kgchord/ParkFlow/electronics/ESDS.md

# ParkFlow Demo Lane: Electronic System Design Specification (ESDS), Rev A

Scope: the electronics of one demo lane (Edge Node, Lane Controller PCB, RFID, camera, PoE, barrier drive, field I/O, occupancy nodes, P10 sign, power and protection).
Sources of truth: `kicad/lane_controller.kicad_sch` (generated by `tools/gen_lane_controller_sch.py`), `PINMAP.md` (generated from the same script), `../bom/ParkFlow_BOM.xlsx` (25 Oct 2026), `diagrams/system_block_diagram.png`, `diagrams/power_tree.png`. Where these disagree, see **Section 11 (Inconsistencies found)**.

Conventions. Every number that is not a datasheet or vendor-page fact is a **design target, to be bench-verified**. Facts taken from a datasheet or vendor page carry that page's URL (Section 12). Nothing in this document is a measured result: no bench test has been run.

## 1. Subsystems

| # | Subsystem | Hardware (BOM part numbers) | Role |
|---|---|---|---|
| 1 | Edge Node | Raspberry Pi 5 8 GB + Raspberry Pi AI HAT+ (Hailo-8, 26 TOPS, PCIe Gen3 x1), Active Cooler, 128 GB microSD, Geekworm X1202 UPS (2x 18650), XL4015 24 V to 5.1 V | ANPR, RFID-plate fusion, access list, offline queue |
| 2 | Lane Controller PCB | ESP32-S3-WROOM-1-N16R8, THVD1450DR, IBT-2 (BTS7960) motor-driver module on header J14, TPS54560BDDA, TLV62569DBVR, TPS3823-33DBVR, SN74HCT245PWR, 74AHCT1G08 x3 (U9, U10, U19; drawn with the 74LVC1G08 symbol), 6x EL817S1(C)/PC817-pinout optos (see 11 #2) | Lane FSM, barrier drive, interlocks, RS485 master, sign and LED drive |
| 3 | UHF RFID reader | ID Tech IDT 85 (865-867 MHz) | FASTag EPC read, RS485 to Lane Controller |
| 4 | ANPR camera + PoE | CP Plus CP-UNC-TD21ZL6C, Netgear GS305P | RTSP video to Edge Node |
| 5 | Barrier drive and field I/O | Lucas TVS 24 V 18 N.m wiper motor, 2x limit switch ME-8108, Delta PS-MT5 through-beam pair, ProMax 22 mm E-stop, K1 (Schneider LC1D09BD 24 VDC contactor, in the BOM and schematic) | Boom actuation, end stops, anti-crush, hard stop |
| 6 | Occupancy nodes x4 | ESP32-C3 SuperMini, VL53L1X, WS2812 ring, 5 V adapter each | Bay occupancy |
| 7 | P10 sign | P10 red 320x160 mm HUB12 | Guidance |
| 8 | Power and protection | 2x MCB A9N1P06C, Type 2 SPD, Mean Well LRS-200-24, LRS-100-12, 12 V mini DC UPS, RCCB 30 mA, fuses; separate power box | 230 VAC to all rails |

## 2. Target specification table

All figures in the Target column are **target, to be bench-verified** (T-nnn refer to Section 10).

| Parameter | Target (target, to be bench-verified) | Selected hardware / protocol |
|---|---|---|
| Barrier open time (0 to 90 deg) | <= 3 s (T-05) | Lucas TVS 24 V wiper motor (18 N.m), IBT-2 PWM; wind limit 12 m/s for this motor (D1) |
| Hard motor cut on E-stop | <= 50 ms, independent of firmware (T-02) | E-stop NC in K1 coil loop + ESTOP_OK to INH gate (U9) |
| Anti-crush | CLOSE blocked when beam broken, in hardware (T-03) | Delta PS-MT5 to BEAM_CLEAR to U10 (74LVC1G08) |
| Firmware watchdog | reset if not kicked within 0.9-2.5 s (datasheet, TPS3823) | TPS3823-33DBVR on GPIO14 |
| Lane Controller link to Edge | 921.6 kbaud, 3.3 V UART (T-06) | ESP32-S3 UART0 (GPIO43/44), JST-XH 5P (J11) |
| RFID link | RS485, 115.2 kbaud (T-07) | THVD1450DR, SM712, 3-pin screw terminal (J7) |
| Occupancy link | RS485 Modbus-RTU 19.2 kbaud (T-07) | not implemented in BOM (11 #12) |
| ANPR latency | 60-120 ms per frame (T-08) | Hailo-8 on AI HAT+ |
| Read range | >= 6 m (T-09); vendor claims up to 8 m | IDT 85 |
| Mains loss ride-through, Edge Node | >= 10 min (T-10) | X1202 + 2x 18650 (PoE switch and camera have none: ANPR is lost in an outage, OPEN_DECISIONS D3) |
| Mains loss ride-through, RFID | >= 10 min (T-10) | 12 V mini DC UPS 27.5 Wh |
| 24 V bus peak load | <= 87 % of 8.8 A with the motor limited to 5 A (T-04) | LRS-200-24 |
| Operating ambient | 0 to 50 deg C inside enclosure (T-11); margin not demonstrated by prediction (48.1 to 52.3 deg C with the supply moved out), see 11 #8 | AI HAT+ is rated 0-50 deg C |
| Input protection | reverse polarity and 33 V surge clamp on the logic feed | Q1 FQD11P06, D2 SMBJ33A, F1 3 A |

## 3. Architecture rationale (decision, why, rejected alternative)

1. **RS485 (THVD1450) for the RFID link, not plain UART or CAN.** The reader is on a cable of several metres next to a 24 V motor and contactor; differential signalling with a 3.3 V transceiver (supply 3.3-5 V, TI page) and an SM712 TVS tolerates that, and the reader class (IDT 85) is listed with RS485. Rejected: UART at TTL levels (no common-mode immunity over the cable), CAN (reader does not offer it; no extra benefit for one master and one slave).
2. **ESP32-S3-WROOM-1-N16R8 for the Lane Controller, not STM32.** Native USB-Serial-JTAG (GPIO19/20), 3.0-3.6 V single supply, ESP-IDF, enough GPIO for 6 opto inputs, HUB12, WS2812, RS485 and H-bridge; the BOM part is already priced and the team knows ESP-IDF. Cost: octal PSRAM takes GPIO35-37, and the module is rated -40 to 65 deg C (Espressif datasheet). Rejected: STM32 (better hard real-time and temperature range, but no budgeted part, no PCB library effort in the 4-month plan).
3. **Raspberry Pi 5 + AI HAT+ (Hailo-8) as Edge Node, not Jetson Orin Nano Super.** The HAT+ is in the BOM at 26 TOPS and the Pi is the cheapest path to HailoRT; Jetson stays the documented alternative. Cost: AI HAT+ is 0-50 deg C ambient (Raspberry Pi product brief), which the sealed enclosure does not currently meet. Rejected: Jetson (higher cost and power, not in BOM).
4. **PoE IP camera over RTSP, not a CSI camera.** A 2 MP IR bullet camera is weather-rated (IP67 per BOM listing), runs on 100 m Ethernet, and needs no Pi CSI port or long ribbon; PoE removes a power run. Cost: PoE support of the CP Plus model is "to be confirmed" in the BOM. Rejected: CSI (ribbon length limit about a metre, no IR/weather housing).
5. **Hardware interlocks in front of the H-bridge.** E-stop opens the K1 (LC1D09BD) coil supply (no firmware involved) and ESTOP_OK also gates the driver enable (MOT_INH) through U9; CLOSE is gated by BEAM_CLEAR through U10 and the CLOSE input of the module (MOT_IN_A) passes U19. A firmware hang cannot override either. Rejected: software-only interlocks (the safety case then depends on the firmware).
6. **IBT-2 (BTS7960) module for the barrier motor, not discrete BTN8982TA half-bridges.** One design is used everywhere (schematic, BOM, PCB). The module is rated 5.5-27 V motor supply, which covers the 21.6-28.8 V bus; the BTN8982TA is only specified 8-18 V normal, so it was dropped. The board carries a 1x8 header J14 (RPWM, LPWM, two enable lines tied to MOT_INH, IS_A, IS_B, +5 V, GND); 74AHCT1G08 gates U9, U10, U19 sit in front of it; the 1 k resistors on each IS pin are on the module. Motor power and return go straight to the module screw terminals and do not pass over the Lane Controller PCB. Caveat: IS scale (about 0.1 V/A) is a to-be-bench-calibrated figure. Rejected: BTN8982TA on our PCB (outside its normal voltage range), SMD half-bridges on the board (more copper, no benefit for a 5 A limit).
7. **Separate 24 V and 12 V supplies, PoE on its own adapter.** Isolates the noisy motor bus from the RFID reader and camera. Rejected: single 24 V with DC-DC for 12 V (adds a converter in the sealed box).

## 4. Power budget

Method: `tools/power_model.py` holds every number below; `tools/gen_power_tree.py` draws `diagrams/power_tree.png` from it. All loads are **target, to be bench-verified** except where a vendor page gave the figure (Section 12).

### 4.1 24 V bus (Mean Well LRS-200-24: 24 V, 8.8 A, 211.2 W, hiccup overload; Probots listing, Bengaluru)

| Device | V | Typ A | Peak A | Typ W | Peak W | Margin / note |
|---|---|---|---|---|---|---|
| Barrier motor, Lucas TVS 24 V 18 N.m via K1 + IBT-2 | 24 | 2.00 | 5.00 | 48.0 | 120.0 | ASSUMED: vendor page gives no current; 5 A = firmware limit (set from the IS sense, D7) |
| Lane Controller 24 V logic (F1, TPS54560, 5 V rail incl. P10 and ring) | 24 | 0.29 | 0.83 | 7.1 | 20.0 | 72 % margin to F1 3 A |
| 24 V field (6 opto inputs, sensors, buzzer) via F2 | 24 | 0.10 | 0.30 | 2.4 | 7.2 | 60 % to F2 0.75 A hold |
| K1 coil (LC1D09BD) + E-stop loop | 24 | 0.20 | 0.30 | 4.8 | 7.2 | coil current is an ASSUMPTION (not read from a Schneider sheet) |
| Edge chain: XL4015, X1202, Pi 5 + AI HAT+ | 24 | 0.41 | 1.23 | 9.9 | 29.4 | peak = 20 W load + 5 W UPS charge at 85 % |
| **Bus total** | 24 | **3.01** | **7.66** | **72** | **184** | typ 34 % of 8.8 A; **peak 87 %** (margin 13 %) |

Result: with the motor limited to 5 A the coincident peak is 7.66 A, inside the 8.8 A rating. The hiccup threshold is taken as 110 % of 8.8 A = 9.68 A (the 110 % figure is from the LRS-150 sheet; assumed the same here). The largest motor current that keeps the bus within the rating is 6.14 A, within the 80 % derated rating 4.38 A (others' peak 2.66 A). The earlier design (LRS-150-24, 6.5 A, 6 A motor limit) peaked at 8.66 A, 133 % of the supply (previously quoted as 8.56 A before the K1 coil was updated); that conflict is closed by the larger supply and the 5 A limit. Still open: the stall current of the wiper motor is unknown, and the 5 A limit is a firmware trip only (OPEN_DECISIONS D7). T-04 measures it.

### 4.2 5 V rail (TPS54560BDDA, 5 A, 4.5-60 V in, TI page; 80 % derated limit 4.0 A)

| Device | V | Typ A | Peak A | Typ W | Peak W |
|---|---|---|---|---|---|
| TLV62569 3.3 V buck input (ESP32-S3 0.5 A peak at 3.3 V, optos, THVD1450) | 5 | 0.11 | 0.40 | 0.5 | 2.0 |
| WS2812 12-LED ring (J10), firmware cap 25 % | 5 | 0.15 | 0.18 | 0.8 | 0.9 |
| P10 sign (J13, labelled 5 V / 3 A) | 5 | 1.00 | 3.00 | 5.0 | 15.0 |
| 74HCT245 + misc | 5 | 0.01 | 0.02 | 0.1 | 0.1 |
| **Total** | 5 | **1.27** | **3.60** | 6.4 | 18.0 | 

Margin to 5 A: typ 75 %, peak 28 %; to the 4 A derated limit: peak 10 %. Sizing: the converter is at 72 % of rating at peak; inductor Isat >= 7 A is the schematic value (L1). The TPS54560 uses RT = 200 kohm for about 500 kHz (TI table) and an EN divider (R6/R90) for UVLO; EN is not driven above its 8.4 V absolute maximum (TI) by the 100k/10k divider at 28.8 V (about 2.6 V).
3.3 V rail: ESP32-S3 module supply 3.0-3.6 V and minimum external supply capability 0.5 A (Espressif); TLV62569 2 A (schematic annotation; its datasheet was not opened), load peak 0.55 A, 73 % margin.

### 4.3 12 V bus (Mean Well LRS-100-12: 12 V, 8.5 A, 102 W)

| Device | V | Typ A | Peak A | Typ W | Peak W |
|---|---|---|---|---|---|
| ID Tech IDT 85 (9-12 VDC; current not stated by vendor) | 12 | 0.60 | 1.50 | 7.2 | 18.0 |
| 12 V mini DC UPS charging (27.5 Wh) | 12 | 0.30 | 1.00 | 3.6 | 12.0 |
| **Total** | 12 | **0.90** | **2.50** | 10.8 | 30 |

Peak is 29 % of 8.5 A (margin 71 %).

### 4.4 PoE (Netgear GS305P, own adapter)

Budget 63 W (4 ports, 802.3af/at; max consumption 66.78 W; Netgear page). Camera target <= 15.4 W (802.3af class limit; camera draw not stated in the BOM listing): margin 76 % of the 63 W budget. The switch is rated 0-40 deg C (Netgear page): see 11 #8.

### 4.5 Mains side

LRS-200-24 input power at full load 211.2/0.89 = 237 W (efficiency taken from the earlier LRS-150 sheet figure, assumed equal; the LRS-200 sheet was not opened); LRS-100-12 102/0.85 (efficiency assumed) + GS305P 66.78 W = 187 W. At an assumed power factor of 0.6 (pessimistic, supplies without PFC): 1.72 A and 1.35 A per 6 A MCB, i.e. 3.5x headroom or more. Inrush: the LRS-150 sheet listed cold start 60 A at 230 VAC (the LRS-200 value was not read; assume similar); a 6 A C-curve MCB is expected to trip magnetically somewhere above 5-10 x In (IEC 60898 characteristic, not read on the A9N1P06C page), so one MCB per supply (as the BOM has) is the right grouping; confirm in T-01.

### 4.6 UPS ride-through arithmetic

Edge Node (Geekworm X1202, 2x 18650 per the Probots page): 2 cells x 2.5 Ah x 3.6 V = 18.0 Wh nominal (2.5 Ah is the low end of the BOM's 2500-3000 mAh). Usable = 18.0 x 0.80 (depth of discharge) x 0.85 (boost efficiency) x 0.80 (end-of-life capacity) = **9.8 Wh**. Required for 10 min at the 20 W peak: 20 x 10/60 = **3.3 Wh**. Margin **2.9x** (typical 8 W load: 7x). All derating factors are targets (T-10). Note: BOM_notes says the Geekworm board is described as 4-cell elsewhere; the budget uses 2 cells, the lower-capacity case.
RFID: 12 V mini UPS 27.5 Wh (BOM) x 0.7 = 19.3 Wh usable vs 1.5 A x 12 V x 10/60 = 3.0 Wh: **6.4x** (assumed 0.7 usable factor).
Lane Controller and barrier: **no ride-through exists** in the baseline. The supply holds up for tens of ms only (40 ms was the LRS-150 figure); the TPS3823-33 resets the ESP32 below 2.86-3.00 V (TI). Decision (SAFETY F11): the barrier **fails in place** on mains loss and is released by hand with a pin; the earlier claim of automatic fail-open is withdrawn. An optional 24 V battery buffer is OPEN_DECISIONS D2 (not in the BOM; the firmware AC_OK open-hold applies only if one is fitted). The PoE switch and camera have no UPS (D3), so ANPR stops in an outage while the Pi (X1202) and RFID (12 V mini UPS) ride through.

## 5. Voltage regulation and protection

| Stage | Parts (schematic) | Function |
|---|---|---|
| Mains | 2x MCB A9N1P06C, Type 2 SPD (BOM), RCCB 30 mA (BOM, priced Rs 1,062) | overcurrent, surge, shock protection |
| 24 V logic input | F1 Littelfuse 0451003.MRL 3 A very fast (125 V, 50 A interrupting per Farnell page), Q1 FQD11P06 P-FET reverse-polarity, D1 BZT52C15 gate clamp, D2 SMBJ33A TVS (53.3 V clamp at 11.3 A per DigiKey listing), C1 100 uF 50 V | reverse polarity, surge clamp below TPS54560's 60 V input rating |
| Field supply | F2 Bourns MF-R075 (0.75 A hold, 1.5 A trip, 60 V; RS page) | short-circuit protection of field, E-stop loop and buzzer |
| Motor rail | on the IBT-2 module and the supply; no motor current on the Lane Controller PCB | C16, C17 and D8 were removed with the discrete bridge; add 100 nF across the motor terminals at the bench (T-12) |
| RS485 | D7 SM712 (400 W 8/20 us, IEC 61000-4-2 +-8 kV contact; Semtech page), R25/JP1 termination | line surge/ESD |
| USB | U3 USBLC6-2SC6, 22 ohm series | ESD on D+/D- |
| Inputs | 6 opto inputs, 4.7 k + reverse diode + 10 nF filter | 24 V isolation from GPIO |
| ADC | R29 + D9 BAT54S clamp on the IBT-2 IS sense (IS_A/IS_B from the module to the ADC); 100k/10k divider on 24 V sense | ADC pin protection |
| Supervision | TPS3823-33DBVR: reset threshold 2.93 V typ, watchdog 1.6 s typ (0.9-2.5 s), reset delay 200 ms typ (TI) | brownout and hang recovery |

**E-stop path independent of firmware.** J4: +24V_FIELD -> E-stop NC contacts (external) -> K1 (LC1D09BD) coil -> Q4 (low side, driven by K1_EN). Opening the E-stop interrupts coil current by itself; firmware cannot close it. A second channel: ESTOP_OK (opto U17) feeds the U9 AND gate that drives MOT_INH (both enable pins of the IBT-2), so the bridge is disabled even if K1 contacts weld. The E-stop contacts are rated 1 A DC at 36 V (ProMax page) which is adequate for the contactor coil loop. The coil-loop topology now exists in the BOM (contactor LC1D09BD, Rs 1,226 incl. GST).

### 5.1 Track widths (IPC-2221, 1 oz outer copper, 20 K rise; computed by `power_model.ipc` and checked in `gen_pcb.py`)

| Net class | Design current | IPC-2221 width | Class width in .kicad_pro |
|---|---|---|---|
| Power_24V_Motor | removed: the motor path is off-board (IBT-2 screw terminals). Reference only: 6 A would need 2.33 mm | n/a | n/a |
| Power_24V | 1.7 A | 0.41 mm | 1.0 mm |
| Power_5V | 3.6 A | 1.15 mm | 1.2 mm |
| Power_3V3 | 0.7 A | 0.12 mm | 0.5 mm |
| GND | 2.5 A | 0.70 mm | 0.8 mm plus pours |

## 6. Communication map

| Link | Protocol | Speed | Connector | Cable |
|---|---|---|---|---|
| Edge Node to Lane Controller | UART 3.3 V TTL, MQTT-style framing in firmware | 921.6 kbaud (target) | J11 JST-XH 5P | short shielded 5-core, < 1 m inside enclosure |
| Lane Controller to RFID | RS485 half duplex, THVD1450 | 115.2 kbaud (target) | J7 screw terminal A/B/0V | shielded twisted pair, 120 ohm termination at JP1 on the PCB end |
| Edge Node to camera | Gigabit Ethernet + PoE, RTSP/H.264 | 1 Gbit/s link, 2 MP stream | RJ45 via GS305P | Cat6 |
| Edge Node to switch | Ethernet | 1 Gbit/s | RJ45 | Cat6 |
| Edge Node to cloud | 4G router / LAN, MQTT-TLS, HTTPS | n/a | RJ45 | Cat6 |
| Programming/debug | USB 2.0 full speed (native USB-Serial-JTAG) | 12 Mbit/s | J12 USB-C | USB-C |
| HUB12 sign | 5 V logic through 74HCT245 | clocked by firmware | J9 2x8 IDC | ribbon |
| WS2812 ring | single-wire 5 V | 800 kbit/s class | J10 JST-XH 3P | 3-core |
| Field I/O | 24 V active-high signals into opto (PNP beam, NC limit switches, dry contacts to +24V_FIELD) | static | J5 (8P), J6 (3P: IN_ACOK, IN_BATOK, +24V_FIELD) | 0.75 mm2 |
| Motor driver | 3.3 V PWM and enables via 74AHCT1G08 gates, IS analogue back | PWM | J14 (1x8 header to IBT-2) | short ribbon / dupont in the box |
| Occupancy nodes | none defined in BOM | | | 11 #12 |

Note that UART0 is also the ROM boot log, so the link sees boot text at reset.

## 7. Grounding and EMC notes

- One 0 V reference on the Lane Controller; field inputs are optically isolated, so field-side 24 V return does not share the logic ground path through GPIO.
- PE: mains PE bonds the metal enclosure, DIN rail and SPD; DC 0 V is **not** bonded to PE except at one point at the PSU output (to be chosen at assembly; do not bond at both the LRS-200 and the LRS-100 outputs).
- Motor power and return run from the supply to the IBT-2 module terminals, off the Lane Controller PCB (the old J2/J3 are removed); join the logic ground at a single star point at the 24 V input terminal. Layout: power zone left, logic centre, connectors on the edge, antenna keep-out above the ESP32 module.
- RS485: shield grounded at one end only; stub-free; termination only at the PCB end and at the reader end if the cable is longer than a few metres.
- Motor: 100 nF at the motor terminals and ferrite on the motor cable are recommended additions, not on the current schematic (to be decided at bench: T-12).
- PoE and Ethernet shields terminate at the RJ45, not at the Lane Controller.
- Pi 5 and AI HAT+ switch noise is kept off the 24 V bus by the XL4015's own input capacitors; this is not simulated.

## 8. Rails and pin summary

GPIO assignments, directions, levels, protection and strapping checks are in `PINMAP.md` (generated; do not edit by hand). Strapping pins: GPIO0 has a 10 k pull-up; GPIO3, 45 and 46 are unconnected; GPIO35-37 are unused (octal PSRAM). Espressif's Table 4-1 values are used.

## 9. Design-verification status

| Check | Result |
|---|---|
| KiCad ERC (v7.0.11 eeschema engine) | 0 errors, 0 warnings, see `kicad/ERC_report.txt` |
| Netlist vs intended | 0 mismatches after the 25 Oct regeneration; 449 netlist pins on the board; 0 footprint/pad problems |
| PCB | **placement only, unrouted**. DRC (pcbnew engine): 4 hole-clearance errors on the USB-C library footprint and 225 unconnected pads (unrouted); see `kicad/DRC_report.txt`. Routing, DRC clean-up and final review are still to be done in KiCad. |
| Bench tests | none run |

## 10. Bench test plan (pass criteria are targets; no results exist)

| ID | Test | Method | Pass criterion |
|---|---|---|---|
| T-01 | Mains inrush and MCB | power both PSUs from cold, 20 cold starts | no MCB trip |
| T-02 | E-stop hard cut | run motor, press E-stop, measure motor current with scope; repeat with the ESP32 held in reset | motor current < 0.1 A within 50 ms; also with firmware halted |
| T-03 | Anti-crush | block beam during CLOSE, MCU forcing CLOSE | MOT_IN_B stays low (probe U10 pin 4) |
| T-04 | 24 V bus load | stall the motor against a stop, log bus voltage and PSU behaviour; repeat at the 5 A firmware limit; calibrate IS (about 0.1 V/A) and set oc_threshold_mv | bus stays > 21.6 V, no PSU hiccup, motor current <= 5 A; record stall current (currently unknown) |
| T-05 | Barrier timing | 50 open/close cycles | open <= 3 s, limits hit every cycle |
| T-06 | Edge link | loopback 24 h at 921.6 kbaud | zero framing errors |
| T-07 | RS485 | RFID polling 1 h, noise injected near motor | no CRC errors |
| T-08 | ANPR latency | 1000 frames | median <= 120 ms |
| T-09 | RFID range | tagged vehicle approach | >= 6 m read |
| T-10 | UPS ride-through and mains-pull | pull mains with Edge at 20 W load, measure time to shutdown; same for RFID; with the barrier half-open, confirm it stays in place and the hand-release pin works | >= 10 min each; barrier fails in place |
| T-11 | Enclosure thermal | sealed box, full load, sun, 4 h, log HAT+ and switch temperature | HAT+ < 50 deg C, GS305P < 40 deg C (predicted marginal for the HAT+ and failing for the GS305P) |
| T-12 | Conducted noise | scope 3.3 V and 5 V during motor start | ripple < 100 mV pp on 3.3 V, no resets |
| T-13 | Watchdog | stop kicking WDI | reset within 2.5 s; ESP32 restarts |
| T-14 | Reverse polarity and surge | reverse 24 V; apply surge via bench generator | no damage, F1 intact |

## 11. Inconsistencies found

### Fixed in the source

| # | Finding | Fix |
|---|---|---|
| F1 | The schematic needed `kicad-cli sch erc`, absent in KiCad 7.0.11 (earlier attempt produced no report). The first real ERC run gave 3 errors and 601 warnings | ERC now run through eeschema (`tools/run_erc_gui.sh`); generator fixed (IS_A/IS_B nets, R90-R93, #FLG06 flag, 1.27 mm grid snapping); final ERC 0/0 |
| F2 | Fuse F1 was 3.15 A in the schematic and block diagram; the part 0451003.MRL is 3 A | schematic value and diagram corrected |
| F3 | Block diagram parts not matching the BOM: MCU N8 (now N16R8), TP-Link switch (Netgear GS305P), Chafon reader (ID Tech IDT 85), E3Z-T61 and D4N limit switch (Delta PS-MT5, ME-8108), motor spec, MCB 2P (2x 1P), NVMe (microSD), camera model | diagram text corrected |
| F4 | MSTBA footprints named in the schematic do not exist in the KiCad 7 library | replaced by Phoenix MKDS footprints; every footprint pad is checked against symbol pins |
| F5 | PCB 5 V net class 0.8 mm was below the IPC-2221 width for the 3.6 A peak; motor class design current 10 A did not match the 6 A limit | 5 V class 1.2 mm; motor design current 6 A |
| F7 | 25 Oct design update: one motor-driver design (IBT-2 on J14), K1 = LC1D09BD contactor, LRS-200-24, active-high opto inputs (PNP beam compatible), J2/J3/U7/U8/D8/C16/C17 removed, U19 added | schematic, netlist, PCB placement, power model, diagrams regenerated; ERC 0/0; firmware 53 tests pass |
| F6 | Diagram power boxes (DDR-120B-48, DDR-30G-5, DDR-60G-12, DRS-240-24, battery) were drawn as the real chain | now tagged "design intent, not in BOM" with the BOM equivalent beside them |

### Not fixed (BOM or other owners; decision needed)

Items 2 to 7 of the earlier list (schematic vs BOM, K1, PNP beam, motor driver voltage, 24 V peak) were resolved on 25 Oct; they are listed in F7 above. What remains:

| # | Finding | Impact and suggestion |
|---|---|---|
| 1 | **Two power chains.** Design intent (block diagram: DRS-240-24 UPS, VRLA battery, DDR DIN converters) versus BOM (LRS-200-24, LRS-100-12, XL4015, X1202, 12 V mini UPS). `power_tree.png` draws the BOM chain; the optional battery buffer is a dashed block | Update the design-intent text once D2 is decided |
| 2 | Lane Controller BOM vs schematic: now one design. The BOM carries the IBT-2, contactor and a Rs 2,500 to 5,000 estimate line for schematic-only parts (THVD1450DR, TPS54560, TLV62569, TPS3823, 74AHCT1G08 x3, SN74HCT245, USBLC6, FQD11P06, etc.); MAX3485, XL4015 and AP2112K lines are set to qty 0 | LionCircuits quote needed (D9) |
| 3 | Motor 18 N.m is below the >= 30 N.m specification. Arithmetic: 11.6 N.m needed at 15 m/s (17.8 without the counterweight), so margin 1.56; demo wind limit 12 m/s. Stall current, speed and self-locking are not stated by the vendor | production motor open (D1); raised-boom storm case 93 N.m needs the pin |
| 4 | Residual: IS scale and oc_threshold_mv are placeholders; the over-current trip is firmware-only | D7; bench T-04 |
| 5 | Thermal: GS305P 0-40 deg C, AI HAT+ 0-50 deg C, ESP32-S3-WROOM-1-N16R8 -40 to 65 deg C. Predicted air at 45 deg C ambient: 61.8 sealed, 54.2 with sink, 52.3 (48.1 with radiation) with the supply moved out. The bought box is 300x300x210, CAD is 300x400x180 | marginal; test T-11; D4, D6, D8 |
| 6 | SAFETY F11 is now fail-in-place + hand release; the RCCB (F6) is priced; thermostats (F7) are an estimate line | automatic fail-open needs the D2 buffer |
| 7 | XL4015 5 A buck for the Pi: vendor page recommends 2-3 A without a heat sink; Pi peak target is 4 A | use a 5 A industrial DC-DC or test T-04 |
| 8 | X1202: Probots page says 2 cells, Geekworm describes 4 | budget uses 2 |
| 9 | Occupancy nodes: block diagram and firmware boxes assume RS485 Modbus-RTU; BOM has no transceivers and gives each node a 5 V USB adapter | add four transceivers and a supply, or change to Wi-Fi |
| 10 | P10 sign: schematic feeds it from the Lane Controller 5 V (J13); the BOM has a separate XL4015 for it | either is workable; the 5 V rail has 28 % margin with P10 on it |
| 11 | BOM listings unconfirmed: camera PoE/RTSP/850 nm, reader RS485 and IP65, GS305P PoE port count text conflicting | confirm in writing before purchase |
| 12 | Pole: STEP section is a generic 4891 mm2 (31.7 kg), real Systeal section 1649 mm2 (about 10.7 kg); calculations use 12.96 kg | CAD/FEA owner (D6) |

## 12. Sources actually opened

- Espressif ESP32-S3-WROOM-1 datasheet: https://documentation.espressif.com/esp32-s3-wroom-1_wroom-1u_datasheet_en.pdf
- TI TPS54560B: https://www.ti.com/lit/gpn/TPS54560B and https://www.ti.com/product/TPS54560B
- TI TPS3823: https://www.ti.com/lit/gpn/tps3823
- TI THVD1450: https://www.ti.com/document-viewer/THVD1450/datasheet/overview-x9373 (supply and data rate only; ESD/fault ratings not on the page read)
- Infineon BTN8982TA: https://pdf.direnc.net/upload/infineon-btn8982ta-datasheet.pdf
- Mean Well LRS-150 (superseded by LRS-200-24 in the BOM; sheet values reused where noted): https://www.meanwellaustralia.com.au/sites/default/files/2025-05/MEAN%20WELL%20LRS-150%20DATA%20SHEET.pdf
- Raspberry Pi 27 W PSU: https://pip-assets.raspberrypi.com/categories/898-raspberry-pi-27w-usb-c-power-supply/documents/RP-008245-DS-1-27w-usb-c-power-supply-product-brief.pdf
- AI HAT+ brief: https://cdn.sparkfun.com/assets/c/9/b/7/3/Raspberry_Pi_AI_HAT__product_brief.pdf
- Netgear GS305P: https://www.netgear.com/in/business/wired/switches/unmanaged/gs305p/
- X1202 listing: https://probots.co.in/metal-case-raspberry-pi-5-x1202-ups-board.html
- E-stop: https://probots.co.in/promax-22mm-emergency-stop-switch-mushroom-head-waterproof-metal-2-pole.html
- Limit switch: https://probots.co.in/rotary-adjustable-roller-micro-limit-switch-me-8108.html
- Motor listing: https://www.moglix.com/lucas-tvs-wiper-motor-assembly-24-v-18-nm-for-hindustan-72-71b-front-end-loader-front-screentriv-luc-tsrxs6/mp/msnl5gln362yk4
- Fuse 0451003.MRL: https://jp.farnell.com/en-JP/littelfuse/0451003-mrl/smd-fuse-very-fast-acting-3a-2410/dp/2383276RL
- MF-R075: https://uk.rs-online.com/web/p/resettable-fuses/6478516P
- SMBJ33A listing: https://www.digikey.ch/en/products/detail/littelfuse-inc/SMBJ33A/286006
- SM712: https://www.semtech.com/products/circuit-protection/rs485/sm712

Not opened (no datasheet claims made): TLV62569, FQD11P06, SMCJ28A, 74LVC1G08, SN74HCT245, Schneider A9N1P06C, Delta PS-MT5, ID Tech IDT 85, CP Plus camera, Enerva UPS, Mean Well LRS-100-12 and DRS-240-24, XL4015, P10 module.
