kgchord/ParkFlow/electronics/PINMAP.md

# ESP32-S3-WROOM-1-N16R8 pin map (Lane Controller PCB, Rev A)

GENERATED by `electronics/tools/gen_lane_controller_sch.py` from the same `esp` dictionary that places the nets in `lane_controller.kicad_sch`; do not edit by hand.
Strapping / reserved-pin facts: Espressif ESP32-S3-WROOM-1 datasheet, Table 4-1 and Table 3-1 note b, https://documentation.espressif.com/esp32-s3-wroom-1_wroom-1u_datasheet_en.pdf (opened for this document).
All GPIO are 3.3 V logic. Every figure for timing/current is a design target, to be bench-verified.

| GPIO | Module pin | Net | Function | Direction (MCU) | Level | Protection / state at reset | Other parts on net (auto from netlist) | Strapping-pin check |
|---|---|---|---|---|---|---|---|---|
| GPIO0 | 27 | GPIO0_BOOT | BOOT select (strapping) | in at reset | 3.3 V, LOW at reset = download mode | R16 10k pull-up + SW1 BOOT + Q3 (Pi auto-flash) | Q3.3(2N7002), R16.2(10k), SW1.1(BOOT) | STRAPPING (Table 4-1: weak pull-up, default 1). External 10k pull-up R16 keeps it HIGH = SPI boot; SW1/Q3 pull it LOW only on purpose. OK. |
| GPIO1 | 39 | MOT_ISENSE | H-bridge current sense (IBT-2 module R_IS / L_IS outputs, 1k on the module) | in (ADC1) | 0 to 3.3 V analog | R29 1k series + D9 BAT54S clamp to 3V3/GND + C18 10nF; module IS pins (J14.5/J14.6) joined through R91/R92 100R; R28 is DNP because the module already has 1k to GND on each IS pin. Scale about 0.1 V/A (kILIS ~8.5 mA/A typ, to be bench-calibrated) | C18.1(10nF), D9.3(BAT54S), R29.2(1k) | not a strapping pin |
| GPIO2 | 38 | BAT_OK | Battery/UPS OK, opto-isolated 24 V input (J6.2) | in | 3.3 V, HIGH = OK | PC817 U16 opto + R61 10k pull-down + C35 10nF filter; 24 V side has 1N4148W reverse diode | C35.1(10nF), R61.1(10k), U16.3(EL817S1(C)) | not a strapping pin |
| GPIO3 | 15 | NC | unused (no-connect flag) | - | - | left floating | - | STRAPPING (Table 4-1: floating, JTAG source select). Left unconnected on purpose; do not drive. OK. |
| GPIO4 | 4 | V24_SENSE | 24 V bus monitor (100k/10k divider) | in (ADC1) | 0 to 2.5 V for 27.6 V in | R2 100k + R3 10k + C2 100nF; no clamp, R2 limits injected current | C2.1(100nF), R2.2(100k), R3.1(10k) | not a strapping pin |
| GPIO5 | 5 | MOT_IN_A | H-bridge OPEN request (to RPWM through U19, gated by ESTOP_OK) | out | 3.3 V CMOS | R32 100k pull-down: request LOW at reset; U19 74AHCT1G08 level-shifts to 5 V and ANDs ESTOP_OK | R32.1(100k), U19.1(74AHCT1G08) | not a strapping pin |
| GPIO6 | 6 | MOT_IN_B_MCU | H-bridge CLOSE request (to LPWM through U10, gated by beam) | out | 3.3 V CMOS | R31 100k pull-down; U10 74AHCT1G08 forces LPWM LOW unless BEAM_CLEAR=1 and level-shifts to 5 V | R31.1(100k), U10.1(74AHCT1G08) | not a strapping pin |
| GPIO7 | 7 | MOT_EN_MCU | Motor enable request (gated by E-stop sense into R_EN/L_EN) | out | 3.3 V CMOS | R30 100k pull-down; U9 74AHCT1G08 AND-gate with ESTOP_OK drives IBT-2 R_EN and L_EN (J14.3/J14.4) at 5 V | R30.1(100k), U9.1(74AHCT1G08) | not a strapping pin |
| GPIO8 | 12 | ESTOP_OK | E-stop loop healthy sense (also hard-wired into U9) | in | 3.3 V, HIGH = loop closed | PC817 U17 + R82 4.7k + R83 10k pull-down + C36 10nF; broken loop reads LOW | C36.1(10nF), R83.1(10k), U17.3(EL817S1(C)), U19.2(74AHCT1G08), U9.2(74AHCT1G08) | not a strapping pin |
| GPIO9 | 17 | LIM_UP_OK | Limit switch UP (J5.3), NC wiring | in | 3.3 V, HIGH = switch closed (not at limit) | PC817 U11 + R40 4.7k + D10 reverse diode + R41 10k + C30 10nF | C30.1(10nF), R41.1(10k), U11.3(EL817S1(C)) | not a strapping pin |
| GPIO10 | 18 | LIM_DN_OK | Limit switch DOWN (J5.4), NC wiring | in | 3.3 V, HIGH = switch closed (not at limit) | PC817 U12 + R44 4.7k + D11 + R45 10k + C31 10nF | C31.1(10nF), R45.1(10k), U12.3(EL817S1(C)) | not a strapping pin |
| GPIO11 | 19 | BEAM_CLEAR | Photo-beam clear (J5.5, PNP light-ON receiver drives 24 V when clear); also gates CLOSE in hardware | in | 3.3 V, HIGH = beam clear | PC817 U13 + R48 4.7k + D12 + R49 10k + C32 10nF; same net feeds U10 pin 2 | C32.1(10nF), R49.1(10k), U10.2(74AHCT1G08), U13.3(EL817S1(C)) | not a strapping pin |
| GPIO12 | 20 | PRESENCE | Presence/vehicle-under-boom sensor (J5.6) | in | 3.3 V, HIGH = sensor output active | PC817 U14 + R52 4.7k + D13 + R53 10k + C33 10nF | C33.1(10nF), R53.1(10k), U14.3(EL817S1(C)) | not a strapping pin |
| GPIO13 | 21 | AC_OK | Mains OK from PSU/UPS dry contact (J6.1) | in | 3.3 V, HIGH = mains OK | PC817 U15 + R56 4.7k + D14 + R57 10k + C34 10nF | C34.1(10nF), R57.1(10k), U15.3(EL817S1(C)) | not a strapping pin |
| GPIO14 | 22 | WDT_WDI | Watchdog kick to TPS3823-33 (toggle faster than 0.9 s) | out | 3.3 V CMOS | High-Z at reset: TPS3823 generates its own pulses so it does not reset during boot | U5.4(TPS3823-33DBVR) | not a strapping pin |
| GPIO15 | 8 | RS485_DI | RS485 TX data to THVD1450 DI (UART1 TX) | out | 3.3 V CMOS | Direct 3.3 V logic to U6 (bus side protected by SM712 D7, termination R25/JP1) | U6.4(THVD1450DR) | not a strapping pin |
| GPIO16 | 9 | RS485_RO | RS485 RX data from THVD1450 RO (UART1 RX) | in | 3.3 V CMOS | Direct, driven by transceiver at 3.3 V | U6.1(THVD1450DR) | not a strapping pin |
| GPIO17 | 10 | RS485_DE | RS485 driver enable, DE and /RE tied together | out | 3.3 V CMOS, HIGH = transmit | R22 10k pull-down: receive mode at reset | R22.1(10k), U6.2(THVD1450DR), U6.3(THVD1450DR) | not a strapping pin |
| GPIO18 | 11 | BUZ_CTRL | Buzzer driver (24 V piezo, low-side MOSFET Q5) | out | 3.3 V CMOS | R77 100R series + R78 100k pull-down on gate: buzzer off at reset; D17 flyback | R77.1(100R) | not a strapping pin |
| GPIO19 | 13 | GPIO19_USB_DN | USB D- (native USB-Serial-JTAG) to J12 | bidir | USB 3.3 V differential | R14 22R series + USBLC6-2SC6 U3 at the connector | R14.2(22R) | not a strapping pin |
| GPIO20 | 14 | GPIO20_USB_DP | USB D+ (native USB-Serial-JTAG) to J12 | bidir | USB 3.3 V differential | R13 22R series + USBLC6-2SC6 U3 at the connector | R13.2(22R) | not a strapping pin |
| GPIO21 | 23 | WS2812_3V3 | Status RGB ring data (via 74HCT245 U18 to 5 V) | out | 3.3 V CMOS into 74HCT245 input (TTL-compatible threshold; verify VIH against the datasheet) | U18 level shifter, R76 330R series at the ring, C21 bulk on ring supply | U18.8(SN74HCT245PWR) | not a strapping pin |
| GPIO35 | 28 | NC | unused (no-connect flag) | - | - | left floating | - | NOT USED: reserved for octal PSRAM on the N16R8 module (Table 3-1 note b) |
| GPIO36 | 29 | NC | unused (no-connect flag) | - | - | left floating | - | NOT USED: reserved for octal PSRAM on the N16R8 module (Table 3-1 note b) |
| GPIO37 | 30 | NC | unused (no-connect flag) | - | - | left floating | - | NOT USED: reserved for octal PSRAM on the N16R8 module (Table 3-1 note b) |
| GPIO38 | 31 | HUB_A_3V3 | HUB12 row-select A (to J9 via U18) | out | 3.3 V CMOS into HCT | U18 buffer + R70 33R series | U18.2(SN74HCT245PWR) | not a strapping pin |
| GPIO39 | 32 | HUB_B_3V3 | HUB12 row-select B (to J9 via U18) | out | 3.3 V CMOS into HCT | U18 buffer + R71 33R series | U18.3(SN74HCT245PWR) | not a strapping pin |
| GPIO40 | 33 | HUB_CLK_3V3 | HUB12 shift clock (to J9 via U18) | out | 3.3 V CMOS into HCT | U18 buffer + R72 33R series | U18.4(SN74HCT245PWR) | not a strapping pin |
| GPIO41 | 34 | HUB_LAT_3V3 | HUB12 latch (to J9 via U18) | out | 3.3 V CMOS into HCT | U18 buffer + R73 33R series | U18.5(SN74HCT245PWR) | not a strapping pin |
| GPIO42 | 35 | HUB_OE_3V3 | HUB12 output enable, HIGH = sign dark (to J9 via U18) | out | 3.3 V CMOS into HCT | R64 10k pull-up: sign dark at reset | R64.1(10k), U18.6(SN74HCT245PWR) | not a strapping pin |
| GPIO43 | 37 | EDGE_TX | Link to Edge Node, UART0 TX (GPIO43) | out | 3.3 V TTL | R17 100R series to J11.2 | R17.1(100R) | not a strapping pin |
| GPIO44 | 36 | EDGE_RX | Link from Edge Node, UART0 RX (GPIO44) | in | 3.3 V TTL | R18 100R series to J11.3 | R18.1(100R) | not a strapping pin |
| GPIO45 | 26 | NC | unused (no-connect flag) | - | - | left floating | - | STRAPPING (Table 4-1: weak pull-down, default 0). Left unconnected so the module keeps its factory setting. OK. |
| GPIO46 | 16 | NC | unused (no-connect flag) | - | - | left floating | - | STRAPPING (Table 4-1: weak pull-down, default 0). Left unconnected. OK. |
| GPIO47 | 24 | HUB_R_3V3 | HUB12 red data (to J9 via U18) | out | 3.3 V CMOS into HCT | U18 buffer + R75 33R series | U18.7(SN74HCT245PWR) | not a strapping pin |
| GPIO48 | 25 | K1_EN | Motor-power relay/contactor K1 coil enable (Q4 low side) | out | 3.3 V CMOS, HIGH = K1 on | R80 100R series + R81 100k pull-down on Q4 gate: K1 off at reset; E-stop breaks the coil supply regardless | R80.1(100R) | not a strapping pin |
| EN | 3 | ESP_EN | Chip enable / reset | in | 3.3 V, LOW = reset | R15 10k pull-up + C14 1uF + SW2 RESET + Q2 (Pi) + D5 (watchdog) | C14.1(1uF), D5.2(BAT54W), Q2.3(2N7002), R15.2(10k), SW2.1(RESET) | dedicated EN pin |

## Strapping summary

| Pin | Level seen by the chip at reset | Result |
|---|---|---|
| GPIO0 | 10 k pull-up (R16), SW1/Q3 open | HIGH: normal SPI boot; holding BOOT or Pi Q3 gives download mode |
| GPIO3 | floating (NC) | datasheet: floating default, no internal pull; unused, no action |
| GPIO45 | NC (weak pull-down) | datasheet default 0; unconnected so the module keeps its factory VDD_SPI setting |
| GPIO46 | NC (weak pull-down) | default |

## Not available / not used

- GPIO35, GPIO36, GPIO37: connected to the octal PSRAM on the BOM module N16R8 (datasheet Table 3-1 note b); left as no-connect.
- GPIO19/20 carry native USB (J12); GPIO43/44 are UART0 to the Edge Node, so the ROM boot log also appears on that link at reset.
