kgchord/ParkFlow/electronics/kicad/ERC_report.txt

ParkFlow Lane Controller - ERC report (KiCad 7.0.11 eeschema ERC engine)
=======================================================================
Schematic : electronics/kicad/lane_controller.kicad_sch (generated by tools/gen_lane_controller_sch.py)
Command   : electronics/tools/run_erc_gui.sh   (see below for why it is not `kicad-cli sch erc`)

Why the earlier attempt produced no report
  The installed KiCad is 7.0.11. Its `kicad-cli sch` has only the `export` subcommand;
  `kicad-cli sch erc` was added in KiCad 8, so the command just prints usage and writes nothing.
  The same ERC engine is available in the eeschema GUI, so run_erc_gui.sh drives eeschema under
  Xvfb/xdotool (Inspect > ERC > Run > show all severities > Save report). The pipeline was checked
  with a negative control (a deliberately broken schematic produced errors), so "0" is not an empty-run artefact.

What was fixed in the generator (first real run: 3 errors, 601 warnings)
  - 3 errors: genuine generator problems (see tools/gen_lane_controller_sch.py: PWR_FLAG #FLG06,
    separate IS_A / IS_B current-sense nets, sense resistors R90-R93).
  - ~590 warnings were endpoint_off_grid (symbol origins not on the 1.27 mm grid); fixed by snapping origins in schlib.py.
  - the rest were library-table / footprint-link items; fixed by writing sym-lib-table and the project symbol library.

FINAL RESULT (re-run 25 Oct 2026 on the schematic after the design update: IBT-2 module header J14,
  74AHCT1G08 interlock gates U9/U10/U19, active-high opto inputs, same run_erc_gui.sh)
  ** ERC messages: 0  Errors 0  Warnings 0

Caveats
  - ERC checks electrical-rule consistency only, not that the design is right. Checks that KiCad ignores by default
    (e.g. some pin-type matrix cells set to "no check") were left at their defaults.
  - Footprint/pad-number agreement was checked separately by the generator (check_footprints(), 0 problems);
    KiCad 7 ERC does not do that.

----- raw KiCad output -----
ERC report (Sun Oct 25 05:21:44 2026, Encoding UTF8)

***** Sheet /

 ** ERC messages: 0  Errors 0  Warnings 0
