kgchord/ParkFlow/docs/REFERENCES.md

# ParkFlow Stage 2: Consolidated References

All sources accessed 24 Oct 2026. S2 to S7, S9 to S16, D1, H1 to H3 and about 40 BOM vendor pages were re-checked on 25 Oct 2026. S1 (IS 875-3) and S8 (IS 732) are still confirmed from secondary summaries only. The tags [Sx], [Dx] and [Hx] are the ones used in `safety/SAFETY.md`, `RISKS.md` and `PROBLEM_AND_JOURNEY.md`.

## Standards and regulations

| Tag | Reference | URL |
|---|---|---|
| S1 | BIS, **IS 875 (Part 3):2015**, Design loads (other than earthquake) for buildings and structures, Part 3: Wind loads. Basic wind speeds by city (Delhi 47, Mumbai 44, Chennai 50, Bengaluru 33 m/s) taken from a secondary summary of Fig. 1 (both URLs are the same site; the handbook page lists Delhi 47 Zone IV, Mumbai 44 Zone IV, Chennai 50 Zone V, Bengaluru 33 Zone I, 50-year return period, 10 m, terrain category 2). BIS record not retrieved | https://infralens.in/code/IS-875-Part-3-2015 ; https://infralens.in/handbook/wind-speed |
| S2 | CEN, **EN 12453:2017+A1:2021**, Industrial, commercial and garage doors and gates: Safety in use of power operated doors: Requirements and test methods (BS edition published 31 May 2022; scope covers barriers within reach of persons) | https://knowledge.bsigroup.com/products/industrial-commercial-and-garage-doors-and-gates-safety-in-use-of-power-operated-doors-requirements-and-test-methods-1 ; https://certifico.com/normazione/358-news-normazione/15417-en-12453-2017-a1-2021 |
| S3 | IEC, **IEC 60529:1989+AMD1:1999+AMD2:2013 CSV** (Ed. 2.2), Degrees of protection provided by enclosures (IP Code) | https://webstore.iec.ch/en/publication/2452 |
| S4 | CEN, **EN 12978:2024**, Industrial, commercial and garage doors and gates and pedestrian doorsets: Protective devices for power operated doors and gates: Requirements and test methods (replaces EN 12978:2003+A1:2009; the old edition's withdrawal is dated 10 Jun 2025 on the Albanian DPS listing; the EVS page shows 'valid from 31.12.2024' and excludes ultrasonic, radar, capacitive, inductive, passive-infrared and vision-based sensors from scope) | https://evs.ee/en/evs-en-12978-2024 ; https://dps.gov.al/en/project/show/dps:proj:23486 |
| S5 | IEC, **IEC 62368-1:2023** (Ed. 4.0, 2023-05-26), Audio/video, information and communication technology equipment, Part 1: Safety requirements | https://webstore.iec.ch/publication/69308 |
| S6 | IEC, **IEC 61000-6-2:2016** (Ed. 3.0), EMC: Generic standards: Immunity for industrial environments; **IEC 61000-6-4:2018** (Ed. 3.0), EMC: Generic standards: Emission standard for industrial environments | https://webstore.iec.ch/publication/25630 ; https://webstore.ansi.org/standards/iec/iec61000ed2018-1673899 |
| S7 | BIS, **IS 3043:2018**, Code of practice for earthing (Second Revision) | https://services.bis.gov.in/php/BIS_2.0/bisconnect/knowyourstandards/Indian_standards/isdetails/OTYxOQ== |
| S8 | BIS, **IS 732:2019**, Code of practice for electrical wiring installations. *Edition from secondary sources; BIS record not retrieved* | https://www.studiomatrx.org/guides/electrical-standards-codes-india ; https://infralens.in/code/IS-732 |
| S9 | MoC (WPC Wing), **G.S.R. 853(E), 10 Dec 2021**: Use of Low Power Equipment in the Frequency Band 865–868 MHz for Short Range Devices (Exemption from Licence) Rules, 2021. RFID: 2 W e.r.p., 4 channels at 865.7 / 866.3 / 866.9 / 867.5 MHz, ≤200 kHz, ≤4 s continuous, ≥100 ms gap | https://www.thc.nic.in/Central%20Governmental%20Rules/use%20of%20low%20power%20Equipment%20in%20the%20frequency%20band%20865%20to%20868%20MHz%20for%20Short%20Range%2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,2021.pdf |
| S10 | DoT (WPC Wing), Clarification on ETA under **G.S.R. 564(E), 30 Jul 2008** (865–867 MHz; 1 W transmitter power, 4 W ERP, 200 kHz), letter No. R-11018/01/2017-PP dated **4 Jul 2018** (as read from the PDF on 25 Oct 2026; an earlier version of this table said 27 Mar 2019); DoT index of delicensing gazette notifications | https://dot.gov.in/sites/default/files/Clarification%20ETA%20865-867%20MHz.pdf ; https://dotws.cdot.in/sites/default/files/Gazette_Notifications.pdf |
| S11 | ISO/IEC, **ISO/IEC 18000-63:2021**, Parameters for air interface communications at 860 MHz to 960 MHz Type C | https://www.iso.org/standard/78309.html ; https://webstore.iec.ch/publication/72310 |
| S12 | GS1, **EPC UHF Gen2 Air Interface Protocol**, Release 3.0.1 (ratified Feb 2026) | https://ref.gs1.org/standards/gen2 |
| S13 | IHMCL, *For FASTag Users*: the electronic toll collection programme's RFID "conforming to EPC Gen-2, ISO 18000-6C standards" (the sentence does not name FASTag); IHMCL Phase-1 SOP (tag to comply with MoRTH specs; TID/EPC data fields) | https://ihmcl.co.in/fastag-user-old/ ; https://ihmcl.co.in/wp-content/uploads/2017/11/PHASE-1-DG-SOP.pdf |
| S14 | NPCI, **NETC FASTag**: Product overview (issuer/acquirer roles, NETC Mapper, switch) | https://npci.org.in/what-we-do/netc-fastag/product-overview |
| S15 | **Digital Personal Data Protection Act, 2023** (enacted Aug 2023) | https://www.meity.gov.in/data-protection-framework ; https://ca.hoganlovells.com/en/publications/indias-digital-personal-data-protection-act-2023-brought-into-force- |
| S16 | MeitY, **Digital Personal Data Protection Rules, 2025**, G.S.R. 846(E), notified 13 Nov 2025 (a PIB page dates the press release 14 Nov 2025): phased commencement; r.6 safeguards; r.7 breach intimation (72 h detailed report) | https://teamleaseregtech.com/updates/article/49356/digital-personal-data-protection-rules-2025/ ; https://www.mondaq.com/india/data-protection/1708164/digital-personal-data-protection-rules-2025-notified ; https://static.pib.gov.in/WriteReadData/specificdocs/documents/2025/nov/doc20251117695301.pdf |

## Data sources (problem context)

| Tag | Reference | URL |
|---|---|---|
| D1 | Times Drive (30 Jan 2026), MoRTH: over 98 % of NH user fees collected via FASTag; 11.86 crore FASTags issued as of Dec 2025 | https://www.timesdrive.in/news/fastag-accounts-for-over-98-percent-of-toll-collection-on-national-highways-morth-article-153531512/amp |
| D2 | ParkFlow Stage 1 submission: baselines (45 to 90 s/vehicle, 40 to 60 veh/h, 8 to 12 min friction), targets, competitor disclosure (§7.1), journey (§8). Stage 1 cites NHAI/NETC statements, IMARC India Smart Parking Systems Market 2025 and MarketsandMarkets India Parking Management Market 2025 | `docs/ParkFlow_Stage1.pdf` |

## Hardware datasheets / vendor documentation

| Tag | Reference | URL |
|---|---|---|
| H1 | Raspberry Pi Ltd, *Heating and cooling Raspberry Pi 5*: throttling at 80 °C, more at 85 °C; Active Cooler fan thresholds | https://www.raspberrypi.com/news/heating-and-cooling-raspberry-pi-5/ |
| H2 | Raspberry Pi AI HAT+ product brief: 13/26 TOPS (Hailo-8L/Hailo-8), PCIe Gen 3, **0 to 50 °C** operating ambient | https://cdn.sparkfun.com/assets/c/9/b/7/3/Raspberry_Pi_AI_HAT__product_brief.pdf |
| H3 | RFID Journal reader Q&A (about four years old): UHF readers for multi-lane free-flow; mentions ISO 18000-6C passive tags and India 865 to 867 MHz. A discussion thread, not a compliance source | https://www.rfidjournal.com/question/can-uhf-rfid-readers-be-used-for-multi-lane-free-flow-and-open-road-tolling |

## Not verified (excluded from claims)
- EN 12453 numeric force limits (paywalled): not quoted.
- A public NPCI/IHMCL FASTag *technical* tag/reader specification: not found; only IHMCL's conformance statement (S13) is cited.
- IS 732:2019 on the BIS portal: edition taken from secondary sources (S8).
- Basic wind speed for Sonipat/Haryana: Delhi value (47 m/s) used, to be confirmed against IS 875-3 Fig. 1.
- Vendor listing claims (IP ratings, RS485, PoE, 850 nm IR, self-locking) for the RFID reader, camera, P10 module and wiper motor: see the Notes column of `bom/ParkFlow_BOM.xlsx`; several are not stated on the listings.
- Stage 1 competitor funding figures (Park+ "over 50 million US dollars"; Get My Parking pilots in Jaipur and Navi Mumbai): not re-verified. Public reports found on 25 Oct 2026 show separate Park+ rounds of about 11, 17 and 25 million US dollars and a 140 crore rupee Series C, but a total was not checked. These figures are not repeated in the Stage 2 documents.
- Park+ and other competitor claims in `PROBLEM_AND_JOURNEY.md` come from Stage 1 only.
