kgchord/ParkFlow/cad/fea/figures/convergence_A_pole_base.png

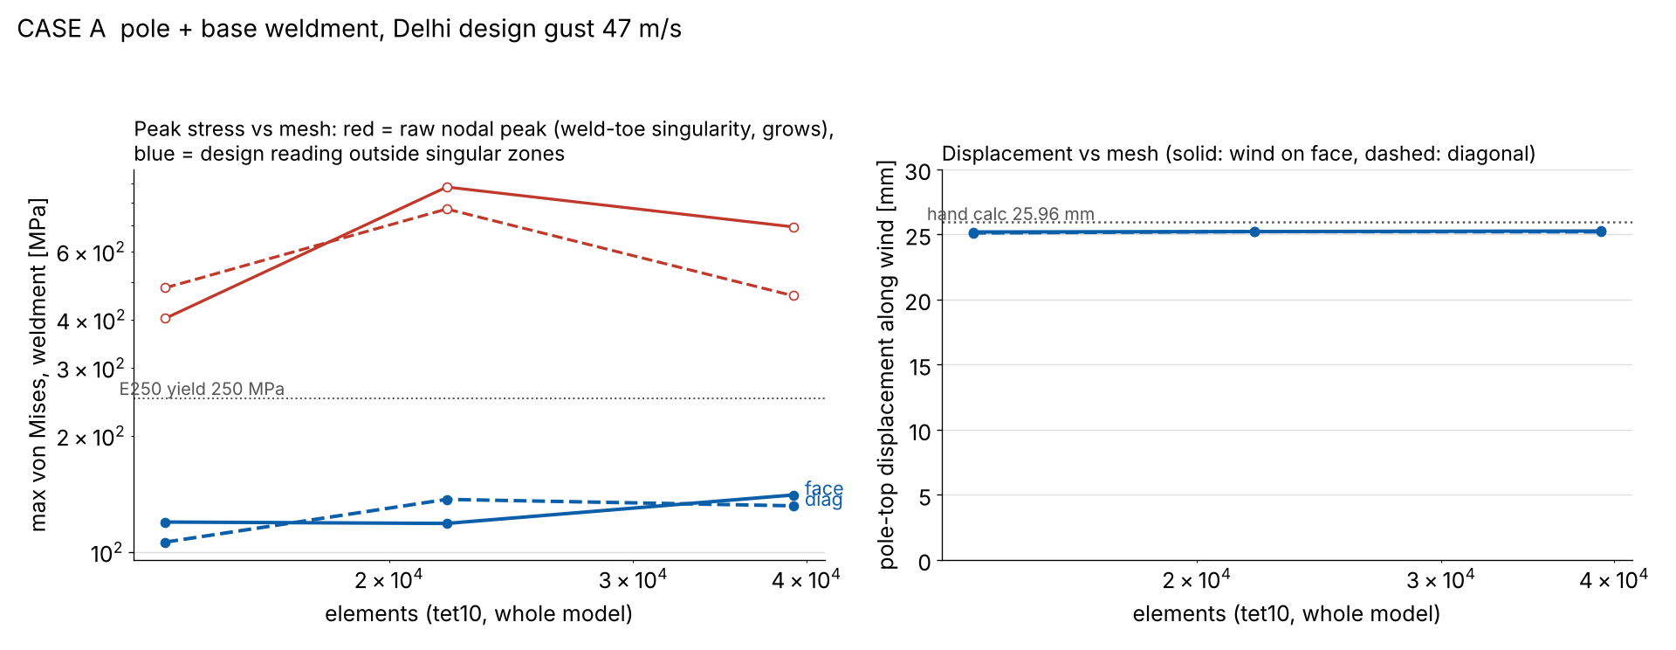
cad/fea/figures/convergence_A_pole_base.png
