kgchord/ParkFlow/cad/fea/figures/convergence_B_bracket_arm.png

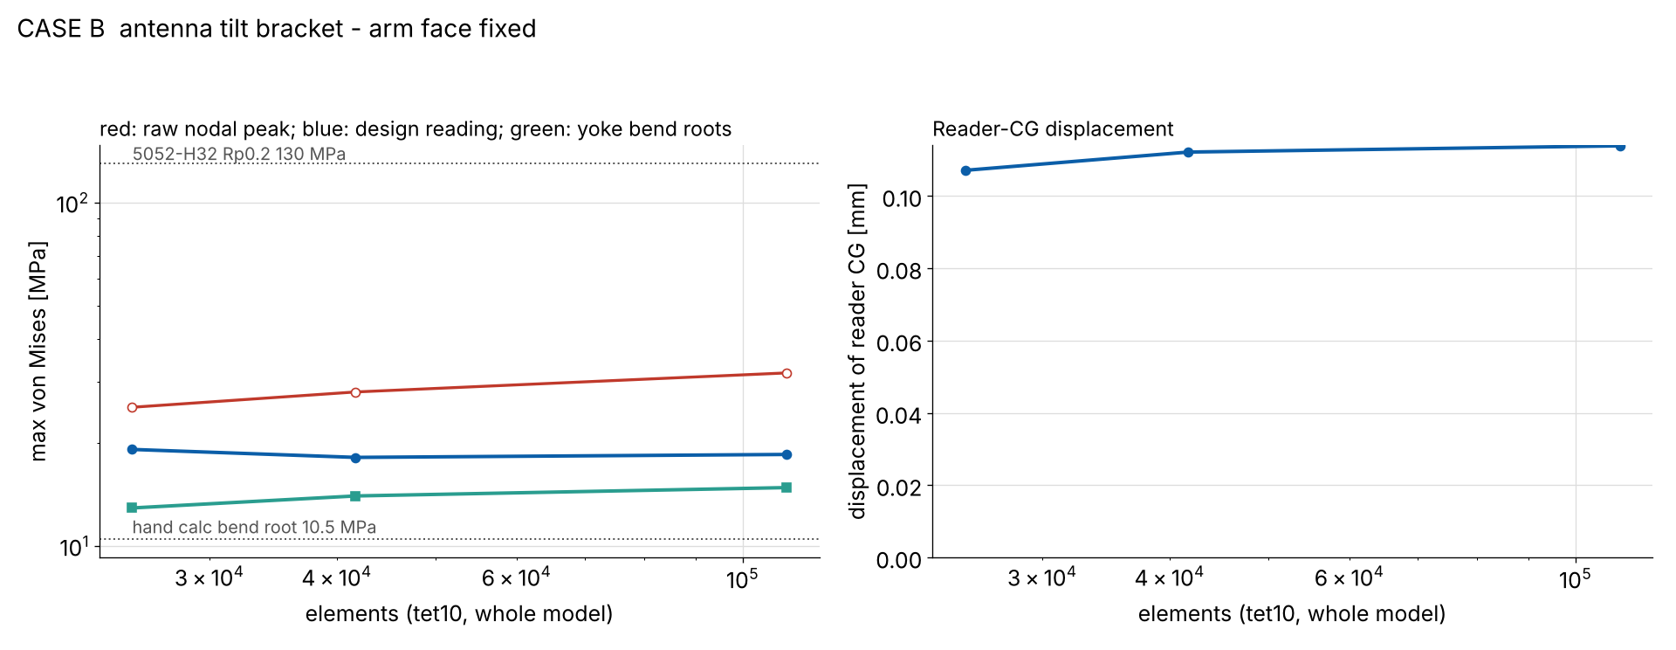
cad/fea/figures/convergence_B_bracket_arm.png
