kgchord/ParkFlow/cad/fea/figures/convergence_B_bracket_contact.png

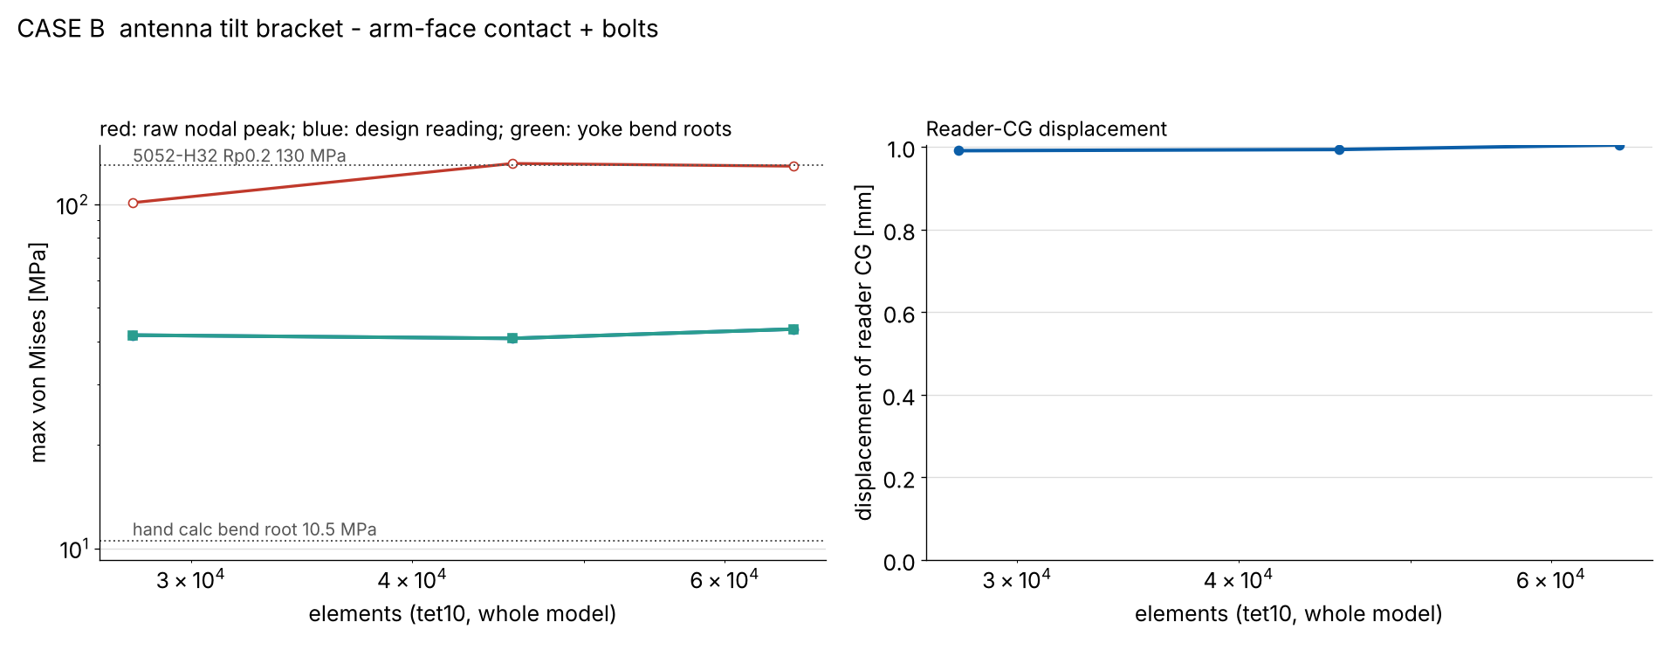
cad/fea/figures/convergence_B_bracket_contact.png
