kgchord/ParkFlow/cad/fea/figures/convergence_B_bracket_washer.png

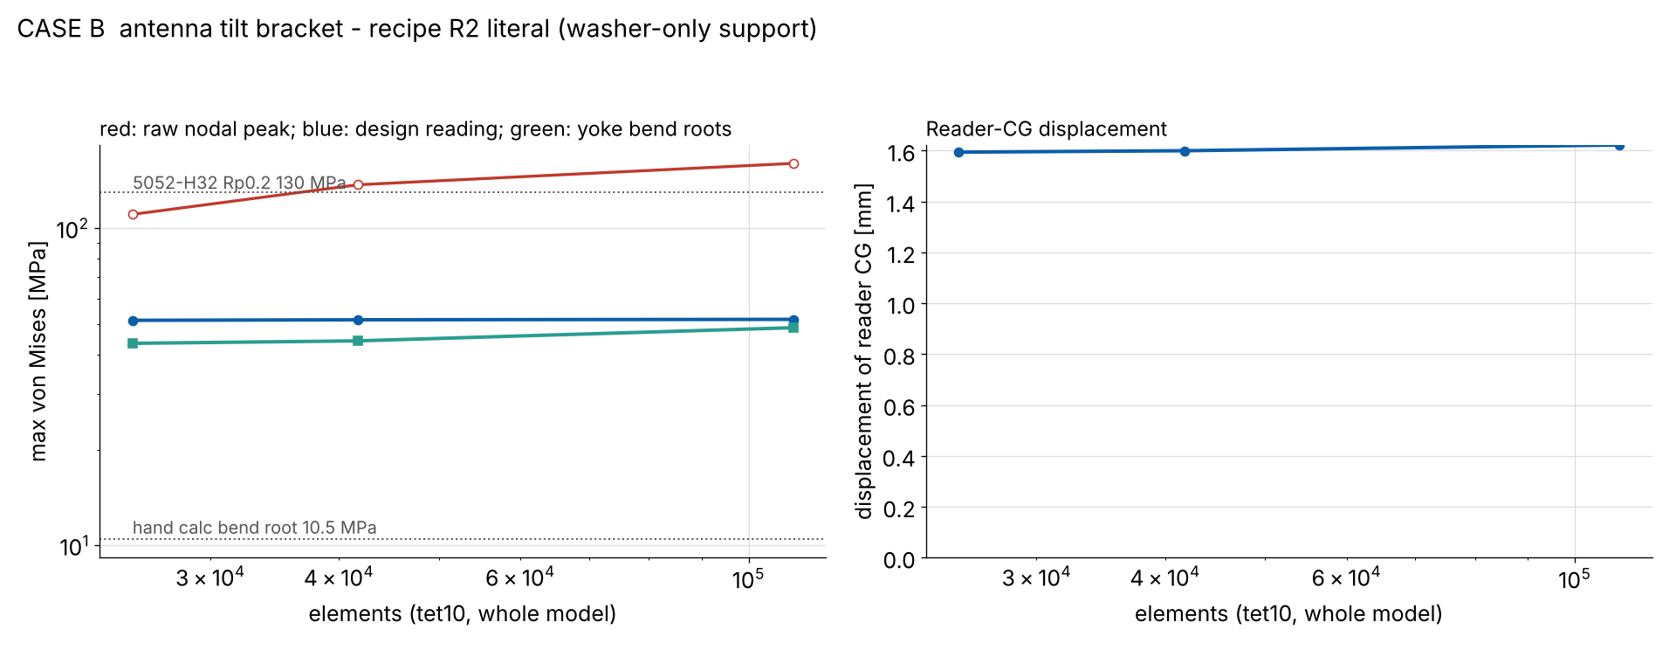
cad/fea/figures/convergence_B_bracket_washer.png
