kgchord/ParkFlow/cad/fea/figures/convergence_C_boom.png

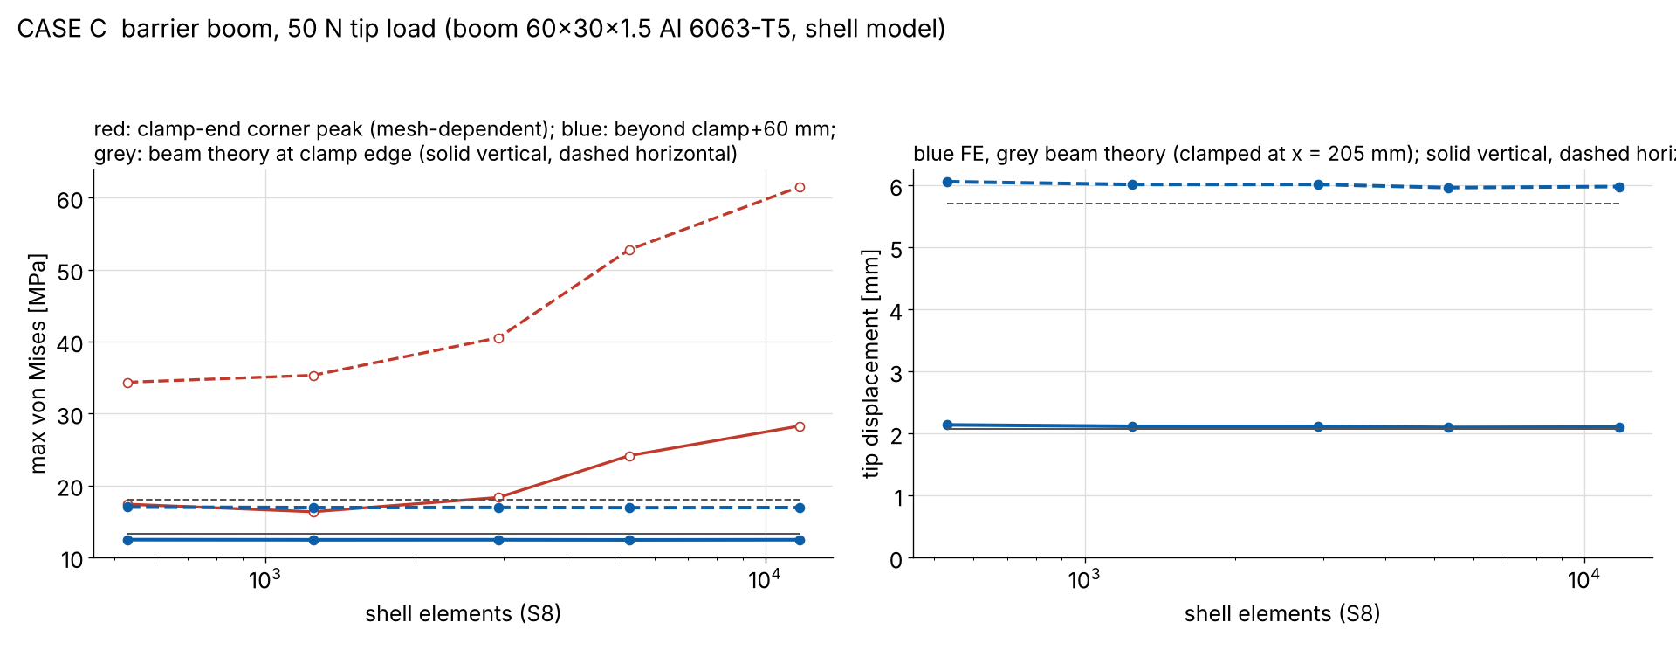
cad/fea/figures/convergence_C_boom.png
