kgchord/ParkFlow/cad/fea/figures/vm_A_diag_base.png

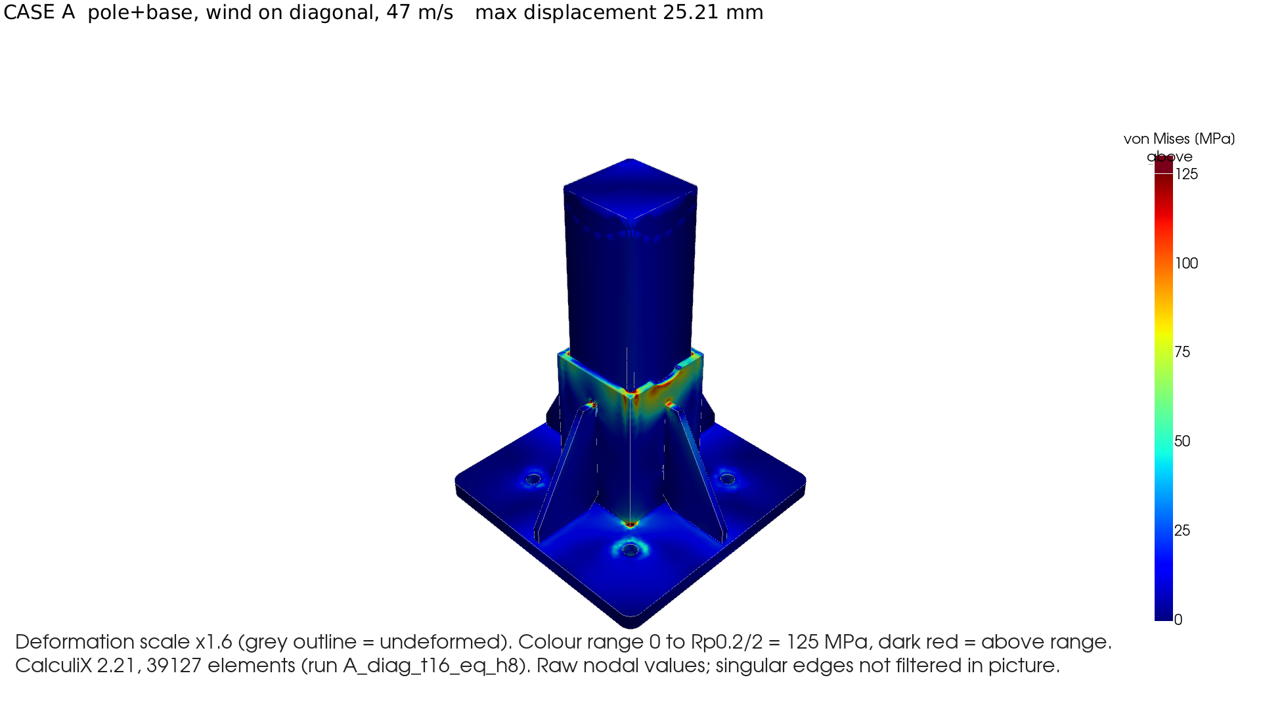
cad/fea/figures/vm_A_diag_base.png
