kgchord/ParkFlow/cad/fea/figures/vm_A_face_pole.png

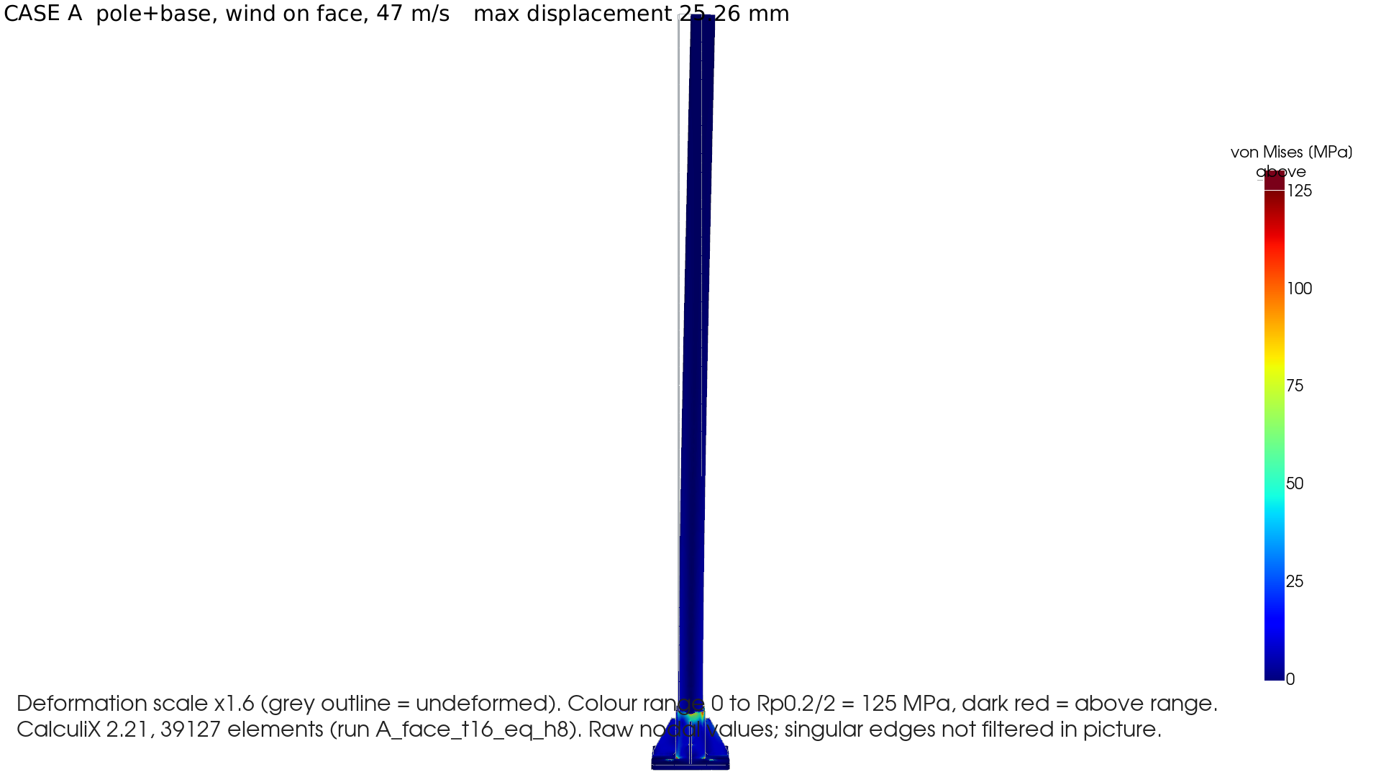
cad/fea/figures/vm_A_face_pole.png
