kgchord/ParkFlow/cad/fea/figures/vm_B_arm_iso.png

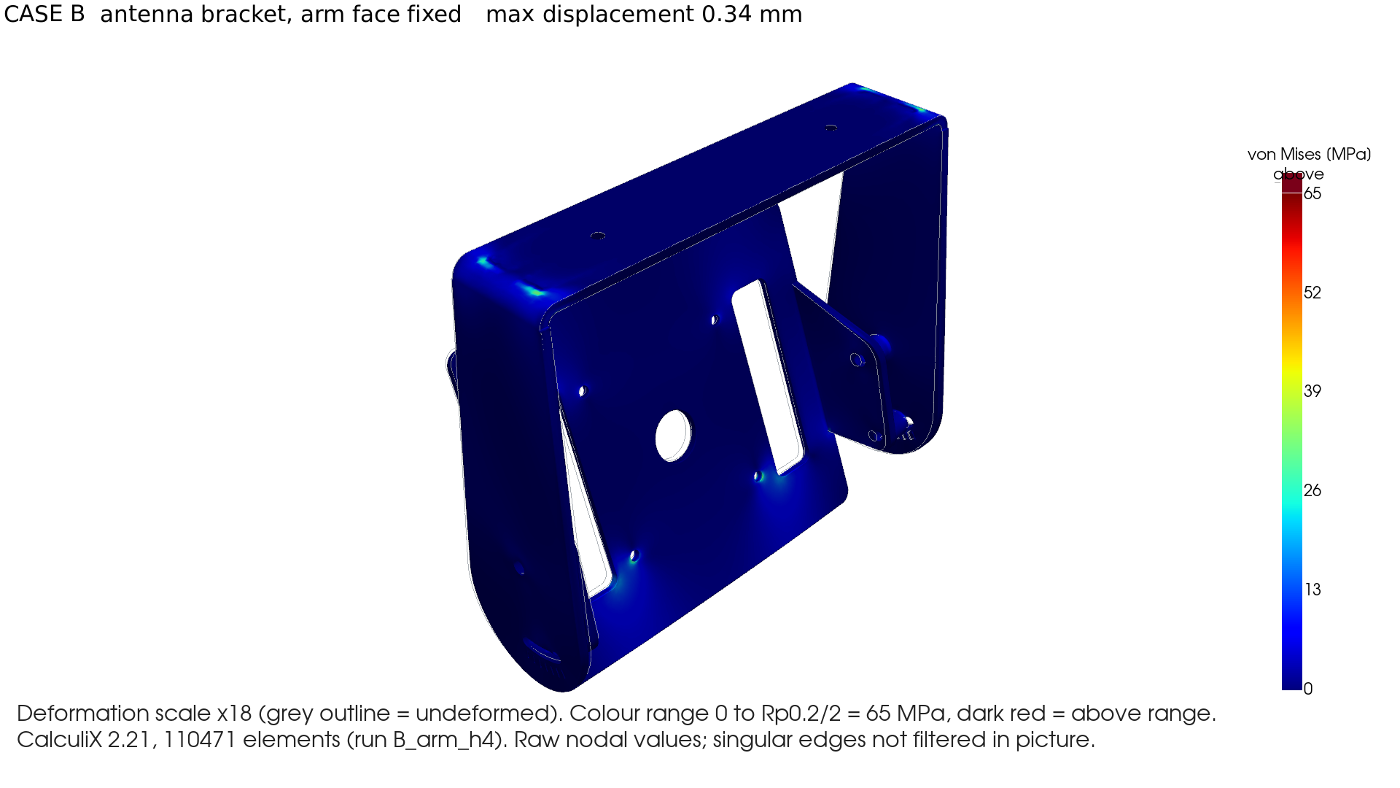
cad/fea/figures/vm_B_arm_iso.png
