kgchord/ParkFlow/cad/fea/figures/vm_B_contact_iso.png

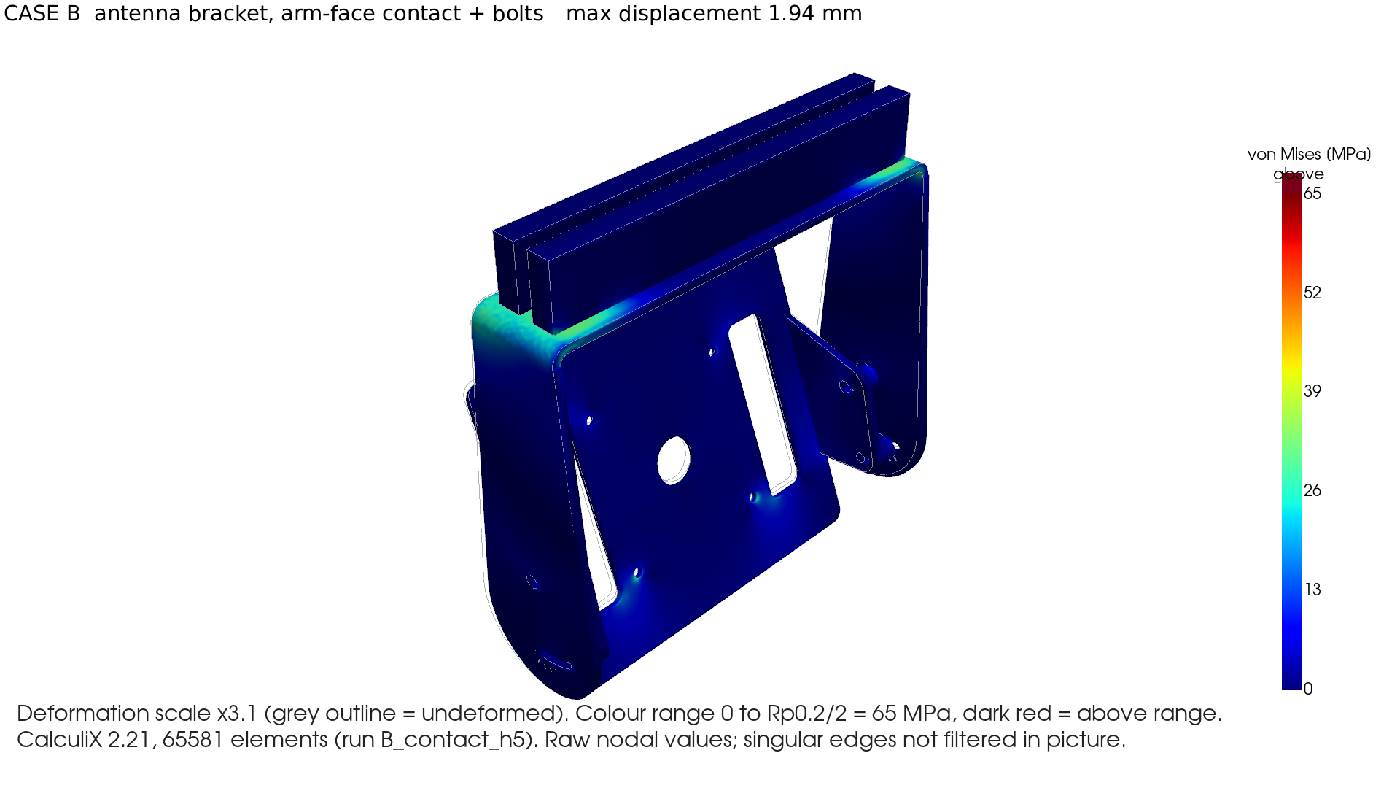
cad/fea/figures/vm_B_contact_iso.png
