kgchord/ParkFlow/cad/fea/figures/vm_B_washer_iso.png

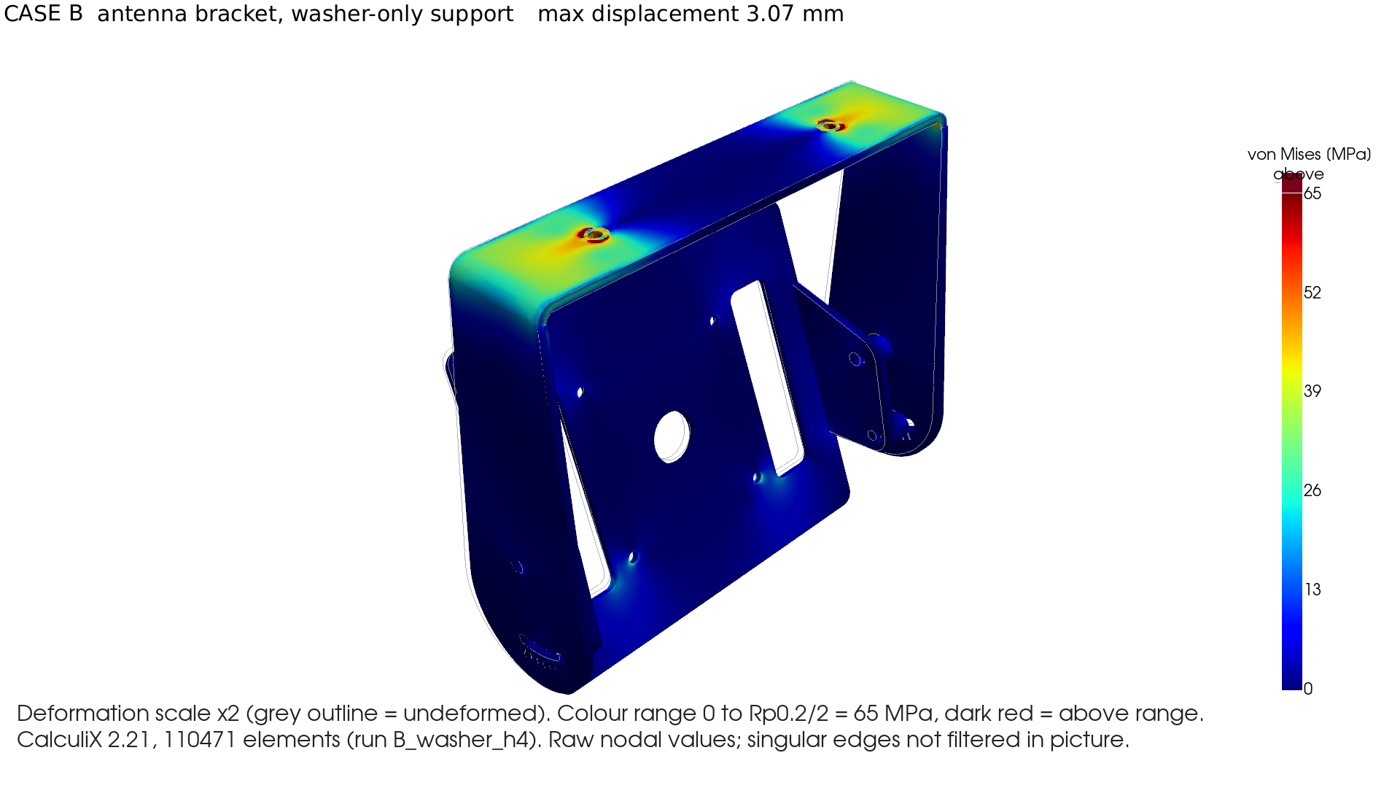
cad/fea/figures/vm_B_washer_iso.png
