kgchord/ParkFlow/cad/fea/figures/vm_C_boom_horiz_iso.png

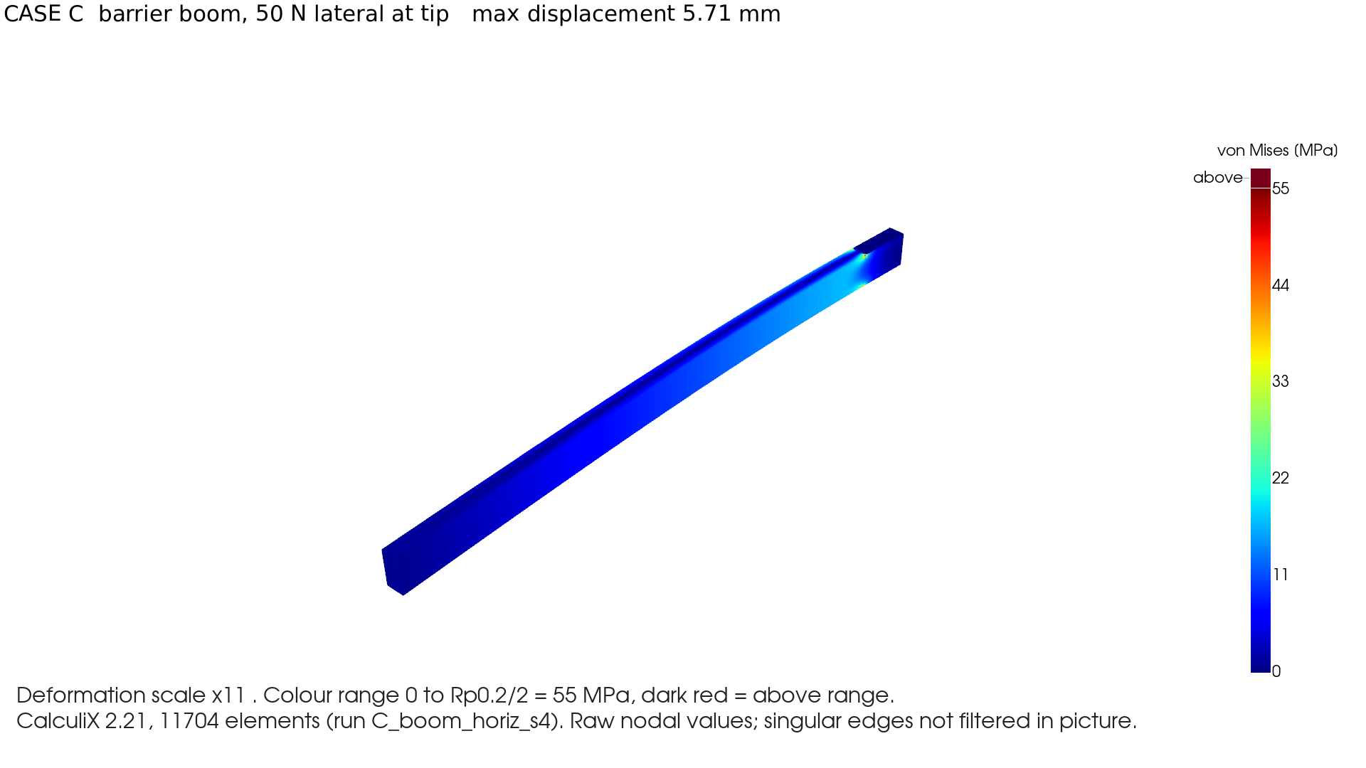
cad/fea/figures/vm_C_boom_horiz_iso.png
