kgchord/ParkFlow/cad/fea/figures/vm_C_boom_vert_clamp.png

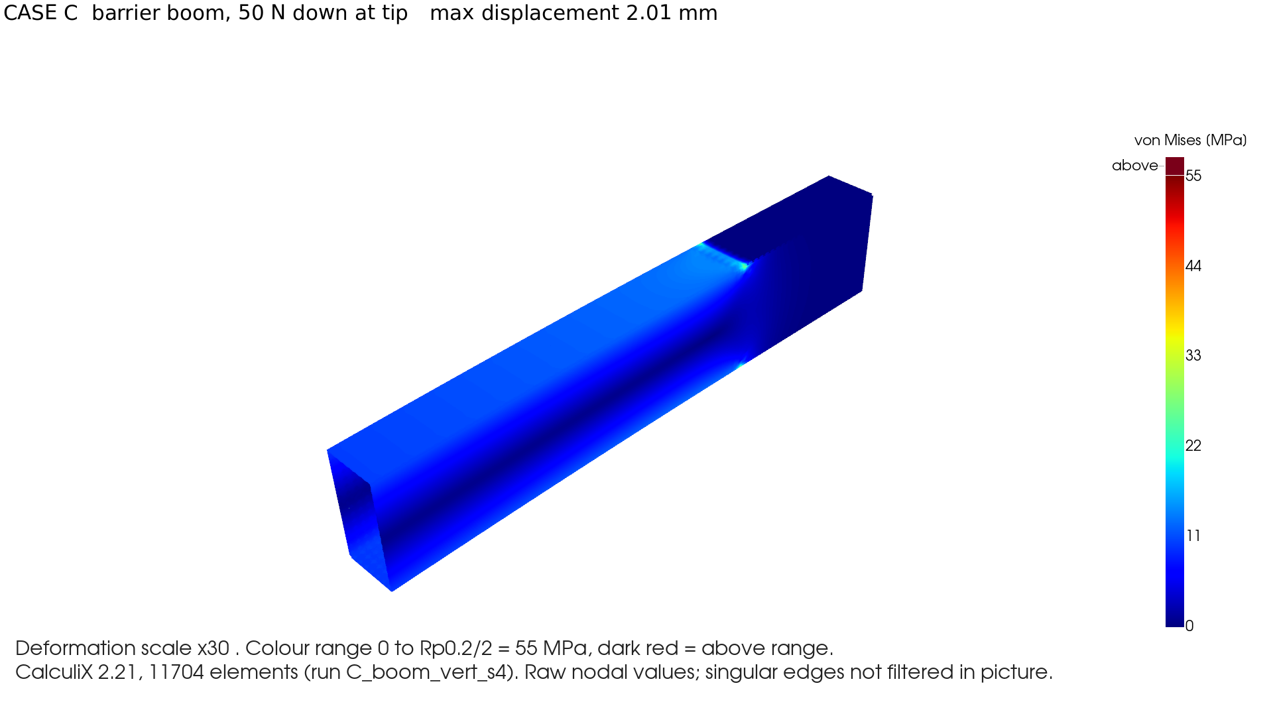
cad/fea/figures/vm_C_boom_vert_clamp.png
