kgchord/ParkFlow/cad/fea/figures/vm_C_boom_vert_iso.png

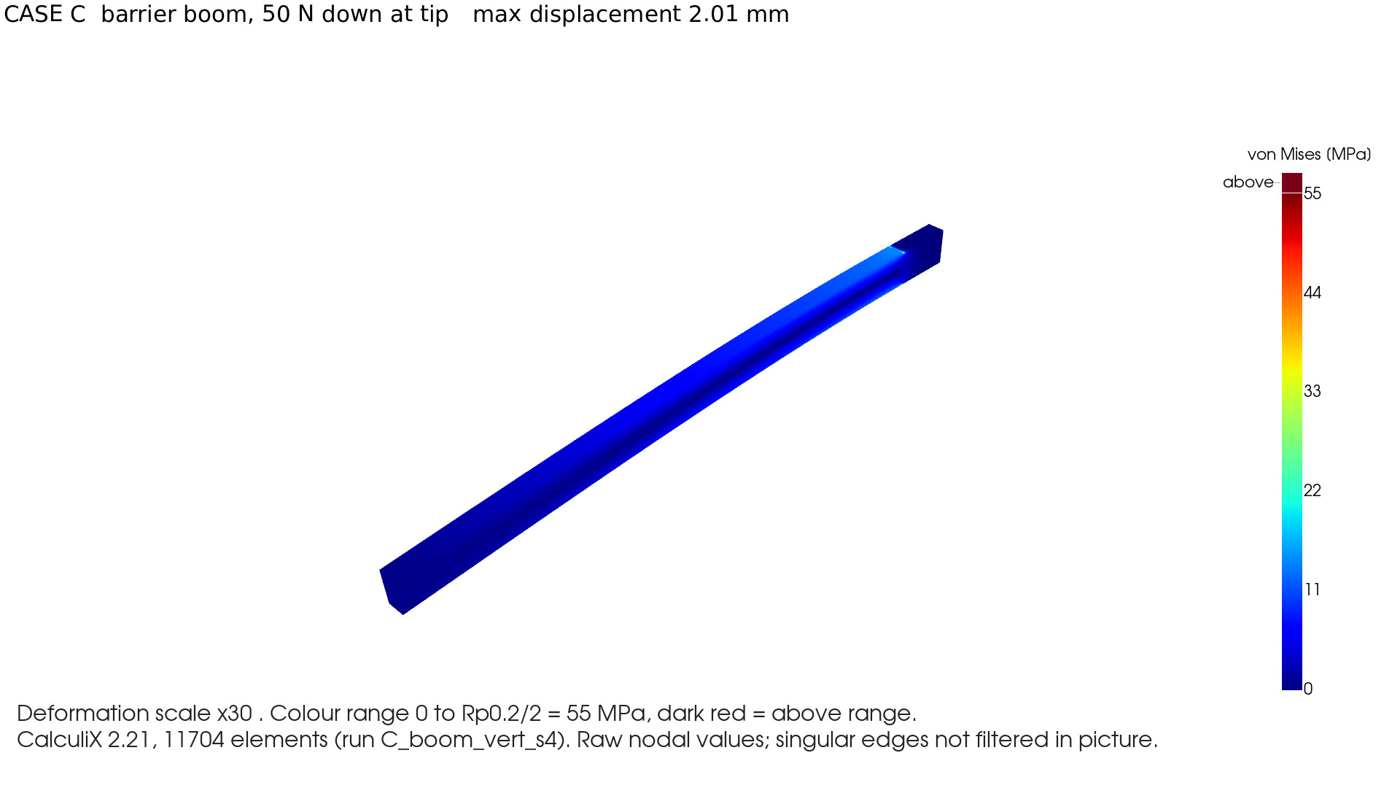
cad/fea/figures/vm_C_boom_vert_iso.png
