kgchord/ParkFlow/cad/renders/anim_frames/barrier_00.png

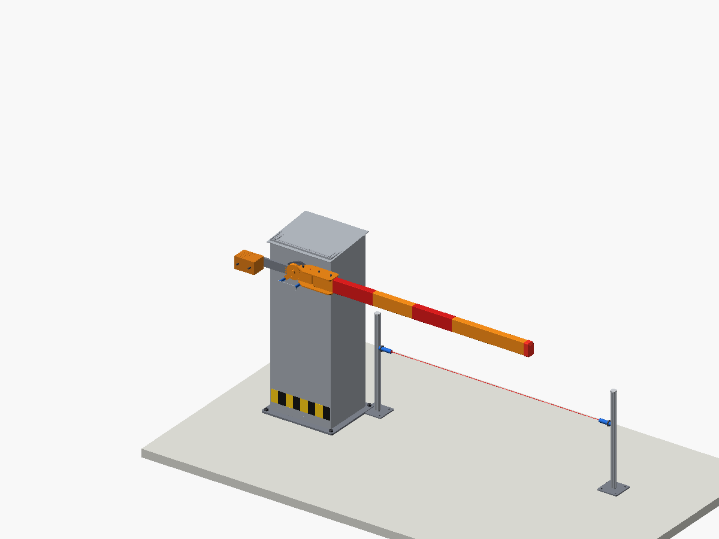
cad/renders/anim_frames/barrier_00.png
