kgchord/ParkFlow/cad/renders/anim_frames/barrier_02.png

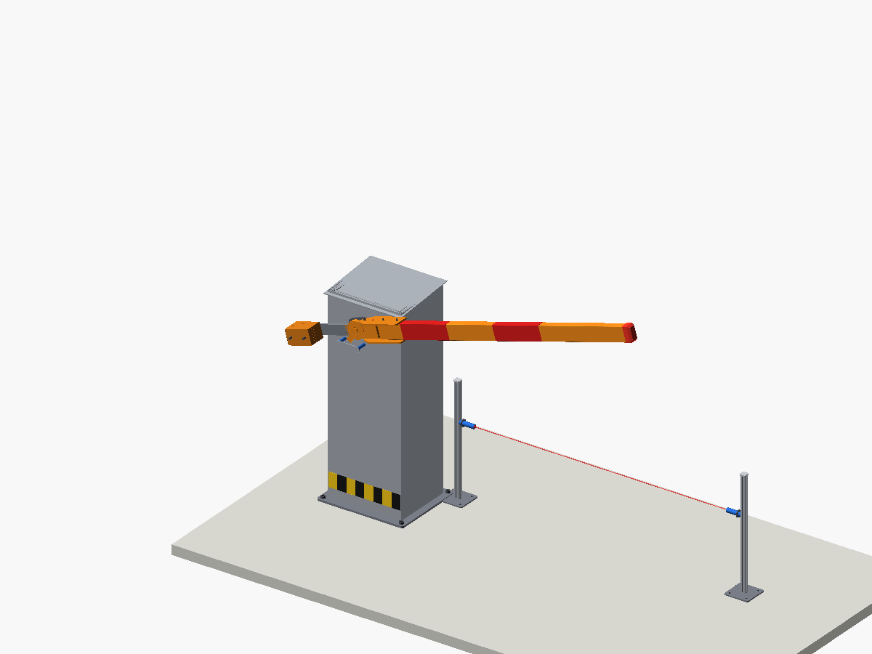
cad/renders/anim_frames/barrier_02.png
