kgchord/ParkFlow/cad/renders/anim_frames/barrier_03.png

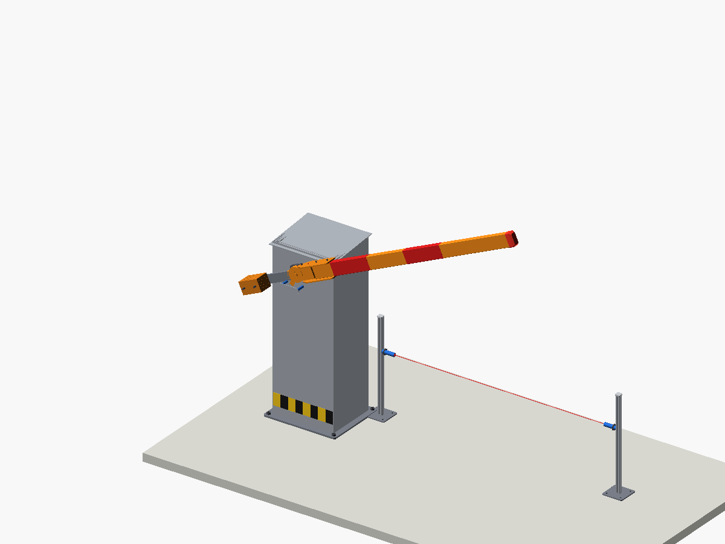
cad/renders/anim_frames/barrier_03.png
