kgchord/ParkFlow/cad/renders/anim_frames/barrier_06.png

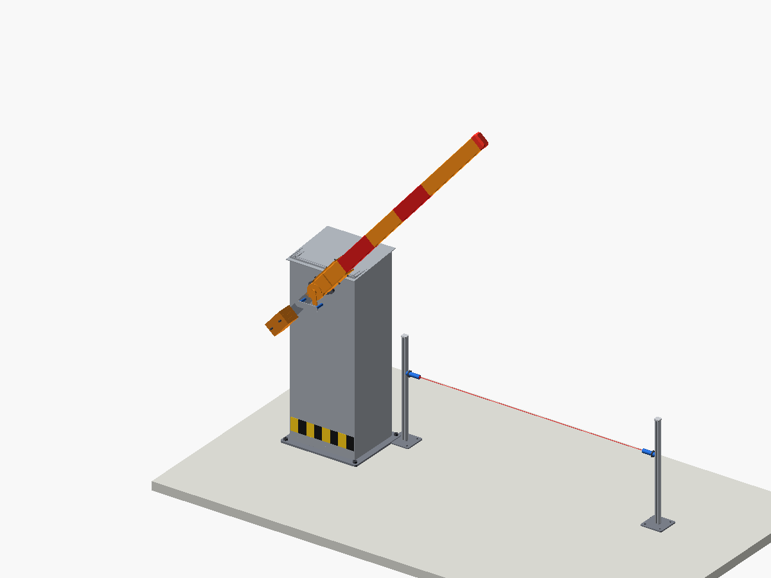
cad/renders/anim_frames/barrier_06.png
