kgchord/ParkFlow/cad/renders/anim_frames/barrier_08.png

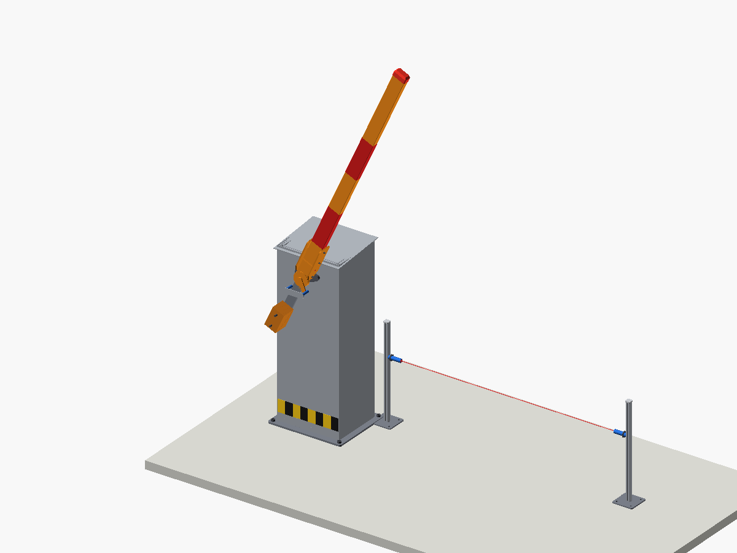
cad/renders/anim_frames/barrier_08.png
