kgchord/ParkFlow/cad/renders/anim_frames/barrier_10.png

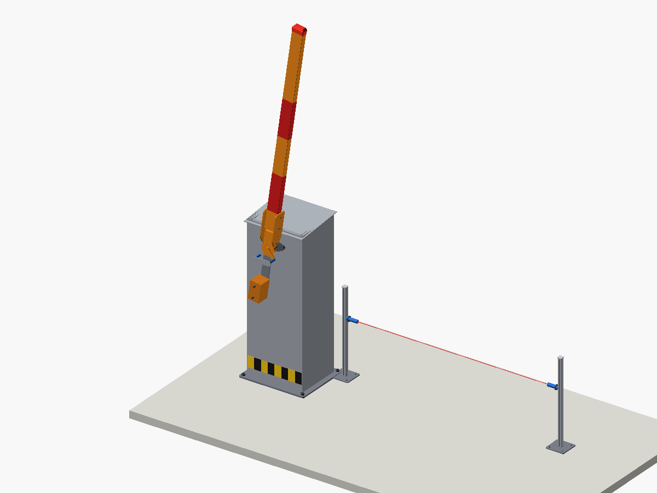
cad/renders/anim_frames/barrier_10.png
