kgchord/ParkFlow/cad/renders/anim_frames/barrier_11.png

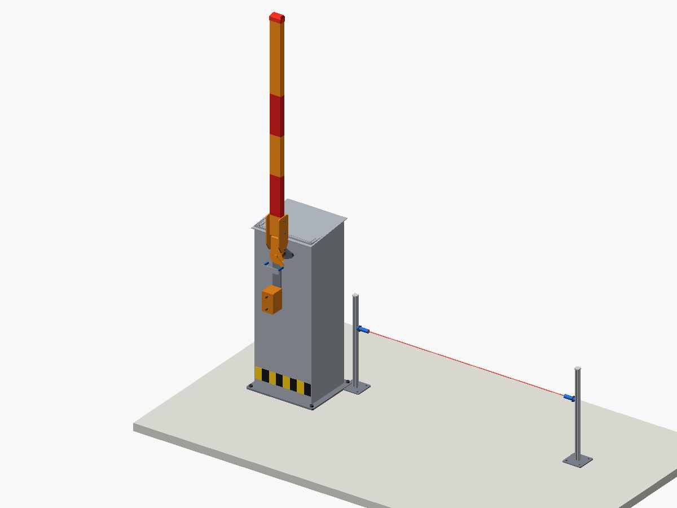
cad/renders/anim_frames/barrier_11.png
