kgchord/ParkFlow/cad/renders/barrier_exploded.png

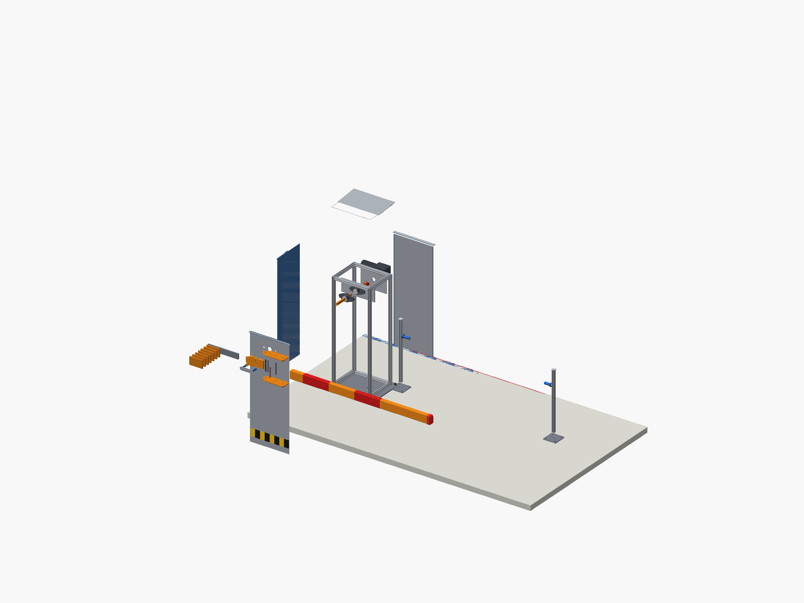
cad/renders/barrier_exploded.png
