kgchord/ParkFlow/cad/renders/barrier_iso.png

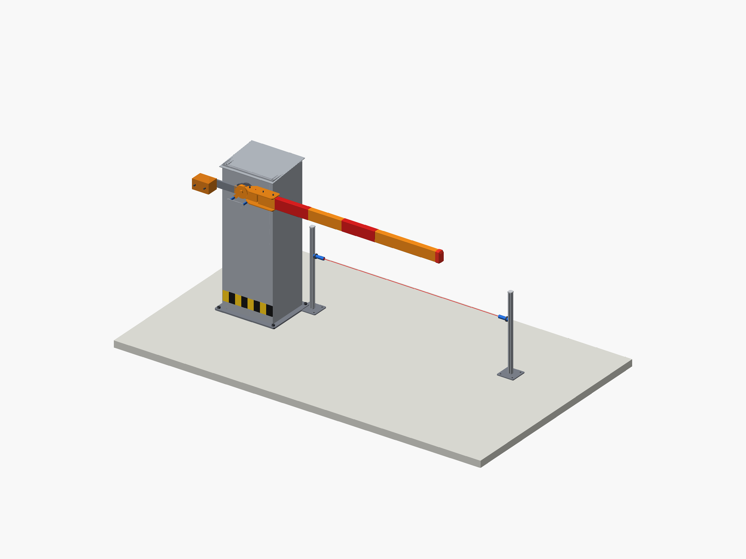
cad/renders/barrier_iso.png
