kgchord/ParkFlow/cad/renders/barrier_section.png

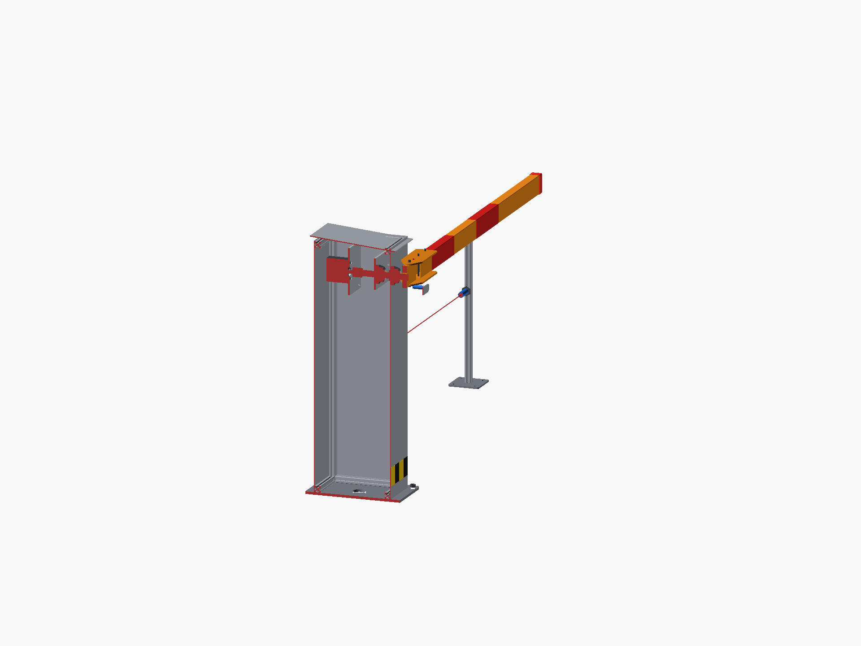
cad/renders/barrier_section.png
