kgchord/ParkFlow/cad/renders/edge_node_exploded.png

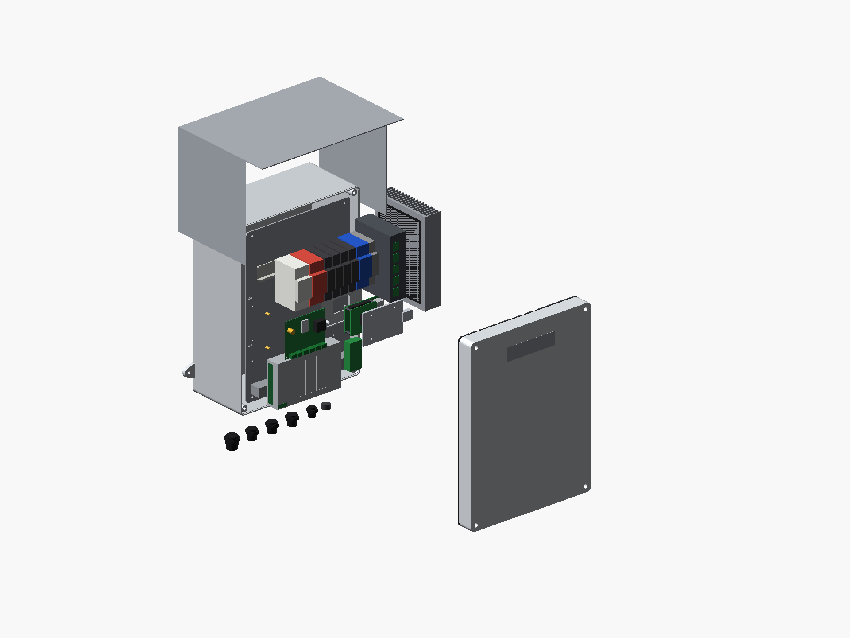
cad/renders/edge_node_exploded.png
