kgchord/ParkFlow/cad/renders/edge_node_iso.png

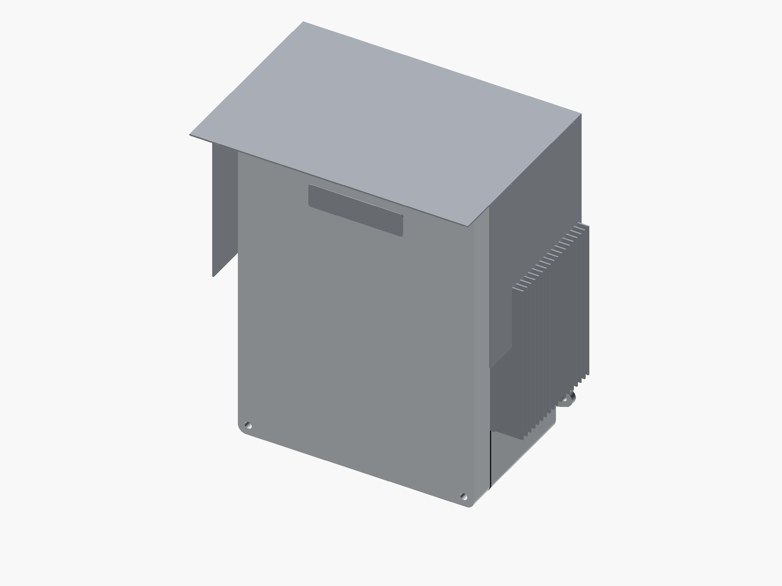
cad/renders/edge_node_iso.png
