kgchord/ParkFlow/cad/renders/edge_node_section.png

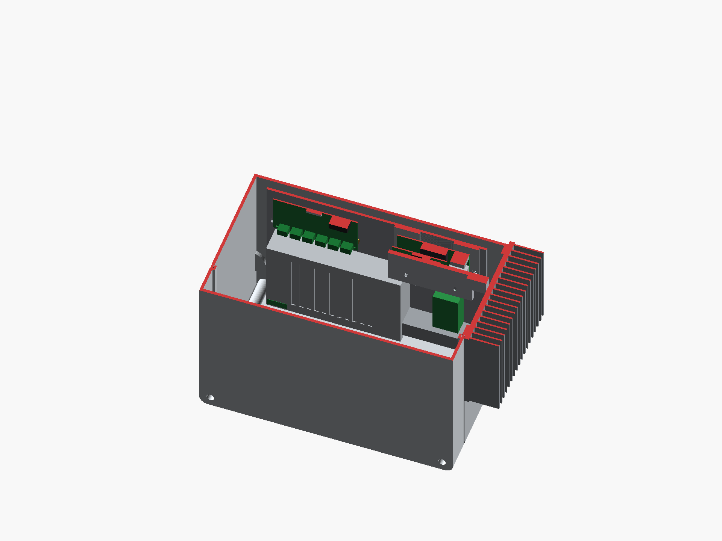
cad/renders/edge_node_section.png
