kgchord/ParkFlow/cad/renders/gantry_detail_antenna.png

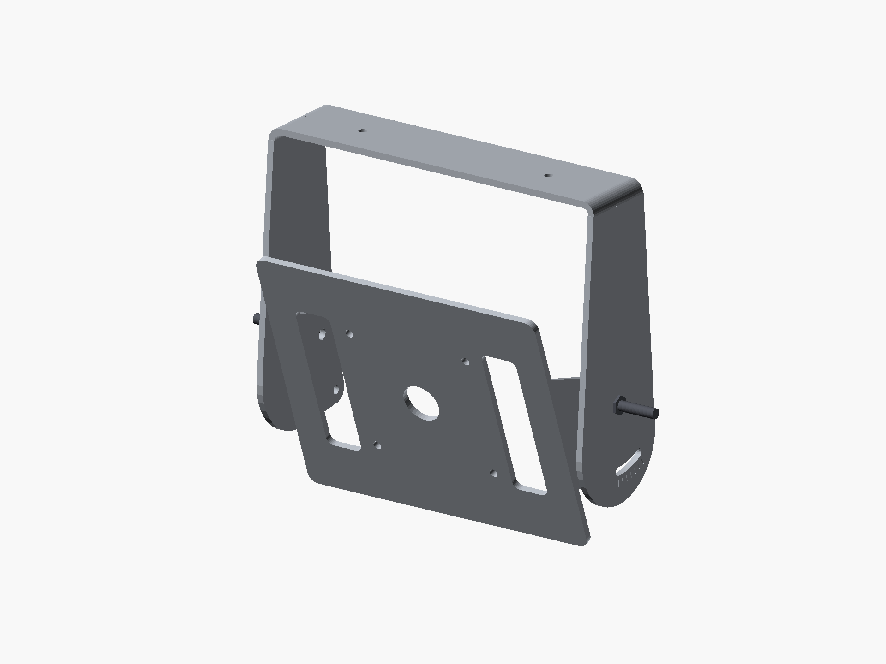
cad/renders/gantry_detail_antenna.png
