kgchord/ParkFlow/cad/renders/gantry_detail_base.png

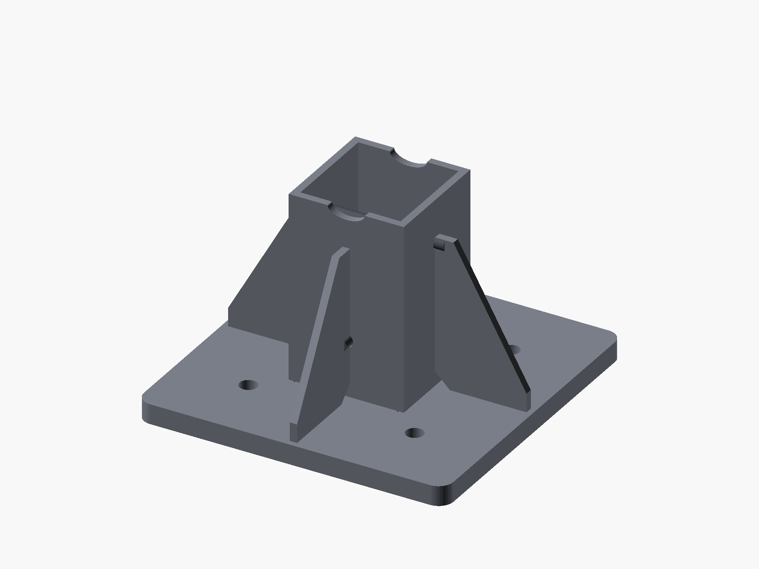
cad/renders/gantry_detail_base.png
