kgchord/ParkFlow/cad/renders/gantry_exploded.png

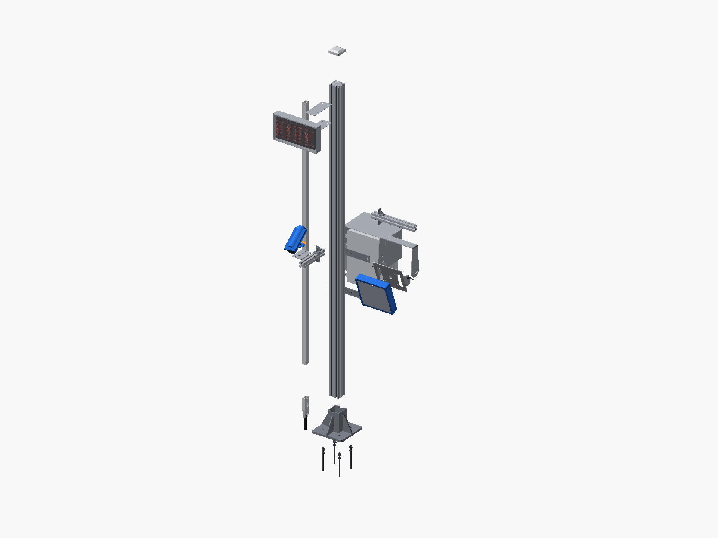
cad/renders/gantry_exploded.png
