kgchord/ParkFlow/cad/renders/gantry_iso.png

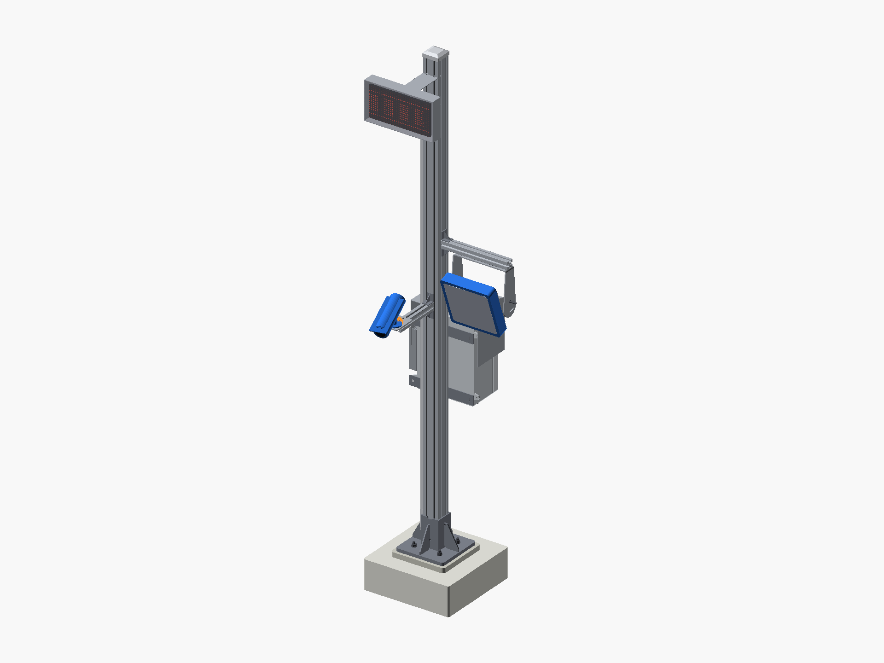
cad/renders/gantry_iso.png
