kgchord/ParkFlow/cad/renders/lane_layout_approach.png

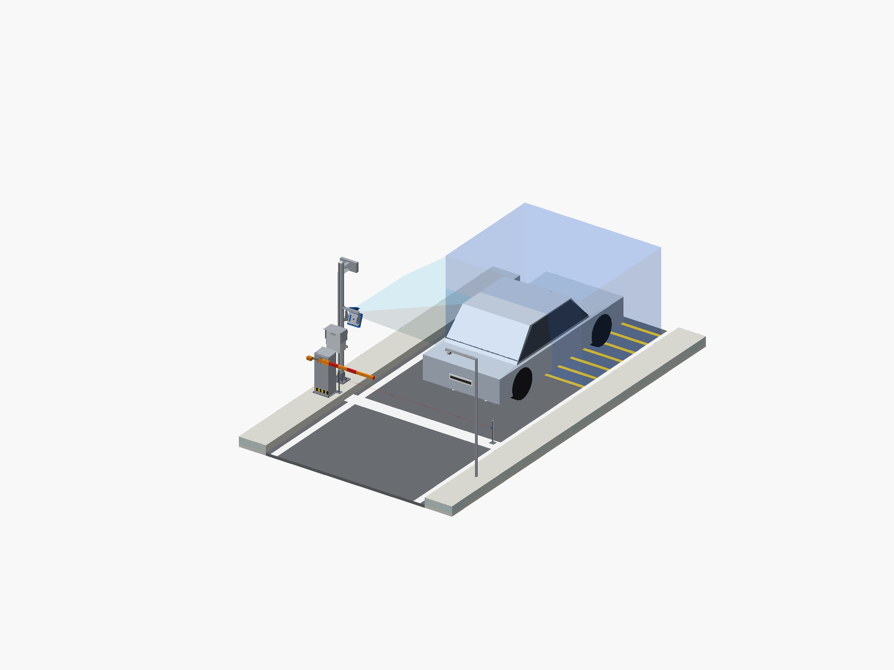
cad/renders/lane_layout_approach.png
