kgchord/ParkFlow/cad/renders/lane_layout_iso.png

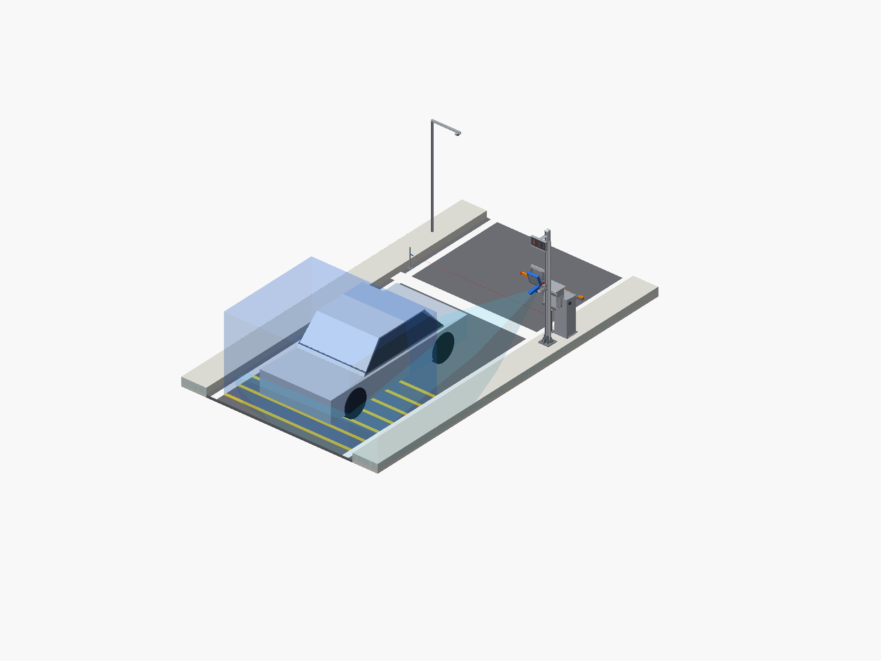
cad/renders/lane_layout_iso.png
