kgchord/ParkFlow/cad/renders/lane_layout_top.png

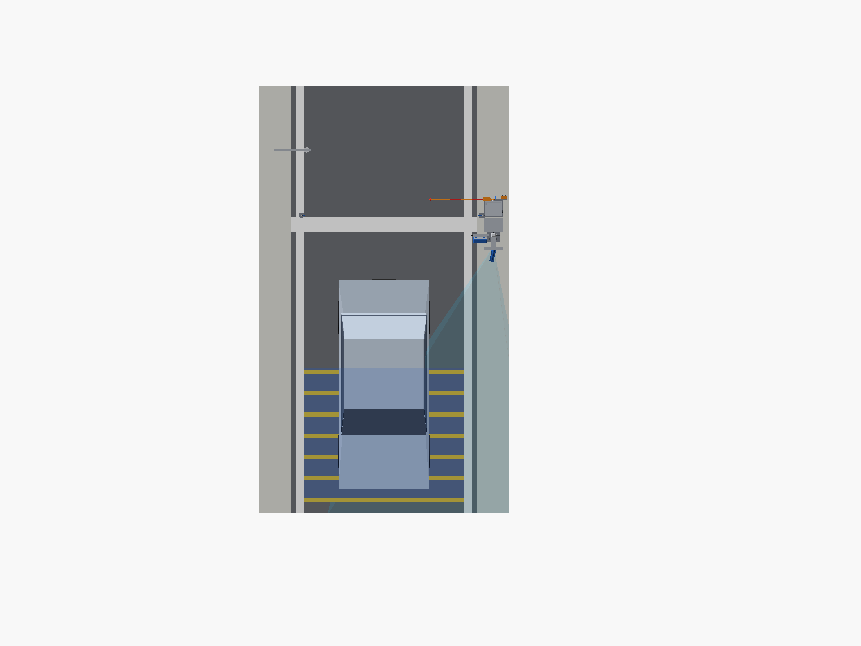
cad/renders/lane_layout_top.png
