kgchord/ParkFlow/cad/renders/occupancy_exploded.png

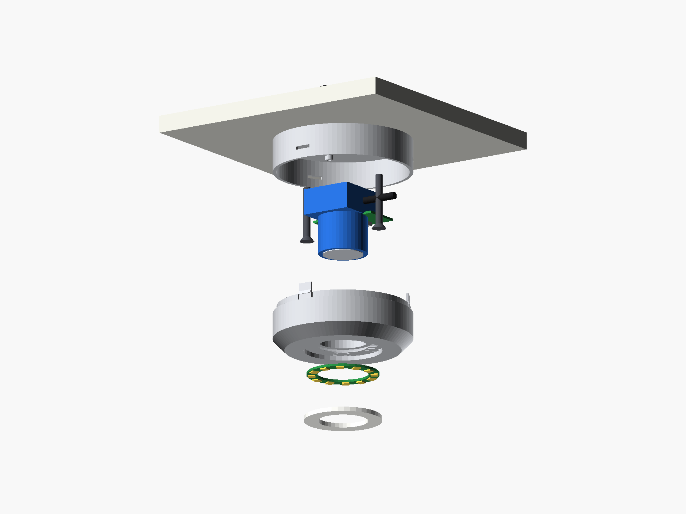
cad/renders/occupancy_exploded.png
