kgchord/ParkFlow/cad/renders/occupancy_iso.png

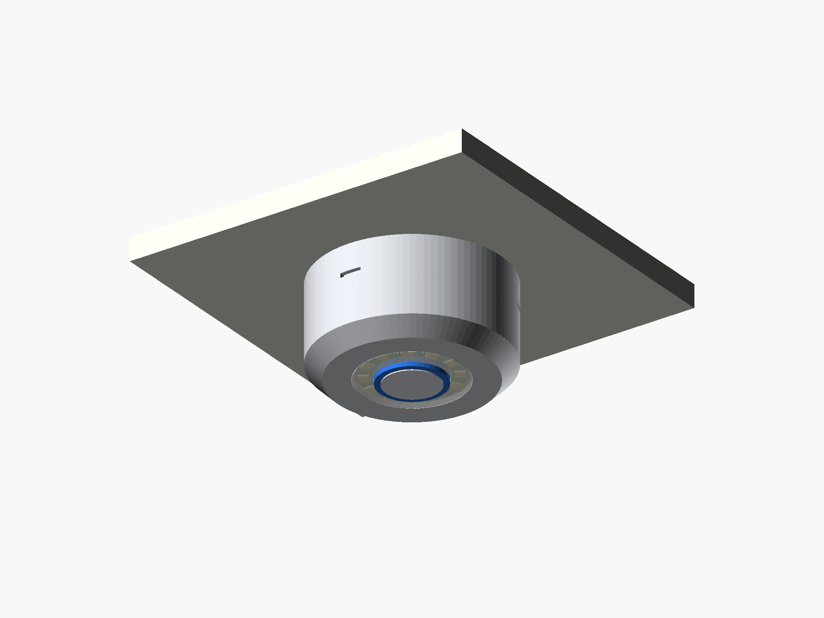
cad/renders/occupancy_iso.png
