kgchord/ParkFlow/cad/renders/occupancy_section.png

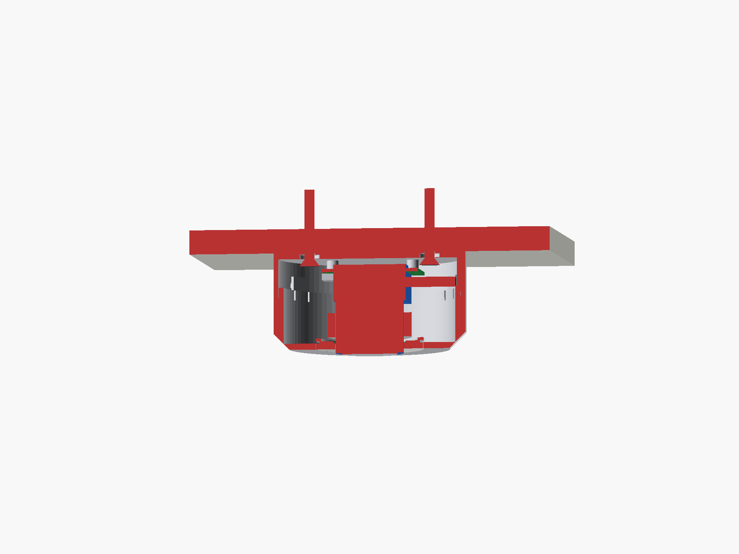
cad/renders/occupancy_section.png
