kgchord/ParkFlow/docs/firmware_flow.png

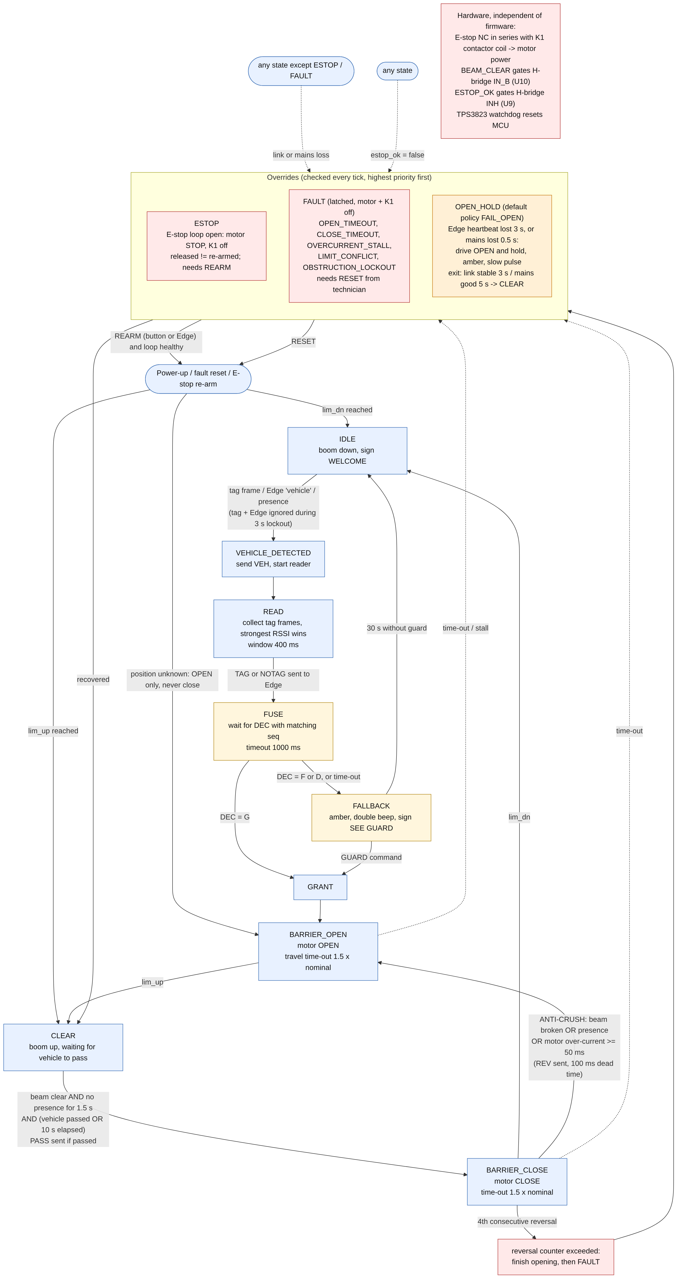
docs/firmware_flow.png
