kgchord/ParkFlow/electronics/diagrams/power_tree.png

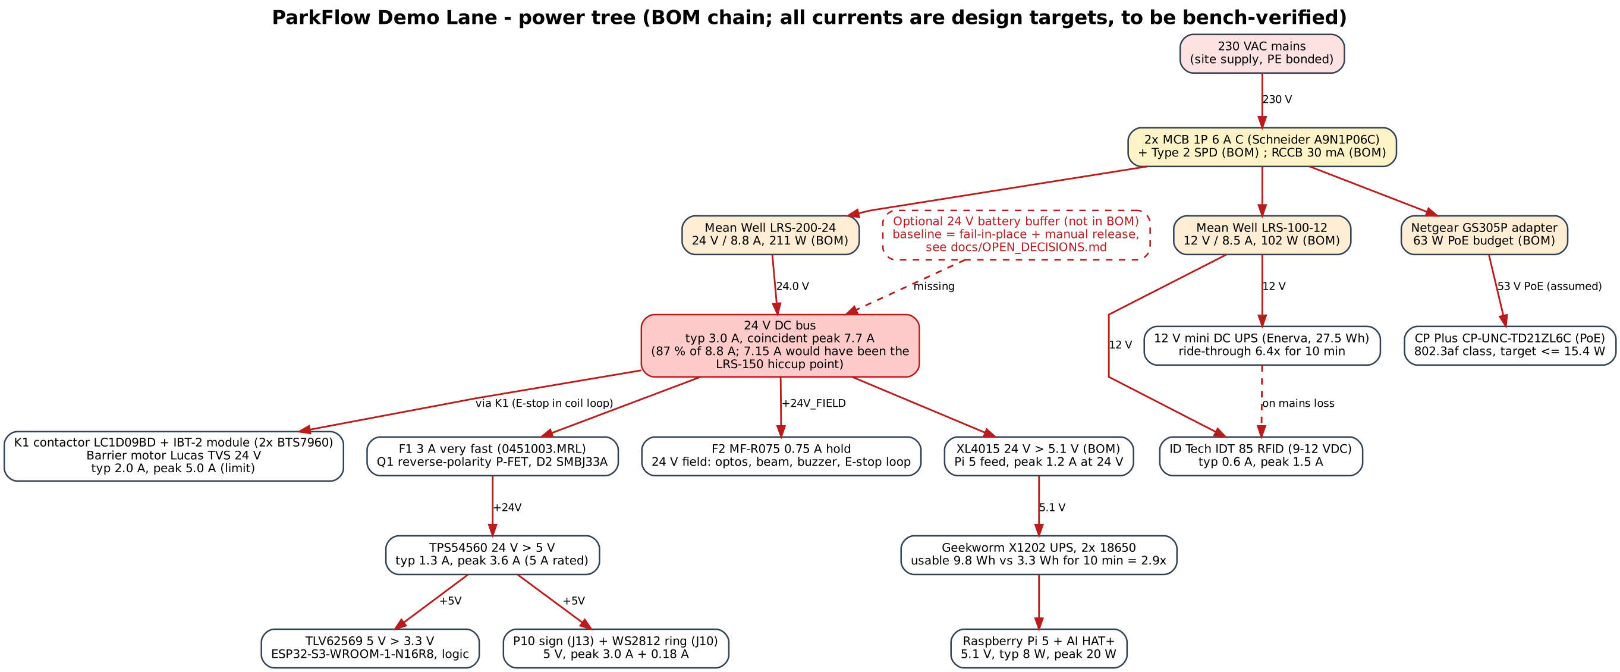
electronics/diagrams/power_tree.png
