kgchord/ParkFlow/electronics/diagrams/system_block_diagram.png

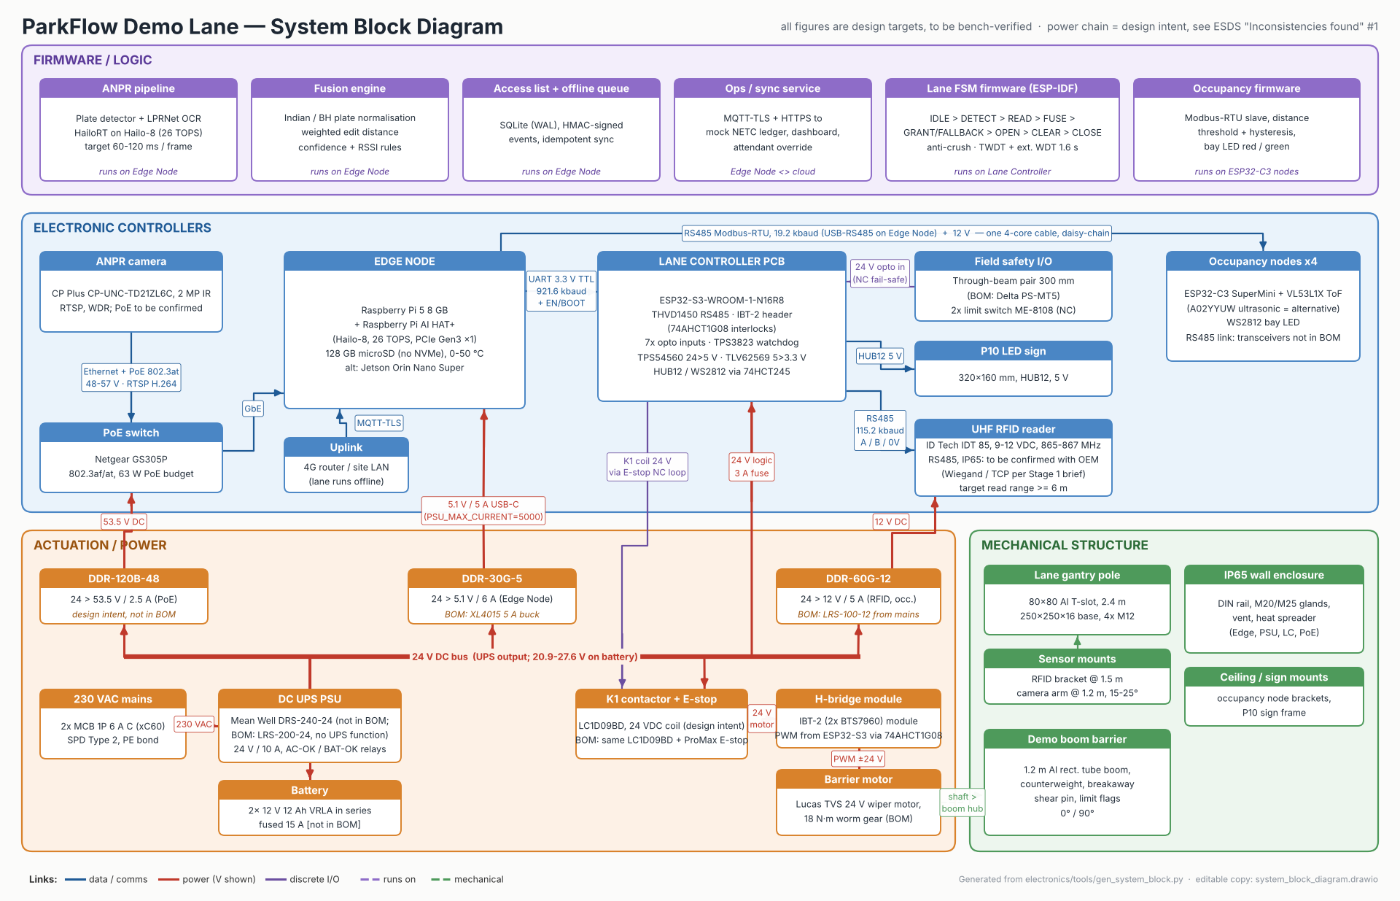
electronics/diagrams/system_block_diagram.png
