kgchord/ParkFlow/electronics/kicad/board_bottom_kicad.png

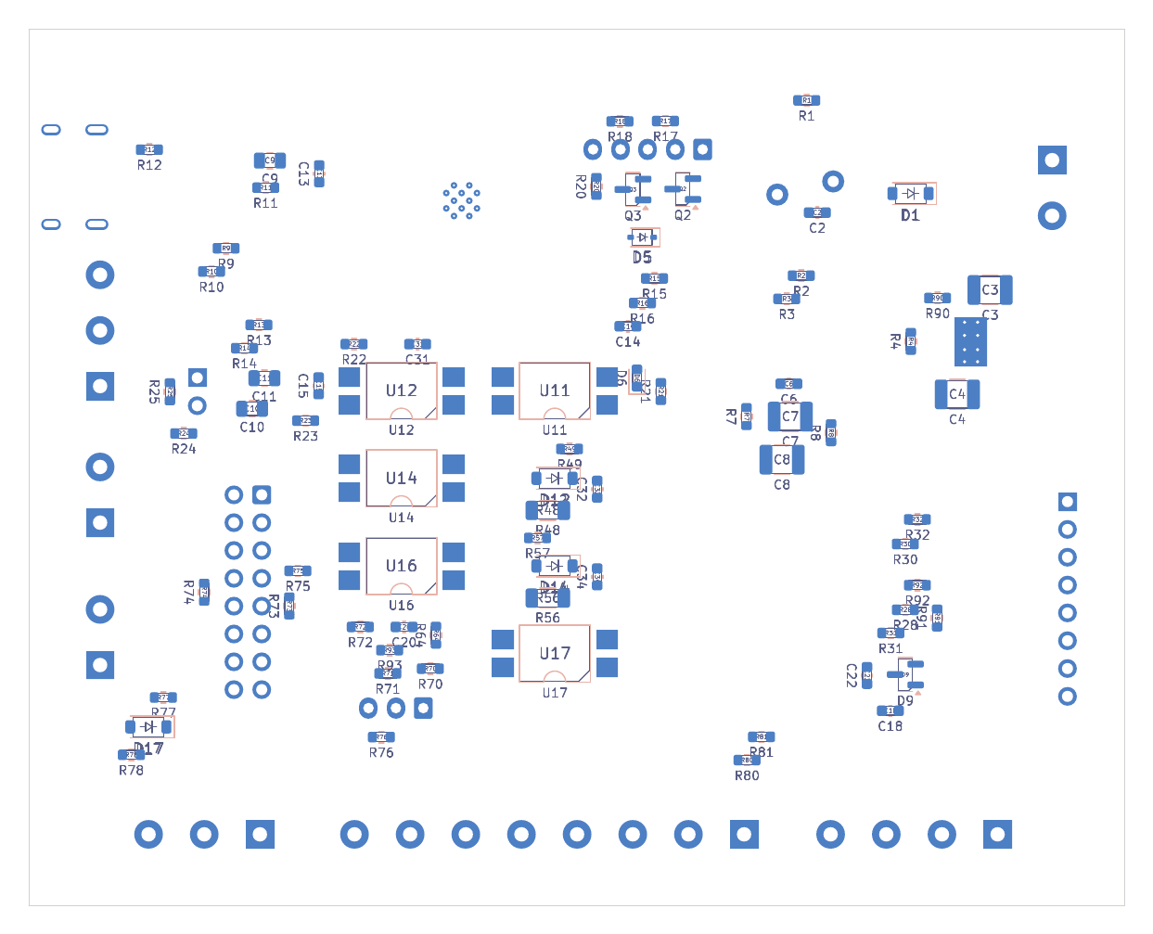
electronics/kicad/board_bottom_kicad.png
