kgchord/ParkFlow/electronics/kicad/board_placement_ratsnest.png

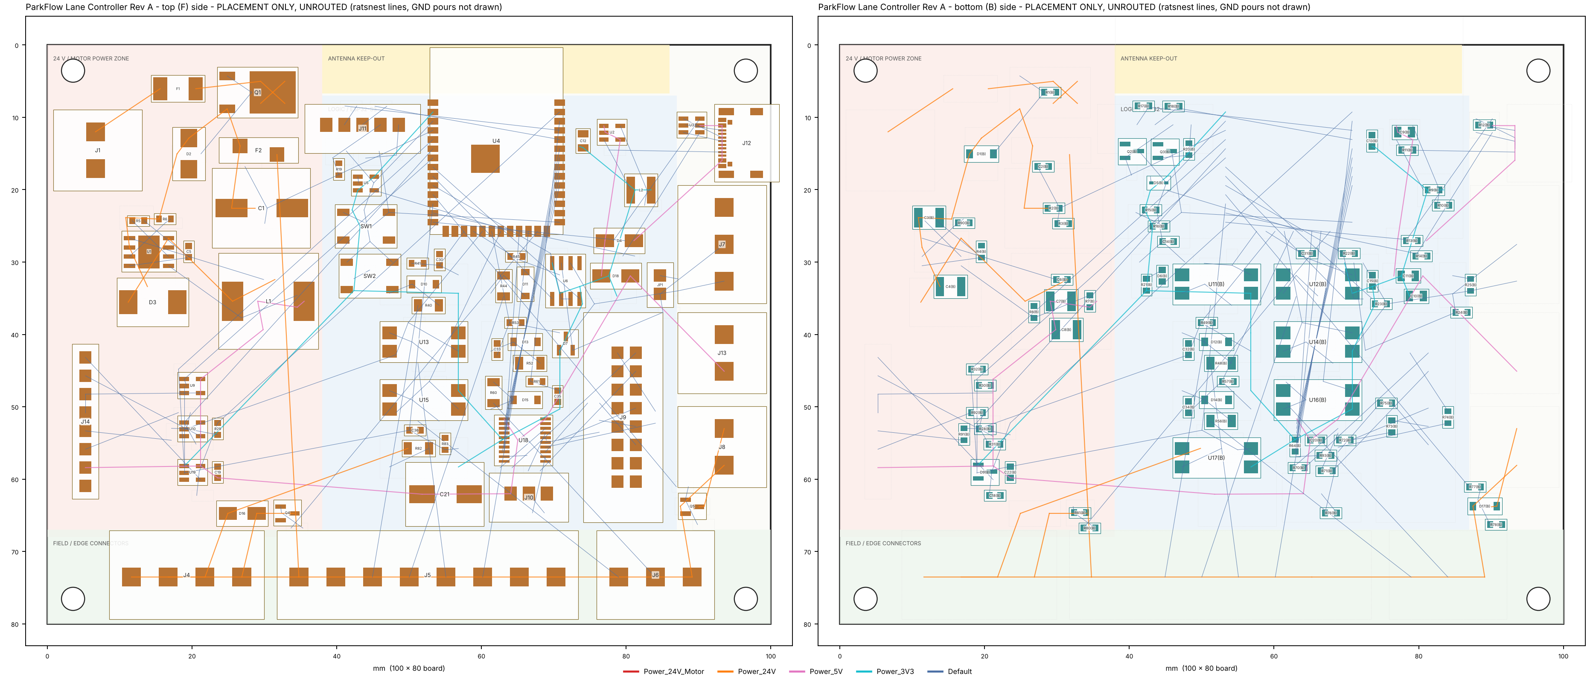
electronics/kicad/board_placement_ratsnest.png
