kgchord/ParkFlow/electronics/kicad/board_top_kicad.png

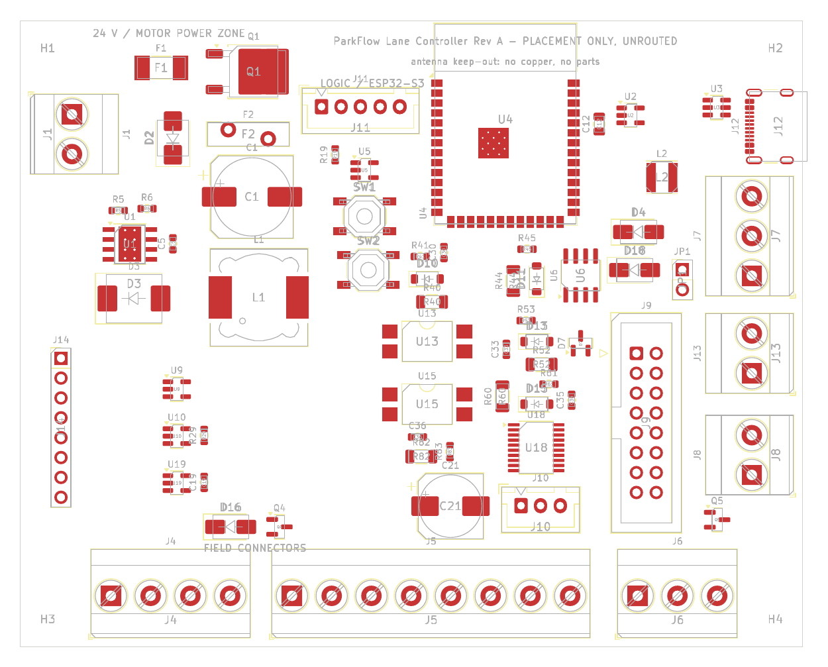
electronics/kicad/board_top_kicad.png
