kgchord/ParkFlow/electronics/kicad/lane_controller_sheet.png

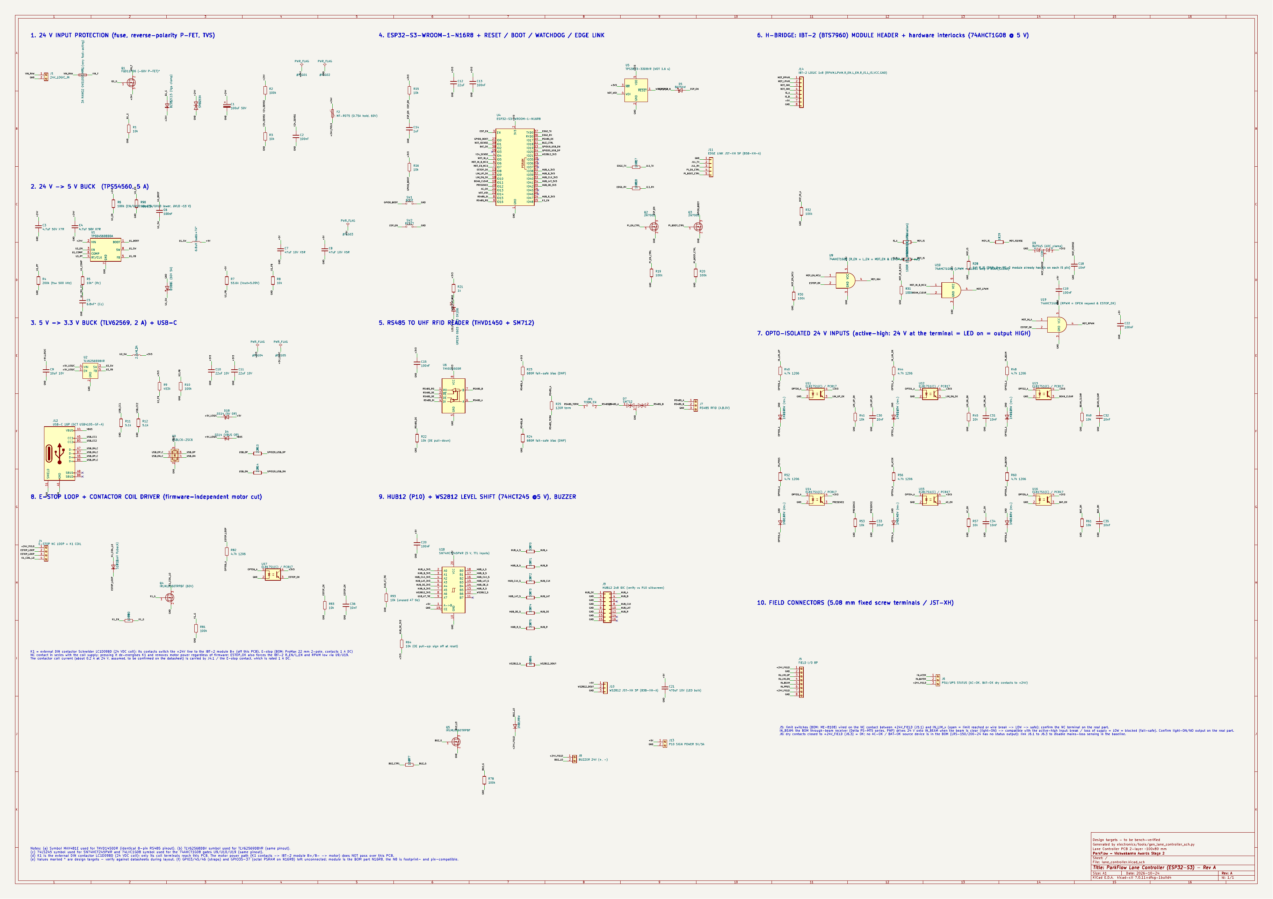
electronics/kicad/lane_controller_sheet.png
