kgchord/ParkFlow/bom/ParkFlow_BOM.xlsx

Sheet: BOM
Subsystem | Component | Exact part / spec | Qty | Unit cost (INR) | Line total (INR, formula) | Est. (INR) - ESTIMATE range | Vendor | Vendor city | Sourcing flag | Lead time (days) | Product URL | Alt vendor | Notes | Price evidence | Checked on | Est. low (INR) | Est. high (INR)
Edge Node | Raspberry Pi 5 8GB | Raspberry Pi 5 Model B, BCM2712, 8GB LPDDR4X | 1 | ₹22499.00 | ₹22499.00 |  | Probots (Probots Technologies) | Bengaluru (Nagarbhavi; contact page) | Domestic | 4 | https://probots.co.in/raspberry-pi-5-model-b-bcm2712-arm-cortex-a76-8gb-ram-2-4ghz-single-board-computer.html | Robocraze, Bengaluru: Rs 19,999 incl GST (SOLD OUT 24-Oct) https://robocraze.com/products/raspberry-pi-5-8gb ; element14 India Rs 16,717.93 (GST n/s, ships from SG/UK stock, 3-6 business days - IMPORTED shipment) | Listed Rs 22,499.00 incl GST. In stock. Approved-reseller status of Probots not verified. Hubtronics (Rs 20,765) rejected: Pune. | Product page | 2026-10-25 | ₹0.00 | ₹0.00
Edge Node | Raspberry Pi AI HAT+ 26 TOPS | Raspberry Pi AI HAT+ (Hailo-8, 26 TOPS), PCIe Gen3 x1 | 1 | ₹14999.00 | ₹14999.00 |  | Probots (Probots Technologies) | Bengaluru (Nagarbhavi; contact page) | Domestic | 4 | https://probots.co.in/official-raspberry-pi-ai-hat-26-tops.html | Robocraze, Bengaluru: Rs 11,309 incl GST (SOLD OUT 24-Oct) https://robocraze.com/products/official-raspberry-pi-ai-hat-26-tops | Listed Rs 14,999.00 incl GST. In stock. Hubtronics (Rs 10,989, OOS) rejected: Pune. Uses the Pi 5's only PCIe lane, so boot media is microSD (no NVMe). | Product page | 2026-10-25 | ₹0.00 | ₹0.00
Edge Node | Active cooler | Official Raspberry Pi 5 Active Cooler (heatsink + PWM fan) | 1 | ₹749.00 | ₹749.00 |  | Probots (Probots Technologies) | Bengaluru (Nagarbhavi; contact page) | Domestic | 4 | https://probots.co.in/official-raspberry-pi-5-active-cooler-heatsink-fan.html | No 2nd allowed-city vendor verified (Hubtronics Rs 560 is Pune) | Listed Rs 749.00 incl GST. In stock. Design note (25 Oct): sits inside the sealed box and circulates the internal air; it does not remove heat from the box (CALCS section 5). | Product page | 2026-10-25 | ₹0.00 | ₹0.00
Edge Node | microSD card 128GB | SanDisk 128GB microSDXC (A1/A2 class to confirm at checkout) | 1 | ₹2725.00 | ₹2725.00 |  | Robocraze (TIF Labs Pvt Ltd) | Bengaluru (Kalyan Nagar warehouse; contact page) | Domestic | 4 | https://robocraze.com/search?q=sandisk | Robocraze SanDisk Extreme 128GB A2 Rs 3,643 (sold out) | Listed Rs 2,725.00 incl GST. Shown as add-to-cart on search page; >=64GB requirement met. | Store/category listing page | 2026-10-24 | ₹0.00 | ₹0.00
Edge Node | USB-C PSU (bench / commissioning) | Raspberry Pi 27W USB-C PSU 5.1V 5A, white, IN plug | 1 | ₹1749.00 | ₹1749.00 |  | Probots (Probots Technologies) | Bengaluru (Nagarbhavi; contact page) | Domestic | 4 | https://probots.co.in/raspberry-pi-27w-usb-c-power-supply-white-in-plug.html | Robocraze: Rs 1,254 (white) on search page, stock not shown | Listed Rs 1,749.00 incl GST. In stock. Bench use; in the enclosure the Pi is fed by the 24V->5V buck below. | Product page | 2026-10-25 | ₹0.00 | ₹0.00
Edge Node | 24V->5.1V 5A buck (Pi 5 feed in enclosure) | XL4015 step-down, 4-38V in, 1.25-36V out, 5A max | 1 | ₹299.00 | ₹299.00 |  | Probots (Probots Technologies) | Bengaluru (Nagarbhavi; contact page) | Domestic | 4 | https://probots.co.in/xl4015-step-down-buck-converter-adjustable-max-output-36v-5a.html | Thingbits / Robocraze equivalents (not priced) | Listed Rs 299.00 incl GST. In stock. 5A is the module's max: derate and add heatsink, target to be bench-verified. A Mean Well DC-DC 5V module would be the industrial option (quote). | Product page | 2026-10-25 | ₹0.00 | ₹0.00
Edge Node | Pi 5 UPS module (>=10 min ride-through) | Geekworm X1202 UPS HAT for Raspberry Pi 5 (18650 based, 5.1 V 5 A output) | 1 | quote needed | ₹0.00 | 4,599-4,599 (line) | Probots (Probots Technologies) | Bengaluru (Nagarbhavi; contact page) | Domestic | 4 | https://probots.co.in/metal-case-raspberry-pi-5-x1202-ups-board.html | Geekworm X1202 (Robu.in - Pune, rejected); quote from Robocraze/Thingbits | 25-Oct: the 24-Oct figure of Rs 4,599 came from a related-products block and was labelled 'Waveshare'. The Probots page checked on 25-Oct is the Geekworm X1202-C1 metal case at Rs 2,649 incl GST (in stock); it does not show a Rs 4,599 UPS board. Rs 4,599 is kept only as the budget placeholder until a quote or the board's own product page is seen. Geekworm sells the X1202 as a 4-cell board; Probots says 2 cells. UPS covers the Pi only (not the PoE switch or camera). Ride-through time is a target, to be bench-verified. Limitation (25 Oct): the PoE switch and camera have no UPS, so ANPR is lost on a mains outage while the Pi and RFID reader keep running (docs/OPEN_DECISIONS.md D3). | ESTIMATE - quote needed | 2026-10-25 | ₹4599.00 | ₹4599.00
Edge Node | 18650 Li-ion cells for UPS module | Protected 18650, 2500-3000 mAh (2 per Probots X1202 page; Geekworm describes a 4-cell board: confirm count) | 2 | quote needed | ₹0.00 | 500-900 (line) | Probots (Probots Technologies) | Bengaluru (Nagarbhavi; contact page) | Domestic | 7 |  | Thingbits, Mumbai | Not priced: quote needed. | ESTIMATE - quote needed | 2026-10-24 | ₹500.00 | ₹900.00
Edge Node | SUBTOTAL - Edge Node |  |  |  | ₹43020.00 |  |  |  |  | 7 |  |  |  |  |  | ₹5099.00 | ₹5499.00
Lane Controller PCB | MCU module | Espressif ESP32-S3-WROOM-1-N16R8 (16MB flash, 8MB PSRAM) | 2 | ₹1010.63 | ₹2021.26 |  | LionCircuits | Bengaluru (080 phone; Karnataka facility) - address not on site, confirm | Domestic | 10 | https://lioncircuits.com/parts/ESP32-S3-WROOM-1-N16R8 | Probots ESP32-S3 N16R8 dev board Rs 1,299 incl GST (bench firmware) https://probots.co.in/esp32-s3-wroom-1-n16r8-development-board-wireless-module-wifi-bluetooth.html | Listed Rs 856.47; GST not stated, +18% applied (conservative). Qty 1 + 1 spare. Ships in 7-10 days (stated). Page text says '6MB Quad SPI', confirm flash size. | Product page | 2026-10-25 | ₹0.00 | ₹0.00
Lane Controller PCB | RS485 transceiver | Maxim MAX3485ESA+T, 3.3V, SOIC-8, 10 Mbps | 0 | ₹1100.09 | ₹0.00 |  | LionCircuits | Bengaluru (080 phone; Karnataka facility) - address not on site, confirm | Domestic | 10 | https://lioncircuits.com/parts/MAX3485ESA+T | Probots UART TTL-RS485 auto-flow module PRO2056 Rs 399 incl GST https://probots.co.in/uart-ttl-to-rs485-serial-converter.html | SUPERSEDED 25 Oct: the schematic uses TI THVD1450DR (see the line 'Schematic parts not otherwise listed'). Qty set to 0; the priced MAX3485ESA is kept visible for reference only. Original note: Listed Rs 932.28; GST not stated, +18% applied (conservative). Qty 1 + 1 spare. Ships in 7-10 days (stated). | Product page | 2026-10-24 | ₹0.00 | ₹0.00
Lane Controller PCB | RS485 TVS | Semtech SM712.TCT, asymmetric 12V/7V TVS, SOT-23, 400W | 2 | ₹196.53 | ₹393.06 |  | LionCircuits | Bengaluru (080 phone; Karnataka facility) - address not on site, confirm | Domestic | 10 | https://lioncircuits.com/parts/SM712.TCT |  | Listed Rs 166.55; GST not stated, +18% applied (conservative). Ships in 7-10 days (stated). | Product page | 2026-10-24 | ₹0.00 | ₹0.00
Lane Controller PCB | H-bridge motor driver | BTS7960 43A dual half-bridge module (IBT-2) | 1 | ₹699.00 | ₹699.00 |  | Probots (Probots Technologies) | Bengaluru (Nagarbhavi; contact page) | Domestic | 4 | https://probots.co.in/bts7960-43a-stepper-motor-driver-h-bridge-high-power-module-motor-control.html | Thingbits, Mumbai: Rs 251.34 incl GST (SOLD OUT) https://www.thingbits.in/products/bts7960-43a-h-bridge-motor-driver | Listed Rs 699.00 incl GST. In stock. ONE DESIGN (25 Oct): the schematic now uses this IBT-2 module (2x BTS7960, 5.5-27 V motor supply, so 24 V is inside its range; the former BTN8982TA pair is gone). Only its 8 logic pins reach the PCB (header J14); the module's B+/B-/M+/M- terminals are wired directly: contactor K1 contacts -> B+/B-, motor -> M+/M-. Add 470 uF 50 V + SMCJ28A across B+/B- at the module (in the misc line). Logic is 5 V (on-board buffer); the PCB level-shifts with 74AHCT1G08. Module IS pins have a 1k to GND each. Thingbits Mumbai Rs 251.34 was sold out. | Product page | 2026-10-25 | ₹0.00 | ₹0.00
Lane Controller PCB | 24V->5V buck (logic rail) | XL4015 step-down, 5A max | 0 | ₹299.00 | ₹0.00 |  | Probots (Probots Technologies) | Bengaluru (Nagarbhavi; contact page) | Domestic | 4 | https://probots.co.in/xl4015-step-down-buck-converter-adjustable-max-output-36v-5a.html |  | SUPERSEDED 25 Oct: the schematic uses a TPS54560BDDA 5 A buck on the PCB (parts in the line 'Schematic parts not otherwise listed'). Qty set to 0. The XL4015 modules on the P10 and Edge lines are separate. Original note: Listed Rs 299.00 incl GST. In stock. | Product page | 2026-10-25 | ₹0.00 | ₹0.00
Lane Controller PCB | 3.3V regulator | Diodes AP2112K-3.3TRG1 LDO 600mA SOT-23-5 | 0 | ₹21.33 | ₹0.00 |  | LionCircuits | Bengaluru (080 phone; Karnataka facility) - address not on site, confirm | Domestic | 10 | https://lioncircuits.com/parts/AP2112K-3.3TRG1 |  | SUPERSEDED 25 Oct: the schematic uses a TLV62569DBVR 2 A buck (the 600 mA LDO was marginal for ESP32-S3 Wi-Fi peaks). Qty set to 0. Original note: Listed Rs 18.08; GST not stated, +18% applied (conservative). Lowest tier is 10 pcs. 600mA is tight for ESP32-S3 Wi-Fi peaks: bench-verify, or switch to a 1A LDO. | Product page | 2026-10-24 | ₹0.00 | ₹0.00
Lane Controller PCB | Optocouplers | PC817C 4-SMD (limit switches, photo-beam, E-stop sense) | 10 | ₹4.24 | ₹42.40 |  | LionCircuits | Bengaluru (080 phone; Karnataka facility) - address not on site, confirm | Domestic | 10 | https://lioncircuits.com/parts/PC817C |  | Listed Rs 3.59; GST not stated, +18% applied (conservative). | Product page | 2026-10-24 | ₹0.00 | ₹0.00
Lane Controller PCB | Screw terminals | 2-pin fixed screw terminal block, 5.08mm pitch | 12 | ₹15.00 | ₹180.00 |  | Probots (Probots Technologies) | Bengaluru (Nagarbhavi; contact page) | Domestic | 4 | https://probots.co.in/2-pin-fixed-screw-terminal-block-connector-5-08mm.html |  | Listed Rs 15.00 incl GST. In stock. | Product page | 2026-10-24 | ₹0.00 | ₹0.00
Lane Controller PCB | Buzzer | Piezo buzzer B-27, 3-24V continuous | 1 | ₹49.00 | ₹49.00 |  | Probots (Probots Technologies) | Bengaluru (Nagarbhavi; contact page) | Domestic | 4 | https://probots.co.in/piezo-electric-buzzer-alarm-3v-24v-continuous-b27.html |  | Listed Rs 49.00 incl GST. Price seen on Probots listing grid. | Store/category listing page | 2026-10-24 | ₹0.00 | ₹0.00
Lane Controller PCB | Status RGB LED | WS2812 12-LED ring board | 1 | ₹149.00 | ₹149.00 |  | Probots (Probots Technologies) | Bengaluru (Nagarbhavi; contact page) | Domestic | 4 | https://probots.co.in/rgb-led-12-bit-ws2812-circular-development-board.html |  | Listed Rs 149.00 incl GST. In stock. | Product page | 2026-10-24 | ₹0.00 | ₹0.00
Lane Controller PCB | PCB fabrication | 2-layer FR4 ~100x80 mm, 5 pcs (1 lot) | 1 | ₹942.82 | ₹942.82 |  | LionCircuits | Bengaluru (080 phone; Karnataka facility) - address not on site, confirm | Domestic | 9 | https://lioncircuits.com/ | Quote also from another Bengaluru/Delhi fab | Listed Rs 799.00; GST not stated, +18% applied (conservative). Advertised '5 boards for Rs 799 in 5-6 days'. Final price depends on size/spec quote. Lead time = 5-6 days + about 3 days shipping. | Vendor homepage offer | 2026-10-24 | ₹0.00 | ₹0.00
Lane Controller PCB | Misc passives & connectors | R/C 0805, electrolytics, ferrites, SMBJ33A on 24V, headers, JST, RJ45/RS485 connector, polyfuse | 1 | quote needed | ₹0.00 | 800-1,500 (line) | LionCircuits | Bengaluru (080 phone; Karnataka facility) - address not on site, confirm | Domestic | 10 | https://lioncircuits.com/ | Probots | Quote needed. One lot. Now also covers: 470 uF 50 V low-ESR + SMCJ28A at the IBT-2 module terminals, 1x8 2.54 mm header for J14, 2x SM712-class TVS spares, ferrites, JST-XH, RJ45/Cat6 (see spec). Range unchanged from 24 Oct: re-quote. | ESTIMATE - quote needed | 2026-10-24 | ₹800.00 | ₹1500.00
Lane Controller PCB | Schematic parts not otherwise listed | TI THVD1450DR RS485 (replaces MAX3485ESA); TPS54560BDDA 5 A buck + 6.8 uH inductor + B560C + FQD11P06 reverse-polarity FET (replaces XL4015 on the PCB); TLV62569DBVR 3.3 V buck + 2.2 uH (replaces AP2112K); TPS3823-33DBVR watchdog; 3x 74AHCT1G08 (U9, U10, U19); SN74HCT245PWR; USBLC6-2SC6; GCT USB4105 USB-C; 2x 2N7002; 2x IRLML0060; BAT54/SS14/S1M/1N4148W diodes; 3 A nano fuse + MF-R075 polyfuse | 1 | quote needed | ₹0.00 | 2,500-5,000 (line) | LionCircuits | Bengaluru (080 phone; Karnataka facility) - address not on site, confirm | Domestic | 10 |  | LCSC-type parts are not an allowed source (non-Indian); Robocraze/Probots for modules only | ESTIMATE added 25 Oct. ESDS section 11 item 2: the BOM listed MAX3485ESA, XL4015 and AP2112K while the schematic uses other parts. These schematic-only parts have no vendor page opened. The range is a placeholder sized from the three superseded lines (Rs 2,712 priced) plus about 25 small parts; get a LionCircuits (or Delhi/Bengaluru distributor) quote against the generated netlist before ordering. | ESTIMATE - quote needed | 2026-10-25 | ₹2500.00 | ₹5000.00
Lane Controller PCB | SUBTOTAL - Lane Controller PCB |  |  |  | ₹4476.54 |  |  |  |  | 10 |  |  |  |  |  | ₹3300.00 | ₹6500.00
UHF RFID Reader | UHF integrated reader | ID Tech IDT 85 mid-range UHF reader, 865-867 MHz, up to 8 m. IndustryBuying lists Wiegand + RS232 only; TradeIndia lists RS232/RS485/TCP-IP/Wiegand 26/34 and IP65. RS485, IP rating and EPC Gen2 to be confirmed in writing | 1 | ₹25959.00 | ₹25959.00 |  | ID Tech Solutions Pvt Ltd (OEM); price ref. IndustryBuying | Gurugram (Plot 610, Udyog Vihar Ph V; TradeIndia) | Local-Delhi NCR | 6 | https://www.industrybuying.com/card-reader-id-tech-ITE.CAR.38552208 (https://m.indiamart.com/ecotracksystems/profile.html) | Eco Track Systems, New Delhi: 'RFID Integrated Reader 6 Meters' Rs 10,000 (GST n/s; interfaces not listed; the seller's page gives the UHF band as 865-928 MHz, so India-band compliance is unconfirmed) https://m.indiamart.com/ecotracksystems/integrated-reader.html | Listed Rs 25,959.00 incl GST. 'Ships within 3 days' (stated). OEM's TradeIndia listing shows about Rs 14,000 (approx), so a direct quote may cut this line by about 45%. 25-Oct re-check of the IndustryBuying page: price Rs 25,959 unchanged; interfaces Wiegand + RS232 (no RS485); IP rating not listed; 9 V DC supply; -10 to 50 C operating temperature; RF output up to 30 dBm adjustable; fixed-frequency emission mode within 865-867 MHz. Ask ID Tech for: RS485 variant, WPC ETA certificate, India channel plan (865.7/866.3/866.9/867.5 MHz under G.S.R. 853(E)) and how e.r.p. is kept at or below 2 W with the built-in antenna. | Product page | 2026-10-25 | ₹0.00 | ₹0.00
UHF RFID Reader | UHF test tags | UHF RFID windshield tags (bench tests; the live demo uses a real FASTag) | 10 | ₹14.16 | ₹141.60 |  | Eco Track Systems | New Delhi (IndiaMART profile, GST 07AAFFE8904J2Z8) | Local-Delhi NCR | 3 | https://m.indiamart.com/ecotracksystems/profile.html |  | Listed Rs 12.00; GST not stated, +18% applied (conservative). Listed per piece on IndiaMART profile as 'RFID Windshield Tag' (UHF/EPC Gen2 not stated on the page): confirm UHF 865-867 MHz EPC Gen2 before buying. | Store/category listing page | 2026-10-25 | ₹0.00 | ₹0.00
UHF RFID Reader | SUBTOTAL - UHF RFID Reader |  |  |  | ₹26100.60 |  |  |  |  | 6 |  |  |  |  |  | ₹0.00 | ₹0.00
ANPR Camera | ANPR camera 2MP IR | CP Plus CP-UNC-TD21ZL6C-VMDS 2MP bullet, 2.7-13.5mm motorized, 120dB WDR, 60m IR, IP67 | 1 | ₹4071.00 | ₹4071.00 |  | Secure Bazaar (IndiaMART) | Chennai (ships from Chennai) | Domestic | 7 | https://m.indiamart.com/proddetail/cp-plus-cp-unc-td21zl6c-vmds-bullet-camera-2854862398948.html | Deot International, New Delhi: Hikvision DS-2CD1023G0E-I 2MP IR fixed bullet Rs 3,350 excl GST (Rs 3,953) https://m.indiamart.com/proddetail/hikvision-ds-2cd1023g0e-i-2-mp-ir-fixed-network-bullet-camera-22509971212.html | Listed Rs 3,450.00 excl GST; +18% GST applied. 25-Oct re-check: price Rs 3,450 excl GST unchanged, in stock, seller Secure Bazaar, Chennai. The spec table says 'Analog Camera' although the title says Network Camera. PoE, ONVIF/RTSP and the IR wavelength (850 nm required) are NOT stated; shutter is listed as 1/100000 s (implausible, treat as maximum). Get written confirmation of PoE, RTSP and 850 nm IR before payment; if 12V-only, add a PoE splitter. | Product page | 2026-10-25 | ₹0.00 | ₹0.00
ANPR Camera | SUBTOTAL - ANPR Camera |  |  |  | ₹4071.00 |  |  |  |  | 7 |  |  |  |  |  | ₹0.00 | ₹0.00
PoE Switch | PoE switch | Netgear GS305P 5-port Gigabit unmanaged PoE | 1 | ₹5310.00 | ₹5310.00 |  | Accruepole Pvt Ltd (IndiaMART) | Mumbai (Kandivali East; ships from Mumbai) | Domestic | 7 | https://m.indiamart.com/proddetail/5-port-gigabit-ethernet-poe-unmanaged-switch-gs305p-netgear-2856793072391.html | Gigalink Technologies, Mumbai (Andheri E): Netgear 8-port, 4xPoE 53W Rs 4,200 excl GST https://m.indiamart.com/proddetail/8-port-gigabit-ethernet-plus-with-4-ports-poe-53w-24243207948.html ; PrimeABGB, Lamington Rd Mumbai: Cadyce CA-PS800 Rs 4,118 | Listed Rs 4,500.00 excl GST; +18% GST applied. PoE budget and input voltage not on listing (the box includes its own DC adapter, so this switch runs from mains through its adapter, not from the 12 V rail): confirm budget >= camera + spare. The alt listing's model name is inconsistent (GS308PP vs GS108PE). | Product page | 2026-10-25 | ₹0.00 | ₹0.00
PoE Switch | SUBTOTAL - PoE Switch |  |  |  | ₹5310.00 |  |  |  |  | 7 |  |  |  |  |  | ₹0.00 | ₹0.00
Occupancy Nodes x4 | Node MCU | ESP32-C3 SuperMini (RISC-V, USB-C) | 4 | ₹242.00 | ₹968.00 |  | Probots (Probots Technologies) | Bengaluru (Nagarbhavi; contact page) | Domestic | 4 | https://probots.co.in/esp32-c3-supermini-wifi-bluetooth-development-board-32-bit-risc-v-uart-i2c-spi.html (https://probots.co.in/vl53l1x-tof-laser-ranging-sensor-module.html) | Probots ESP32-C3-Mini-1 dual USB-C board Rs 999 | Listed Rs 242.00 incl GST. Page shows in stock, but metadata says OOS: confirm. | Product page | 2026-10-25 | ₹0.00 | ₹0.00
Occupancy Nodes x4 | Distance sensor | VL53L1X ToF laser ranging module (up to 4 m) | 4 | ₹799.00 | ₹3196.00 |  | Probots (Probots Technologies) | Bengaluru (Nagarbhavi; contact page) | Domestic | 14 | https://probots.co.in/vl53l1x-tof-laser-ranging-sensor-module.html (https://probots.co.in/rgb-led-12-bit-ws2812-circular-development-board.html) | Thingbits, Mumbai: DFRobot A02YYUW waterproof ultrasonic Rs 1,698.02 incl GST (SOLD OUT) https://thingbits.in/products/a02yyuw-waterproof-ultrasonic-sensor | Listed Rs 799.00 incl GST. OUT OF STOCK 24-Oct: 14-day lead time is an assumption. Two other Probots VL53L1X listings exist (unpriced). | Product page | 2026-10-25 | ₹0.00 | ₹0.00
Occupancy Nodes x4 | Bay LED | WS2812 12-LED ring | 4 | ₹149.00 | ₹596.00 |  | Probots (Probots Technologies) | Bengaluru (Nagarbhavi; contact page) | Domestic | 4 | https://probots.co.in/rgb-led-12-bit-ws2812-circular-development-board.html |  | Listed Rs 149.00 incl GST. In stock. | Product page | 2026-10-24 | ₹0.00 | ₹0.00
Occupancy Nodes x4 | Node 5V supply | 5V 2A USB adapter + cable per node | 4 | quote needed | ₹0.00 | 800-1,400 (line) | Local market (Delhi NCR) | Delhi NCR | Local-Delhi NCR | 3 |  |  | Not priced: quote needed (about Rs 200-350 each). | ESTIMATE - quote needed | 2026-10-24 | ₹800.00 | ₹1400.00
Occupancy Nodes x4 | SUBTOTAL - Occupancy Nodes x4 |  |  |  | ₹4760.00 |  |  |  |  | 14 |  |  |  |  |  | ₹800.00 | ₹1400.00
P10 LED Sign | P10 outdoor LED module | P10 red SMD outdoor module 320x160 mm, 32x16, HUB12 | 1 | ₹699.00 | ₹699.00 |  | Probots (Probots Technologies) | Bengaluru (Nagarbhavi; contact page) | Domestic | 14 | https://probots.co.in/p10-red-smd-outdoor-led-display-module-160x320mm.html (https://probots.co.in/w00-led-display-single-colour-wifi-controller-card-hd.html) | Pixel Led Pvt Ltd, Navi Mumbai (Airoli): outdoor P10 red Rs 340 excl GST (Rs 401.20) https://m.indiamart.com/proddetail/outdoor-p10-red-led-display-module-21357608312.html | Listed Rs 699.00 incl GST. OUT OF STOCK 24-Oct, so the alt vendor (1-week delivery stated) is the likely buy. | Product page | 2026-10-25 | ₹0.00 | ₹0.00
P10 LED Sign | P10 controller (fallback) | Huidu HD-W00 single-colour Wi-Fi LED controller | 1 | ₹538.00 | ₹538.00 |  | Probots (Probots Technologies) | Bengaluru (Nagarbhavi; contact page) | Domestic | 14 | https://probots.co.in/w00-led-display-single-colour-wifi-controller-card-hd.html (https://probots.co.in/xl4015-step-down-buck-converter-adjustable-max-output-36v-5a.html) | Quote: Nehru Place LED dealers | Listed Rs 538.00 incl GST. OUT OF STOCK. The primary drive is HUB12 from the Lane PCB; this card is a fallback. | Product page | 2026-10-24 | ₹0.00 | ₹0.00
P10 LED Sign | P10 5V supply | XL4015 24V->5V buck, 5A max | 1 | ₹299.00 | ₹299.00 |  | Probots (Probots Technologies) | Bengaluru (Nagarbhavi; contact page) | Domestic | 4 | https://probots.co.in/xl4015-step-down-buck-converter-adjustable-max-output-36v-5a.html |  | Listed Rs 299.00 incl GST. In stock. | Product page | 2026-10-25 | ₹0.00 | ₹0.00
P10 LED Sign | SUBTOTAL - P10 LED Sign |  |  |  | ₹1536.00 |  |  |  |  | 14 |  |  |  |  |  | ₹0.00 | ₹0.00
Barrier Drive | 24V geared DC motor | Lucas TVS wiper motor assembly 24V, 18 Nm (model 26971117A), worm-geared | 1 | ₹944.00 | ₹944.00 |  | Moglix (Lucas TVS packer: Shahdara, New Delhi) | New Delhi (packer address) - Moglix dispatch city not verified | Local-Delhi NCR | 7 | https://www.moglix.com/lucas-tvs-wiper-motor-assembly-24-v-18-nm-for-hindustan-72-71b-front-end-loader-front-screentriv-luc-tsrxs6/mp/msnl5gln362yk4 (https://probots.co.in/rotary-adjustable-roller-micro-limit-switch-me-8108.html) | Probots, Bengaluru: 6280 24V 30rpm reversible worm, self-locking, 48 kg-cm (~4.7 Nm) Rs 9,999 incl GST, in stock https://probots.co.in/6280-24v-30rpm-reversible-worm-gear-high-torque-self-locking-motor-left.html | Listed Rs 944.00 incl GST. 'AVAILABLE ON REQUEST' (stock not confirmed; dispatch city still not shown). RPM, rated vs stall torque, duty, stall current and self-locking are NOT listed. DECISION 25 Oct (cad/calcs/CALCS.md section 4): accepted as a DEMO motor only. The requirement is 11.6 N.m at a 15 m/s operating wind (margin 1.56), so the demo rule is: move the boom only in wind <= 12 m/s (margin 2.2). Still-air requirement 2.1 N.m. Self-locking is NOT assumed; storm survival (93 N.m raised-boom gust) is carried by a storm-lock pin, not by this gearbox. A 15 m/s / production rating needs a >= 30 N.m self-locking gearmotor with a datasheet (not found at an allowed seller; the Probots 6280 and 5840 worm motors are 4.4-35 kg.cm; see docs/OPEN_DECISIONS.md D1). The 5840-31ZY page (Rs 1,799, 45 kg.cm, 10 rpm, out of stock) is 4.4 N.m and far below the need. | Product page | 2026-10-25 | ₹0.00 | ₹0.00
Barrier Drive | Limit switches | ME-8108 rotary adjustable roller limit switch | 2 | ₹399.00 | ₹798.00 |  | Probots (Probots Technologies) | Bengaluru (Nagarbhavi; contact page) | Domestic | 4 | https://probots.co.in/rotary-adjustable-roller-micro-limit-switch-me-8108.html (https://m.indiamart.com/proddetail/ps-mt5-usb2-delta-18mm-thru-beam-gkdp-18-3a30-pc-my3n-j-24vdc-my3n-j-12vdc-my3n-j-110vac-pyf11a-e-26029950830.html) | Probots micro limit roller switch Rs 69 (OOS) | Listed Rs 399.00 incl GST. In stock. Positions: 0 deg and 90 deg. 25 Oct decision: these roller switches (NC contact between +24V_FIELD and the input) are the limit sensors; the M12 inductive sensors in MATERIALS are dropped. | Product page | 2026-10-25 | ₹0.00 | ₹0.00
Barrier Drive | IR photo-beam pair | Delta 18mm through-beam photoelectric (PS-MT5 series), 10-30VDC, PNP NO, 5-10 m | 2 | ₹2120.46 | ₹4240.92 |  | SBM Electric Techno Pvt Ltd (IndiaMART) | Gurugram (ships from Gurugram) | Local-Delhi NCR | 3 | https://m.indiamart.com/proddetail/ps-mt5-usb2-delta-18mm-thru-beam-gkdp-18-3a30-pc-my3n-j-24vdc-my3n-j-12vdc-my3n-j-110vac-pyf11a-e-26029950830.html (https://probots.co.in/promax-22mm-emergency-stop-switch-mushroom-head-waterproof-metal-2-pole.html) | Pioneer Enterprises, New Delhi: boom-barrier photocell 12-24VDC 20 m Rs 3,500 excl GST https://m.indiamart.com/proddetail/boom-barrier-photocell-sensor-2853343495312.html | Listed Rs 1,797.00 excl GST; +18% GST applied. Qty 2 = emitter + receiver priced per piece (conservative). Confirm whether the price covers a pair. 25-Oct: listing title mixes several models, brand field says Omron, and sensing distance is given as both 1 m and 5-10 m; it has no EN 12978 / self-test claim. 25 Oct: the PNP output is now compatible, because the schematic input was changed to active-high (24 V on the terminal = beam clear = LED on). Required receiver mode: light-ON (output driven while the beam is clear) so a cut wire or lost supply reads as blocked; confirm on the part. | Product page | 2026-10-25 | ₹0.00 | ₹0.00
Barrier Drive | E-stop | ProMax 22mm emergency-stop mushroom, metal, 2-pole (listing says 'waterproof'; IP rating not stated) | 1 | ₹899.00 | ₹899.00 |  | Probots (Probots Technologies) | Bengaluru (Nagarbhavi; contact page) | Domestic | 4 | https://probots.co.in/promax-22mm-emergency-stop-switch-mushroom-head-waterproof-metal-2-pole.html (https://probots.co.in/24v-30a-1-channel-relay-module-with-optocoupler-isolation-high-power.html) |  | Listed Rs 899.00 incl GST. Rated 1A DC (listing is inconsistent: 3 A / 10 A elsewhere on the page): it breaks the motor-relay coil / driver enable, not motor current directly. 25 Oct: now actually in the coil loop of the contactor K1 below (contacts rated 1 A DC; coil current about 0.2 A assumed, to be confirmed). | Product page | 2026-10-25 | ₹0.00 | ₹0.00
Barrier Drive | Motor power contactor K1 | Schneider Electric LC1D09BD, 3-pole TeSys D contactor, 24 VDC coil (E-stop in the coil loop; wire the three power poles in series in the +24 V motor line) | 1 | ₹1226.02 | ₹1226.02 |  | Prem Associates (IndiaMART) | New Delhi | Local-Delhi NCR | 3 | https://m.indiamart.com/proddetail/schneider-lc1d09bd-power-contactors-23214488912.html | Industricals, Mumbai: LC1D09BD Rs 1,950 excl GST https://m.indiamart.com/proddetail/schneider-9-24a-3-pole-440v-dc-contactor-lc1d09bd-18744546455.html | Listed Rs 1,039.00 excluding all taxes (seller GST-registered); +18% GST applied = Rs 1,226.02. Replaces the Rs 299 24 V relay module (PRO4603), which could not implement the E-stop coil loop (ESDS section 11 item 3). Coil power and DC-3/DC-5 contact rating are NOT on the listing: confirm on the Schneider datasheet (assumed 0.2 A coil hold, 24 V; 5 A inductive motor load across series poles). Prices and stock are not confirmed with the seller. | Store/category listing page | 2026-10-25 | ₹0.00 | ₹0.00
Barrier Drive | Presence sensor under boom (inductive loop detector) | Single-channel inductive loop detector PD132, 230 V AC 50 Hz, relay output (SAFETY F4 secondary protection); loop wire laid in the wiring line | 1 | ₹2124.00 | ₹2124.00 |  | Golf Automation Solutions Pvt Ltd (IndiaMART) | Noida | Local-Delhi NCR | 3 | https://m.indiamart.com/proddetail/loop-detector-pd132-2851226164712.html | Bharat Trade Automation, Ghaziabad: single/dual channel loop detector Rs 2,000 excl GST https://m.indiamart.com/proddetail/vehicle-loop-detector-dual-channel-21612227255.html | Listed Rs 1,800 excluding all taxes (unit not stated; seller GST-registered); +18% GST = Rs 2,124.00. Supply 230 V AC, relay output rating NOT stated: wire its dry contact between +24V_FIELD and the PRESENCE input (J5.6), and confirm the contact rating. The loop wire (about 10 m of 1.5 sq mm) and a saw-cut are in the wiring estimate. Under EN 12978 an inductive loop is outside scope, so it stays secondary protection beside the through-beam pair. | Store/category listing page | 2026-10-25 | ₹0.00 | ₹0.00
Barrier Drive | Flange bearings UCFL204 x2 | UCFL204 oval 2-bolt flange bearing unit, 20 mm bore, 2 off (MATERIALS section c, stub shaft support) | 2 | ₹236.00 | ₹472.00 |  | Arihant Enterprises (IndiaMART) | Chennai | Domestic | 5 | https://m.indiamart.com/proddetail/ucfl204-flange-block-bearing-20588331712.html | A.J. Traders, Mumbai: JSN UCFL204 Rs 115 excl GST (bore 20-40 mm range listed) https://m.indiamart.com/proddetail/ucfl-pillow-block-bearings-ucfl204-20568146348.html | Listed Rs 200 excluding all taxes per piece (brands BXY/NTN/FAG/TR listed together; bore 20 mm); +18% GST = Rs 236.00. Brand and quality are not guaranteed by a listing: ask for a branded unit if the budget allows. | Store/category listing page | 2026-10-25 | ₹0.00 | ₹0.00
Barrier Drive | Barrier drive-train machined parts | Ø20 EN8 stub shaft + 6 mm key, Ø70 6061 hub with tongue, 2x 5 mm carrier plates, bearing plate, M8 shoulder bolt, jaw coupling (MATERIALS section c) | 1 | quote needed | ₹0.00 | 1,500-3,500 (line) | Delhi NCR machine shop (to be named) | Delhi NCR | Local-Delhi NCR | 7 |  | Reliable Laser Works (Faridabad) for the plates | ESTIMATE (no vendor page): about 1.4 kg of 6061 and EN8 (STEP: stub shaft 0.39, hub 0.27, carrier 0.31, bearing plate 0.41 kg) at the Rs 318.6/kg aluminium listing price plus turning/milling/laser allowance. Quote from a machine shop. | ESTIMATE - quote needed | 2026-10-25 | ₹1500.00 | ₹3500.00
Barrier Drive | Storm-lock pin + manual-release pin | Ø10 hardened MS storm-lock pin (boom hub to frame, 93 N.m survival gust) and a lanyarded quick-release pin to disconnect the boom by hand after a power loss | 1 | quote needed | ₹0.00 | 200-600 (line) | Local hardware (Delhi NCR) | Delhi NCR | Local-Delhi NCR | 3 |  |  | ESTIMATE added 25 Oct (no vendor page). Replaces the unpriced '24 V backup for fail-open' GAP: the baseline mains-loss behaviour is fail-in-place with a hand release (docs/OPEN_DECISIONS.md D2). Not yet in the CAD. | ESTIMATE - quote needed | 2026-10-25 | ₹200.00 | ₹600.00
Barrier Drive | SUBTOTAL - Barrier Drive |  |  |  | ₹10703.94 |  |  |  |  | 7 |  |  |  |  |  | ₹1700.00 | ₹4100.00
Power & Protection | 24V SMPS | Mean Well LRS-200-24 (24V 8.8A 211.2W) | 1 | ₹2499.00 | ₹2499.00 |  | Probots (Probots Technologies) | Bengaluru (Nagarbhavi; contact page) | Domestic | 4 | https://probots.co.in/smps-metal-power-supply-24v-8-8a-211-2w-lrs-200-24-mean-well.html (https://probots.co.in/inline-5x20mm-glass-fuse-holder-with-22-awg-lead-wires-25pcs-bag.html) | Mean Well LRS-150-24 (the earlier choice) Rs 1,699 at Probots; R and D Control Systems (IndiaMART) lists Mean Well SMPS https://m.indiamart.com/r-and-d-controlsystems/switch-mode-power-supply.html | Listed Rs 2,499.00 incl GST (Rs 2,117.80 + 381.20 GST); in stock at Nagarabhavi, Bengaluru; warranty 7 days. Page also shows a conflicting 'More information' table (10-15 A, 200-300 W): the title and description say 8.8 A / 211.2 W. Replaces the LRS-150-24 (6.5 A) because the 24 V bus peak with a 6 A motor was 8.66 A (power_model.py). With the motor limited to 5 A in firmware the peak is 7.66 A = 87 % of 8.8 A (overload starts at 110 %). Convection cooled. Moves to the separate power box (CALCS section 5). Authorised-distributor status not verified. | Product page | 2026-10-25 | ₹0.00 | ₹0.00
Power & Protection | 12V SMPS | Mean Well LRS-100-12 (12V 8.5A 102W) | 1 | ₹1499.00 | ₹1499.00 |  | Probots (Probots Technologies) | Bengaluru (Nagarbhavi; contact page) | Domestic | 4 | https://probots.co.in/mean-well-smps-12v-8-5a-102w-metal-power-supply-lrs-100-12.html (https://m.indiamart.com/proddetail/surge-protection-device-2859297106848.html) | Quote: R and D Control Systems, New Delhi | Listed Rs 1,499.00 incl GST. In stock. Feeds the RFID reader, P10 controller and camera if not PoE. | Product page | 2026-10-25 | ₹0.00 | ₹0.00
Power & Protection | MCB | Schneider Acti9 xC60 A9N1P06C, 1P 6A C-curve | 2 | ₹161.66 | ₹323.32 |  | L&T-SuFin (seller: SV Nexus Enterprises) | NOT VERIFIED - seller city not shown | Domestic | 6 | https://lntsufin.com/product/schneider-electric-acti9-xc60-a9n1p06c-single-pole-6-a-c-curve-mcb/17753-69 (https://m.indiamart.com/proddetail/mini-ups-for-wifi-router-25743173988.html) | Buy over the counter at Bhagirath Palace / Lajpat Rai Market (Delhi) to satisfy the city rule: quote | Listed Rs 161.66 incl GST. Price tier shown for 10-100 pcs (possible MOQ 10, worst case +Rs 1,293). Delivery 28-30 Oct stated. Seller city unverified: RULE-1 GAP. 25 Oct: sits downstream of the RCCB below in the power box; SAFETY.md says 2-pole MCB but this is 1P: use 1P+N or confirm which conductor is switched. | Product page | 2026-10-25 | ₹0.00 | ₹0.00
Power & Protection | Fuse holders + fuses | 5x20mm panel/inline fuse holders x4 + assorted glass fuses | 1 | quote needed | ₹0.00 | 300-600 (line) | Probots (Probots Technologies) | Bengaluru (Nagarbhavi; contact page) | Domestic | 4 | https://probots.co.in/inline-5x20mm-glass-fuse-holder-with-22-awg-lead-wires-25pcs-bag.html | Delhi electrical market | Product found but price not captured: quote needed. | ESTIMATE - quote needed | 2026-10-24 | ₹300.00 | ₹600.00
Power & Protection | AC SPD | Type 2 SPD 1P+N, 40 kA Imax, In 30 kA, rated voltage 320 V (Uc not listed), Up < 1.5 kV, DIN rail, MOV | 1 | ₹295.00 | ₹295.00 |  | Samriddhi Industries (IndiaMART) | New Delhi | Local-Delhi NCR | 3 | https://m.indiamart.com/proddetail/surge-protection-device-2859297106848.html (https://probots.co.in/nickel-plated-brass-metal-cable-gland-gland-size-pg-7.html) | Quote: Delhi electrical market (OBO/Phoenix) | Listed Rs 250.00 excl GST; +18% GST applied. Unbranded: request a datasheet/test certificate. | Product page | 2026-10-25 | ₹0.00 | ₹0.00
Power & Protection | 12V mini DC UPS | Enerva mini UPS 12V, 27.5 Wh (RFID reader / LED controller ride-through) | 1 | ₹1298.00 | ₹1298.00 |  | Enervation Powertech Pvt Ltd (IndiaMART) | Noida | Local-Delhi NCR | 3 | https://m.indiamart.com/proddetail/mini-ups-for-wifi-router-25743173988.html (https://probots.co.in/nickel-plated-brass-metal-cable-gland-gland-size-pg-7.html) | Newtech Synergy Systems, Noida: mini UPS Rs 999 | Listed Rs 1,100.00; GST not stated, +18% applied (conservative). Listing says 'excluding all taxes' (18% added). Chemistry (LiFePO4?) and max output current not stated: confirm >=1.5A at 12V. 27.5 Wh at 12 V cannot drive the 24 V barrier motor; the baseline is fail-in-place with a hand release, a 24 V buffer is optional (docs/OPEN_DECISIONS.md D2). | Store/category listing page | 2026-10-25 | ₹0.00 | ₹0.00
Power & Protection | Wiring & cabling | 1.5/0.75 sq mm flexible cable, 3x Cat6 patch, ferrules, lugs, heat-shrink, cable ties | 1 | quote needed | ₹0.00 | 1,500-2,800 (line) | Local market (Delhi NCR) | Delhi NCR | Local-Delhi NCR | 3 |  |  | Quote needed. | ESTIMATE - quote needed | 2026-10-24 | ₹1500.00 | ₹2800.00
Power & Protection | Cable glands PG-9 | PG-9 nickel-plated brass gland with PA66 insert | 6 | ₹132.00 | ₹792.00 |  | Probots (Probots Technologies) | Bengaluru (Nagarbhavi; contact page) | Domestic | 4 | https://probots.co.in/nickel-plated-brass-metal-cable-gland-gland-size-pg-7.html |  | Listed Rs 132.00 incl GST. PG-9 price from related items on the PG-7 page. | Related-product listing on vendor page | 2026-10-24 | ₹0.00 | ₹0.00
Power & Protection | Cable glands PG-11 | PG-11 nickel-plated brass gland | 2 | ₹180.00 | ₹360.00 |  | Probots (Probots Technologies) | Bengaluru (Nagarbhavi; contact page) | Domestic | 4 | https://probots.co.in/nickel-plated-brass-metal-cable-gland-gland-size-pg-7.html |  | Listed Rs 180.00 incl GST. Price from related items on the PG-7 page. | Related-product listing on vendor page | 2026-10-24 | ₹0.00 | ₹0.00
Power & Protection | DIN rail + terminals | 35mm DIN rail 0.5 m + 10x DIN terminal blocks + end stops | 1 | quote needed | ₹0.00 | 400-900 (line) | Local market (Delhi NCR) | Delhi NCR | Local-Delhi NCR | 3 |  |  | Quote needed. | ESTIMATE - quote needed | 2026-10-24 | ₹400.00 | ₹900.00
Power & Protection | RCCB 30 mA | Schneider 2-pole 25 A 30 mA RCCB, DIN rail (SAFETY F6), upstream of the two MCBs | 1 | ₹1062.00 | ₹1062.00 |  | Trademinds (IndiaMART) | Mumbai (Mulund West) | Domestic | 5 | https://m.indiamart.com/proddetail/schneider-25a-double-pole-rccb-22533281697.html | Schneider RCCB listings by other sellers: https://m.indiamart.com/proddetail/schneider-electric-rccb-18276234755.html | Listed Rs 900 per piece excluding all taxes (30 mA, 2-pole, 25 A; seller GST-verified, rating 4.5/5 from 18 reviews); +18% GST = Rs 1,062.00. Model number not listed. | Store/category listing page | 2026-10-25 | ₹0.00 | ₹0.00
Power & Protection | Bimetal thermostats 70/80 C | KSD301-type NC bimetal thermostats, 70 C and 80 C, 10 A (SAFETY F7) | 2 | quote needed | ₹0.00 | 150-400 (line) | Delhi electronics market (seller to be named) | Delhi NCR | Local-Delhi NCR | 3 |  |  | ESTIMATE (no usable page): searched 25 Oct; KSD301-type NC 10 A units at 60-150 C exist on robu.in (Pune, rejected by the city rule) and on non-Indian sites. Quote 2 pcs (70 C and 80 C) from a Delhi electronics market. | ESTIMATE - quote needed | 2026-10-25 | ₹150.00 | ₹400.00
Power & Protection | Power box (pole base, shaded) | PVC IP65 hinged-door enclosure 250x190x95 mm for LRS-200-24, LRS-100-12, 2 MCBs, RCCB, SPD, mini UPS (moves 9.6 W out of the Edge box) | 1 | ₹295.00 | ₹295.00 |  | Jenshri India Pvt Ltd (IndiaMART) | New Delhi | Local-Delhi NCR | 3 | https://m.indiamart.com/proddetail/250x190x95mm-outdoor-pole-box-2858984643197.html (https://m.indiamart.com/simplexprofilosystems/aluminium-extrusion-profiles.html) | Hensel KG9003 217x253x115 (IP66) Rs 2,025, Vijay Kumar Sanjeev Kr Electric, New Delhi | Listed Rs 250 per piece excluding all taxes (PVC, IP65, UV-resistant, hinged single door; seller GST-verified); +18% GST = Rs 295.00. WARNING: internal fit of the LRS-200-24 (about 99x97x30 mm), LRS-100-12, 3 DIN breakers and the SPD in 250x190x95 is not checked; a larger box may be needed (docs/OPEN_DECISIONS.md D6). Air temperature estimate 59.6 C at 45 C ambient (CALCS section 5). | Product page | 2026-10-25 | ₹0.00 | ₹0.00
Power & Protection | SUBTOTAL - Power & Protection |  |  |  | ₹8423.32 |  |  |  |  | 6 |  |  |  |  |  | ₹2350.00 | ₹4700.00
Mechanical | 80x80 Al T-slot extrusion (gantry pole) | 8080 Slot 10 mm T-slot profile, 3 m (pole 2.4 m + cut margin); CALCS needs W >= 27 cm3, 8-slot, Al 6063 (T6 preferred); length in m | 3 | ₹2891.00 | ₹8673.00 |  | Simplex Profilo Systems (IndiaMART) | Gurugram (GST 06BMJPR6459N1Z5) | Local-Delhi NCR | 5 | https://m.indiamart.com/simplexprofilosystems/aluminium-extrusion-profiles.html | No other allowed-city 80x80 listing priced | Listed Rs 2,450.00; GST not stated, +18% applied (conservative). 25-Oct: added because cad/calcs/CALCS.md section 1 shows 40x40 fails at Delhi design wind (FoS 0.46) and the pole is now 80x80. Listing shows '8080 Slot 10mm T Slot Aluminium Profile' at Rs 2,450/m (GST not stated, +18%); weight/m, section modulus and temper are NOT listed: get the drawing and confirm W >= 27 cm3 before ordering. Sold by the metre; confirm cut-to-length. | Store/category listing page | 2026-10-25 | ₹0.00 | ₹0.00
Mechanical | 40x40 Al T-slot extrusion | 4040 LIGHT T-slot profile, 1.2 kg/m (antenna arm 350 mm + camera arm 300 mm + spare; the pole is now 80x80, next line); length in m | 1 | ₹672.60 | ₹672.60 |  | Simplex Profilo Systems (IndiaMART) | Gurugram (GST 06BMJPR6459N1Z5) | Local-Delhi NCR | 5 | https://m.indiamart.com/simplexprofilosystems/aluminium-extrusion-profiles.html | Allied Technocare (IndiaMART Chennai): 40x40 Rs 850/m https://m.indiamart.com/proddetail/40x40-aluminium-extrusion-2856866587030.html | Listed Rs 570.00; GST not stated, +18% applied (conservative). Price per metre. The 'Medium' 4040 is Rs 550/m (weight n/s). Qty cut from 3 m to 1 m on 25-Oct: 40x40 is used only for the two arms. | Store/category listing page | 2026-10-25 | ₹0.00 | ₹0.00
Mechanical | 20x20 Al T-slot extrusion | 2020 European-standard profile, 600 mm piece | 2 | ₹538.00 | ₹1076.00 |  | Robocraze (TIF Labs Pvt Ltd) | Bengaluru (Kalyan Nagar warehouse; contact page) | Domestic | 14 | https://robocraze.com/products/600mm-2020-european-standard-aluminium-profile (https://m.indiamart.com/simplexprofilosystems/) | Quote: Simplex Profilo Systems, Gurugram | Listed Rs 538.00 incl GST. SOLD OUT 24-Oct, so get the Gurugram quote. | Product page | 2026-10-25 | ₹0.00 | ₹0.00
Mechanical | 4040 angle brackets | DCBK 4040 die-cast Al angle bracket | 8 | ₹41.30 | ₹330.40 |  | Simplex Profilo Systems (IndiaMART) | Gurugram | Local-Delhi NCR | 5 | https://m.indiamart.com/simplexprofilosystems/ (https://m.indiamart.com/proddetail/cnc-laser-cutting-service-2849776118462.html) |  | Listed Rs 35.00; GST not stated, +18% applied (conservative). | Store/category listing page | 2026-10-24 | ₹0.00 | ₹0.00
Mechanical | 2020 angle brackets | DCBK 2020 die-cast Al angle bracket | 6 | ₹35.40 | ₹212.40 |  | Simplex Profilo Systems (IndiaMART) | Gurugram | Local-Delhi NCR | 5 | https://m.indiamart.com/simplexprofilosystems/ (https://m.indiamart.com/proddetail/cnc-laser-cutting-service-2849776118462.html) |  | Listed Rs 30.00; GST not stated, +18% applied (conservative). | Store/category listing page | 2026-10-24 | ₹0.00 | ₹0.00
Mechanical | T-nuts | Top-loading T-nut / hammer-head nut (slot size to confirm: 8 mm for 4040, 6 mm for 2020) | 30 | ₹21.24 | ₹637.20 |  | Simplex Profilo Systems (IndiaMART) | Gurugram | Local-Delhi NCR | 5 | https://m.indiamart.com/simplexprofilosystems/ (https://m.indiamart.com/proddetail/aluminum-rectangular-pipe-2406025197.html) |  | Listed Rs 18.00; GST not stated, +18% applied (conservative). | Store/category listing page | 2026-10-24 | ₹0.00 | ₹0.00
Mechanical | Base plate (laser-cut) | MS IS 2062 E250 plate 250x250x16 mm (per CALCS/MATERIALS, hot-dip galvanised), 4x D14 anchor holes on 190 mm PCD + socket location | 1 | quote needed | ₹0.00 | 1,200-2,500 (line) | Reliable Laser Works Pvt Ltd (IndiaMART) | Faridabad | Local-Delhi NCR | 7 | https://m.indiamart.com/proddetail/cnc-laser-cutting-service-2849776118462.html (https://m.indiamart.com/proddetail/grasp-ip-65-modular-electrical-enclosures-7255097288.html) | HB Engineering, Faridabad (Rs 15/min, Al up to 20 mm) | Cutting listed Rs 30/sq ft (MS/SS/AL, up to 40 mm). Plate material + min-charge not listed: quote needed. 25-Oct: spec changed from Al 6061 10 mm to MS 16 mm to match CALCS (10 mm gives FoS 1.13); the Rs 1,200-2,500 range was set for the old plate and has not been re-estimated, re-quote and galvanising are open. | ESTIMATE - quote needed | 2026-10-24 | ₹1200.00 | ₹2500.00
Mechanical | Gussets (laser-cut) | 4x 6 mm MS gussets + 4x 6 mm MS socket cheeks (2 of 93x150, 2 of 81x150) per MATERIALS | 1 | quote needed | ₹0.00 | 400-900 (line) | Reliable Laser Works Pvt Ltd (IndiaMART) | Faridabad | Local-Delhi NCR | 7 | https://m.indiamart.com/proddetail/cnc-laser-cutting-service-2849776118462.html (https://robocraze.com/search?q=petg+filament) |  | Same job as the base plate: quote needed. 25-Oct: now MS, and the 4 socket cheeks were missing from the BOM; the range has not been re-estimated. | ESTIMATE - quote needed | 2026-10-24 | ₹400.00 | ₹900.00
Mechanical | Boom tube 60x30 Al | Al rectangular tube 60x30 (about 1.5 mm wall), one stock length about 3.6 m, about 2.6 kg; qty in kg | 2.6 | ₹318.60 | ₹828.36 |  | Gokal Chand Jagan Nath Nahar (IndiaMART) | New Delhi | Local-Delhi NCR | 3 | https://m.indiamart.com/proddetail/aluminum-rectangular-pipe-2406025197.html (https://probots.co.in/m3x25mm-bolts-and-nuts.html) | Gayatri Enterprises, New Delhi Rs 250/kg; Auto Tech Industry, Gurugram Rs 260/kg | Listed Rs 270.00; GST not stated, +18% applied (conservative). Listed Rs/kg for a 2-inch section: confirm 60x30 availability. Only 1.2 m is needed; the kg figure is an estimate from section geometry. | Store/category listing page | 2026-10-25 | ₹0.00 | ₹0.00
Mechanical | Edge enclosure IP65 | GRASP IP65 modular enclosure 300x300x210 mm | 1 | ₹1834.90 | ₹1834.90 |  | Super Electricals (IndiaMART) | New Delhi | Local-Delhi NCR | 3 | https://m.indiamart.com/proddetail/grasp-ip-65-modular-electrical-enclosures-7255097288.html | No allowed-city 400x300x150 IP65 listing found (Idis India 400x300x150 Rs 1,050 is Ahmedabad: rejected) | Listed Rs 1,555.00; GST not stated, +18% applied (conservative). DECISION 25 Oct: this bought 300x300x210 box is the design basis. Thermal result: box size is not the lever (0.6 K between 300x300x210 and 300x400x180, CALCS section 5); CAD/STEP/MATERIALS still model 300x400x180, so the DIN layout, heat-sink window and gasket drawing must be re-checked by the CAD owner (docs/OPEN_DECISIONS.md D6). No 400x300 size is listed at Super Electricals. | Store/category listing page | 2026-10-25 | ₹0.00 | ₹0.00
Mechanical | PETG filament | Anycubic PETG 1.75 mm 1 kg | 2 | ₹902.00 | ₹1804.00 |  | Robocraze (TIF Labs Pvt Ltd) | Bengaluru (Kalyan Nagar warehouse; contact page) | Domestic | 4 | https://robocraze.com/search?q=petg+filament | Moglix: eSUN PETG 1kg Rs 1,744 incl GST (available on request) | Listed Rs 902.00 incl GST. For brackets, node housings, sign bezel. ASA not found at an allowed vendor: PETG used outdoors (UV risk). MATERIALS.md and CALCS assume ASA for the pole cap, cable boot, Pi tray, boom tip cap and occupancy nodes: either source ASA or accept PETG and change those documents. | Store/category listing page | 2026-10-24 | ₹0.00 | ₹0.00
Mechanical | M3 fasteners | M3 bolt+nut sets (20/25/40 mm) | 50 | ₹3.00 | ₹150.00 |  | Probots (Probots Technologies) | Bengaluru (Nagarbhavi; contact page) | Domestic | 4 | https://probots.co.in/m3x25mm-bolts-and-nuts.html |  | Listed Rs 3.00 incl GST. Price per set from Probots listing grid. | Store/category listing page | 2026-10-24 | ₹0.00 | ₹0.00
Mechanical | Structural fasteners | 4x M12 anchor bolts, M8/M6 SS bolts, washers, nyloc nuts | 1 | quote needed | ₹0.00 | 800-1,600 (line) | Delhi hardware market (seller to be named) | Delhi NCR | Local-Delhi NCR | 2 |  |  | Quote needed. | ESTIMATE - quote needed | 2026-10-24 | ₹800.00 | ₹1600.00
Mechanical | Counterweight + shear pins | MS counterweight 7 plates 100x60x10 (3.30 kg) + 5 mm 6061-T6 breakaway shear pins (spares) | 1 | quote needed | ₹0.00 | 300-700 (line) | Local fabricator (Delhi NCR) | Delhi NCR | Local-Delhi NCR | 5 |  |  | ESTIMATE (no vendor page). 7 MS plates 100x60x10 = 3.30 kg are the adopted counterweight (94 % balance; CALCS section 4) plus spare 5 mm 6061-T6 breakaway pins (the design gust loads the pin to 89 % of its break moment, so spares matter). Quote from a local fabricator. | ESTIMATE - quote needed | 2026-10-24 | ₹300.00 | ₹700.00
Mechanical | Barrier housing | MS base plate 360x310x8, 20x20 frame, 2 mm 5052 skins + 3 mm roof, powder coat (MATERIALS section c) | 1 | quote needed | ₹0.00 | 5,000-9,000 (line) | Reliable Laser Works Pvt Ltd (IndiaMART) | Faridabad | Local-Delhi NCR | 7 |  |  | ESTIMATE (no vendor page). STEP masses: 6.90 kg MS base plate, 2.71 kg Al frame, 5.43 kg skins/roof. Aluminium 8.1 kg x Rs 318.6/kg (boom-tube listing) = Rs 2,600, MS plate about Rs 600, laser/brake/weld/powder-coat allowance Rs 2,000-5,000. Quote from Reliable Laser Works (IndiaMART, Delhi NCR) or similar. | ESTIMATE - quote needed | 2026-10-25 | ₹5000.00 | ₹9000.00
Mechanical | Edge heat sink + sun hood | 200x150 extruded Al sink, 18 fins x 35 mm; 2 mm Al sun hood with 25 mm air gap; EPDM window gasket (CALCS section 5) | 1 | quote needed | ₹0.00 | 2,000-4,500 (line) | Delhi NCR heat-sink dealer + Reliable Laser Works, Faridabad | Delhi NCR / Faridabad | Local-Delhi NCR | 7 |  |  | ESTIMATE (no usable page): IndiaMART heat-sink pages found (Himalay Engineering, Mumbai: Rs 400/piece for an undimensioned sink; Marshah Electronics, Mumbai: extruded 6063-T5 with no price) do not state a 200x150 mm, 18-fin size. Sink 1.17 kg + sun hood 0.95 kg of Al plus cutting/bending. Quote. Without both the thermal prediction does not hold (CALCS section 5). | ESTIMATE - quote needed | 2026-10-25 | ₹2000.00 | ₹4500.00
Mechanical | Vent + M25/M20/M16 glands | ePTFE breather vent, nylon glands M25 x1, M20 x3, M16 x1 (MATERIALS section b) | 1 | quote needed | ₹0.00 | 400-900 (line) | Delhi electrical market (seller to be named) | Delhi NCR | Local-Delhi NCR | 3 |  |  | ESTIMATE (no vendor page opened for ePTFE vents or nylon glands from an allowed city). 1 vent + 5 glands. Quote. | ESTIMATE - quote needed | 2026-10-25 | ₹400.00 | ₹900.00
Mechanical | Cable duct (38x38 substitute for 40x25) | PVC cable duct 38x38 mm, 2 m pieces (cover not stated), 4 m for the pole run; the CAD duct is 40x25 | 4 | ₹53.10 | ₹212.40 |  | AR Industries (IndiaMART) | Noida | Local-Delhi NCR | 3 | https://m.indiamart.com/proddetail/pvc-cable-duct-2859724144062.html | Surana Enterprises, Bengaluru: 25 mm duct tray Rs 38/m https://m.indiamart.com/proddetail/pvc-cable-duct-tray-6719781833.html | Listed Rs 45 per metre excluding all taxes, 2 m per piece (qty is metres); +18% GST = Rs 53.10/m. Size is 38x38, not the CAD 40x25; material, UV-stabilisation and cover are not stated. No 40x25 listing was found in the allowed cities. | Store/category listing page | 2026-10-25 | ₹0.00 | ₹0.00
Mechanical | SUBTOTAL - Mechanical |  |  |  | ₹16431.26 |  |  |  |  | 14 |  |  |  |  |  | ₹10100.00 | ₹20100.00
 | Total of priced lines (verified vendor prices) |  |  |  | ₹124832.66
 | Total of estimate lines - LOW (ESTIMATE) |  |  |  | ₹23349.00
 | Total of estimate lines - HIGH (ESTIMATE) |  |  |  | ₹42299.00
 | Base budget = priced + estimates HIGH |  |  |  | ₹167131.66
 | Contingency 10% of base budget |  |  |  | ₹16713.17
 | GRAND TOTAL (INR, incl GST) |  |  |  | ₹183844.83
 | All prices INR incl. 18% GST (added where a page listed ex-GST or did not state GST). First checked 2026-10-24; vendor pages re-checked 2026-10-25 (see column P); new pages for the 25 Oct design update were checked 2026-10-25. Yellow cells = ESTIMATES, not vendor prices. After the 25 Oct review there are NO unpriced GAP lines left: each former GAP is either priced from a listing or carries a labelled estimate range. Lines with quantity 0 are superseded and kept for reference. Shipping not included.

Sheet: Summary
Subsystem | Priced lines (INR) | Estimate lines low (INR) | Estimate lines high (INR) | Budget = priced + est. high (INR) | Max lead time (days) | # lines | # estimate lines | # unpriced GAP lines (not in budget)
Edge Node | ₹43020 | ₹5099 | ₹5499 | ₹48519 | 7 | 8 | 2 | 0
Lane Controller PCB | ₹4476.54 | ₹3300 | ₹6500 | ₹10976.54 | 10 | 13 | 2 | 0
UHF RFID Reader | ₹26100.6 | ₹0 | ₹0 | ₹26100.6 | 6 | 2 | 0 | 0
ANPR Camera | ₹4071 | ₹0 | ₹0 | ₹4071 | 7 | 1 | 0 | 0
PoE Switch | ₹5310 | ₹0 | ₹0 | ₹5310 | 7 | 1 | 0 | 0
Occupancy Nodes x4 | ₹4760 | ₹800 | ₹1400 | ₹6160 | 14 | 4 | 1 | 0
P10 LED Sign | ₹1536 | ₹0 | ₹0 | ₹1536 | 14 | 3 | 0 | 0
Barrier Drive | ₹10703.94 | ₹1700 | ₹4100 | ₹14803.94 | 7 | 9 | 2 | 0
Power & Protection | ₹8423.32 | ₹2350 | ₹4700 | ₹13123.32 | 6 | 13 | 4 | 0
Mechanical | ₹16431.26 | ₹10100 | ₹20100 | ₹36531.26 | 14 | 18 | 7 | 0
TOTAL | ₹124832.66 | ₹23349 | ₹42299 | ₹167131.66 | 14 | 72 | 18 | 0
Contingency 10% |  |  |  | ₹16713.17
GRAND TOTAL |  |  |  | ₹183844.83
Cross-check: Summary GRAND TOTAL must equal BOM GRAND TOTAL -> |  |  |  | ₹183844.83

Sheet: Sources
# | URL | Used for | What it verified | Checked on
1 | https://probots.co.in/raspberry-pi-5-model-b-bcm2712-arm-cortex-a76-8gb-ram-2-4ghz-single-board-computer.html | Edge Node: Raspberry Pi 5 8GB | Product page | re-checked 25-Oct, see BOM notes | 2026-10-25
2 | https://probots.co.in/official-raspberry-pi-ai-hat-26-tops.html | Edge Node: Raspberry Pi AI HAT+ 26 TOPS | Product page | re-checked 25-Oct, see BOM notes | 2026-10-25
3 | https://probots.co.in/official-raspberry-pi-5-active-cooler-heatsink-fan.html | Edge Node: Active cooler | Product page | re-checked 25-Oct, see BOM notes | 2026-10-25
4 | https://robocraze.com/search?q=sandisk | Edge Node: microSD card 128GB | Store/category listing page | 2026-10-24
5 | https://probots.co.in/raspberry-pi-27w-usb-c-power-supply-white-in-plug.html | Edge Node: USB-C PSU (bench / commissioning) | Product page | re-checked 25-Oct, see BOM notes | 2026-10-25
6 | https://probots.co.in/xl4015-step-down-buck-converter-adjustable-max-output-36v-5a.html | Edge Node: 24V->5.1V 5A buck (Pi 5 feed in enclosure) | Product page | re-checked 25-Oct, see BOM notes | 2026-10-25
7 | https://probots.co.in/metal-case-raspberry-pi-5-x1202-ups-board.html | Edge Node: Pi 5 UPS module (>=10 min ride-through) | ESTIMATE - quote needed | re-checked 25-Oct, see BOM notes | 2026-10-25
8 | https://lioncircuits.com/parts/ESP32-S3-WROOM-1-N16R8 | Lane Controller PCB: MCU module | Product page | re-checked 25-Oct, see BOM notes | 2026-10-25
9 | https://lioncircuits.com/parts/MAX3485ESA+T | Lane Controller PCB: RS485 transceiver | Product page | 2026-10-24
10 | https://lioncircuits.com/parts/SM712.TCT | Lane Controller PCB: RS485 TVS | Product page | 2026-10-24
11 | https://probots.co.in/bts7960-43a-stepper-motor-driver-h-bridge-high-power-module-motor-control.html | Lane Controller PCB: H-bridge motor driver | Product page | re-checked 25-Oct, see BOM notes | 2026-10-25
12 | https://lioncircuits.com/parts/AP2112K-3.3TRG1 | Lane Controller PCB: 3.3V regulator | Product page | 2026-10-24
13 | https://lioncircuits.com/parts/PC817C | Lane Controller PCB: Optocouplers | Product page | 2026-10-24
14 | https://probots.co.in/2-pin-fixed-screw-terminal-block-connector-5-08mm.html | Lane Controller PCB: Screw terminals | Product page | 2026-10-24
15 | https://probots.co.in/piezo-electric-buzzer-alarm-3v-24v-continuous-b27.html | Lane Controller PCB: Buzzer | Store/category listing page | 2026-10-24
16 | https://probots.co.in/rgb-led-12-bit-ws2812-circular-development-board.html | Lane Controller PCB: Status RGB LED | Product page | 2026-10-24
17 | https://lioncircuits.com/ | Lane Controller PCB: PCB fabrication | Vendor homepage offer | 2026-10-24
18 | https://www.industrybuying.com/card-reader-id-tech-ITE.CAR.38552208 | UHF RFID Reader: UHF integrated reader | Product page | re-checked 25-Oct, see BOM notes | 2026-10-25
19 | https://m.indiamart.com/ecotracksystems/profile.html | UHF RFID Reader: UHF test tags | Store/category listing page | re-checked 25-Oct, see BOM notes | 2026-10-25
20 | https://m.indiamart.com/proddetail/cp-plus-cp-unc-td21zl6c-vmds-bullet-camera-2854862398948.html | ANPR Camera: ANPR camera 2MP IR | Product page | re-checked 25-Oct, see BOM notes | 2026-10-25
21 | https://m.indiamart.com/proddetail/5-port-gigabit-ethernet-poe-unmanaged-switch-gs305p-netgear-2856793072391.html | PoE Switch: PoE switch | Product page | re-checked 25-Oct, see BOM notes | 2026-10-25
22 | https://probots.co.in/esp32-c3-supermini-wifi-bluetooth-development-board-32-bit-risc-v-uart-i2c-spi.html | Occupancy Nodes x4: Node MCU | Product page | re-checked 25-Oct, see BOM notes | 2026-10-25
23 | https://probots.co.in/vl53l1x-tof-laser-ranging-sensor-module.html | Occupancy Nodes x4: Distance sensor | Product page | re-checked 25-Oct, see BOM notes | 2026-10-25
24 | https://probots.co.in/p10-red-smd-outdoor-led-display-module-160x320mm.html | P10 LED Sign: P10 outdoor LED module | Product page | re-checked 25-Oct, see BOM notes | 2026-10-25
25 | https://probots.co.in/w00-led-display-single-colour-wifi-controller-card-hd.html | P10 LED Sign: P10 controller (fallback) | Product page | 2026-10-24
26 | https://www.moglix.com/lucas-tvs-wiper-motor-assembly-24-v-18-nm-for-hindustan-72-71b-front-end-loader-front-screentriv-luc-tsrxs6/mp/msnl5gln362yk4 | Barrier Drive: 24V geared DC motor | Product page | re-checked 25-Oct, see BOM notes | 2026-10-25
27 | https://probots.co.in/rotary-adjustable-roller-micro-limit-switch-me-8108.html | Barrier Drive: Limit switches | Product page | re-checked 25-Oct, see BOM notes | 2026-10-25
28 | https://m.indiamart.com/proddetail/ps-mt5-usb2-delta-18mm-thru-beam-gkdp-18-3a30-pc-my3n-j-24vdc-my3n-j-12vdc-my3n-j-110vac-pyf11a-e-26029950830.html | Barrier Drive: IR photo-beam pair | Product page | re-checked 25-Oct, see BOM notes | 2026-10-25
29 | https://probots.co.in/promax-22mm-emergency-stop-switch-mushroom-head-waterproof-metal-2-pole.html | Barrier Drive: E-stop | Product page | re-checked 25-Oct, see BOM notes | 2026-10-25
30 | https://probots.co.in/24v-30a-1-channel-relay-module-with-optocoupler-isolation-high-power.html | Barrier Drive: Motor power relay | Product page | re-checked 25-Oct, see BOM notes | 2026-10-25
31 | https://probots.co.in/smps-metal-power-supply-24v-6-5a-156w-lrs-150-24-mean-well.html | Power & Protection: 24V SMPS | Product page | re-checked 25-Oct, see BOM notes | 2026-10-25
32 | https://probots.co.in/mean-well-smps-12v-8-5a-102w-metal-power-supply-lrs-100-12.html | Power & Protection: 12V SMPS | Product page | re-checked 25-Oct, see BOM notes | 2026-10-25
33 | https://lntsufin.com/product/schneider-electric-acti9-xc60-a9n1p06c-single-pole-6-a-c-curve-mcb/17753-69 | Power & Protection: MCB | Product page | re-checked 25-Oct, see BOM notes | 2026-10-25
34 | https://probots.co.in/inline-5x20mm-glass-fuse-holder-with-22-awg-lead-wires-25pcs-bag.html | Power & Protection: Fuse holders + fuses | ESTIMATE - quote needed | 2026-10-24
35 | https://m.indiamart.com/proddetail/surge-protection-device-2859297106848.html | Power & Protection: AC SPD | Product page | re-checked 25-Oct, see BOM notes | 2026-10-25
36 | https://m.indiamart.com/proddetail/mini-ups-for-wifi-router-25743173988.html | Power & Protection: 12V mini DC UPS | Store/category listing page | re-checked 25-Oct, see BOM notes | 2026-10-25
37 | https://probots.co.in/nickel-plated-brass-metal-cable-gland-gland-size-pg-7.html | Power & Protection: Cable glands PG-9 | Related-product listing on vendor page | 2026-10-24
38 | https://m.indiamart.com/simplexprofilosystems/aluminium-extrusion-profiles.html | Mechanical: 80x80 Al T-slot extrusion (gantry pole) | Store/category listing page | re-checked 25-Oct, see BOM notes | 2026-10-25
39 | https://robocraze.com/products/600mm-2020-european-standard-aluminium-profile | Mechanical: 20x20 Al T-slot extrusion | Product page | re-checked 25-Oct, see BOM notes | 2026-10-25
40 | https://m.indiamart.com/simplexprofilosystems/ | Mechanical: 4040 angle brackets | Store/category listing page | 2026-10-24
41 | https://m.indiamart.com/proddetail/cnc-laser-cutting-service-2849776118462.html | Mechanical: Base plate (laser-cut) | ESTIMATE - quote needed | 2026-10-24
42 | https://m.indiamart.com/proddetail/aluminum-rectangular-pipe-2406025197.html | Mechanical: Boom tube 60x30 Al | Store/category listing page | re-checked 25-Oct, see BOM notes | 2026-10-25
43 | https://m.indiamart.com/proddetail/grasp-ip-65-modular-electrical-enclosures-7255097288.html | Mechanical: Edge enclosure IP65 | Store/category listing page | re-checked 25-Oct, see BOM notes | 2026-10-25
44 | https://robocraze.com/search?q=petg+filament | Mechanical: PETG filament | Store/category listing page | 2026-10-24
45 | https://probots.co.in/m3x25mm-bolts-and-nuts.html | Mechanical: M3 fasteners | Store/category listing page | 2026-10-24
46 | https://robocraze.com/products/raspberry-pi-5-8gb | Edge Node: Raspberry Pi 5 8GB (alt vendor) | Alt-vendor price/stock | re-checked 25-Oct, see BOM notes | 2026-10-25
47 | https://robocraze.com/products/official-raspberry-pi-ai-hat-26-tops | Edge Node: Raspberry Pi AI HAT+ 26 TOPS (alt vendor) | Alt-vendor price/stock | re-checked 25-Oct, see BOM notes | 2026-10-25
48 | https://probots.co.in/esp32-s3-wroom-1-n16r8-development-board-wireless-module-wifi-bluetooth.html | Lane Controller PCB: MCU module (alt vendor) | Alt-vendor price/stock | 2026-10-24
49 | https://probots.co.in/uart-ttl-to-rs485-serial-converter.html | Lane Controller PCB: RS485 transceiver (alt vendor) | Alt-vendor price/stock | 2026-10-24
50 | https://www.thingbits.in/products/bts7960-43a-h-bridge-motor-driver | Lane Controller PCB: H-bridge motor driver (alt vendor) | Alt-vendor price/stock | 2026-10-24
51 | https://m.indiamart.com/ecotracksystems/integrated-reader.html | UHF RFID Reader: UHF integrated reader (alt vendor) | Alt-vendor price/stock | re-checked 25-Oct, see BOM notes | 2026-10-25
52 | https://m.indiamart.com/proddetail/hikvision-ds-2cd1023g0e-i-2-mp-ir-fixed-network-bullet-camera-22509971212.html | ANPR Camera: ANPR camera 2MP IR (alt vendor) | Alt-vendor price/stock | 2026-10-24
53 | https://m.indiamart.com/proddetail/8-port-gigabit-ethernet-plus-with-4-ports-poe-53w-24243207948.html | PoE Switch: PoE switch (alt vendor) | Alt-vendor price/stock | 2026-10-24
54 | https://thingbits.in/products/a02yyuw-waterproof-ultrasonic-sensor | Occupancy Nodes x4: Distance sensor (alt vendor) | Alt-vendor price/stock | re-checked 25-Oct, see BOM notes | 2026-10-25
55 | https://m.indiamart.com/proddetail/outdoor-p10-red-led-display-module-21357608312.html | P10 LED Sign: P10 outdoor LED module (alt vendor) | Alt-vendor price/stock | re-checked 25-Oct, see BOM notes | 2026-10-25
56 | https://probots.co.in/6280-24v-30rpm-reversible-worm-gear-high-torque-self-locking-motor-left.html | Barrier Drive: 24V geared DC motor (alt vendor) | Alt-vendor price/stock | re-checked 25-Oct, see BOM notes | 2026-10-25
57 | https://m.indiamart.com/proddetail/boom-barrier-photocell-sensor-2853343495312.html | Barrier Drive: IR photo-beam pair (alt vendor) | Alt-vendor price/stock | re-checked 25-Oct, see BOM notes | 2026-10-25
58 | https://m.indiamart.com/r-and-d-controlsystems/switch-mode-power-supply.html | Power & Protection: 24V SMPS (alt vendor) | Alt-vendor price/stock | 2026-10-24
59 | https://m.indiamart.com/proddetail/40x40-aluminium-extrusion-2856866587030.html | Mechanical: 40x40 Al T-slot extrusion (alt vendor) | Alt-vendor price/stock | 2026-10-24
60 | https://probots.co.in/contact-us | Vendor city - Probots | Address: Sankalpa 530, Nagarbhavi 2nd Stage, Bengaluru 560072 | 2026-10-24
61 | https://robocraze.com/pages/contact | Vendor city - Robocraze | Warehouse: 912/10, Chelekare, Kalyan Nagar, Bengaluru 560043 | 2026-10-24
62 | https://m.indiamart.com/robocraze/profile.html | Vendor city - Robocraze | Registered Bengaluru (Kalyananagar) | 2026-10-24
63 | https://hubtronics.in/index.php?route=information/contact | Vendor REJECTED - Hubtronics | Pimple Nilakh, Pune 411027; GSTIN 27CXIPS5926C1Z7 (Maharashtra/Pune) | 2026-10-24
64 | https://thingbits.in/contact | Vendor city - Thingbits | 203 Ectasy Business Park, Mulund West, Mumbai 400080 | re-checked 25-Oct, see BOM notes | 2026-10-25
65 | https://www.primeabgb.com/contact-us/ | Vendor city - PrimeABGB | Simlim Square, Lamington Road, Mumbai 400007 | 2026-10-24
66 | https://www.tradeindia.com/products/mid-range-uhf-integrated-reader-idt-85-c7429880.html | Vendor city + specs - ID Tech Solutions | Plot 610, Udyog Vihar Ph V, Gurugram 122016; IDT 85 RS232/RS485/TCP/Wiegand, ~Rs 14,000 | re-checked 25-Oct, see BOM notes | 2026-10-25
67 | https://circuitdigest.com/interview/lioncircuits-441-crore-terra-circuits-pcb-mega-campus-in-karnataka | Vendor city - LionCircuits | Existing facilities in Karnataka | 2026-10-24
68 | https://in.element14.com/raspberry-pi/rpi5-8gb-single/rpi-5-board-2-4ghz-8gb-arm-cortex/dp/4256000 | Alt vendor - element14 India Pi 5 | Rs 16,717.93; stock ships from SG/UK in 3-6 business days | re-checked 25-Oct, see BOM notes | 2026-10-25
69 | https://m.indiamart.com/simplexprofilosystems/profile.html | Vendor city - Simplex Profilo | Gurugram, GST 06BMJPR6459N1Z5 | 2026-10-24
70 | https://m.indiamart.com/hubtronics/testimonial.html | Vendor REJECTED - Hubtronics | IndiaMART lists Pune, Maharashtra | 2026-10-24
71 | https://m.indiamart.com/idisindia/plastic-enclosures.html | Vendor REJECTED - Idis India enclosure | Ahmedabad | 2026-10-24
72 | https://m.indiamart.com/proddetail/cp-plus-cp-unc-tc21zl6c-vmds-network-ir-bullet-camera-26025370433.html | Camera REJECTED | Ahmednagar seller | 2026-10-24
73 | https://m.indiamart.com/proddetail/hikvision-ds-2cd1023g2-liu-2mp-fixed-bullet-network-camera-2855177890397.html | Camera REJECTED | Dehradun seller | 2026-10-24
74 | https://www.moglix.com/esun-1kg-175mm-solid-yellow-petg-3d-printer-filament/mp/msng9vnqjpjdkp | Alt PETG | eSUN PETG Rs 1,744 incl GST | 2026-10-24
75 | https://probots.co.in/6280-24v-100rpm-reversible-worm-gear-high-torque-self-locking-motor-left.html | Motor option considered | 35 kg-cm, 100 rpm, Rs 10,399 | 2026-10-24
76 | https://probots.co.in/micro-limit-switch-roller.html | Alt limit switch | Rs 69, OOS | 2026-10-24
77 | https://probots.co.in/smps-metal-power-supply-24v-8-8a-211-2w-lrs-200-24-mean-well.html | Power & Protection: 24V SMPS (LRS-200-24) | Product page | 2026-10-25
78 | https://m.indiamart.com/proddetail/schneider-lc1d09bd-power-contactors-23214488912.html | Barrier Drive: Motor power contactor K1 | Store/category listing page | 2026-10-25
79 | https://m.indiamart.com/proddetail/schneider-9-24a-3-pole-440v-dc-contactor-lc1d09bd-18744546455.html | Barrier Drive: Motor power contactor K1 (alt vendor) | Alt-vendor price | 2026-10-25
80 | https://m.indiamart.com/proddetail/loop-detector-pd132-2851226164712.html | Barrier Drive: Presence sensor (loop detector) | Store/category listing page | 2026-10-25
81 | https://m.indiamart.com/proddetail/ucfl204-flange-block-bearing-20588331712.html | Barrier Drive: Flange bearings UCFL204 x2 | Store/category listing page | 2026-10-25
82 | https://m.indiamart.com/proddetail/ucfl-pillow-block-bearings-ucfl204-20568146348.html | Barrier Drive: Flange bearings UCFL204 x2 (alt vendor) | Alt-vendor price | 2026-10-25
83 | https://m.indiamart.com/proddetail/schneider-25a-double-pole-rccb-22533281697.html | Power & Protection: RCCB 30 mA | Store/category listing page | 2026-10-25
84 | https://m.indiamart.com/proddetail/250x190x95mm-outdoor-pole-box-2858984643197.html | Power & Protection: Power box | Product page | 2026-10-25
85 | https://m.indiamart.com/proddetail/pvc-cable-duct-2859724144062.html | Mechanical: Cable duct | Store/category listing page | 2026-10-25
86 | https://probots.co.in/pb-5840-31zy-24v-10-rpm-dc-worm-gear-reduction-motor.html | Motor option considered | 45 kg.cm (4.4 N.m), 80 kg.cm stall, 10 rpm, Rs 1,799, out of stock: far below the need | 2026-10-25
87 | https://m.indiamart.com/himalay-engineering/heatsinks.html | Heat sink search (no usable size/price) | Mumbai seller: heatsinks Rs 400/piece, no 200x150 size | 2026-10-25
88 | https://m.indiamart.com/marshahelectronics/heat-sink.html | Heat sink search (no usable size/price) | Mumbai seller: extruded 6063-T5 sink, price on request | 2026-10-25
89 | https://www.systeal.com/en/40-series-profiles/1433-aluminium-profile-10-mm-slot-80x80.html | Pole mass reconciliation (non-Indian reference, not a purchase source) | 80x80 10 mm slot: 4.45 kg/m, 1649 mm2, I = 130 cm4 | 2026-10-25
