kgchord/ParkFlow/cad/step/barrier_limit_sensors_assy.step

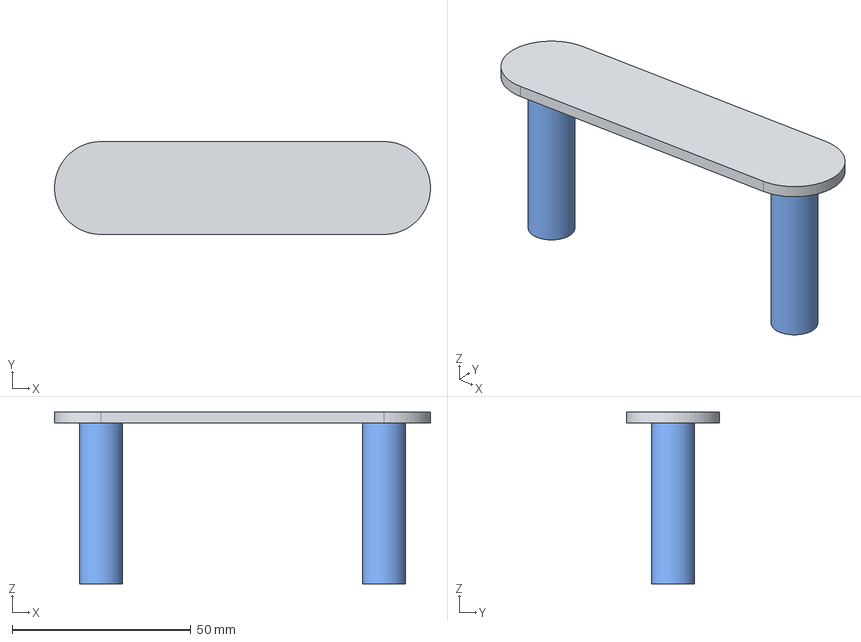
[picture p46: CAD file, 2026-10-25]
cad/step/barrier_limit_sensors_assy.step
105.2 x 26.0 x 48.0 mm
inductive_sensor_225
inductive_sensor_315
sensor_bracket
