kgchord/ParkFlow/cad/step/edge_internals_assy.step

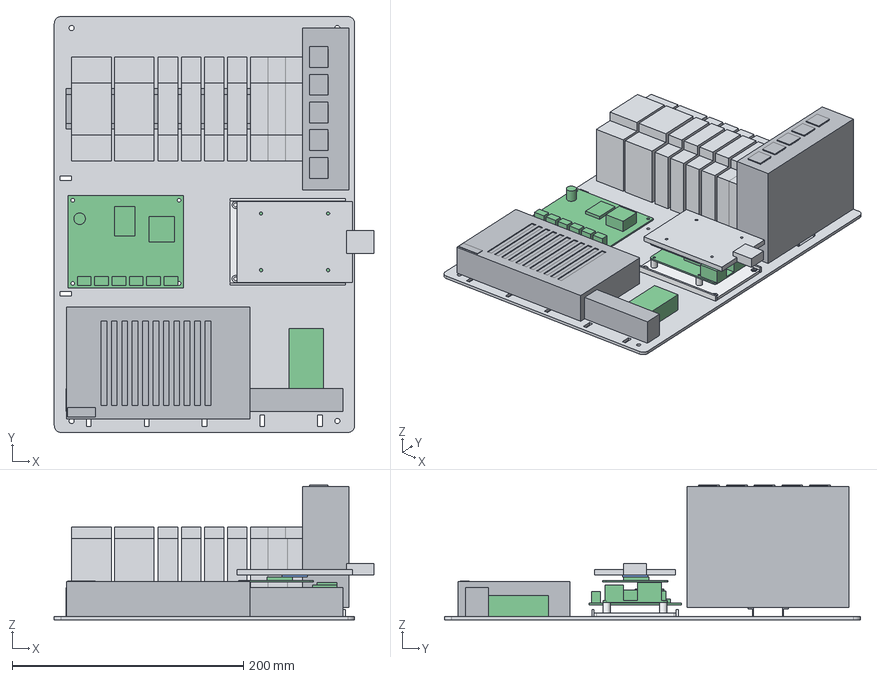
[picture p47: CAD file, 2026-10-25]
cad/step/edge_internals_assy.step
276.5 x 360.0 x 116.5 mm
mount_plate_3mm_5052
din_rail
din_device_0
din_device_1
din_device_2
din_device_3
din_device_4
din_device_5
din_device_6
din_device_7
din_device_8
poe_switch
smps_lrs150
buck_module
pi_tray
rpi5
ai_hat
heat_spreader_6061
thermal_pad
lane_controller_pcb
wire_trunking
