kgchord/ParkFlow/cad/fea/models/repo_step_snapshot/antenna_bracket_assy.step

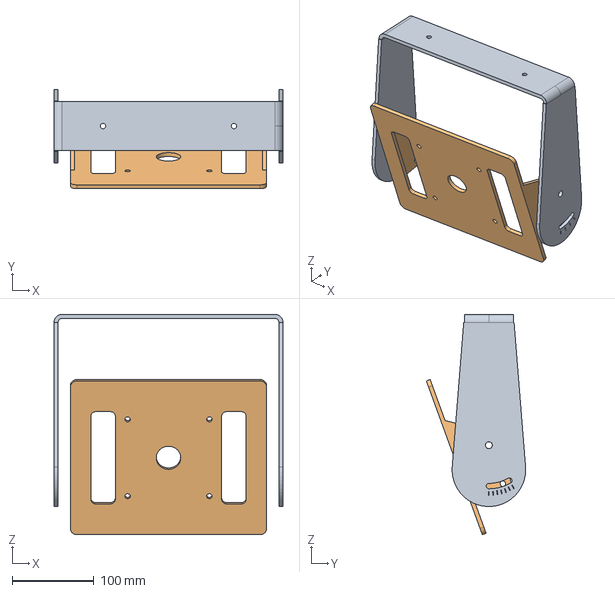
[picture p48: CAD file, 2026-10-25]
cad/fea/models/repo_step_snapshot/antenna_bracket_assy.step
280.0 x 121.4 x 269.4 mm
yoke_5052H32_5mm
tilt_plate_5052H32_5mm
