kgchord/ParkFlow/cad/step/barrier_assembly.step

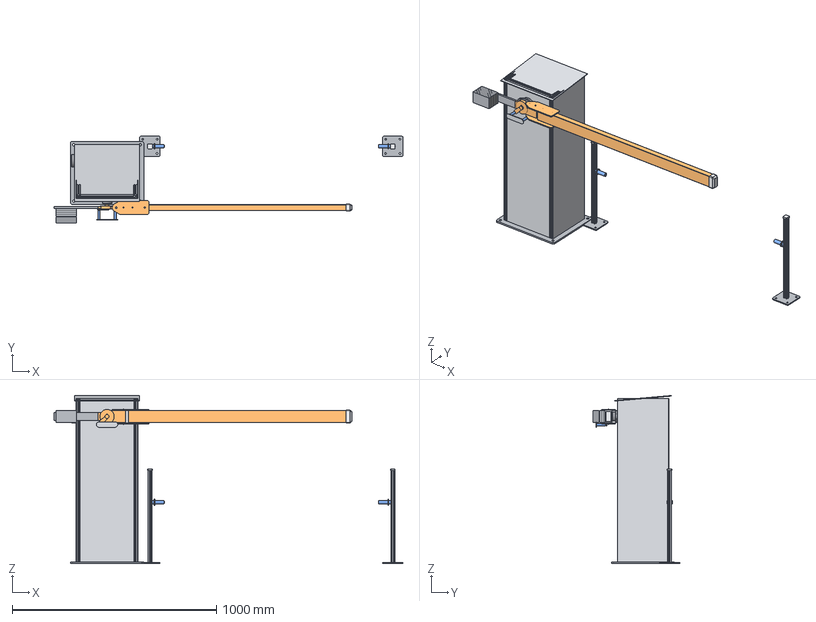
[picture p49: CAD file, 2026-10-25]
cad/step/barrier_assembly.step
1710.0 x 424.7 x 823.2 mm
base_plate_8mm_MS
frame_post_-1-1
frame_post_-1+1
frame_post_+1-1
frame_post_+1+1
rail_x_z0_-1
rail_x_z0_+1
rail_y_z0_-1
rail_y_z0_+1
rail_x_z1_-1
rail_x_z1_+1
rail_y_z1_-1
rail_y_z1_+1
front_panel
back_panel
side_panel_-1
side_panel_+1
roof
motor_plate
gearmotor
jaw_coupling
bearing_plate
flange_bearing_rear
flange_bearing_front
stub_shaft
hub
limit_flag
carrier_plate_-1
carrier_plate_+1
shear_pin
boom_tube
boom_tip_cap
counterweight_tail_bar
counterweight_plate_0
counterweight_plate_1
counterweight_plate_2
counterweight_plate_3
counterweight_plate_4
counterweight_plate_5
counterweight_plate_6
inductive_sensor_225
inductive_sensor_315
sensor_bracket
foot x 2
post x 2
cap x 2
photo_head x 2
