kgchord/ParkFlow/cad/fea/models/repo_step_snapshot/barrier_rotor_assy.step

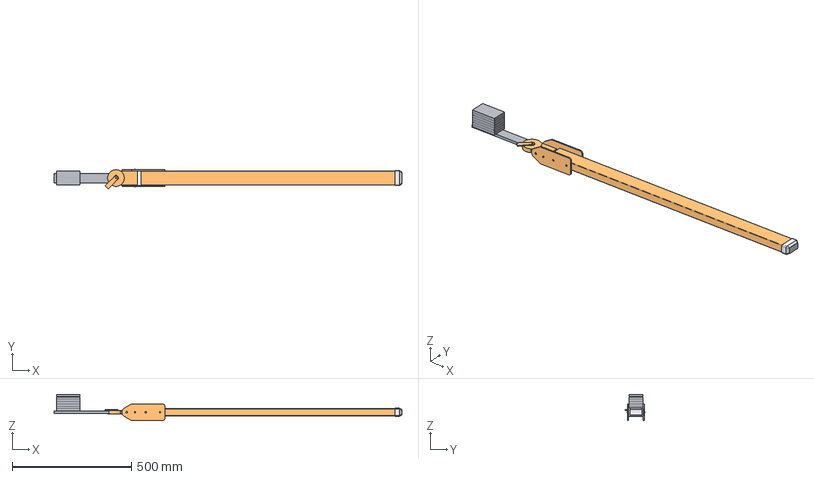
[picture p50: CAD file, 2026-10-25]
cad/fea/models/repo_step_snapshot/barrier_rotor_assy.step
1460.0 x 84.0 x 109.7 mm
hub
limit_flag
carrier_plate_-1
carrier_plate_+1
shear_pin
boom_tube
boom_tip_cap
counterweight_tail_bar
counterweight_plate_0
counterweight_plate_1
counterweight_plate_2
counterweight_plate_3
counterweight_plate_4
counterweight_plate_5
counterweight_plate_6
