kgchord/ParkFlow/cad/step/gantry_camera_arm_assy.step

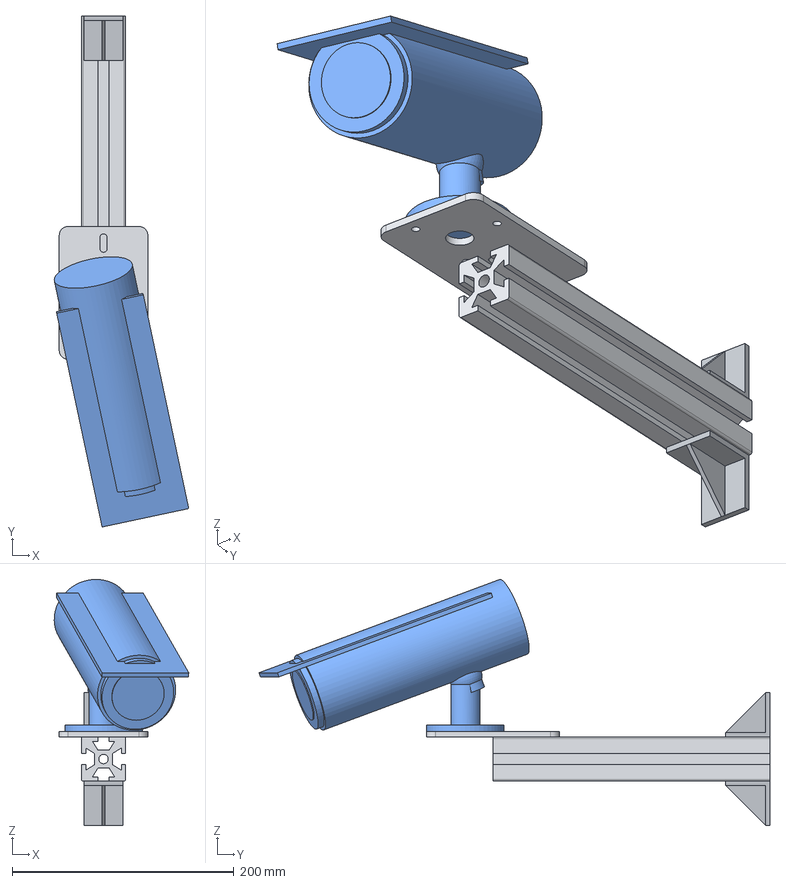
[picture p51: CAD file, 2026-10-25]
cad/step/gantry_camera_arm_assy.step
121.5 x 461.3 x 222.2 mm
camera_arm
corner_bracket_a
corner_bracket_b
camera_adapter_plate
bullet_camera
