kgchord/ParkFlow/cad/step/lane_layout_assy.step

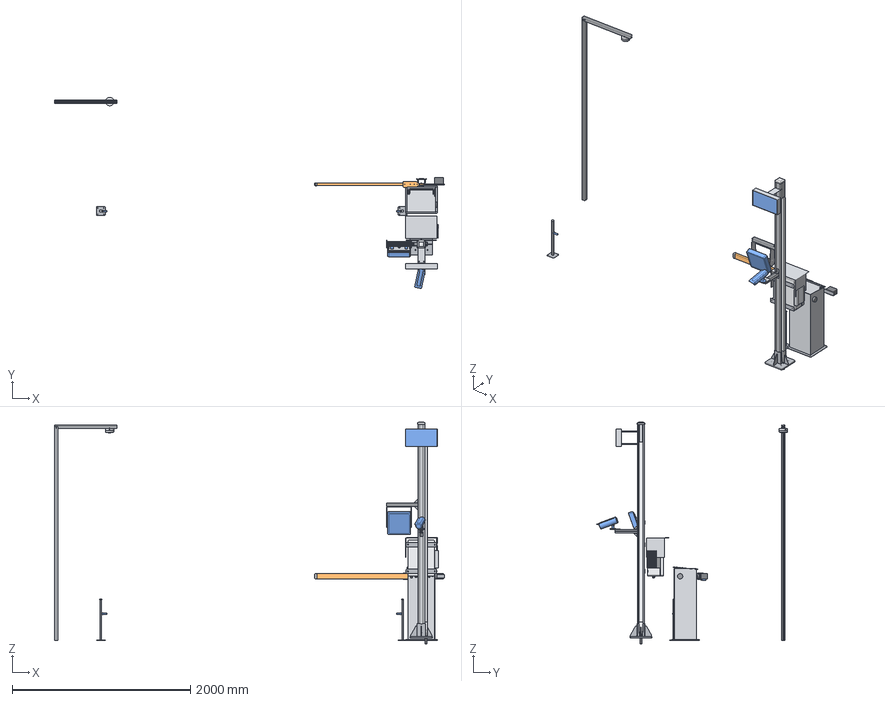
[picture p52: CAD file, 2026-10-25]
cad/step/lane_layout_assy.step
4380.0 x 2149.0 x 2491.4 mm
base_plate_16mm_MS
socket_cheek_long_-y
socket_cheek_long_+y
socket_cheek_short_-x
socket_cheek_short_+x
gusset_0deg
gusset_90deg
gusset_180deg
gusset_270deg
pole_80x80
pole_cap
antenna_arm
corner_bracket_top
corner_bracket_bottom
yoke
tilt_plate
rfid_reader
camera_arm
corner_bracket_a
corner_bracket_b
camera_adapter_plate
bullet_camera
cable_channel
cable_boot
flexible_conduit
sign_bracket_low
sign_bracket_up
cabinet_tray_5052_3mm
p10_led_module_320x160
pc_front_window
led_driver_psu_120x80x20
edge_bracket_low
edge_bracket_up
enclosure_base
mount_plate_3mm_5052
din_rail
din_device_0
din_device_1
din_device_2
din_device_3
din_device_4
din_device_5
din_device_6
din_device_7
din_device_8
poe_switch
smps_lrs150
buck_module
pi_tray
rpi5
ai_hat
heat_spreader_6061
thermal_pad
lane_controller_pcb
wire_trunking
enclosure_lid
lid_gasket
label_plate
heat_sink
heat_sink_window_gasket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
