kgchord/ParkFlow/cad/step/gantry_antenna_arm_assy.step

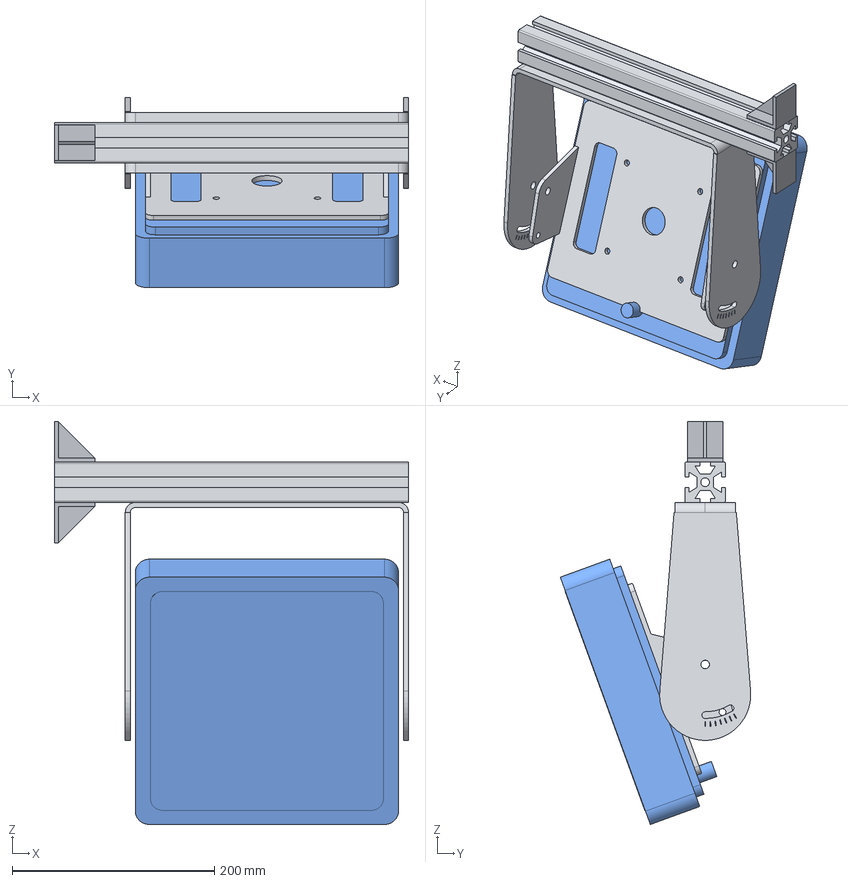
[picture p53: CAD file, 2026-10-25]
cad/step/gantry_antenna_arm_assy.step
350.0 x 188.1 x 398.1 mm
antenna_arm
corner_bracket_top
corner_bracket_bottom
yoke
tilt_plate
rfid_reader
