kgchord/ParkFlow/cad/step/gantry_p10_sign_cabinet_assy.step

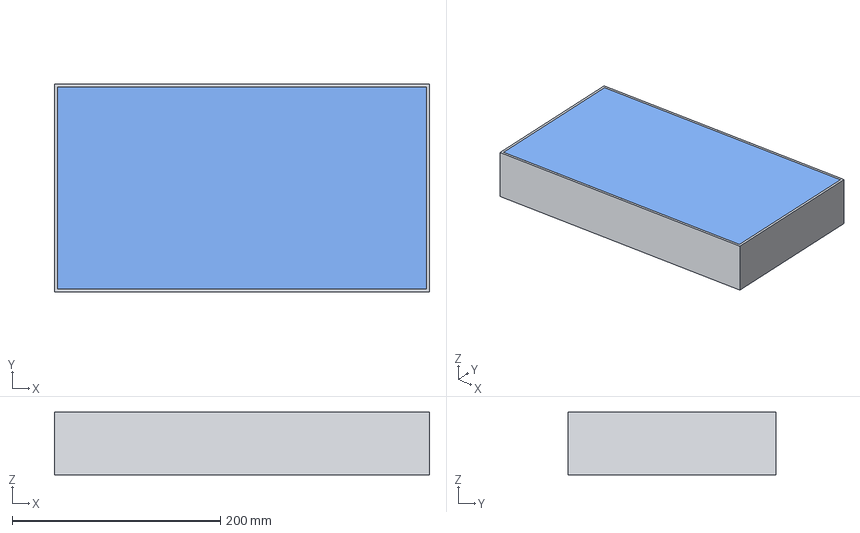
[picture p55: CAD file, 2026-10-25]
cad/step/gantry_p10_sign_cabinet_assy.step
360.0 x 200.0 x 60.0 mm
cabinet_tray_5052_3mm
p10_led_module_320x160
pc_front_window
led_driver_psu_120x80x20
