kgchord/ParkFlow/cad/step/edge_node_assy.step

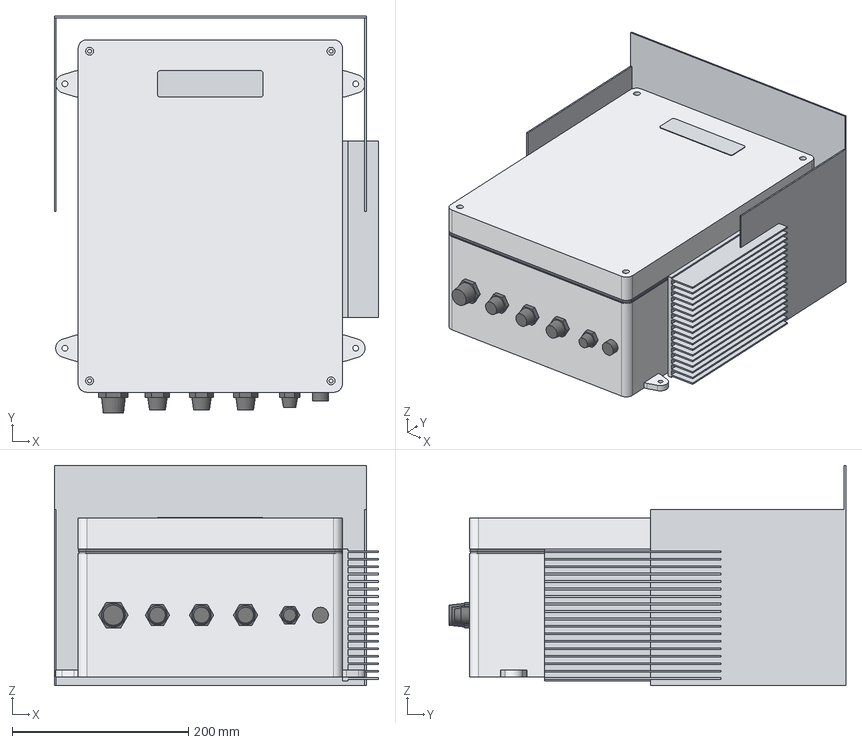
[picture p56: CAD file, 2026-10-25]
cad/step/edge_node_assy.step
368.0 x 450.5 x 250.0 mm
enclosure_base
mount_plate_3mm_5052
din_rail
din_device_0
din_device_1
din_device_2
din_device_3
din_device_4
din_device_5
din_device_6
din_device_7
din_device_8
poe_switch
smps_lrs150
buck_module
pi_tray
rpi5
ai_hat
heat_spreader_6061
thermal_pad
lane_controller_pcb
wire_trunking
enclosure_lid
lid_gasket
label_plate
heat_sink
heat_sink_window_gasket
gland_0_M25
gland_1_M20
gland_2_M20
gland_3_M20
gland_4_M16
vent_plug
sun_hood
