kgchord/ParkFlow/cad/step/barrier_housing_assy.step

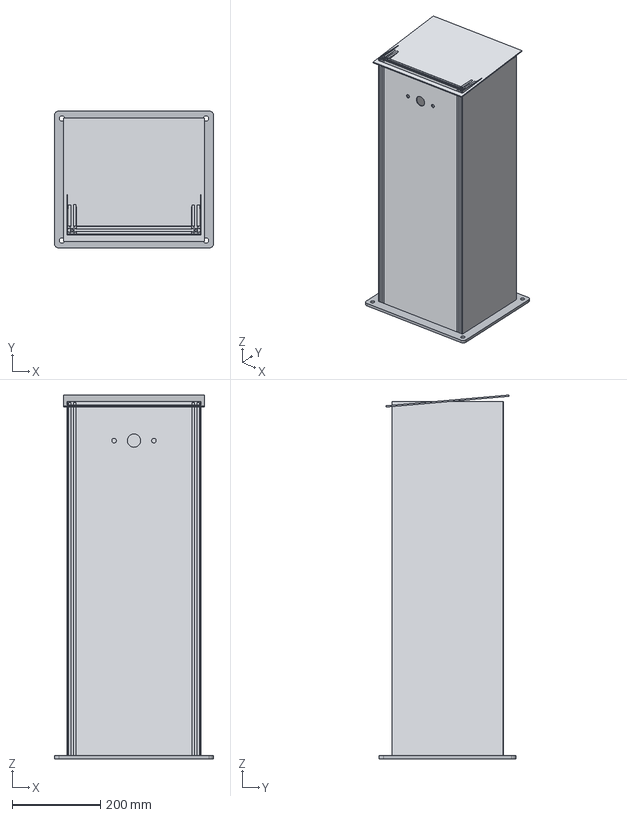
[picture p57: CAD file, 2026-10-25]
cad/step/barrier_housing_assy.step
360.0 x 310.0 x 823.2 mm
base_plate_8mm_MS
frame_post_-1-1
frame_post_-1+1
frame_post_+1-1
frame_post_+1+1
rail_x_z0_-1
rail_x_z0_+1
rail_y_z0_-1
rail_y_z0_+1
rail_x_z1_-1
rail_x_z1_+1
rail_y_z1_-1
rail_y_z1_+1
front_panel
back_panel
side_panel_-1
side_panel_+1
roof
