kgchord/ParkFlow/cad/step/occupancy_node_assy.step

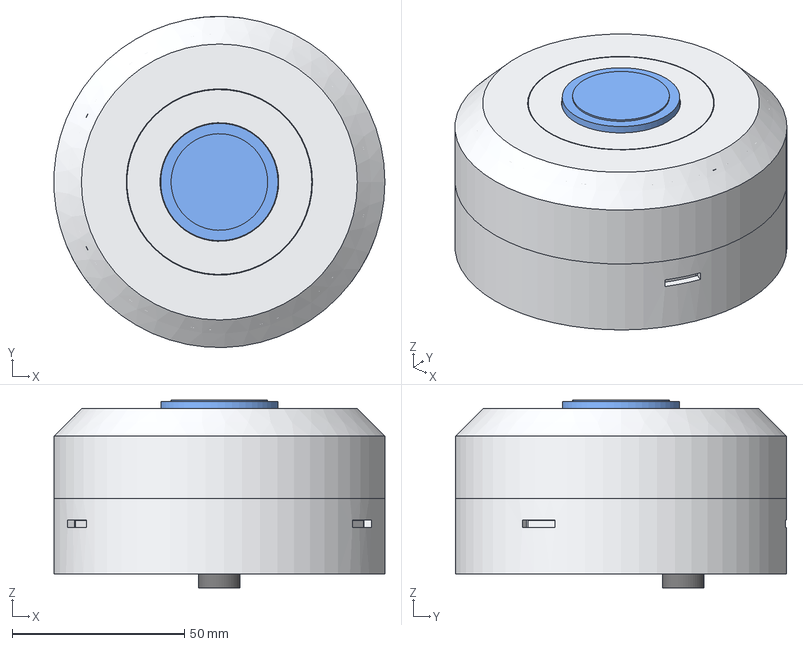
[picture p58: CAD file, 2026-10-25]
cad/step/occupancy_node_assy.step
95.9 x 96.0 x 54.5 mm
base
esp32c3
cable_grommet
cover_shell
probe_clamp_boss
led_seat
a02yyuw
ws2812_ring
diffuser
