kgchord/ParkFlow/cad/step/barrier_drive_train_assy.step

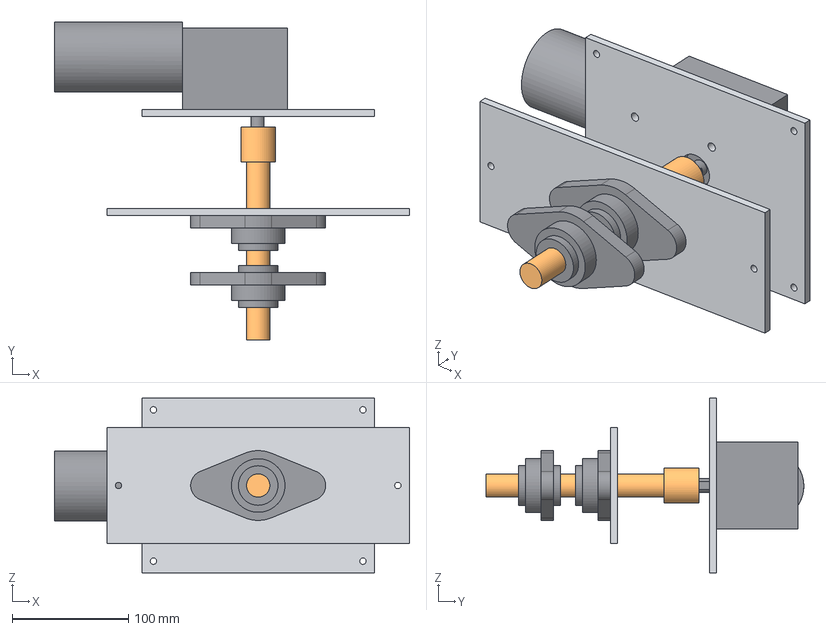
[picture p59: CAD file, 2026-10-25]
cad/step/barrier_drive_train_assy.step
305.0 x 273.0 x 150.0 mm
motor_plate
gearmotor
jaw_coupling
bearing_plate
flange_bearing_rear
flange_bearing_front
stub_shaft
