kgchord/ParkFlow/cad/step/gantry_base_weldment_assy.step

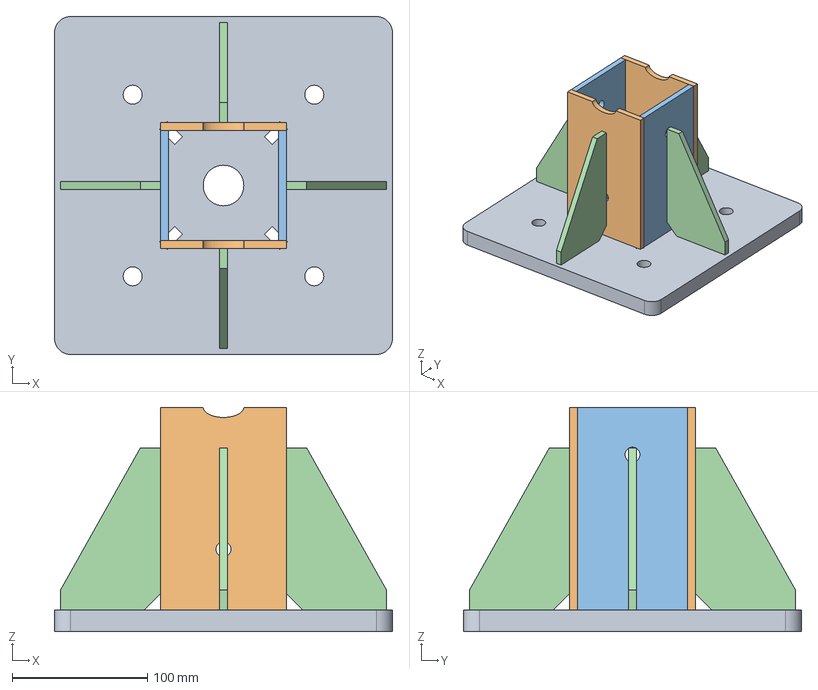
[picture p60: CAD file, 2026-10-25]
cad/step/gantry_base_weldment_assy.step
250.0 x 250.0 x 166.0 mm
base_plate_16mm_MS
socket_cheek_long_-y
socket_cheek_long_+y
socket_cheek_short_-x
socket_cheek_short_+x
gusset_0deg
gusset_90deg
gusset_180deg
gusset_270deg
