kgchord/ParkFlow/cad/step/barrier_photo_post_assy.step

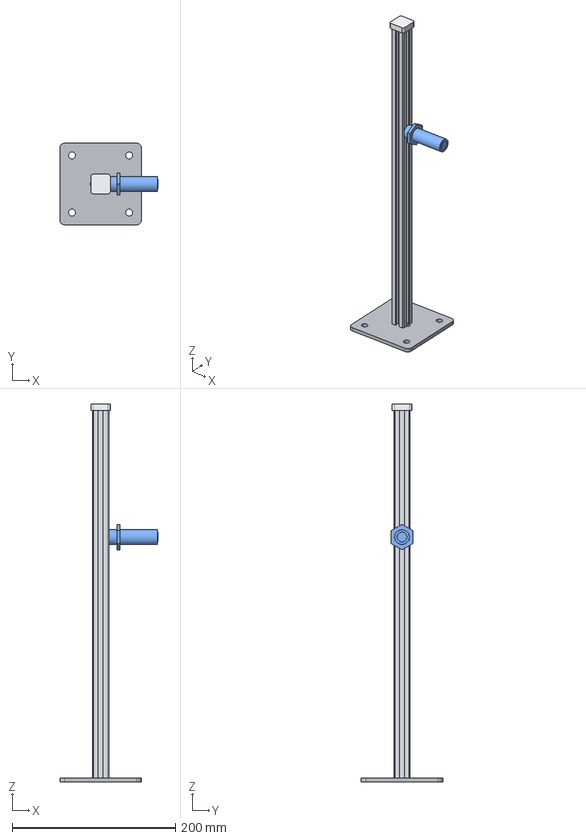
[picture p61: CAD file, 2026-10-25]
cad/step/barrier_photo_post_assy.step
120.6 x 100.0 x 463.0 mm
foot
post
cap
photo_head
