kgchord/ParkFlow/cad/dxf/socket_cheek_long.dxf

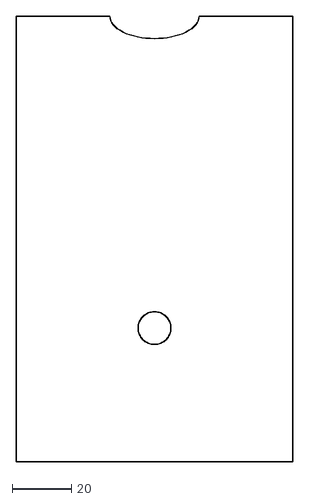
[picture p62: CAD file, 2026-10-25]
cad/dxf/socket_cheek_long.dxf
93.0 x 150.0
