kgchord/ParkFlow/cad/fea/models/base_weldment_t12.step

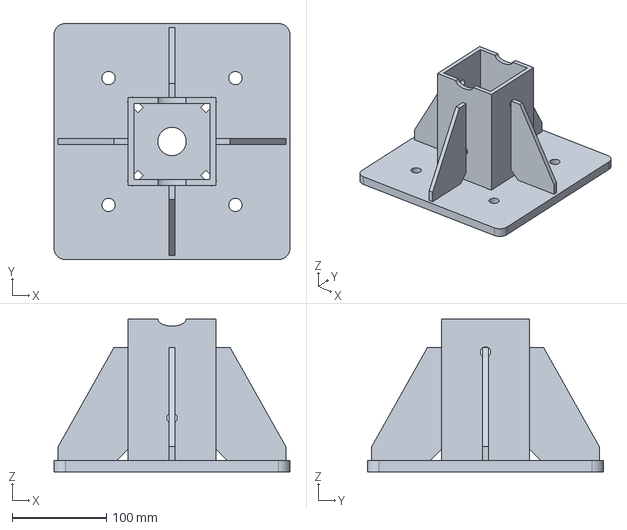
[picture p63: CAD file, 2026-10-25]
cad/fea/models/base_weldment_t12.step
250.0 x 250.0 x 162.0 mm
