kgchord/ParkFlow/cad/fea/models/repo_step_snapshot/barrier_boom_tube.step

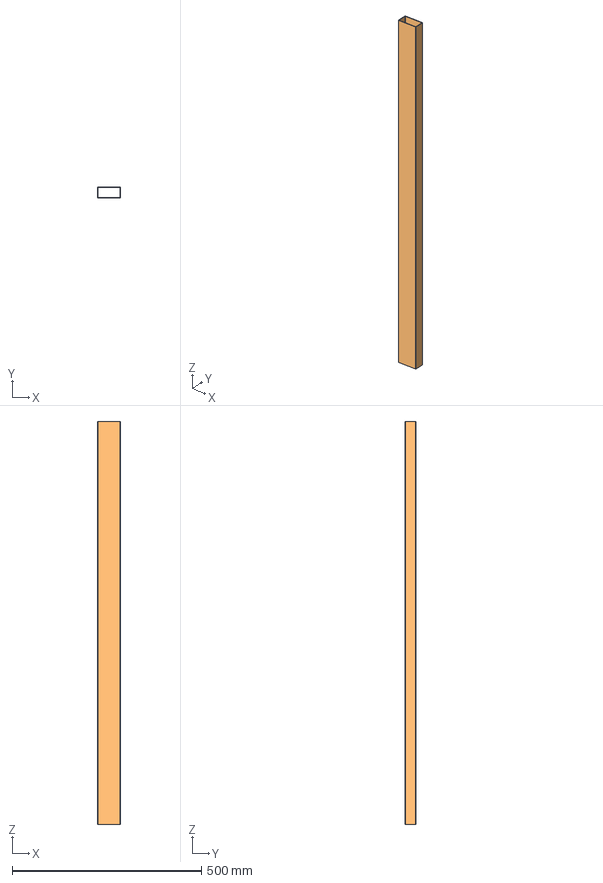
[picture p64: CAD file, 2026-10-25]
cad/fea/models/repo_step_snapshot/barrier_boom_tube.step
60.0 x 30.0 x 1065.0 mm
