kgchord/ParkFlow/cad/step/occ_cable_grommet_envelope.step

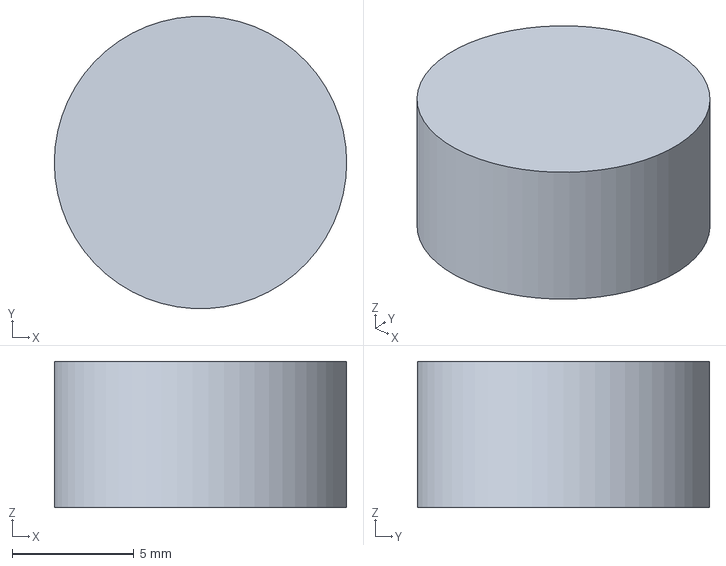
[picture p65: CAD file, 2026-10-25]
cad/step/occ_cable_grommet_envelope.step
12.0 x 12.0 x 6.00 mm
