kgchord/ParkFlow/cad/stl/cable_boot.stl

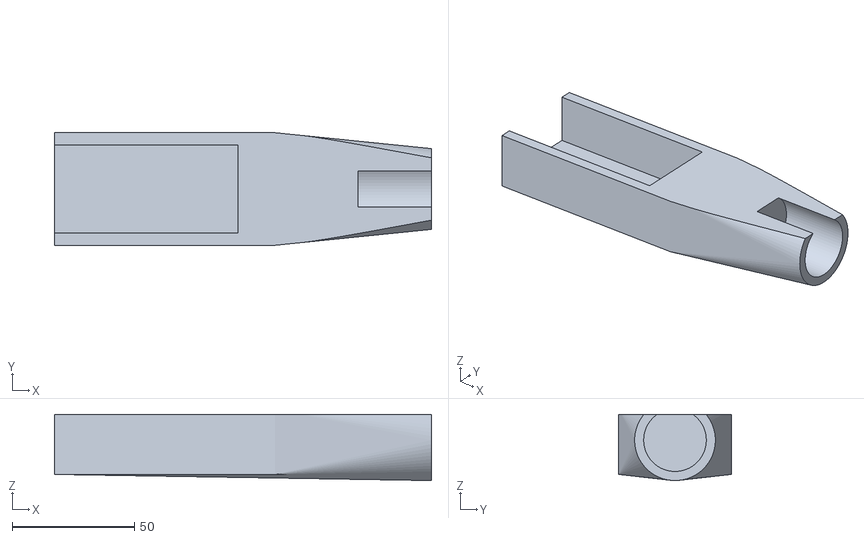
[picture p66: CAD file, 2026-10-25]
cad/stl/cable_boot.stl
154.0 x 46.0 x 27.0
