kgchord/ParkFlow/cad/dxf/photo_post_foot.dxf

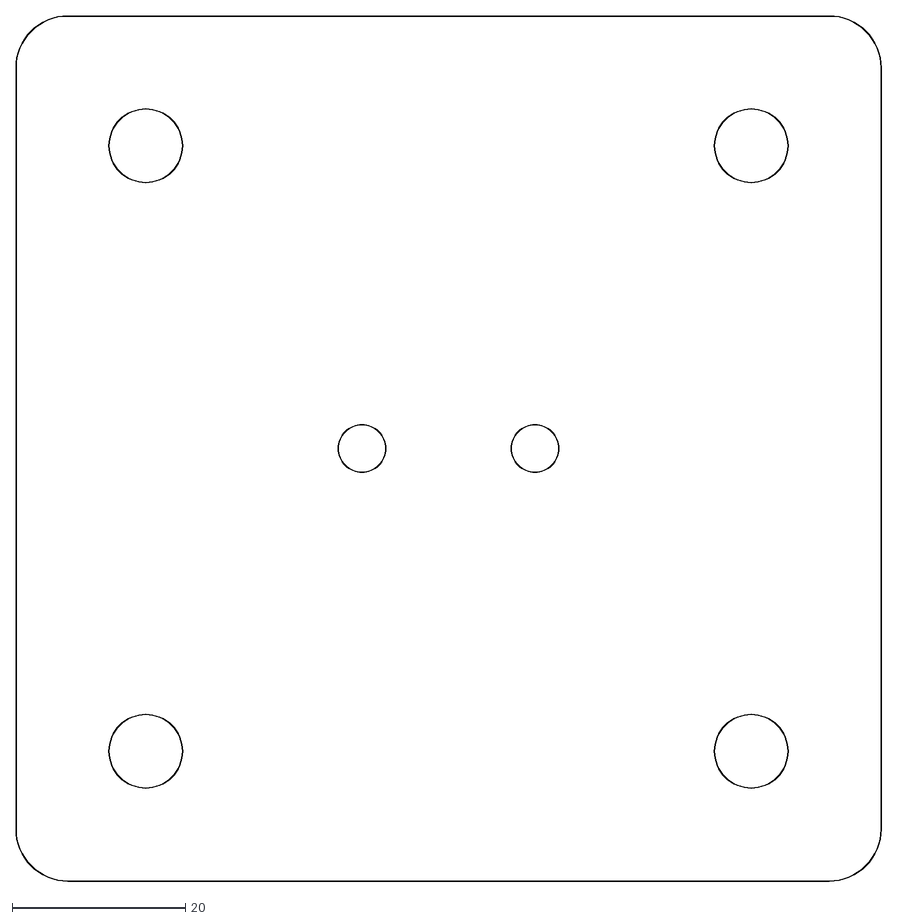
[picture p67: CAD file, 2026-10-25]
cad/dxf/photo_post_foot.dxf
100.0 x 100.0
