kgchord/ParkFlow/cad/fea/models/repo_step_snapshot/antenna_tilt_plate.step

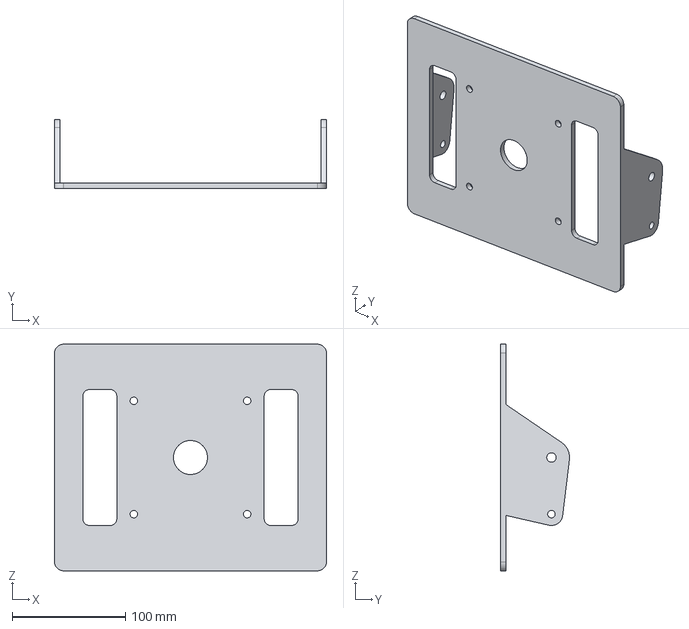
[picture p68: CAD file, 2026-10-25]
cad/fea/models/repo_step_snapshot/antenna_tilt_plate.step
240.0 x 61.0 x 200.0 mm
