kgchord/ParkFlow/cad/step/rfid_reader_envelope.step

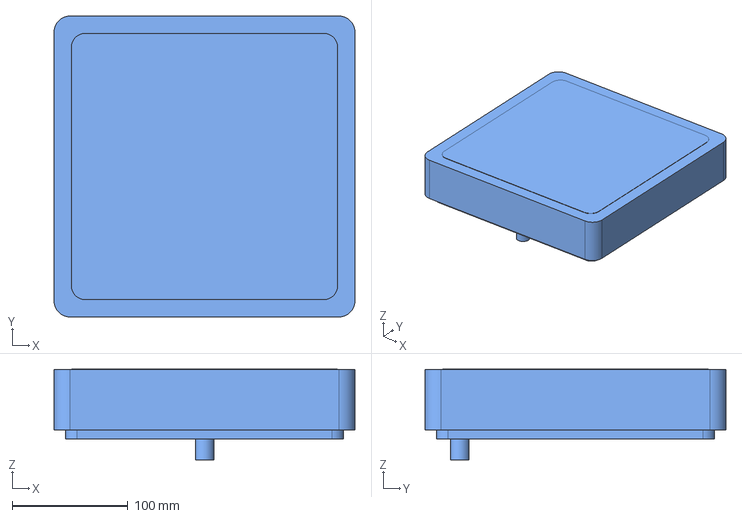
[picture p69: CAD file, 2026-10-25]
cad/step/rfid_reader_envelope.step
260.0 x 260.0 x 78.4 mm
