kgchord/ParkFlow/cad/stl/pb_post_cap.stl

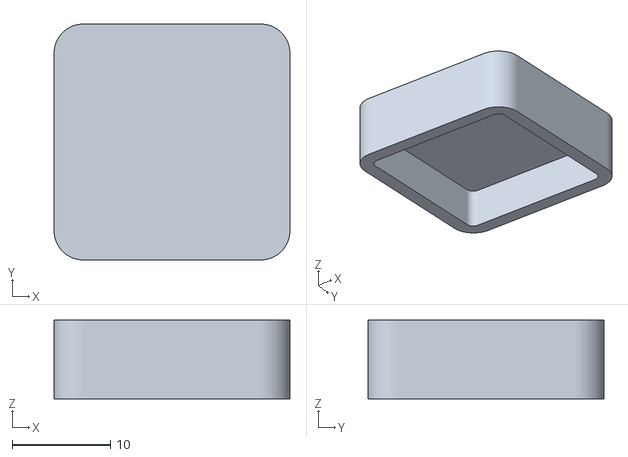
[picture p70: CAD file, 2026-10-25]
cad/stl/pb_post_cap.stl
24.0 x 24.0 x 8.00
