kgchord/ParkFlow/cad/dxf/gusset.dxf

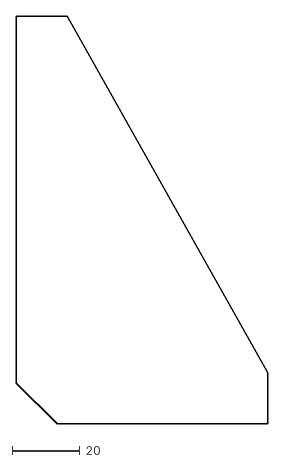
[picture p71: CAD file, 2026-10-25]
cad/dxf/gusset.dxf
74.0 x 120.0
