kgchord/ParkFlow/cad/fea/models/repo_step_snapshot/barrier_carrier_plate.step

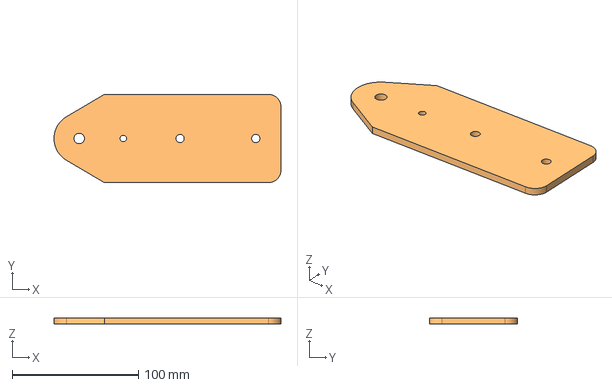
[picture p72: CAD file, 2026-10-25]
cad/fea/models/repo_step_snapshot/barrier_carrier_plate.step
180.0 x 70.0 x 5.00 mm
