kgchord/ParkFlow/cad/stl/pole_cap.stl

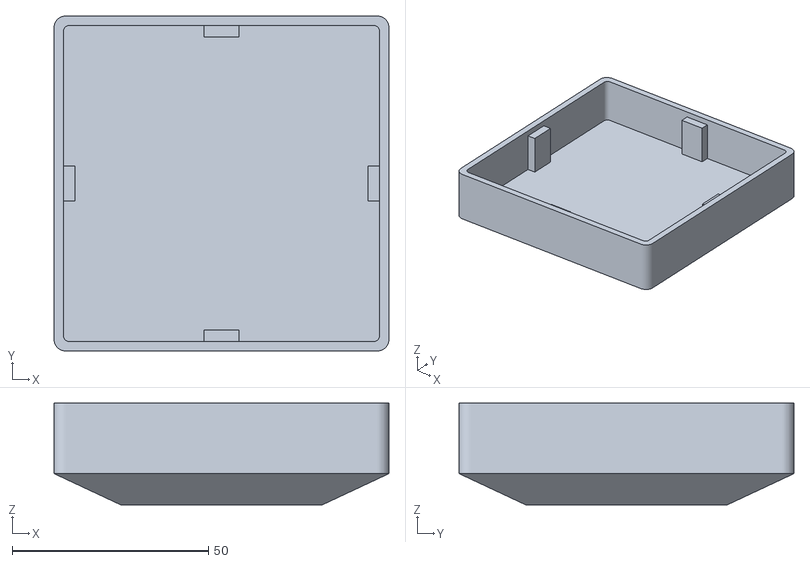
[picture p73: CAD file, 2026-10-25]
cad/stl/pole_cap.stl
85.4 x 85.4 x 26.0
