kgchord/ParkFlow/cad/dxf/limit_flag.dxf

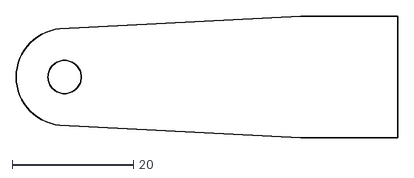
[picture p74: CAD file, 2026-10-25]
cad/dxf/limit_flag.dxf
63.0 x 20.0
