kgchord/ParkFlow/cad/fea/models/repo_step_snapshot/barrier_shear_pin.step

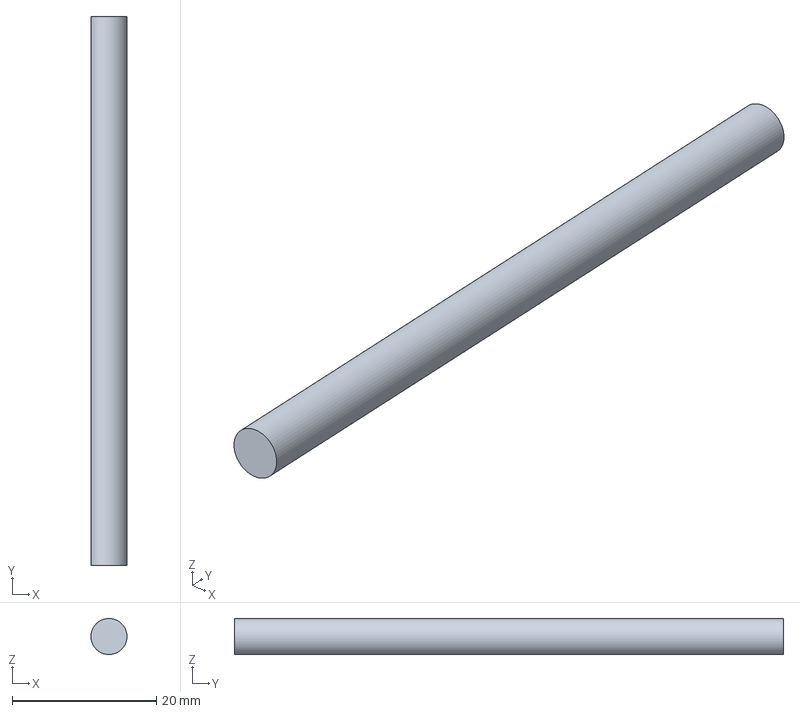
[picture p75: CAD file, 2026-10-25]
cad/fea/models/repo_step_snapshot/barrier_shear_pin.step
5.00 x 76.0 x 5.00 mm
