kgchord/ParkFlow/cad/step/barrier_cw_tail_bar.step

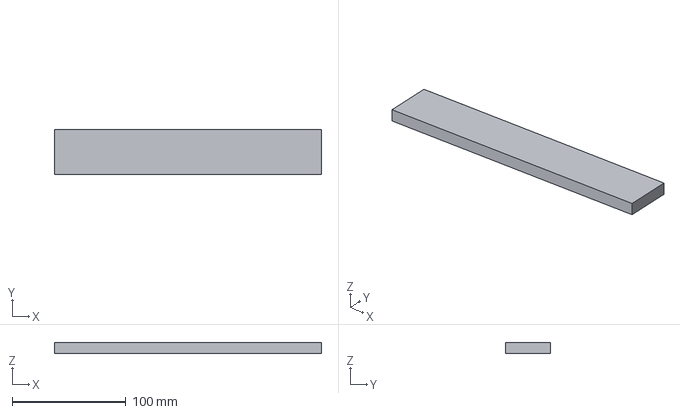
[picture p76: CAD file, 2026-10-25]
cad/step/barrier_cw_tail_bar.step
235.0 x 40.0 x 10.0 mm
