kgchord/ParkFlow/cad/stl/boom_tip_cap.stl

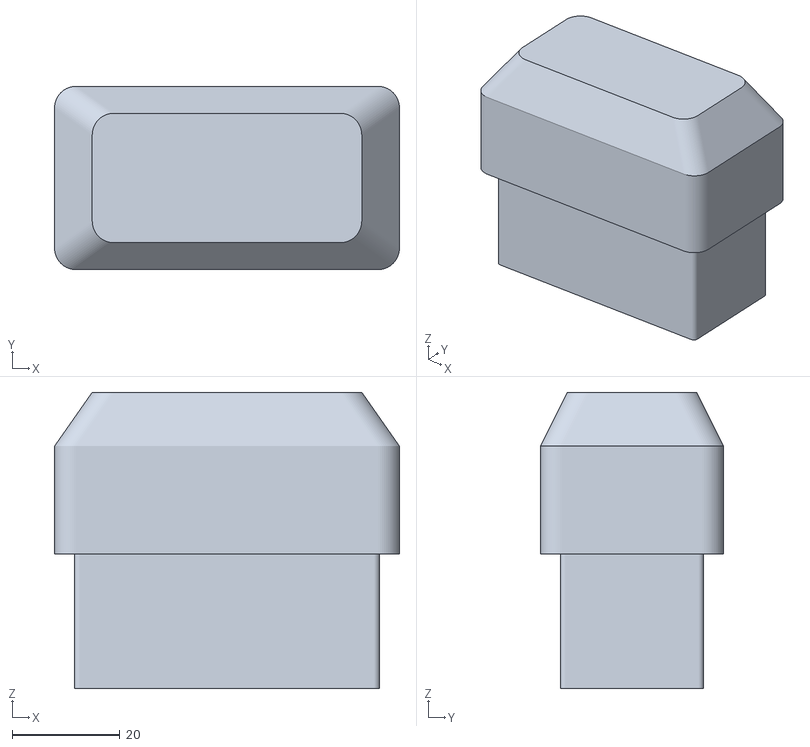
[picture p77: CAD file, 2026-10-25]
cad/stl/boom_tip_cap.stl
64.0 x 34.0 x 55.0
