kgchord/ParkFlow/cad/dxf/socket_cheek_short.dxf

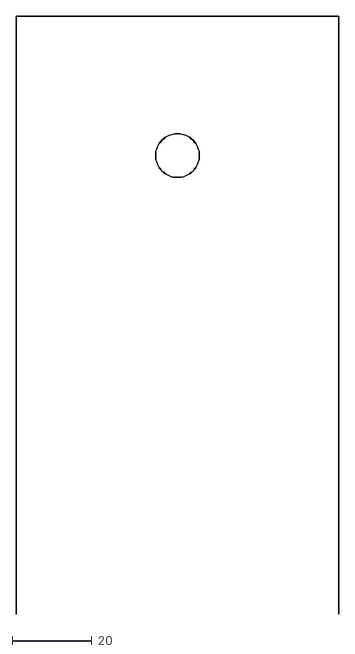
[picture p78: CAD file, 2026-10-25]
cad/dxf/socket_cheek_short.dxf
81.0 x 150.0
