kgchord/ParkFlow/cad/fea/models/repo_step_snapshot/antenna_yoke.step

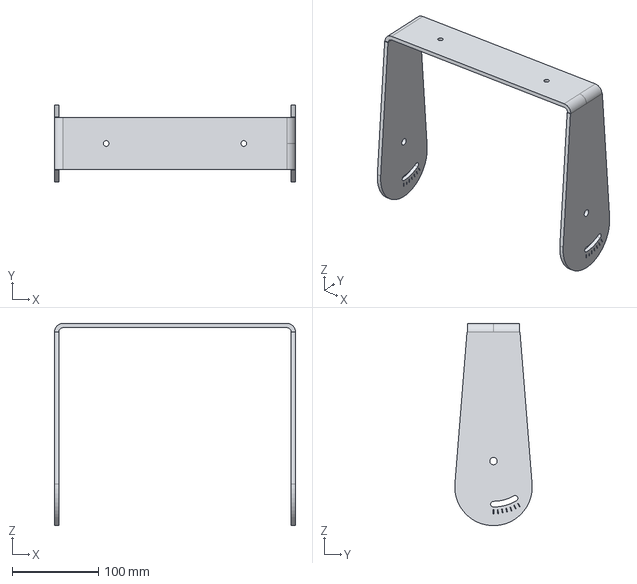
[picture p79: CAD file, 2026-10-25]
cad/fea/models/repo_step_snapshot/antenna_yoke.step
280.0 x 89.9 x 234.9 mm
