kgchord/ParkFlow/cad/dxf/camera_plate.dxf

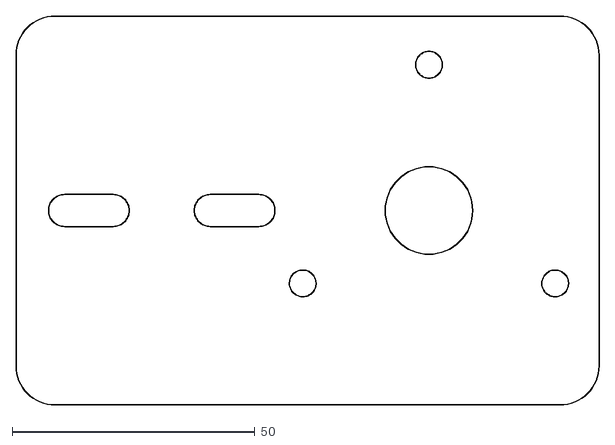
[picture p80: CAD file, 2026-10-25]
cad/dxf/camera_plate.dxf
120.0 x 80.0
