kgchord/ParkFlow/cad/step/gantry_gusset.step

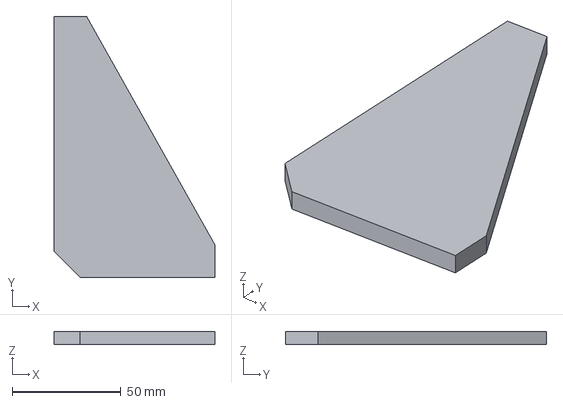
[picture p81: CAD file, 2026-10-25]
cad/step/gantry_gusset.step
74.0 x 120.0 x 6.00 mm
