kgchord/ParkFlow/cad/dxf/antenna_yoke_flat.dxf

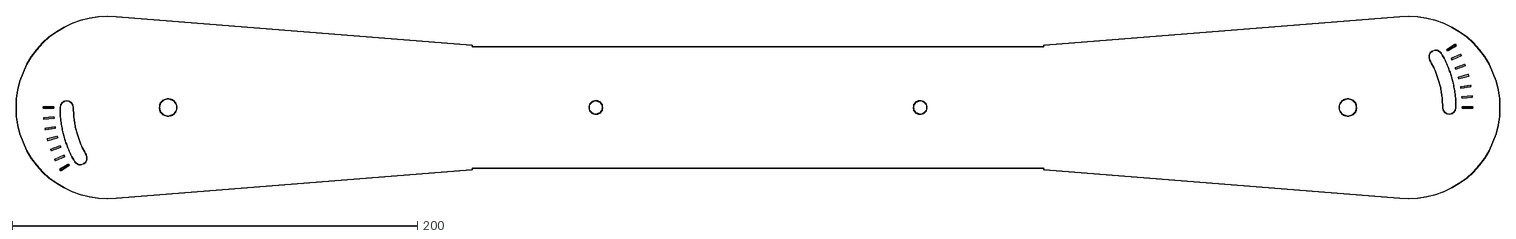
[picture p82: CAD file, 2026-10-25]
cad/dxf/antenna_yoke_flat.dxf
732.0 x 90.0
