kgchord/ParkFlow/cad/fea/models/repo_step_snapshot/barrier_hub.step

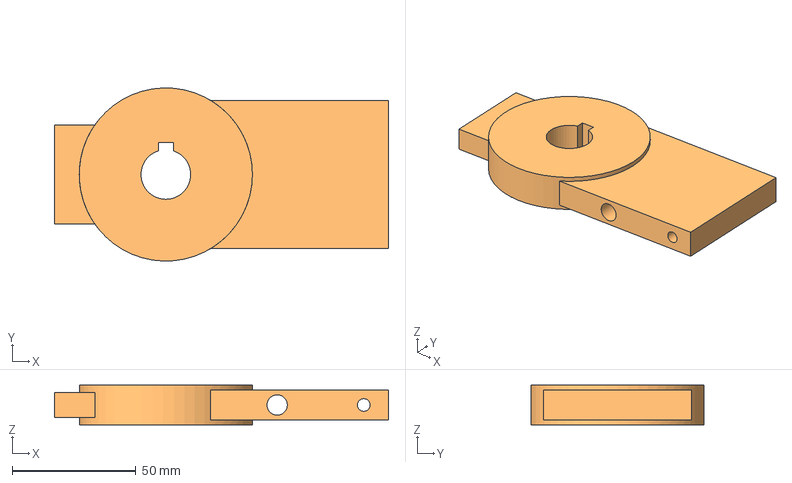
[picture p83: CAD file, 2026-10-25]
cad/fea/models/repo_step_snapshot/barrier_hub.step
135.0 x 70.0 x 16.0 mm
