kgchord/ParkFlow/cad/dxf/sign_bracket.dxf

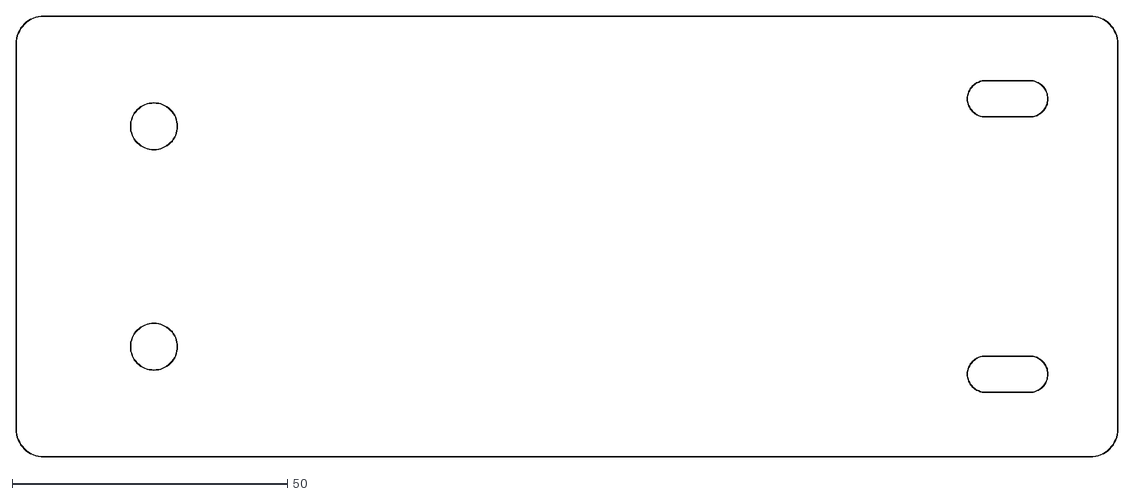
[picture p84: CAD file, 2026-10-25]
cad/dxf/sign_bracket.dxf
200.0 x 80.0
