kgchord/ParkFlow/cad/step/lane_rig_post_40x40.step

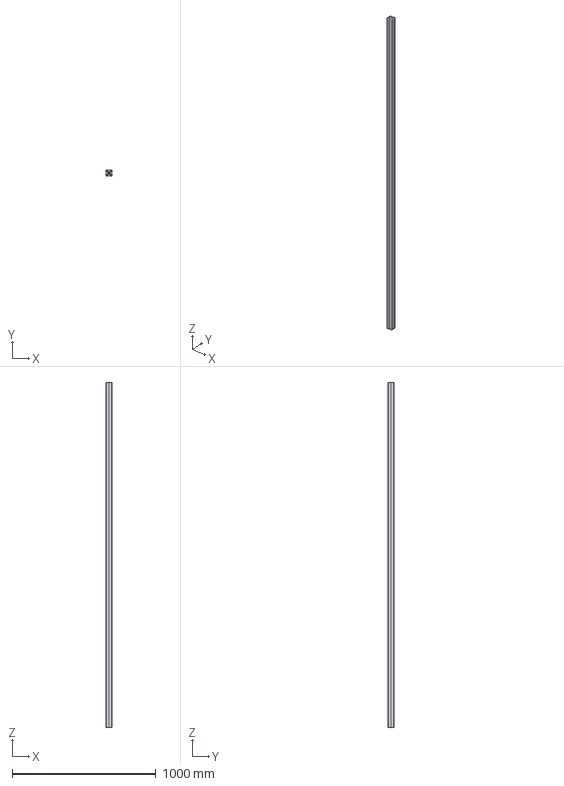
[picture p85: CAD file, 2026-10-25]
cad/step/lane_rig_post_40x40.step
40.0 x 40.0 x 2400.0 mm
