kgchord/ParkFlow/cad/dxf/boom_carrier_plate.dxf

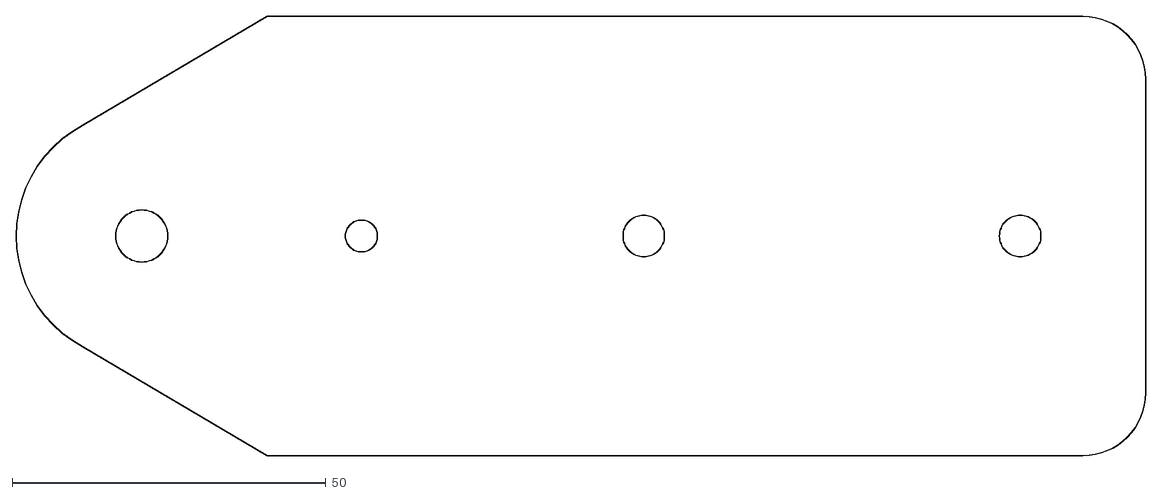
[picture p86: CAD file, 2026-10-25]
cad/dxf/boom_carrier_plate.dxf
180.0 x 70.0
