kgchord/ParkFlow/cad/fea/models/repo_step_snapshot/base_weldment.step

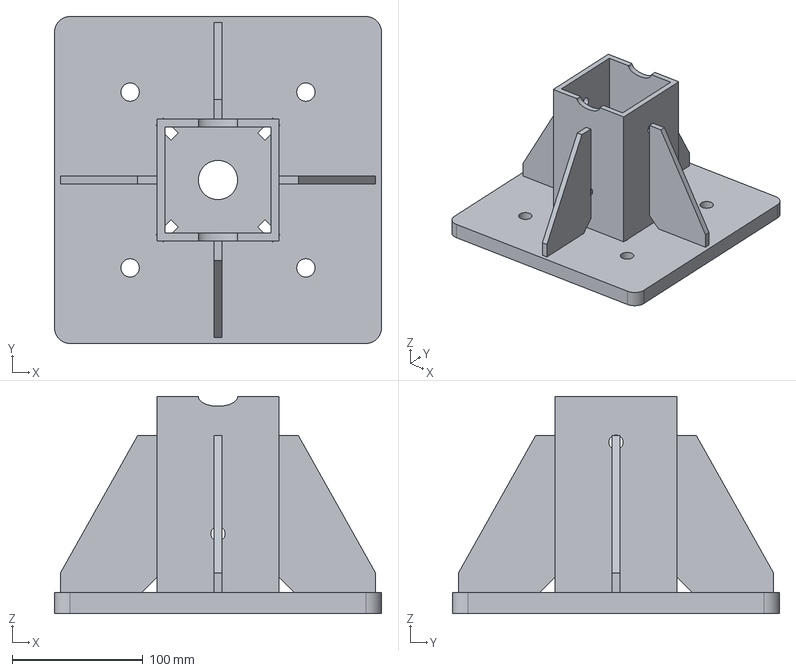
[picture p87: CAD file, 2026-10-25]
cad/fea/models/repo_step_snapshot/base_weldment.step
250.0 x 250.0 x 166.0 mm
