kgchord/ParkFlow/cad/step/barrier_limit_flag.step

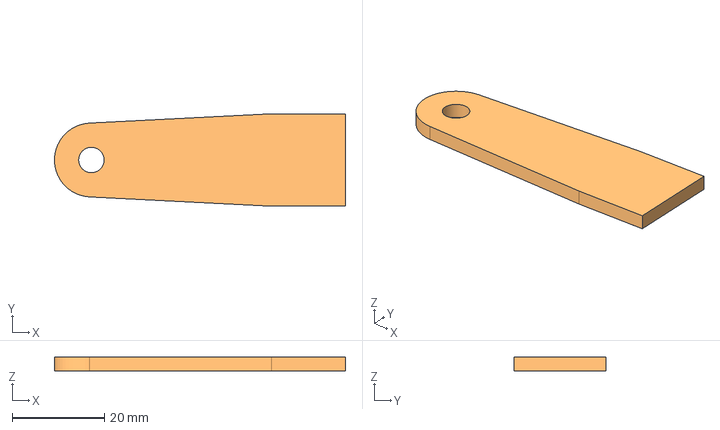
[picture p88: CAD file, 2026-10-25]
cad/step/barrier_limit_flag.step
63.0 x 20.0 x 3.00 mm
