kgchord/ParkFlow/cad/dxf/base_plate.dxf

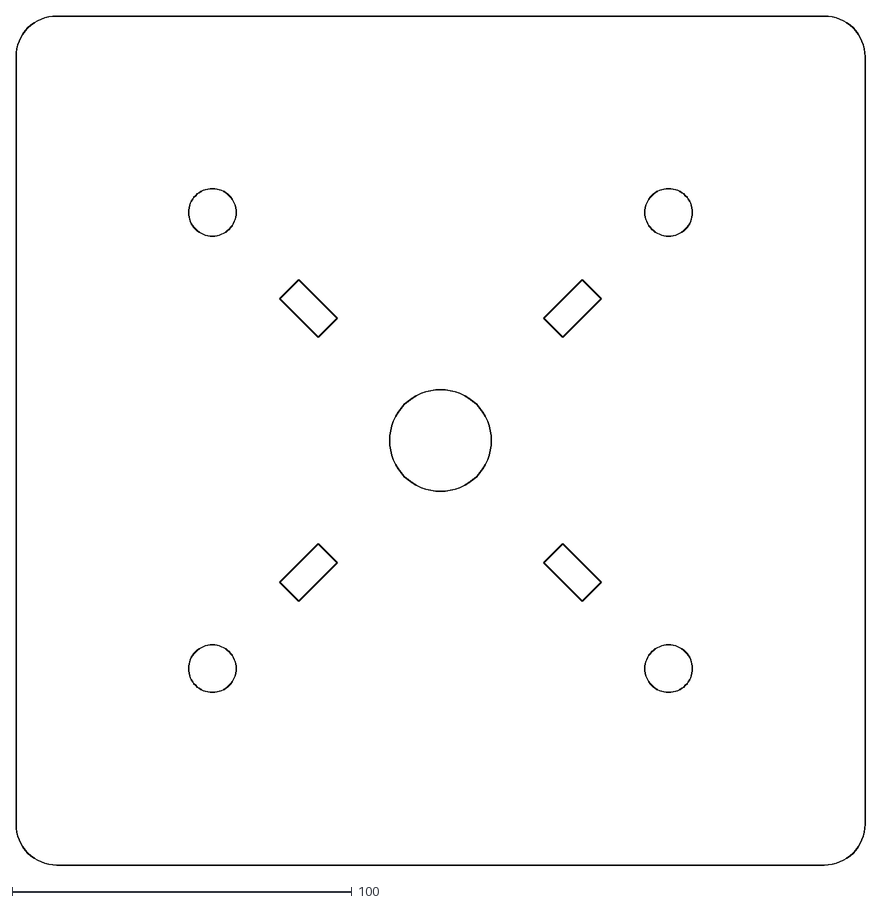
[picture p89: CAD file, 2026-10-25]
cad/dxf/base_plate.dxf
250.0 x 250.0
