kgchord/ParkFlow/cad/step/edge_din_device_2mod_envelope.step

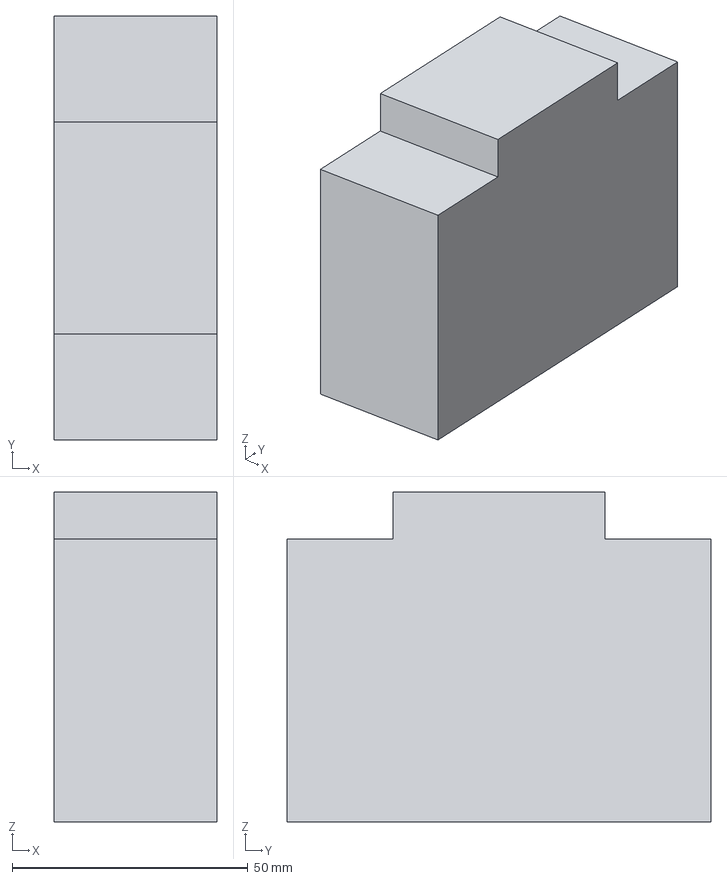
[picture p90: CAD file, 2026-10-25]
cad/step/edge_din_device_2mod_envelope.step
34.5 x 90.0 x 70.0 mm
