kgchord/ParkFlow/cad/dxf/antenna_tilt_flat.dxf

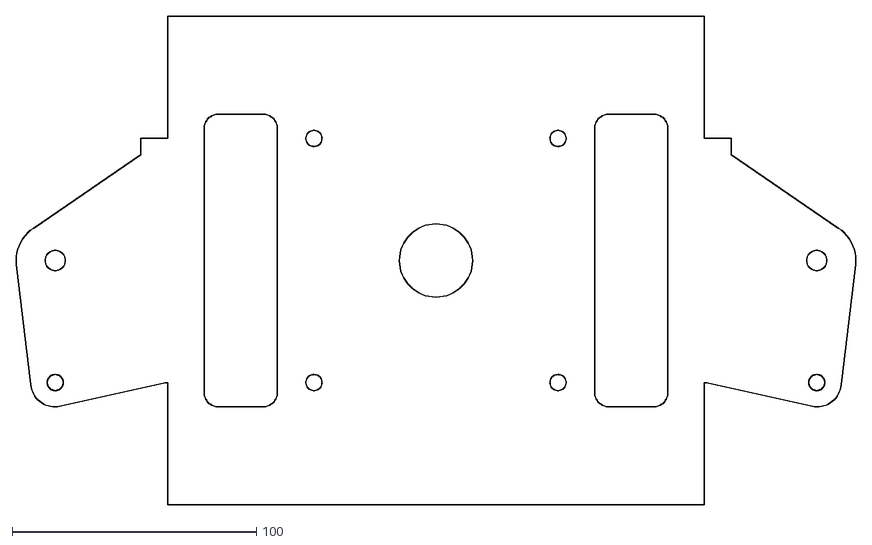
[picture p91: CAD file, 2026-10-25]
cad/dxf/antenna_tilt_flat.dxf
344.0 x 200.0
