kgchord/ParkFlow/cad/step/bullet_camera_aimed_envelope.step

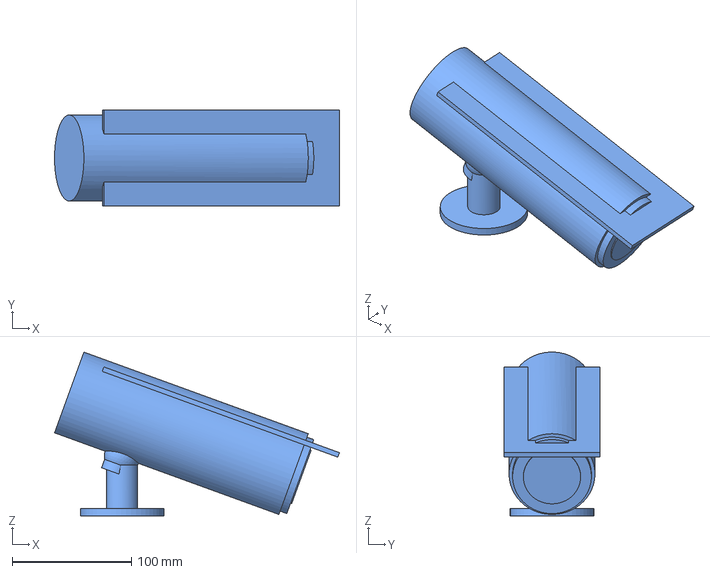
[picture p92: CAD file, 2026-10-25]
cad/step/bullet_camera_aimed_envelope.step
238.7 x 80.0 x 137.2 mm
