kgchord/ParkFlow/cad/dxf/edge_pole_bracket.dxf

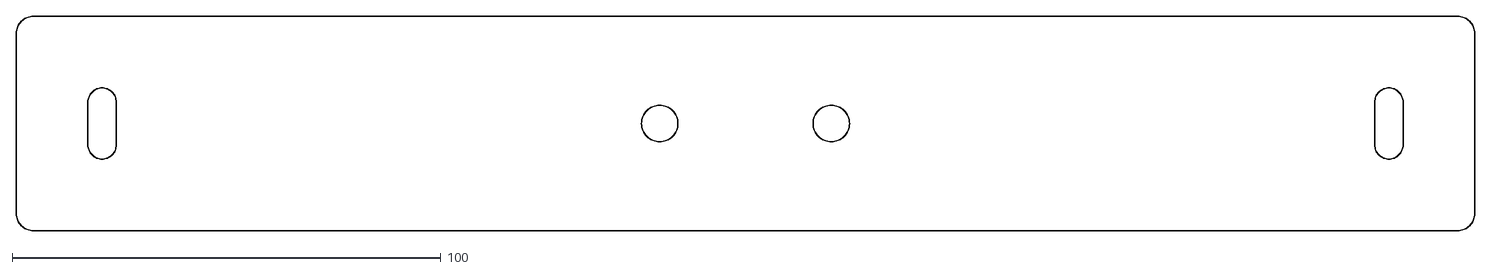
[picture p93: CAD file, 2026-10-25]
cad/dxf/edge_pole_bracket.dxf
340.0 x 50.0
