kgchord/ParkFlow/cad/step/edge_label_plate.step

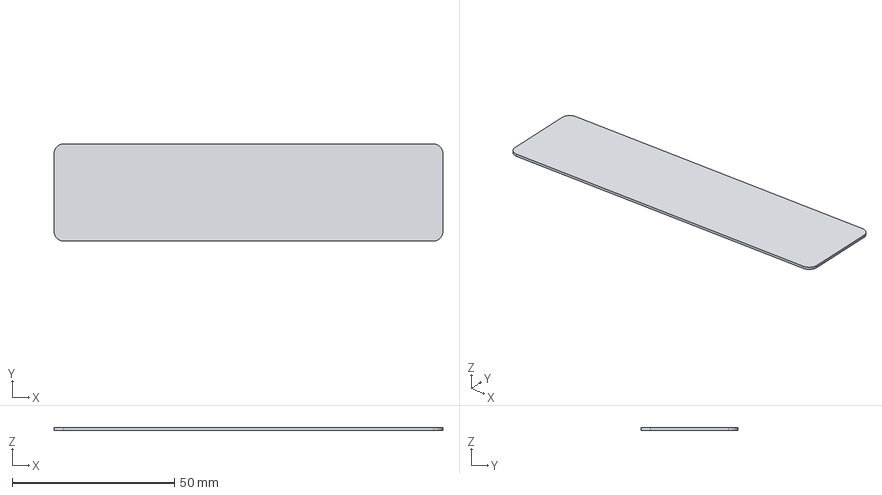
[picture p94: CAD file, 2026-10-25]
cad/step/edge_label_plate.step
120.0 x 30.0 x 0.8 mm
