kgchord/ParkFlow/cad/step/gantry_socket_cheek_short.step

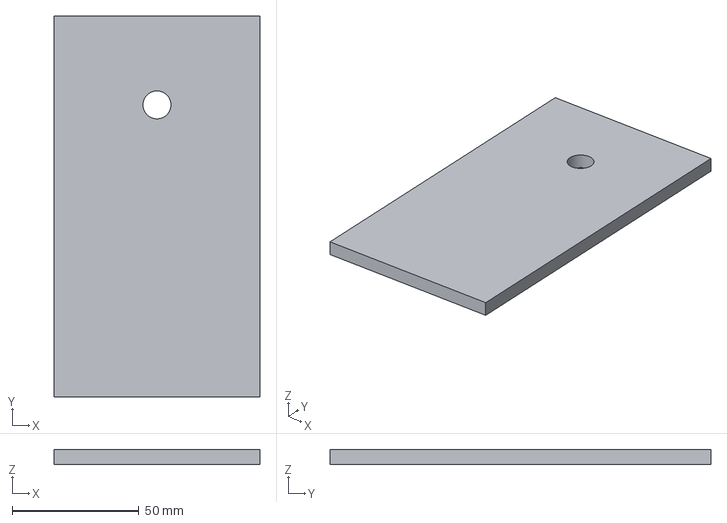
[picture p95: CAD file, 2026-10-25]
cad/step/gantry_socket_cheek_short.step
81.0 x 150.0 x 6.00 mm
