kgchord/ParkFlow/cad/step/edge_enclosure_base.step

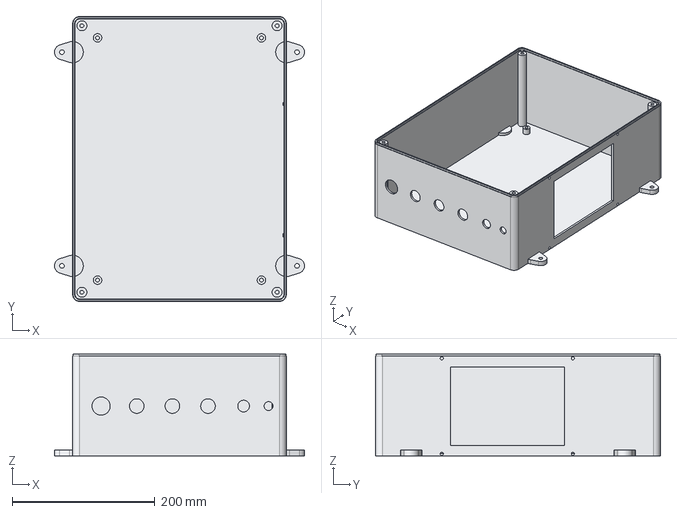
[picture p96: CAD file, 2026-10-25]
cad/step/edge_enclosure_base.step
351.0 x 400.0 x 143.0 mm
