kgchord/ParkFlow/cad/step/barrier_photo_post_20x20.step

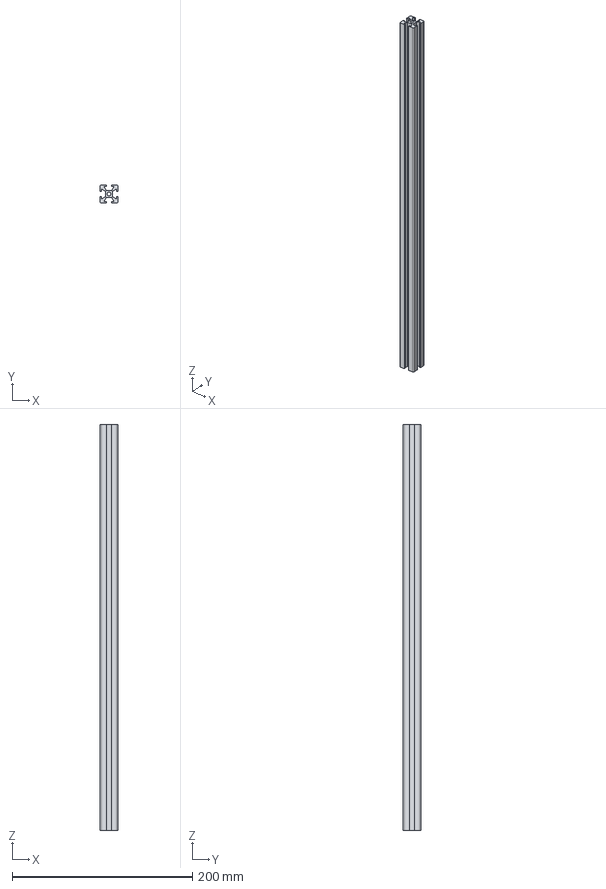
[picture p97: CAD file, 2026-10-25]
cad/step/barrier_photo_post_20x20.step
20.0 x 20.0 x 450.0 mm
