kgchord/ParkFlow/cad/step/edge_vent_plug_envelope.step

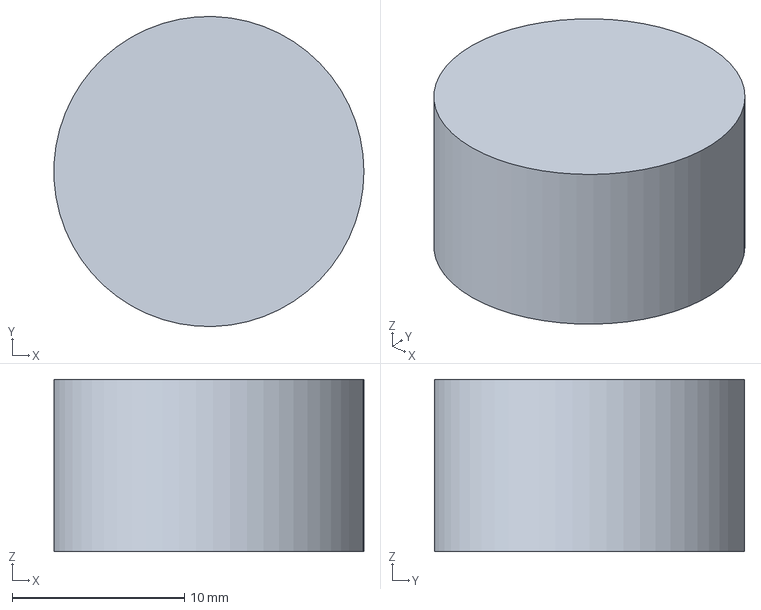
[picture p98: CAD file, 2026-10-25]
cad/step/edge_vent_plug_envelope.step
18.0 x 18.0 x 10.0 mm
