kgchord/ParkFlow/cad/step/barrier_photo_head_envelope.step

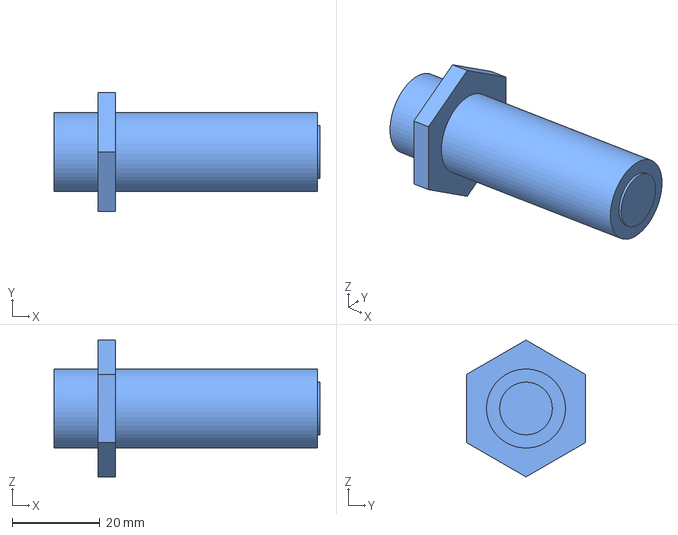
[picture p99: CAD file, 2026-10-25]
cad/step/barrier_photo_head_envelope.step
60.6 x 27.0 x 31.2 mm
