kgchord/ParkFlow/cad/step/gantry_base_plate.step

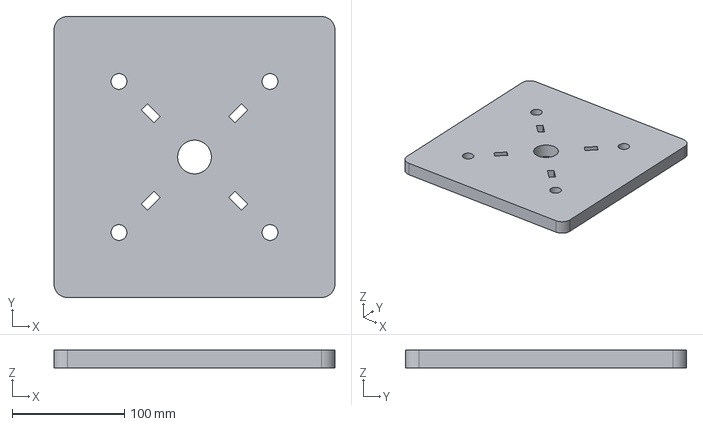
[picture p100: CAD file, 2026-10-25]
cad/step/gantry_base_plate.step
250.0 x 250.0 x 16.0 mm
