kgchord/ParkFlow/cad/step/edge_gland_M20_envelope.step

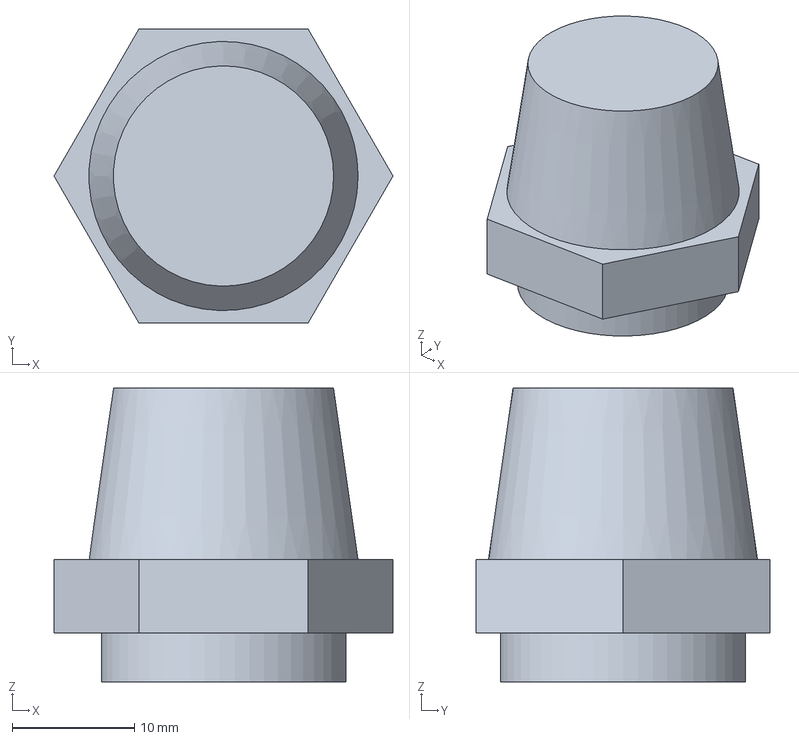
[picture p101: CAD file, 2026-10-25]
cad/step/edge_gland_M20_envelope.step
27.7 x 24.0 x 24.0 mm
