kgchord/ParkFlow/cad/step/edge_wire_trunking_envelope.step

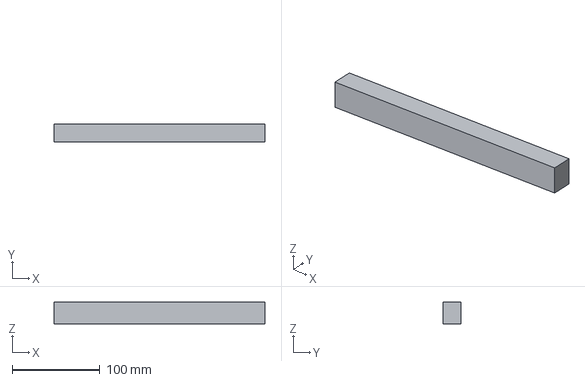
[picture p102: CAD file, 2026-10-25]
cad/step/edge_wire_trunking_envelope.step
240.0 x 20.0 x 25.0 mm
