kgchord/ParkFlow/cad/step/gantry_socket_cheek_long.step

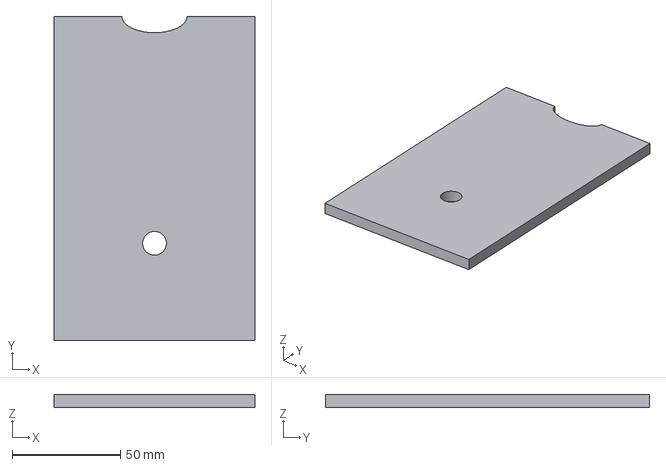
[picture p103: CAD file, 2026-10-25]
cad/step/gantry_socket_cheek_long.step
93.0 x 150.0 x 6.00 mm
