kgchord/ParkFlow/cad/step/lane_controller_pcb_envelope.step

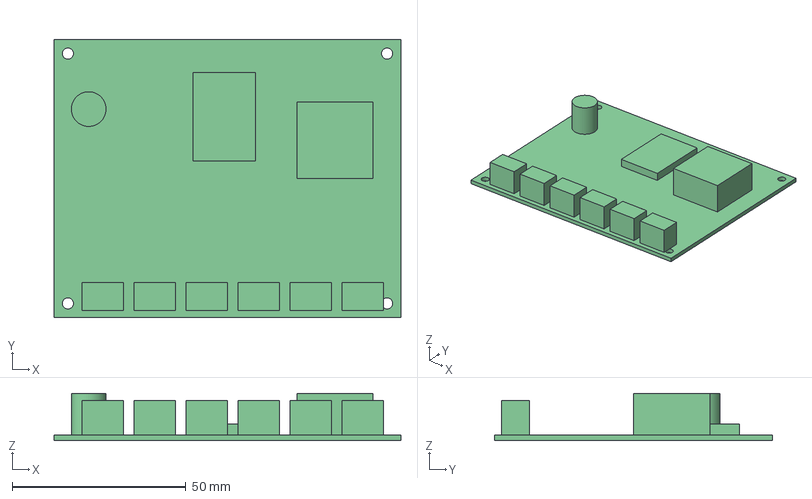
[picture p104: CAD file, 2026-10-25]
cad/step/lane_controller_pcb_envelope.step
100.0 x 80.0 x 13.6 mm
