kgchord/ParkFlow/cad/step/barrier_frame_post_20x20.step

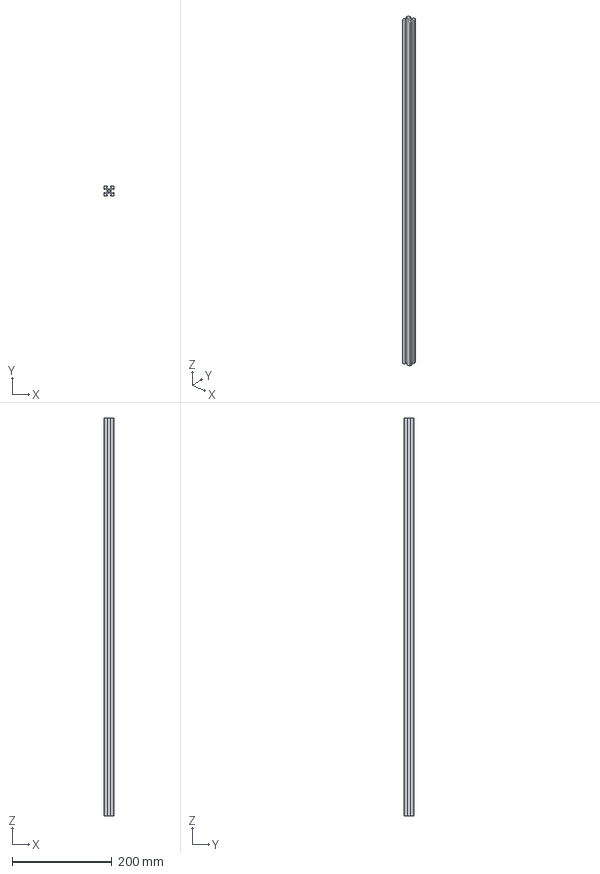
[picture p105: CAD file, 2026-10-25]
cad/step/barrier_frame_post_20x20.step
20.0 x 20.0 x 798.0 mm
