kgchord/ParkFlow/cad/step/bullet_camera_envelope.step

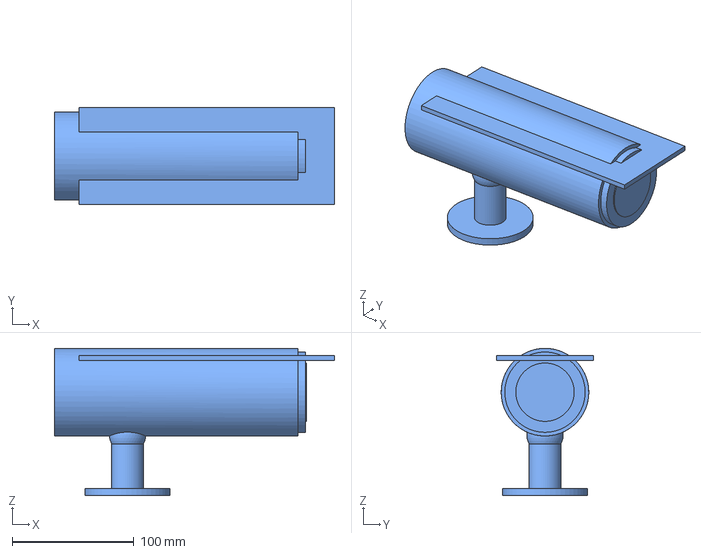
[picture p106: CAD file, 2026-10-25]
cad/step/bullet_camera_envelope.step
230.0 x 80.0 x 121.0 mm
