kgchord/ParkFlow/cad/step/barrier_stub_shaft.step

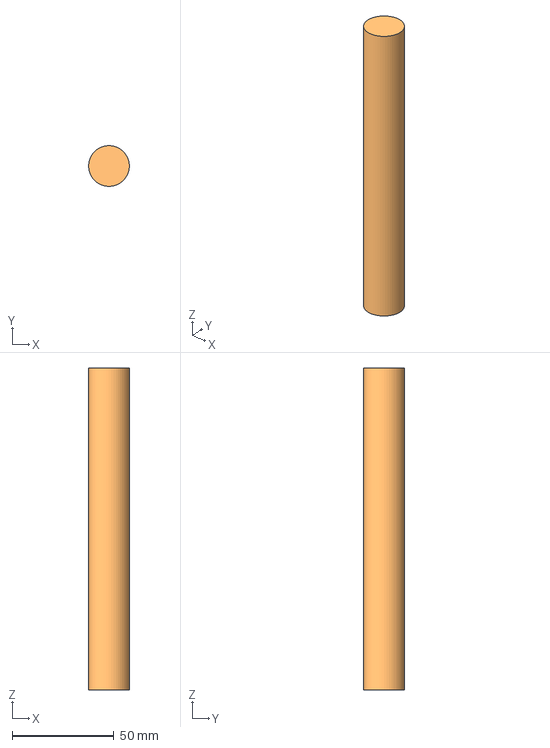
[picture p107: CAD file, 2026-10-25]
cad/step/barrier_stub_shaft.step
20.0 x 20.0 x 158.0 mm
