kgchord/ParkFlow/cad/step/occ_cover.step

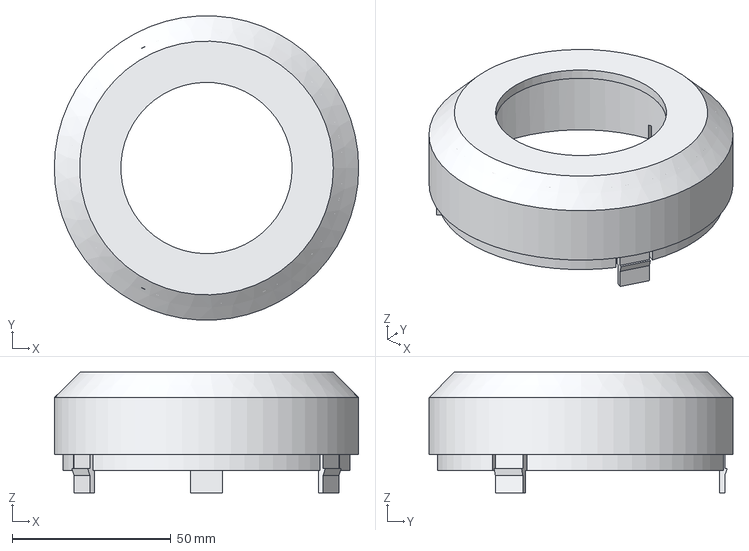
[picture p108: CAD file, 2026-10-25]
cad/step/occ_cover.step
96.0 x 95.9 x 38.0 mm
