kgchord/ParkFlow/cad/step/edge_din_rail_envelope.step

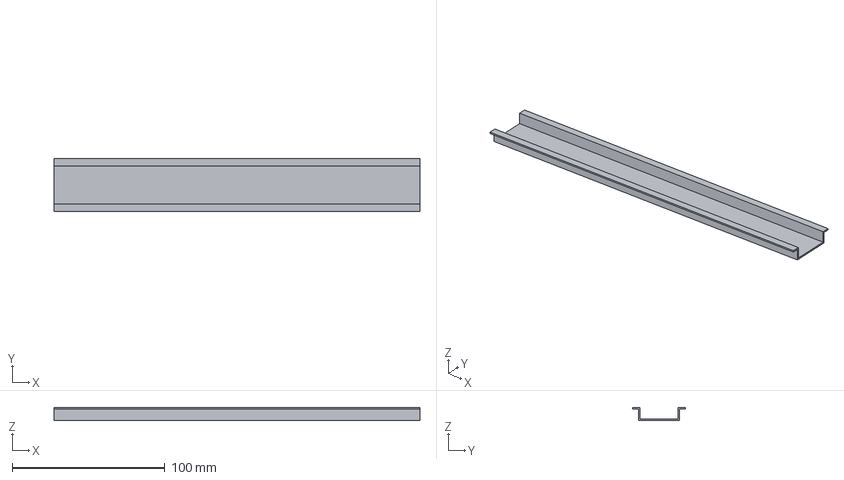
[picture p109: CAD file, 2026-10-25]
cad/step/edge_din_rail_envelope.step
240.0 x 35.0 x 8.50 mm
