kgchord/ParkFlow/cad/step/rpi5_envelope.step

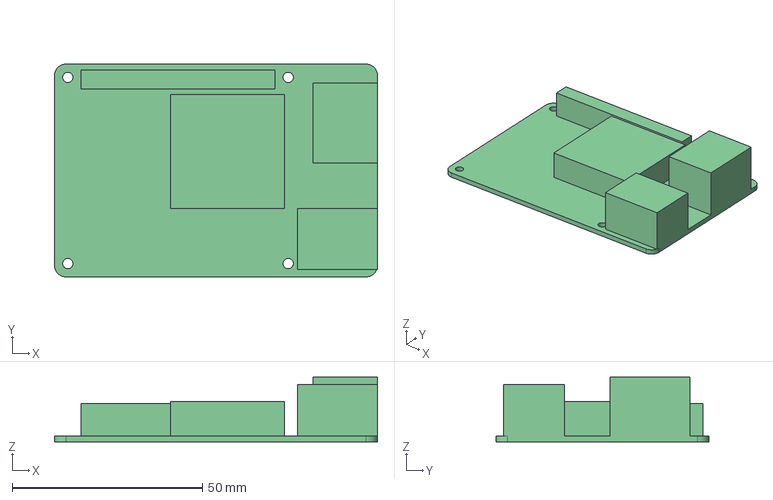
[picture p110: CAD file, 2026-10-25]
cad/step/rpi5_envelope.step
85.0 x 56.0 x 17.1 mm
