kgchord/ParkFlow/cad/step/gantry_corner_bracket40_envelope.step

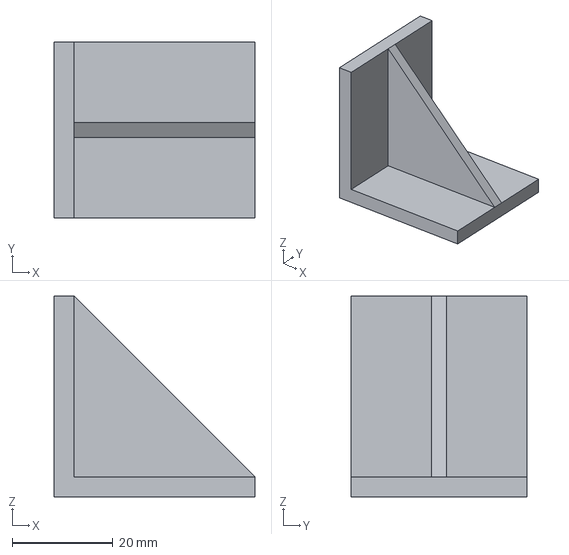
[picture p111: CAD file, 2026-10-25]
cad/step/gantry_corner_bracket40_envelope.step
40.0 x 35.0 x 40.0 mm
