kgchord/ParkFlow/cad/step/lane_rig_crossbar_40x40.step

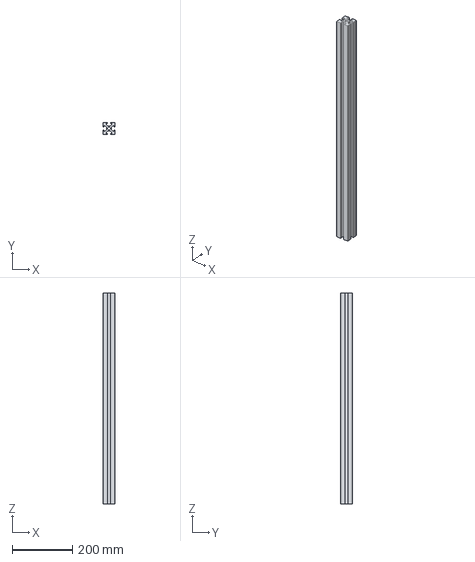
[picture p112: CAD file, 2026-10-25]
cad/step/lane_rig_crossbar_40x40.step
40.0 x 40.0 x 700.0 mm
