kgchord/ParkFlow/cad/step/edge_heat_spreader.step

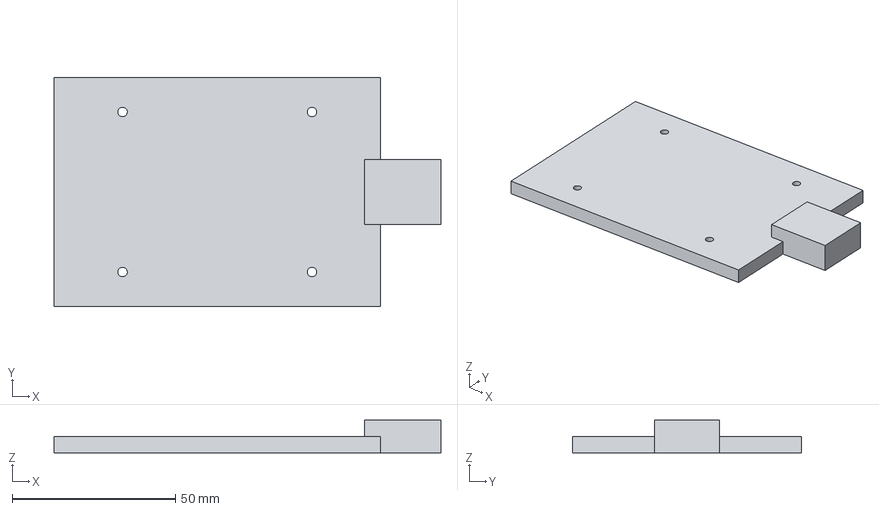
[picture p113: CAD file, 2026-10-25]
cad/step/edge_heat_spreader.step
118.5 x 70.0 x 10.0 mm
