kgchord/ParkFlow/cad/step/edge_pi_tray.step

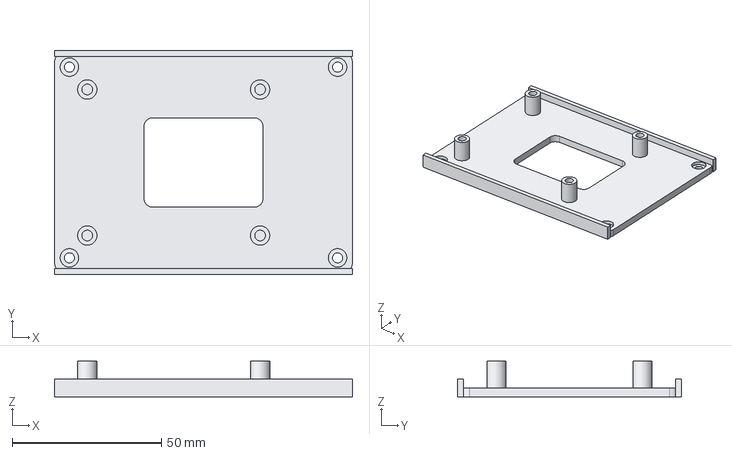
[picture p114: CAD file, 2026-10-25]
cad/step/edge_pi_tray.step
100.0 x 75.0 x 12.0 mm
