kgchord/ParkFlow/cad/step/barrier_gearmotor_envelope.step

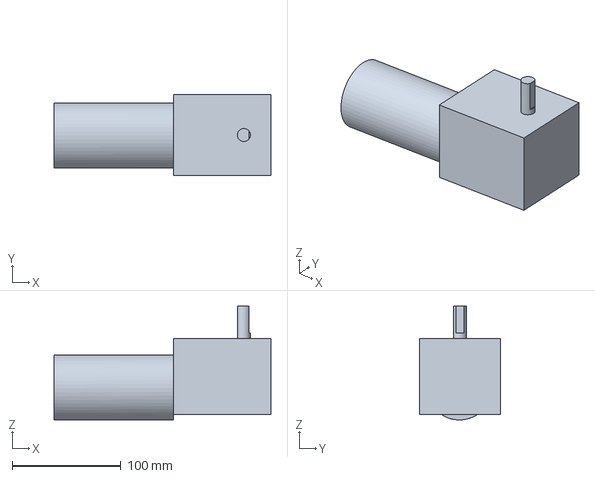
[picture p115: CAD file, 2026-10-25]
cad/step/barrier_gearmotor_envelope.step
200.0 x 75.0 x 105.0 mm
