kgchord/ParkFlow/cad/step/p10_module_envelope.step

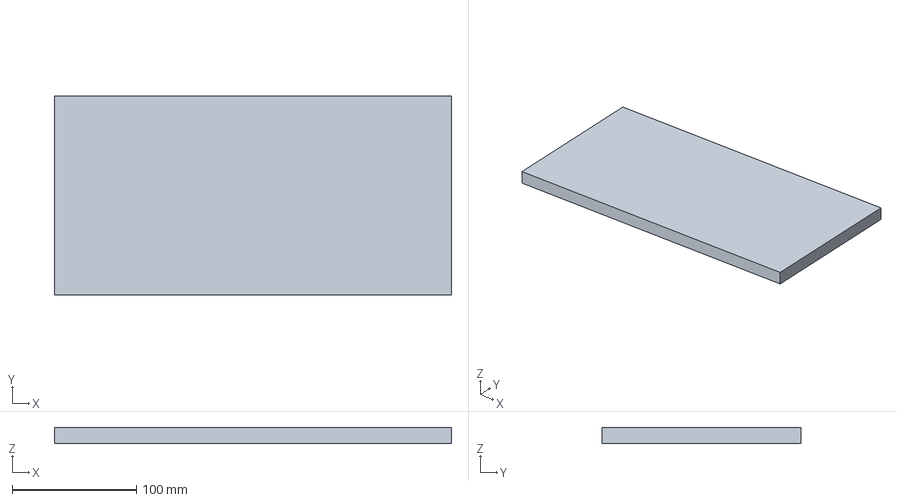
[picture p116: CAD file, 2026-10-25]
cad/step/p10_module_envelope.step
320.0 x 160.0 x 13.0 mm
