kgchord/ParkFlow/cad/step/gantry_sign_bracket.step

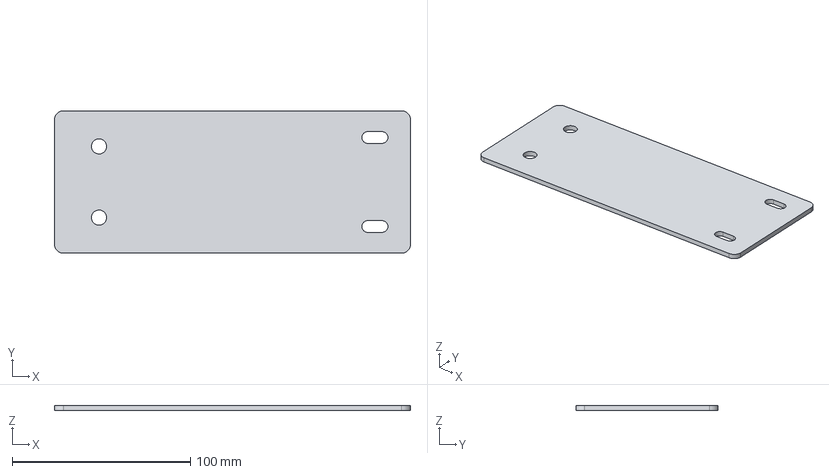
[picture p117: CAD file, 2026-10-25]
cad/step/gantry_sign_bracket.step
200.0 x 80.0 x 3.00 mm
