kgchord/ParkFlow/cad/step/barrier_limit_sensor_bracket.step

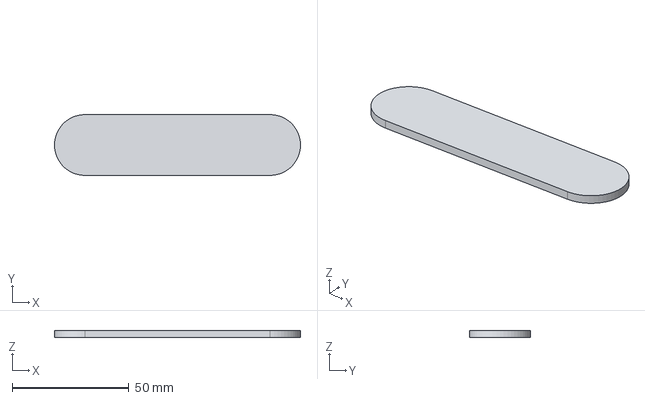
[picture p118: CAD file, 2026-10-25]
cad/step/barrier_limit_sensor_bracket.step
105.2 x 26.0 x 3.00 mm
