kgchord/ParkFlow/cad/step/edge_enclosure_lid.step

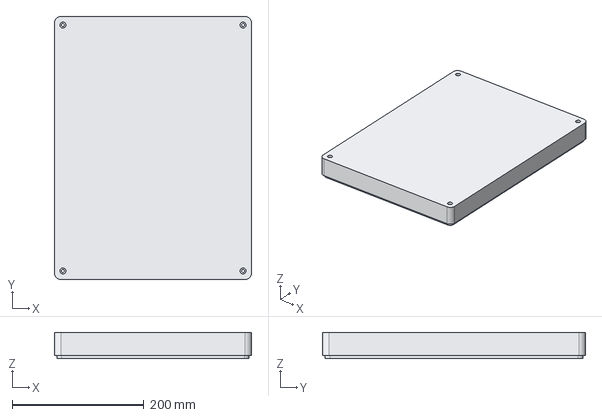
[picture p119: CAD file, 2026-10-25]
cad/step/edge_enclosure_lid.step
300.0 x 400.0 x 40.0 mm
