kgchord/ParkFlow/cad/step/gantry_cable_channel_envelope.step

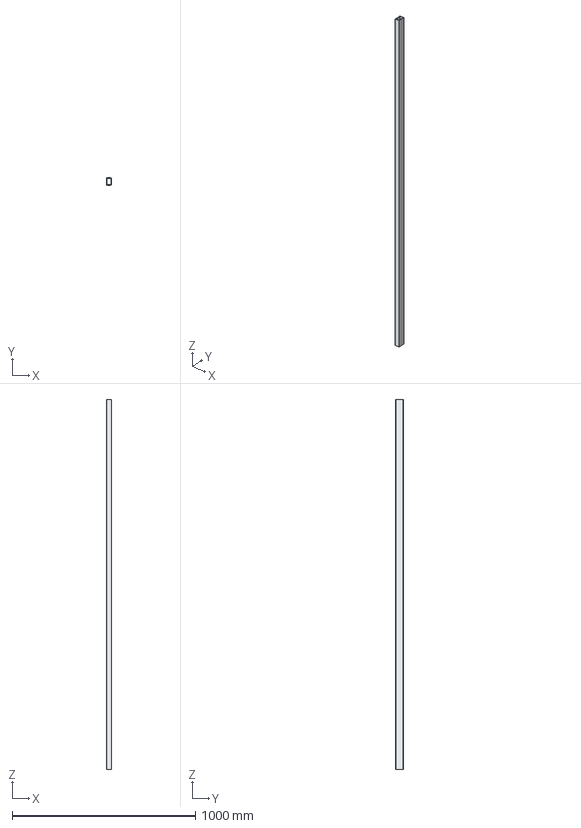
[picture p120: CAD file, 2026-10-25]
cad/step/gantry_cable_channel_envelope.step
26.5 x 42.0 x 2020.0 mm
