kgchord/ParkFlow/cad/step/occ_diffuser.step

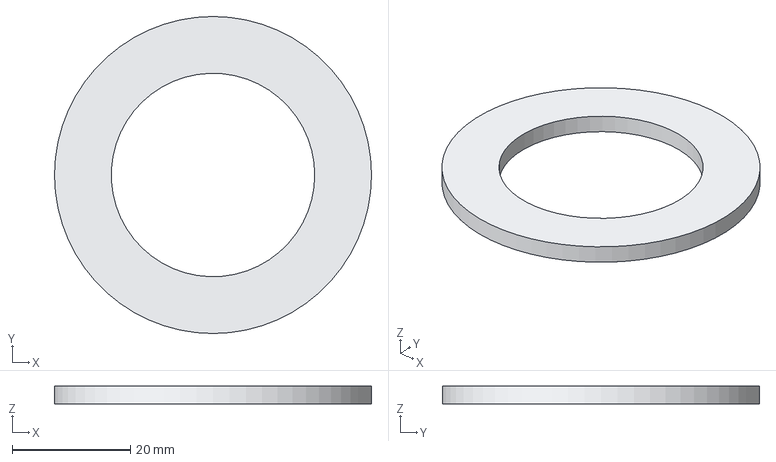
[picture p121: CAD file, 2026-10-25]
cad/step/occ_diffuser.step
53.6 x 53.6 x 3.00 mm
