kgchord/ParkFlow/cad/step/edge_mount_plate.step

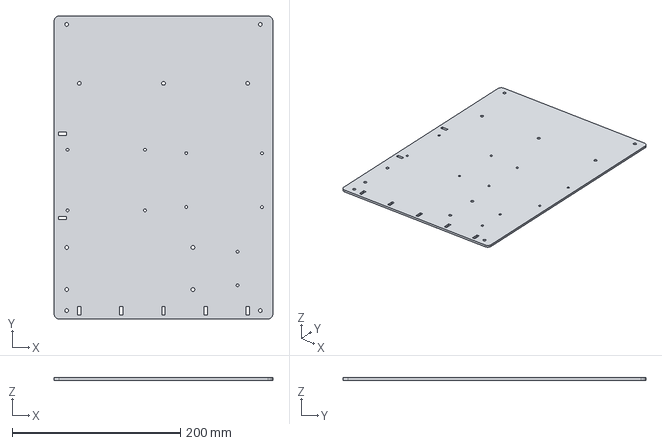
[picture p122: CAD file, 2026-10-25]
cad/step/edge_mount_plate.step
260.0 x 360.0 x 3.00 mm
