kgchord/ParkFlow/cad/step/barrier_jaw_coupling_envelope.step

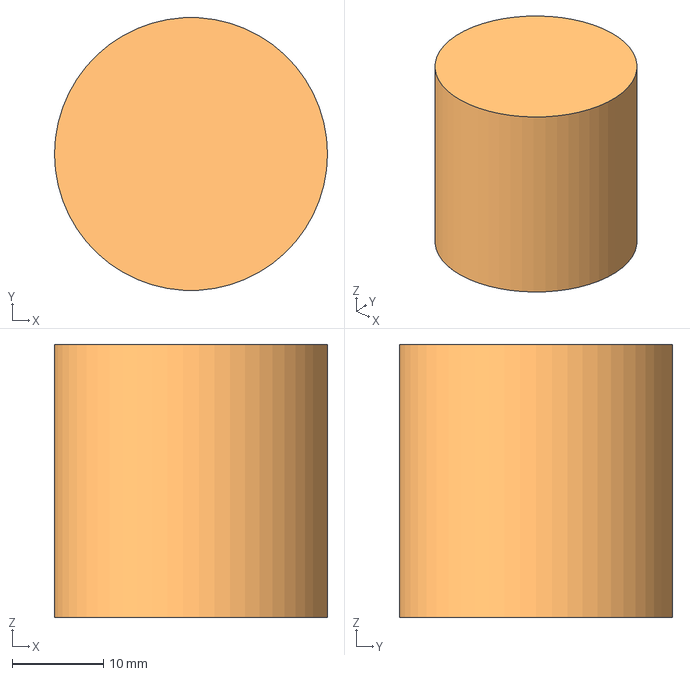
[picture p123: CAD file, 2026-10-25]
cad/step/barrier_jaw_coupling_envelope.step
30.0 x 29.9 x 30.0 mm
