kgchord/ParkFlow/cad/step/smps_lrs150_envelope.step

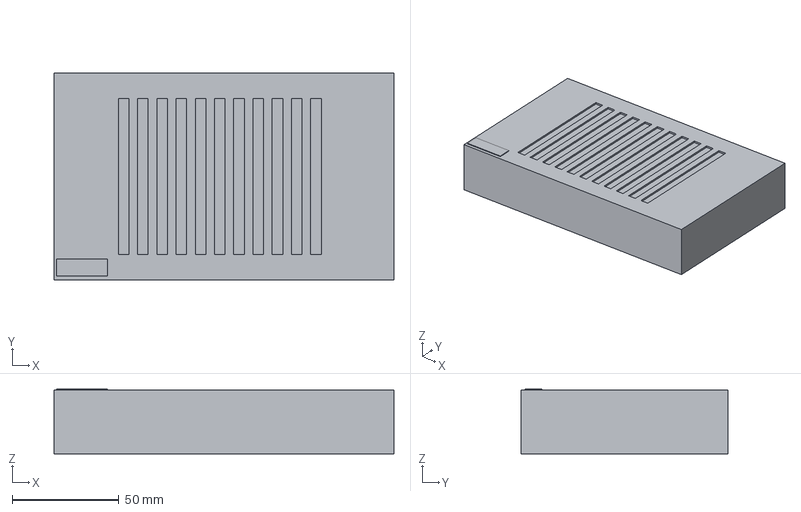
[picture p124: CAD file, 2026-10-25]
cad/step/smps_lrs150_envelope.step
159.1 x 97.0 x 30.4 mm
