kgchord/ParkFlow/cad/step/occ_led_seat.step

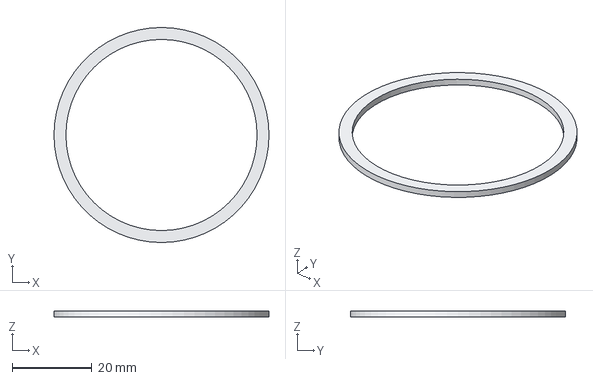
[picture p125: CAD file, 2026-10-25]
cad/step/occ_led_seat.step
54.0 x 54.0 x 1.50 mm
