kgchord/ParkFlow/cad/step/barrier_back_panel.step

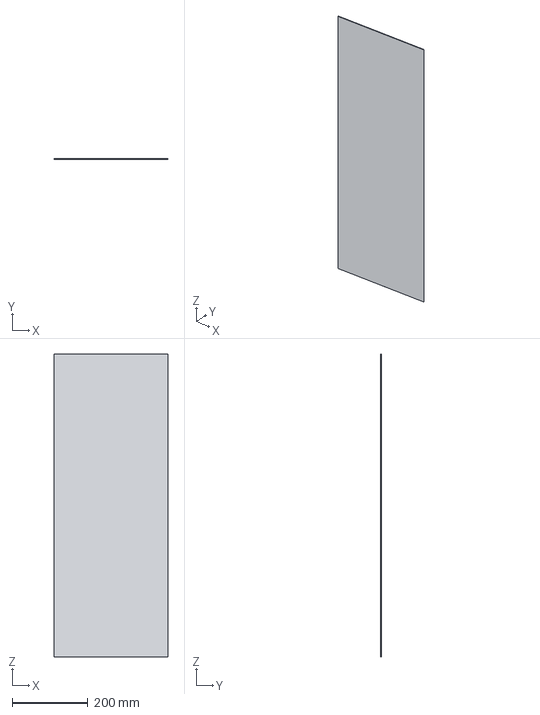
[picture p126: CAD file, 2026-10-25]
cad/step/barrier_back_panel.step
300.0 x 2.00 x 800.0 mm
