kgchord/ParkFlow/cad/step/edge_sun_hood.step

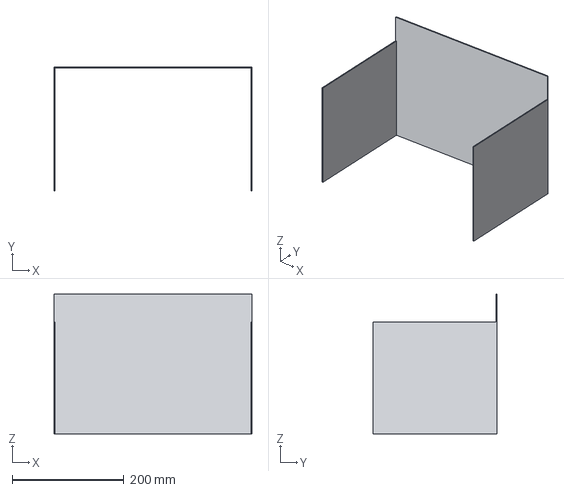
[picture p127: CAD file, 2026-10-25]
cad/step/edge_sun_hood.step
354.0 x 222.0 x 250.0 mm
