kgchord/ParkFlow/cad/step/ws2812_ring_envelope.step

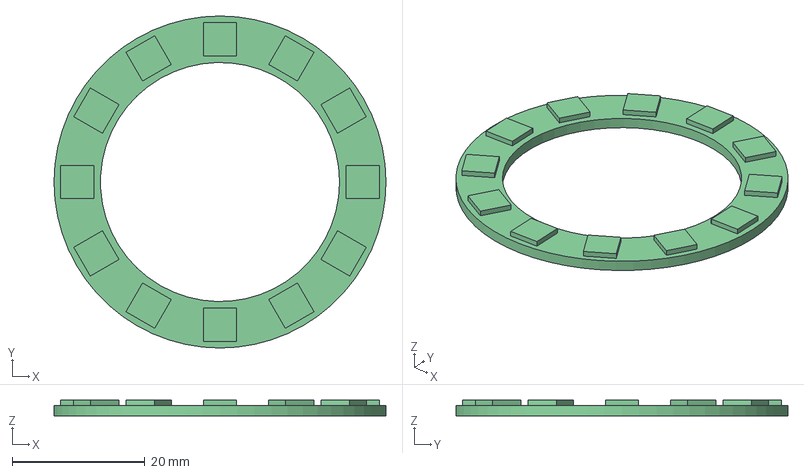
[picture p128: CAD file, 2026-10-25]
cad/step/ws2812_ring_envelope.step
50.0 x 50.0 x 2.40 mm
