kgchord/ParkFlow/cad/step/barrier_side_panel.step

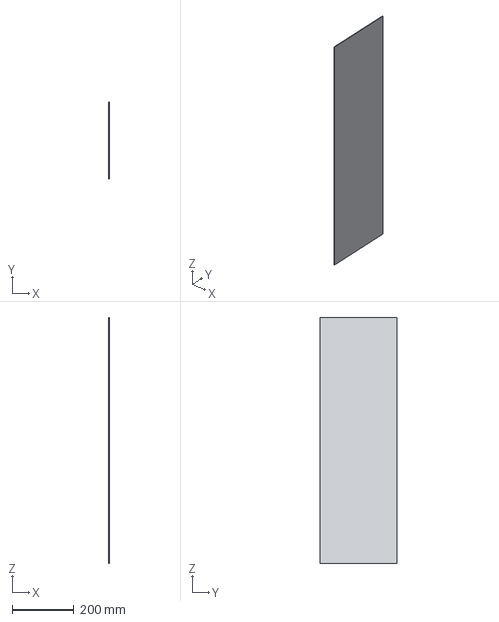
[picture p129: CAD file, 2026-10-25]
cad/step/barrier_side_panel.step
2.00 x 250.0 x 800.0 mm
