kgchord/ParkFlow/cad/step/barrier_photo_post_foot.step

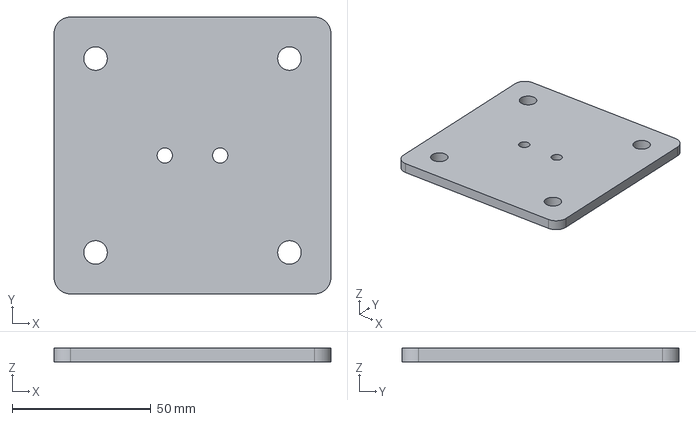
[picture p130: CAD file, 2026-10-25]
cad/step/barrier_photo_post_foot.step
100.0 x 100.0 x 5.00 mm
