kgchord/ParkFlow/cad/step/edge_sink_gasket_envelope.step

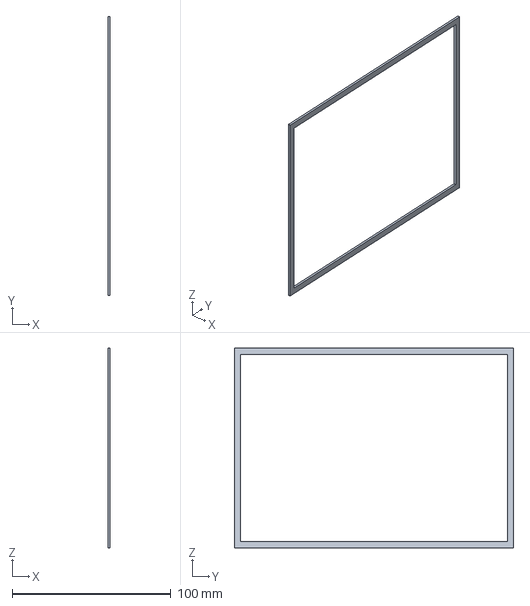
[picture p131: CAD file, 2026-10-25]
cad/step/edge_sink_gasket_envelope.step
1.50 x 176.0 x 126.0 mm
