kgchord/ParkFlow/cad/step/p10_cabinet_tray_envelope.step

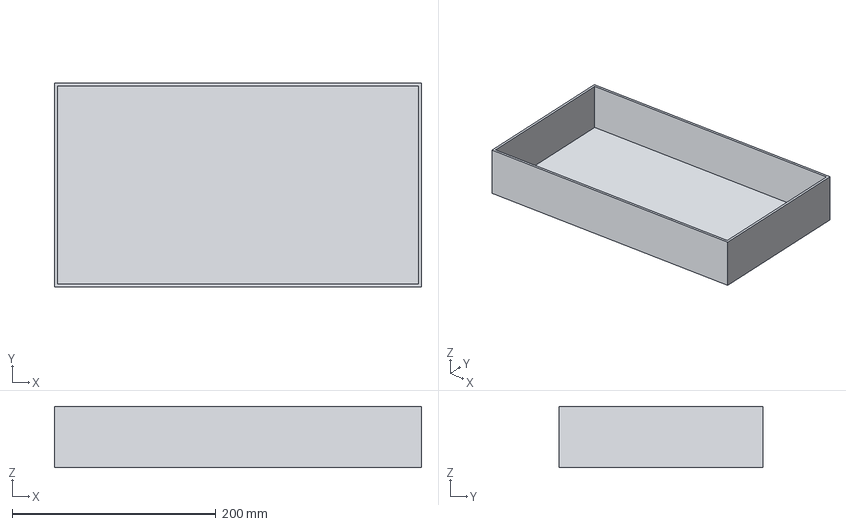
[picture p132: CAD file, 2026-10-25]
cad/step/p10_cabinet_tray_envelope.step
360.0 x 200.0 x 60.0 mm
