kgchord/ParkFlow/cad/step/esp32c3_board_envelope.step

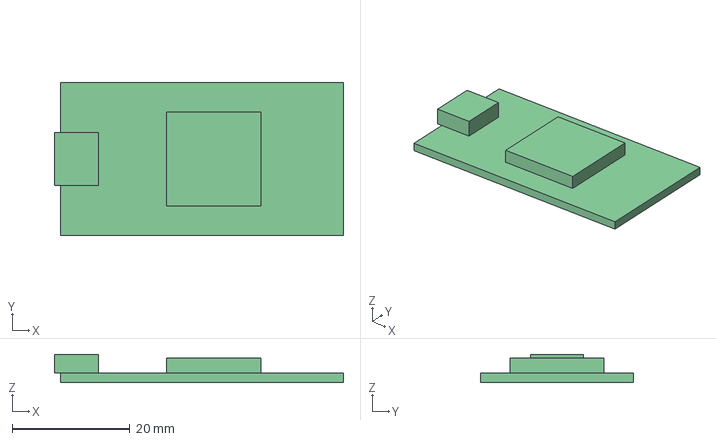
[picture p133: CAD file, 2026-10-25]
cad/step/esp32c3_board_envelope.step
49.0 x 26.0 x 4.80 mm
