kgchord/ParkFlow/cad/step/gantry_camera_adapter_plate.step

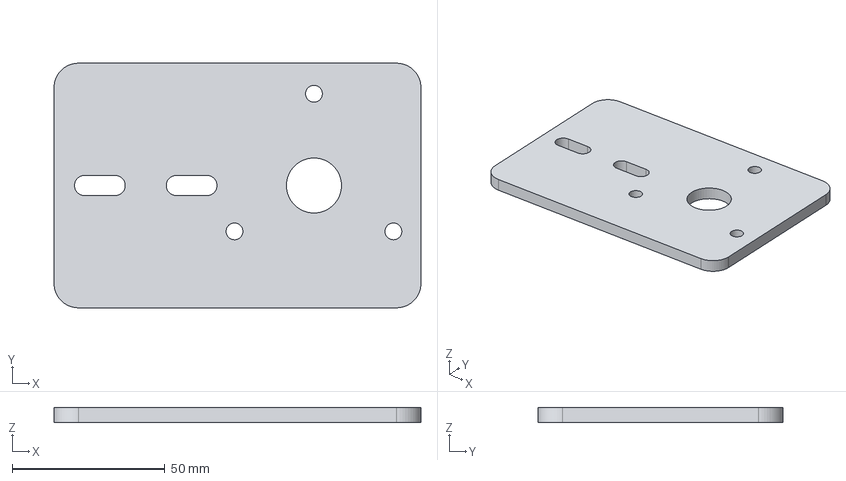
[picture p134: CAD file, 2026-10-25]
cad/step/gantry_camera_adapter_plate.step
120.0 x 80.0 x 5.00 mm
