kgchord/ParkFlow/cad/step/edge_thermal_pad_envelope.step

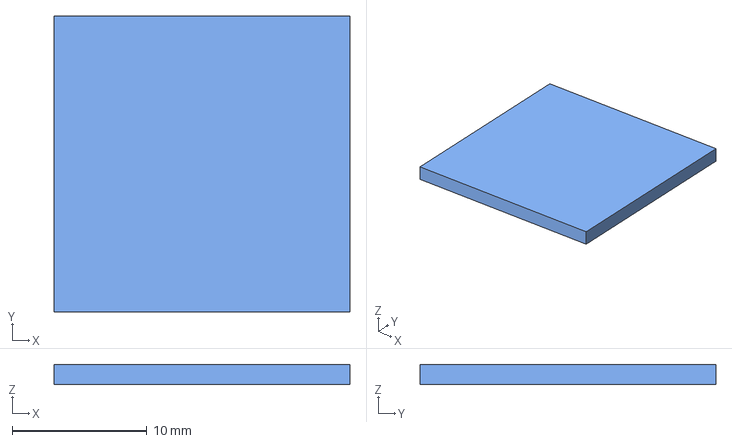
[picture p135: CAD file, 2026-10-25]
cad/step/edge_thermal_pad_envelope.step
22.0 x 22.0 x 1.50 mm
