kgchord/ParkFlow/cad/step/gantry_conduit_envelope.step

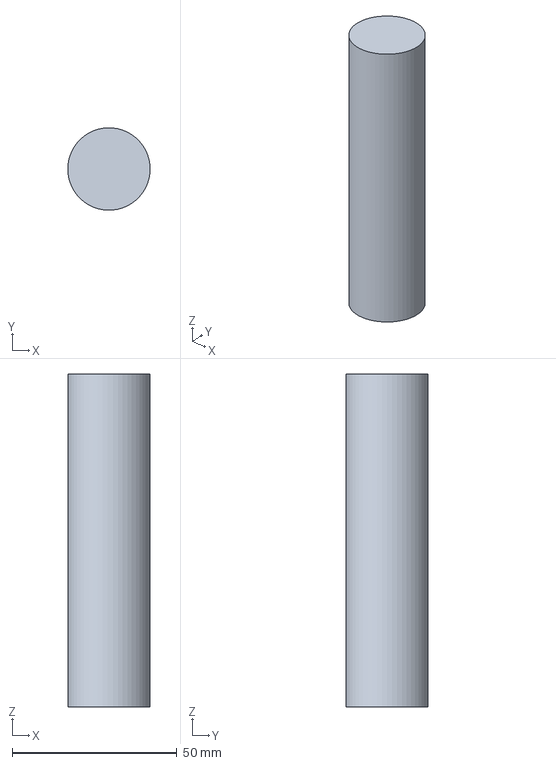
[picture p136: CAD file, 2026-10-25]
cad/step/gantry_conduit_envelope.step
25.0 x 25.0 x 101.0 mm
