kgchord/ParkFlow/cad/step/barrier_bearing_plate.step

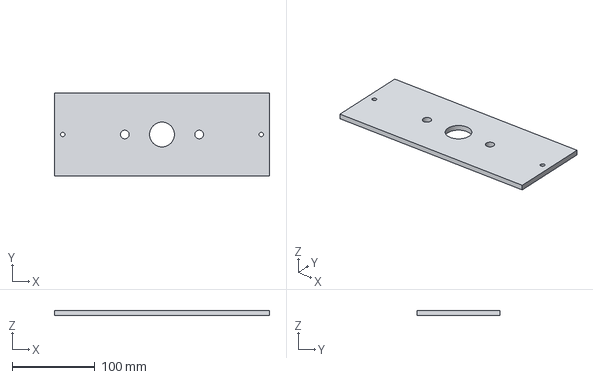
[picture p137: CAD file, 2026-10-25]
cad/step/barrier_bearing_plate.step
260.0 x 100.0 x 6.00 mm
