kgchord/ParkFlow/cad/step/barrier_frame_rail_x_20x20.step

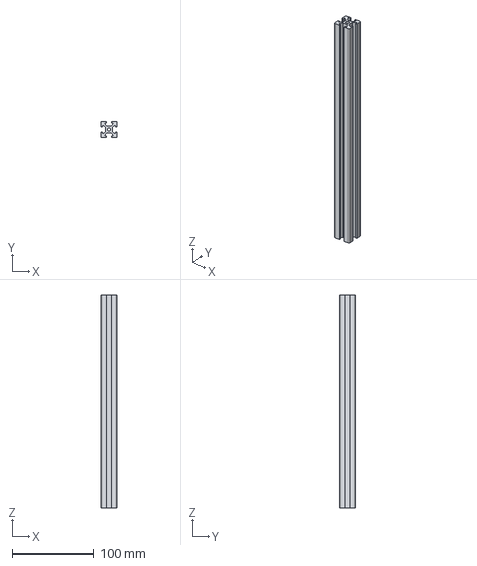
[picture p138: CAD file, 2026-10-25]
cad/step/barrier_frame_rail_x_20x20.step
20.0 x 20.0 x 260.0 mm
