kgchord/ParkFlow/cad/step/barrier_cw_plate.step

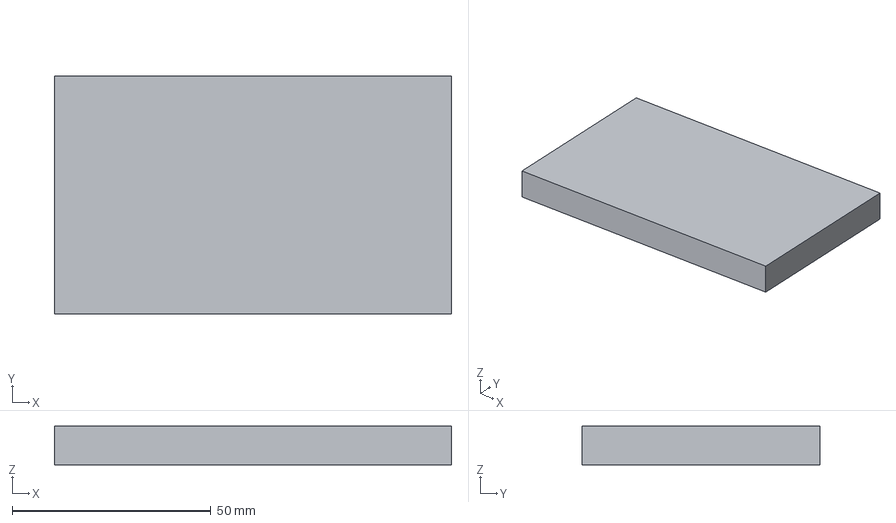
[picture p139: CAD file, 2026-10-25]
cad/step/barrier_cw_plate.step
100.0 x 60.0 x 9.70 mm
