kgchord/ParkFlow/cad/step/poe_switch_envelope.step

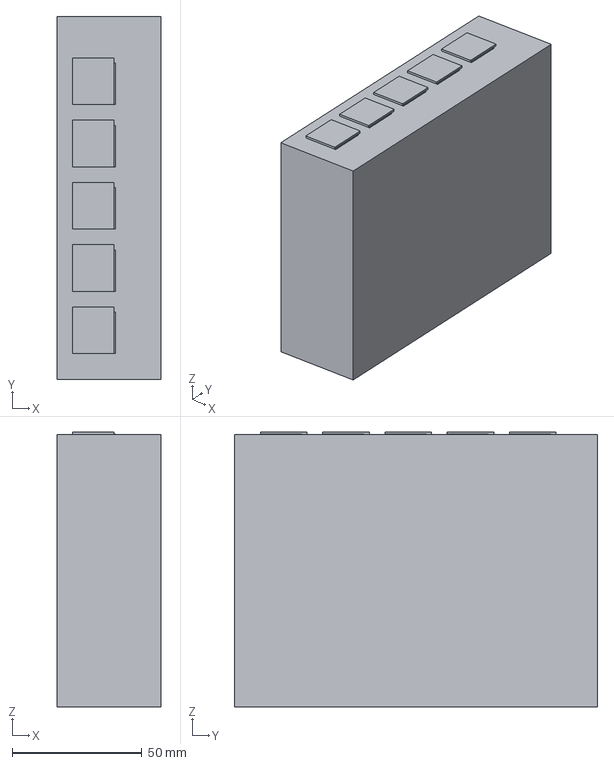
[picture p140: CAD file, 2026-10-25]
cad/step/poe_switch_envelope.step
40.0 x 140.0 x 106.0 mm
