kgchord/ParkFlow/cad/step/barrier_m12_inductive_sensor_envelope.step

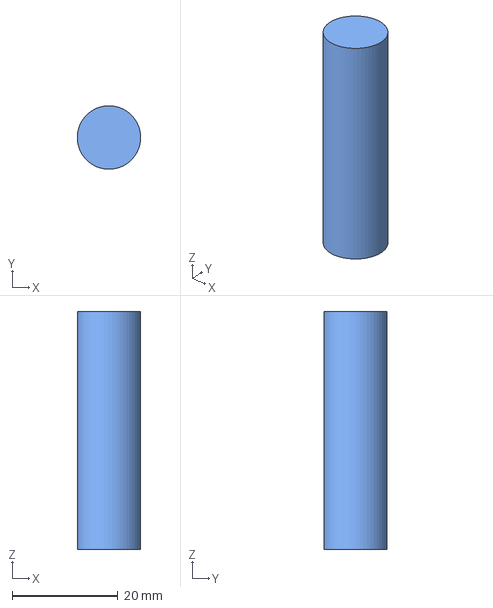
[picture p141: CAD file, 2026-10-25]
cad/step/barrier_m12_inductive_sensor_envelope.step
12.0 x 12.0 x 45.0 mm
