kgchord/ParkFlow/cad/step/barrier_roof.step

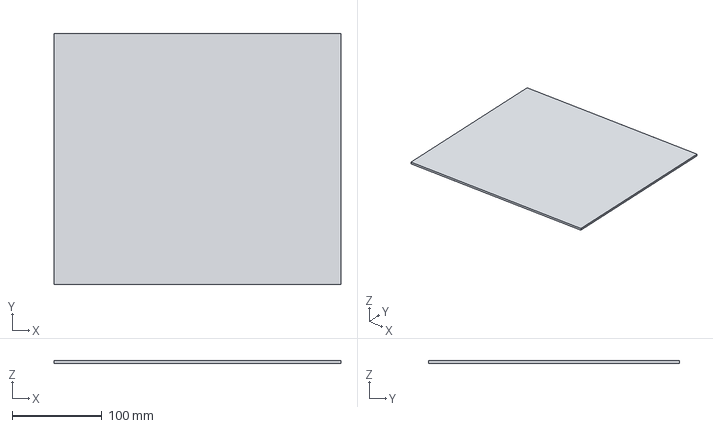
[picture p142: CAD file, 2026-10-25]
cad/step/barrier_roof.step
320.0 x 280.0 x 3.00 mm
