kgchord/ParkFlow/cad/step/edge_lid_gasket_envelope.step

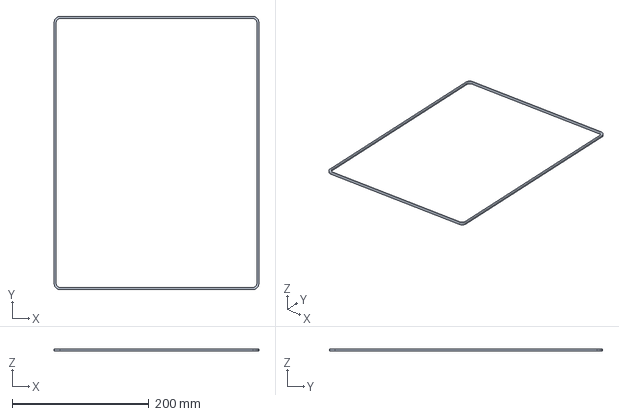
[picture p143: CAD file, 2026-10-25]
cad/step/edge_lid_gasket_envelope.step
299.1 x 399.1 x 3.60 mm
