kgchord/ParkFlow/cad/step/a02yyuw_ultrasonic_envelope.step

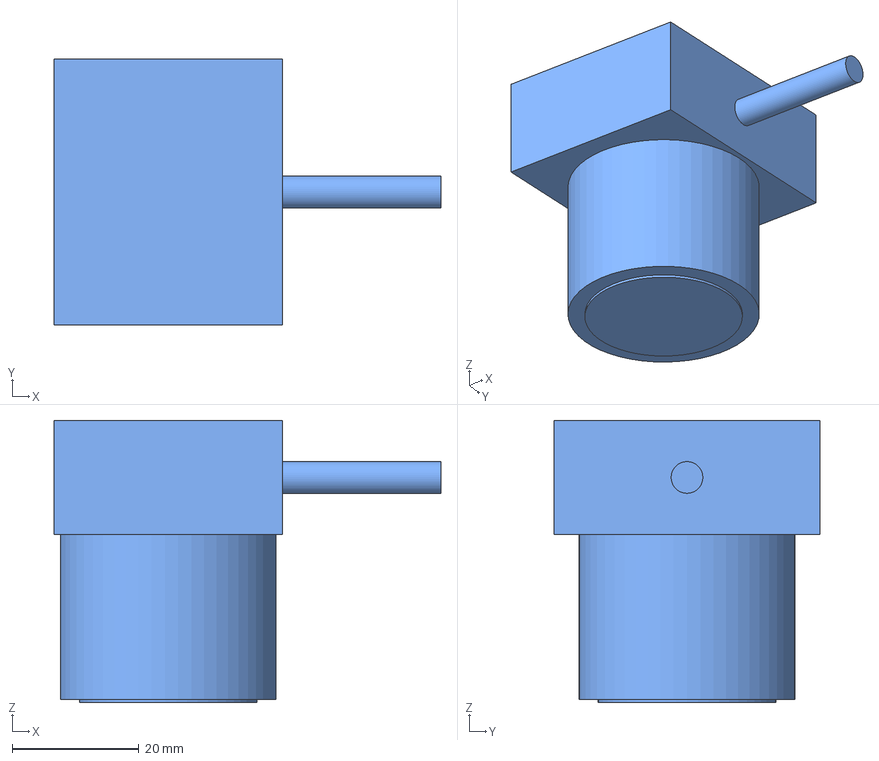
[picture p144: CAD file, 2026-10-25]
cad/step/a02yyuw_ultrasonic_envelope.step
61.0 x 42.0 x 44.5 mm
