kgchord/ParkFlow/cad/step/ai_hat_envelope.step

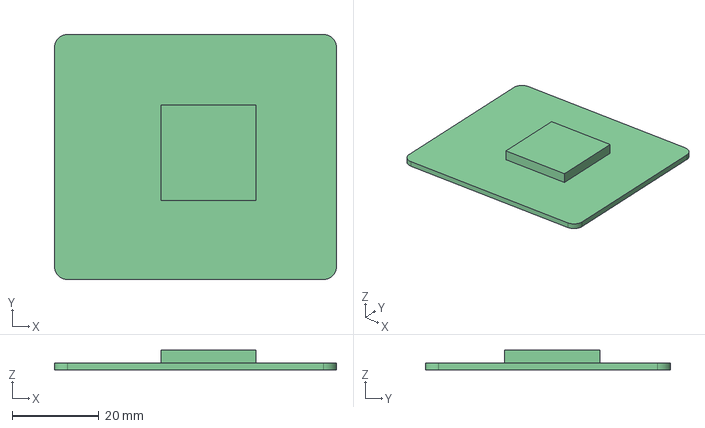
[picture p145: CAD file, 2026-10-25]
cad/step/ai_hat_envelope.step
65.0 x 56.5 x 4.60 mm
