kgchord/ParkFlow/cad/step/gantry_antenna_arm_40x40.step

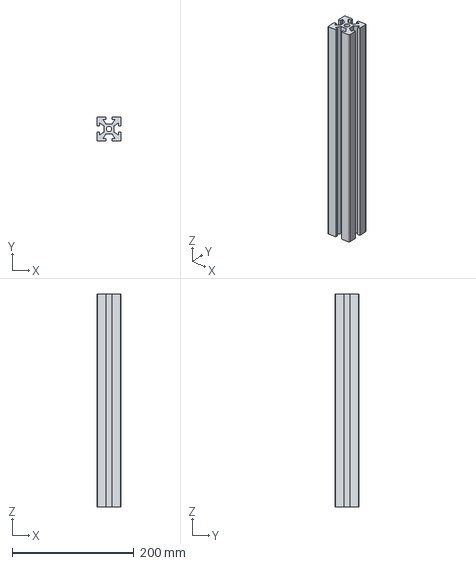
[picture p146: CAD file, 2026-10-25]
cad/step/gantry_antenna_arm_40x40.step
40.0 x 40.0 x 350.0 mm
