kgchord/ParkFlow/cad/step/gantry_pole_80x80.step

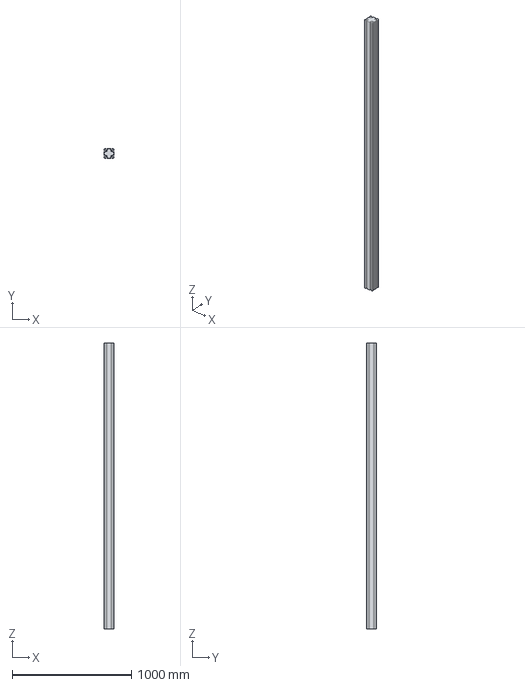
[picture p147: CAD file, 2026-10-25]
cad/step/gantry_pole_80x80.step
80.0 x 80.0 x 2400.0 mm
