kgchord/ParkFlow/cad/step/edge_buck_module_envelope.step

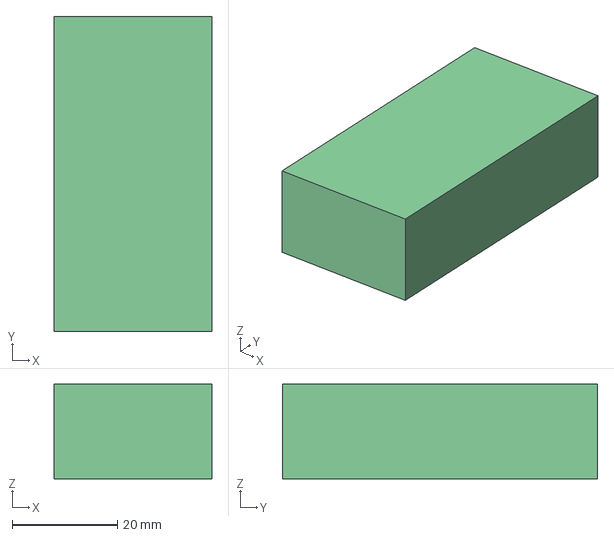
[picture p148: CAD file, 2026-10-25]
cad/step/edge_buck_module_envelope.step
30.0 x 60.0 x 18.0 mm
