kgchord/ParkFlow/cad/step/gantry_edge_pole_bracket.step

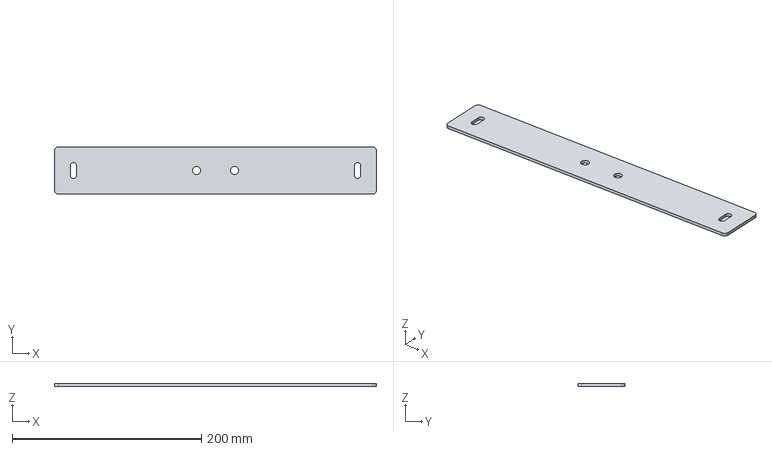
[picture p149: CAD file, 2026-10-25]
cad/step/gantry_edge_pole_bracket.step
340.0 x 50.0 x 3.00 mm
