kgchord/ParkFlow/cad/step/edge_heat_sink_envelope.step

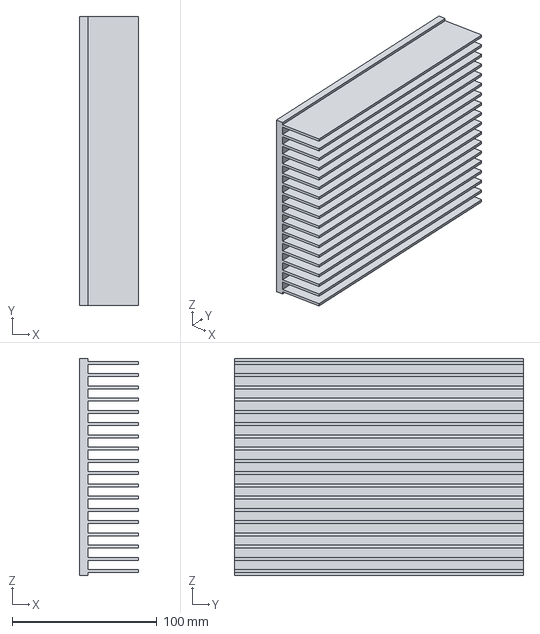
[picture p150: CAD file, 2026-10-25]
cad/step/edge_heat_sink_envelope.step
41.0 x 200.0 x 150.0 mm
