kgchord/ParkFlow/cad/step/p10_front_window_envelope.step

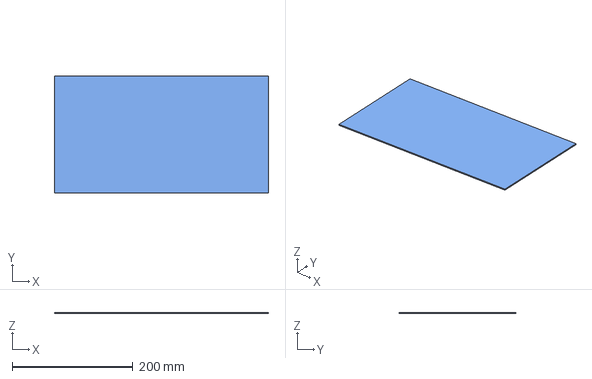
[picture p151: CAD file, 2026-10-25]
cad/step/p10_front_window_envelope.step
354.0 x 194.0 x 2.00 mm
