kgchord/ParkFlow/cad/step/occ_probe_clamp_boss.step

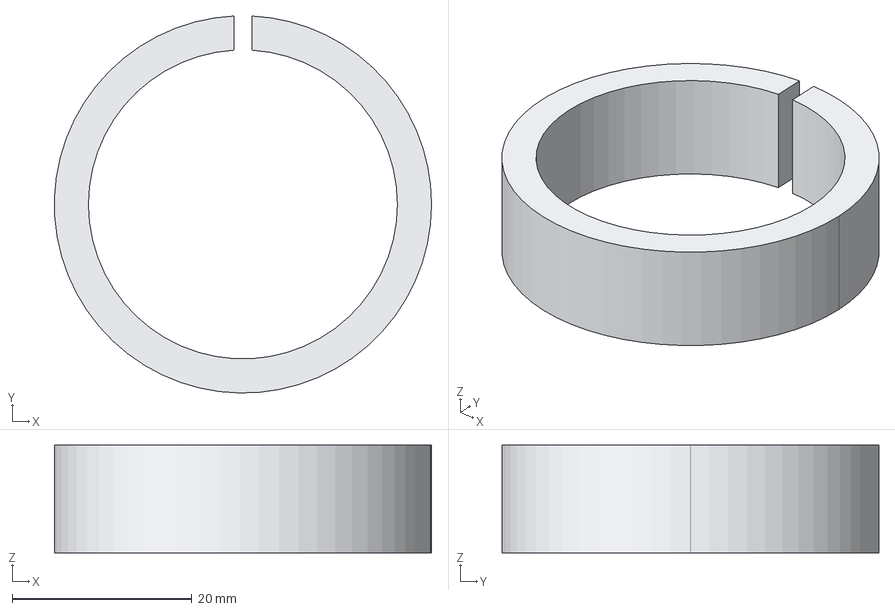
[picture p152: CAD file, 2026-10-25]
cad/step/occ_probe_clamp_boss.step
42.0 x 42.0 x 12.0 mm
