kgchord/ParkFlow/cad/step/edge_gland_M16_envelope.step

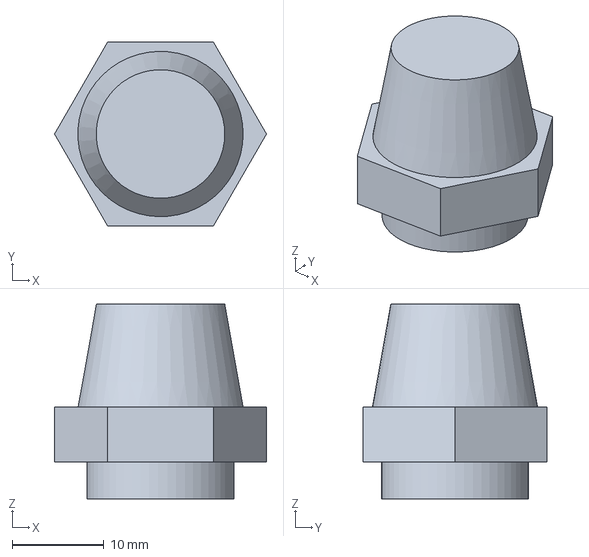
[picture p153: CAD file, 2026-10-25]
cad/step/edge_gland_M16_envelope.step
23.1 x 20.0 x 21.2 mm
