kgchord/ParkFlow/cad/step/barrier_frame_rail_y_20x20.step

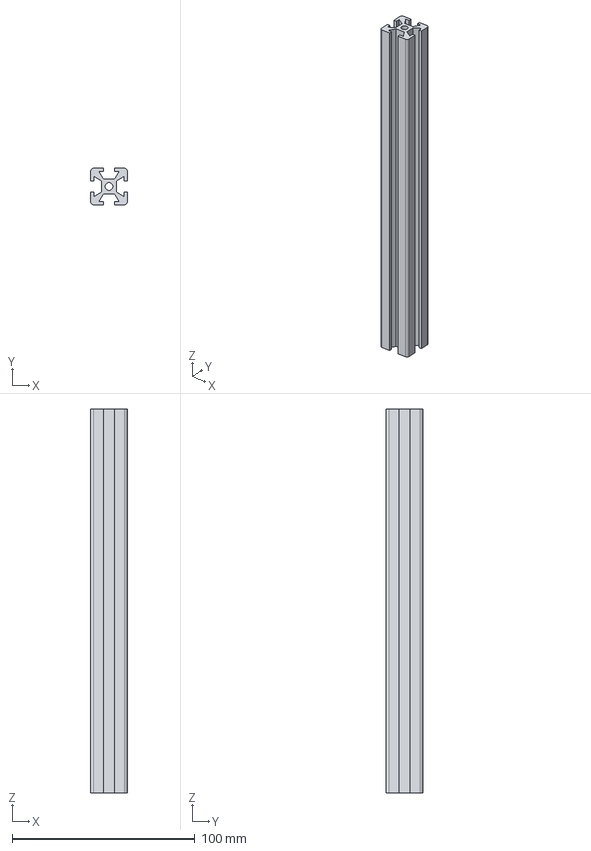
[picture p154: CAD file, 2026-10-25]
cad/step/barrier_frame_rail_y_20x20.step
20.0 x 20.0 x 210.0 mm
