kgchord/ParkFlow/cad/step/p10_driver_psu_envelope.step

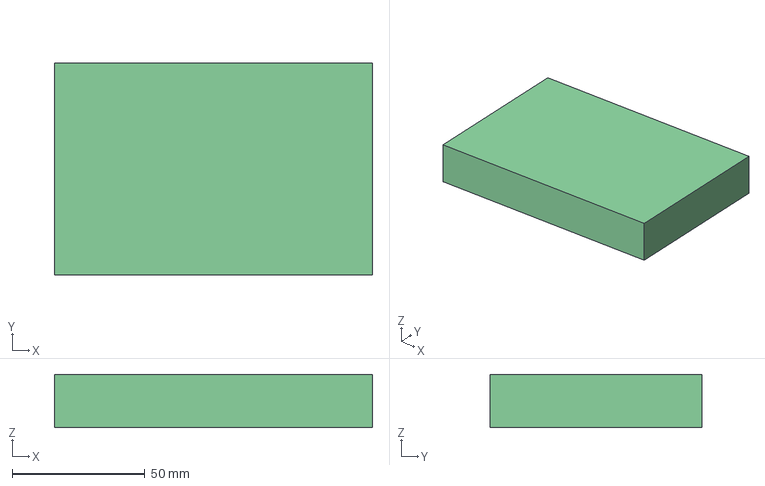
[picture p155: CAD file, 2026-10-25]
cad/step/p10_driver_psu_envelope.step
120.0 x 80.0 x 20.0 mm
