kgchord/ParkFlow/cad/step/barrier_flange_bearing_envelope.step

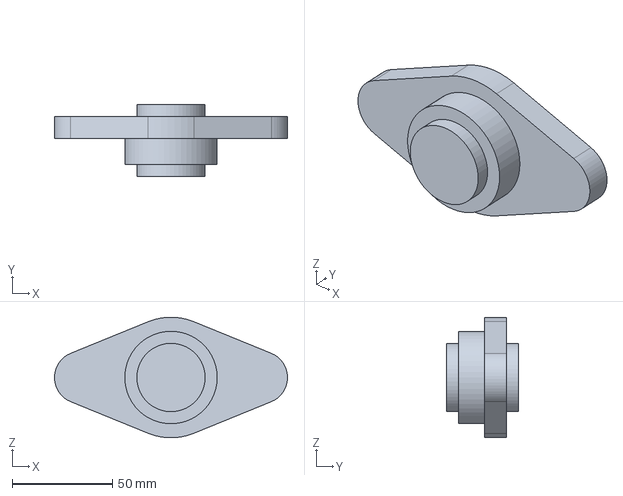
[picture p156: CAD file, 2026-10-25]
cad/step/barrier_flange_bearing_envelope.step
115.9 x 36.0 x 59.9 mm
