kgchord/ParkFlow/cad/step/edge_din_device_1mod_envelope.step

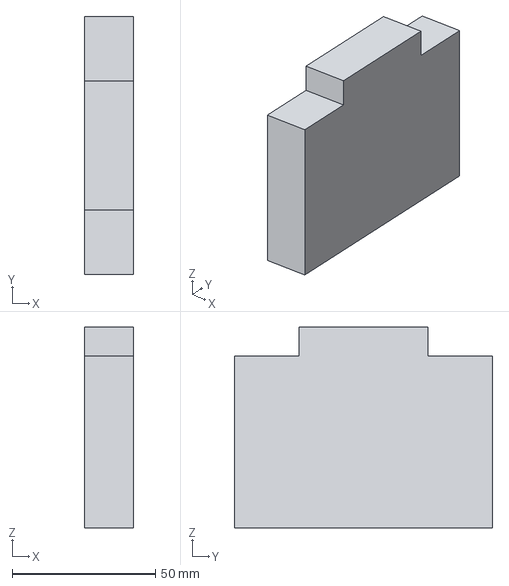
[picture p157: CAD file, 2026-10-25]
cad/step/edge_din_device_1mod_envelope.step
17.0 x 90.0 x 70.0 mm
