kgchord/ParkFlow/cad/step/barrier_motor_plate.step

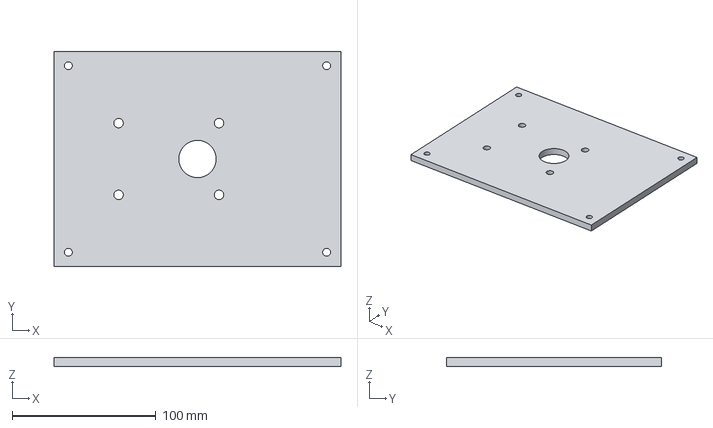
[picture p158: CAD file, 2026-10-25]
cad/step/barrier_motor_plate.step
200.0 x 150.0 x 6.00 mm
