kgchord/ParkFlow/cad/step/gantry_camera_arm_40x40.step

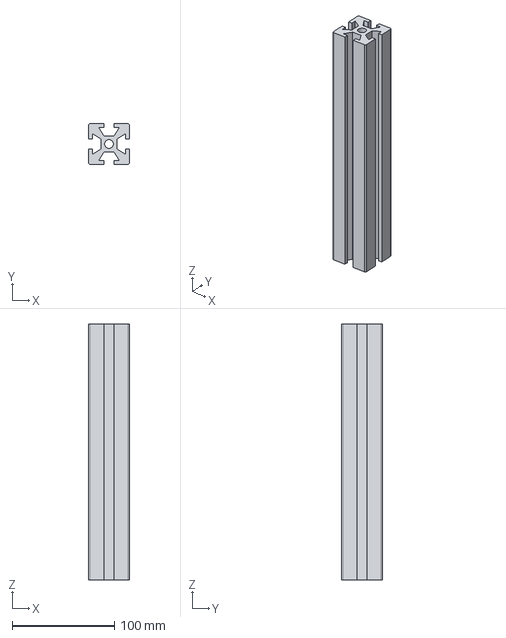
[picture p159: CAD file, 2026-10-25]
cad/step/gantry_camera_arm_40x40.step
40.0 x 40.0 x 250.0 mm
