kgchord/ParkFlow/cad/step/occ_base.step

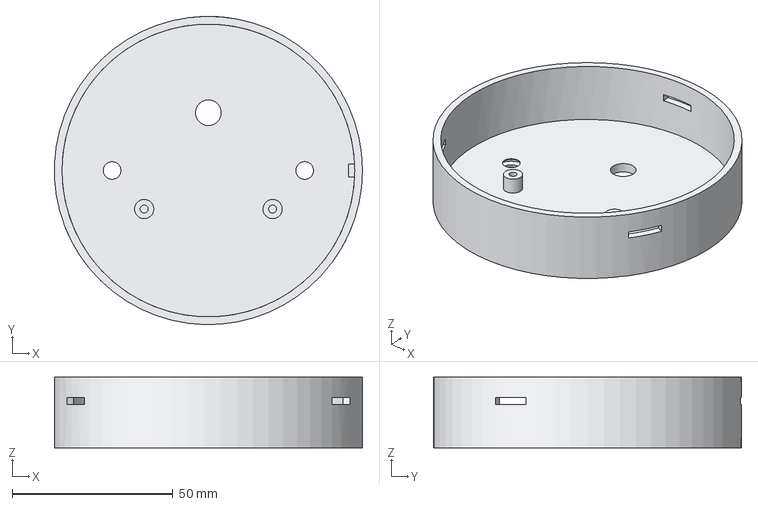
[picture p160: CAD file, 2026-10-25]
cad/step/occ_base.step
95.9 x 96.0 x 22.0 mm
