kgchord/ParkFlow/cad/step/barrier_base_plate.step

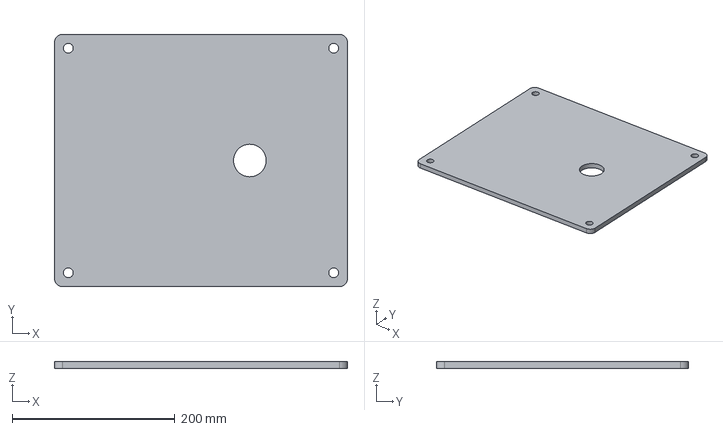
[picture p161: CAD file, 2026-10-25]
cad/step/barrier_base_plate.step
360.0 x 310.0 x 8.00 mm
