kgchord/ParkFlow/cad/step/edge_gland_M25_envelope.step

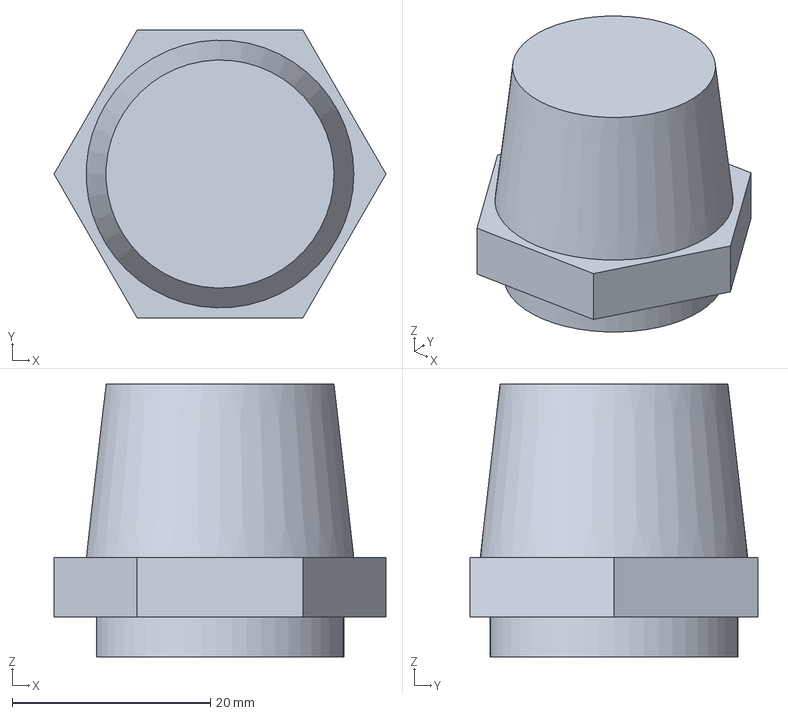
[picture p162: CAD file, 2026-10-25]
cad/step/edge_gland_M25_envelope.step
33.5 x 29.0 x 27.5 mm
