kgchord/ParkFlow/(list of files, cad)

Other CAD files:
cad/step/barrier_boom_tip_cap.step
cad/step/gantry_pole_cap.step
cad/step/barrier_front_panel.step
cad/step/gantry_cable_boot.step
cad/step/barrier_photo_post_cap.step
cad/dxf/barrier_base_plate.dxf
cad/dxf/barrier_bearing_plate.dxf
cad/dxf/barrier_front_panel.dxf
cad/dxf/barrier_motor_plate.dxf
cad/dxf/edge_heat_spreader.dxf
cad/dxf/edge_mount_plate.dxf
cad/stl/edge_pi_tray.stl
cad/stl/occ_base.stl
cad/stl/occ_cover.stl
cad/stl/occ_diffuser.stl
