kgchord/ParkFlow/cad/step/STEP_MANIFEST.md

# STEP manifest (generated - do not edit by hand)

Generated by `cad/step/manifest.py` from `_build_index.json` (what `build_step.py` wrote) and `_verify_results.json` (what `verify_step.py` measured by re-importing every file with CadQuery/OCCT). Re-run the three scripts to refresh.

## What these files are - and are not

* **Script-generated interchange geometry.** Every STEP file is produced by CadQuery 2.8 (OCCT B-rep) from the numbers in the OpenSCAD `*_params.scad` files (read programmatically by `scadparams.py`; no dimension is typed in the builders, except the few literals that sit inside module bodies of the .scad files, listed under *Limitations*).
* **Not native parametric CAD.** The files carry no sketches, no constraints, no feature tree and no spreadsheet. The native parametric models are the FreeCAD rebuild described in `cad/freecad/REBUILD_GUIDE.md` (see `cad/CAD_STATUS.md`).
* **Bought-in parts are simplified envelopes** (`*_envelope`); their sizes are the ASSUMED/class sizes already stated in `pf_bought.scad` and `cad/README.md` and must be re-checked against the purchased part's drawing. Fasteners, anchors, decals/tape and cable runs are not modelled.

## Verification summary

* Files: **89 part files + 16 assembly files = 105**. All re-imported from disk: **all solids valid (BRepCheck)**.
* **79** files were compared with an OpenSCAD STL of the same part/assembly in the same frame (volume, bounding box and corner position, and STEP-surface-to-STL-surface distance; thresholds: volume 2 %, bbox 2 % and >0.3 mm, surface agreement >= 99 % of sampled STEP surface within max(0.3 mm, 2.5 x STL sample spacing)). The other files have no OpenSCAD module that isolates them (plain boxes/cylinders, trimmed or merged bodies); they are validated for solid validity and volume against their closed-form parameters only.
* Printed parts are additionally compared with the checked-in `cad/stl/*.stl` (print orientation: volume only).
* Assembly volume comparison uses sum(body volumes) - sum(pairwise overlaps): the OpenSCAD STL is a boolean UNION, while the STEP assemblies keep separate bodies, some of which overlap in the source model (see *Interferences*).

### Files outside tolerance (all explained below the table)

| id | what differs |
|---|---|
| `occ_cover` | volume -12.49 % vs checked-in stl/occ_cover.stl  -> MODEL ISSUE: in the .scad the probe clamp boss and the LED seat are NOT connected to this shell (3 separate solids); exported as 3 parts |
| `gantry_antenna_arm_assy` | bbox X extent -32.00 mm  -> reference STL also contains the M8 pivot bolts and nylon spacers (hardware, not in STEP) |
| `gantry_assembly` | bbox X extent -32.00 mm; bbox Z extent -80.00 mm; bbox min-corner Z shifted +80.00 mm  -> reference STL additionally contains anchors, cross bolts, pivot bolts and conduit hardware; STEP has none |
| `barrier_rotor_assy` | volume -3.20 % vs OpenSCAD STL; bbox Y extent -5.00 mm; bbox Z extent -12.30 mm; only 98.8 % of STEP surface within 1.25 mm of OpenSCAD surface  -> reference STL also contains the M8 hinge bolt, 2 M6 clamp bolts, 2 M8 counterweight studs, red tape bands and a different (solid) inline tip cap |
| `barrier_photo_post_assy` | only 99.0 % of STEP surface within 1.25 mm of OpenSCAD surface  -> reference photo_post() draws a solid 24x24x6 cap instead of the printed hollow cap |
| `barrier_assembly` | bbox Y extent -12.30 mm; bbox min-corner Y shifted +12.30 mm  -> reference STL additionally has anchor nuts, hinge/clamp bolts, studs, decals, tape bands, beam line, solid inline caps |
| `occupancy_node_assy` | bbox Z extent -27.50 mm; bbox min-corner Z shifted +27.50 mm  -> reference STL also contains the 2 M5 countersunk screws |
| `lane_layout_assy` | bbox Z extent -80.00 mm; bbox min-corner Z shifted +80.00 mm  -> reference STL = the same three layout() placements run through OpenSCAD (hardware included in reference only). The gantry is MIRRORED (x -> -x) exactly as in the .scad, so handed parts are mirror-image copies. |

## (a) Lane gantry pole

### Parts

| Part | File | Type | Material | Vol cm3 | Mass kg | BBox mm | Source params (values) | Check vs OpenSCAD |
|---|---|---|---|---:|---:|---|---|---|
| `gantry_base_plate` | `gantry_base_plate.step` | fabricated | IS2062-E250 (MS) | 968.67 | 7.604 | 250.0 x 250.0 x 16.0 | bp_w=250, bp_t=16, bp_corner_r=12, bp_pcd=190, bp_anchor_hole=14, bp_centre_hole=30 | dV -0.00 %; surf 100.0 % |
| `gantry_socket_cheek_long` | `gantry_socket_cheek_long.step` | fabricated | IS2062-E250 (MS) | 82.07 | 0.644 | 93.0 x 150.0 x 6.0 | pole_w=80, sock_clear=0.5, sock_t=6, sock_h=150, sock_bolt_d=10, sock_bolt_z1=45 | dV -0.00 %; surf 100.0 % |
| `gantry_socket_cheek_short` | `gantry_socket_cheek_short.step` | fabricated | IS2062-E250 (MS) | 72.33 | 0.568 | 81.0 x 150.0 x 6.0 | pole_w=80, sock_clear=0.5, sock_t=6, sock_h=150, sock_bolt_d=10, sock_bolt_z2=115 | dV -0.00 %; surf 100.0 % |
| `gantry_gusset` | `gantry_gusset.step` | fabricated | IS2062-E250 (MS) | 34.26 | 0.269 | 74.0 x 120.0 x 6.0 | gus_l=74, gus_h=120, gus_t=6, gus_chamfer=12, gus_tip=15 | dV -0.00 %; surf 100.0 % |
| `base_weldment` | `base_weldment.step` | fabricated | IS2062-E250 (MS) | 1414.52 | 11.104 | 250.0 x 250.0 x 166.0 | bp_w=250, bp_t=16, sock_h=150, sock_t=6, gus_n=4, gus_l=74, gus_h=120 | dV -0.00 %; surf 100.0 % |
| `gantry_pole_80x80` | `gantry_pole_80x80.step` | fabricated | Al 6063-T5 | 11738.61 | 31.694 | 80.0 x 80.0 x 2400.0 | pole_w=80, pole_d=80, pole_len=2400, pole_pitch=40, pole_slot=10 | dV -0.08 %; surf 100.0 % |
| `gantry_antenna_arm_40x40` | `gantry_antenna_arm_40x40.step` | fabricated | Al 6063-T5 | 315.46 | 0.852 | 40.0 x 40.0 x 350.0 | ant_arm_w=40, ant_arm_len=350, pole_pitch=40, pole_slot=10 | dV -0.10 %; surf 100.0 % |
| `gantry_camera_arm_40x40` | `gantry_camera_arm_40x40.step` | fabricated | Al 6063-T5 | 225.33 | 0.608 | 40.0 x 40.0 x 250.0 | ant_arm_w=40, cam_arm_len_eff=250, pole_pitch=40, pole_slot=10 | dV -0.10 %; surf 100.0 % |
| `antenna_yoke` | `antenna_yoke.step` | fabricated | Al 5052-H32 | 250.31 | 0.671 | 280.0 x 90.0 x 235.0 | yoke_t=5, yoke_w=280, yoke_web_d=60, yoke_bend_r=5, pivot_d=8, pivot_drop=180, ant_arm_w=40, +7 more | dV +0.01 %; surf 100.0 % |
| `antenna_tilt_plate` | `antenna_tilt_plate.step` | fabricated | Al 5052-H32 | 243.86 | 0.654 | 240.0 x 61.0 x 200.0 | yoke_t=5, tp_w=240, tp_h=200, tp_off=40, reader_hole_pitch=100, pivot_d=8, lock_r=50, +1 more | dV +0.00 %; surf 100.0 % |
| `gantry_camera_adapter_plate` | `gantry_camera_adapter_plate.step` | fabricated | Al 5052-H32 | 45.09 | 0.121 | 120.0 x 80.0 x 5.0 | cam_plate_l=120, cam_plate_w=80, cam_plate_t=5, cam_mount_pcd=60 | dV -0.00 %; surf 100.0 % |
| `gantry_sign_bracket` | `gantry_sign_bracket.step` | fabricated | Al 5052-H32 | 47.07 | 0.126 | 200.0 x 80.0 x 3.0 | sign_br_t=3, sign_br_l=200, sign_br_w=80 | dV -0.00 %; surf 100.0 % |
| `gantry_edge_pole_bracket` | `gantry_edge_pole_bracket.step` | fabricated | IS2062-E250 (MS) | 50.02 | 0.393 | 340.0 x 50.0 x 3.0 | edge_br_l=340, edge_br_w=50, edge_br_t=3, edge_lug_pitch=300 | dV -0.00 %; surf 100.0 % |
| `gantry_pole_cap` | `gantry_pole_cap.step` | fabricated | ASA (FDM) | 69.37 | 0.074 | 85.4 x 85.4 x 26.0 | pole_w=80, cap_wall=2.4, cap_h=18, cap_clear=0.3 | dV +0.00 %; surf 100.0 %; cad/stl dV +0.00 % |
| `gantry_cable_boot` | `gantry_cable_boot.step` | fabricated | ASA (FDM) | 95.52 | 0.102 | 27.0 x 46.0 x 154.0 | pole_w=80, duct_w=40, duct_d=25, duct_z0=180, boot_h=90, conduit_d=25, bp_t=16 | dV -0.01 %; surf 100.0 %; cad/stl dV -0.00 % |
| `gantry_cable_channel_envelope` | `gantry_cable_channel_envelope.step` | envelope | PVC trunking (bought) | 620.14 | n/a | 26.5 x 42.0 x 2020.0 | duct_w=40, duct_d=25, duct_t=2, duct_z0=180, duct_z1=2200, pole_w=80 | dV +0.00 %; surf 100.0 % |
| `gantry_conduit_envelope` | `gantry_conduit_envelope.step` | envelope | flexible conduit (bought) | 49.58 | n/a | 25.0 x 25.0 x 101.0 | conduit_d=25, bp_t=16, grout_gap=25, duct_d=25, pole_w=80 | no isolated STL ref |
| `gantry_corner_bracket40_envelope` | `gantry_corner_bracket40_envelope.step` | envelope | cast Al (bought) | 12.58 | n/a | 40.0 x 35.0 x 40.0 |  | dV +0.00 %; surf 100.0 % |
| `rfid_reader_envelope` | `rfid_reader_envelope.step` | envelope | bought | 3991.29 | n/a | 260.0 x 260.0 x 78.4 | rfid_w=260, rfid_h=260, rfid_t=60 | dV +0.00 %; surf 100.0 % |
| `bullet_camera_envelope` | `bullet_camera_envelope.step` | envelope | bought | 917.72 | n/a | 230.0 x 80.0 x 121.0 | cam_len=220, cam_dia=80, cam_knuckle=50 | dV +0.04 %; surf 100.0 % |
| `bullet_camera_aimed_envelope` | `bullet_camera_aimed_envelope.step` | envelope | bought | 918.29 | n/a | 238.7 x 80.0 x 137.2 | cam_pitch=20, cam_len=220, cam_dia=80, cam_knuckle=50 | dV +0.04 %; surf 100.0 % |
| `p10_cabinet_tray_envelope` | `p10_cabinet_tray_envelope.step` | envelope | Al 5052-H32 (sheet tray) | 405.47 | n/a | 360.0 x 200.0 x 60.0 | sign_cab_w=360, sign_cab_h=200, sign_cab_d=60 | no isolated STL ref |
| `p10_module_envelope` | `p10_module_envelope.step` | envelope | bought | 665.60 | n/a | 320.0 x 160.0 x 13.0 | p10_w=320, p10_h=160, p10_t=15 | no isolated STL ref |
| `p10_front_window_envelope` | `p10_front_window_envelope.step` | envelope | polycarbonate (bought) | 137.35 | n/a | 354.0 x 194.0 x 2.0 | sign_cab_w=360, sign_cab_h=200, sign_cab_d=60 | no isolated STL ref |
| `p10_driver_psu_envelope` | `p10_driver_psu_envelope.step` | envelope | bought | 192.00 | n/a | 120.0 x 80.0 x 20.0 |  | no isolated STL ref |

### Assemblies

| Assembly | File | Bodies | Vol cm3 (sum) | Vol cm3 (union est.) | Fabricated-part mass kg | BBox mm | Check vs OpenSCAD |
|---|---|---:|---:|---:|---:|---|---|
| `gantry_base_weldment_assy` | `gantry_base_weldment_assy.step` | 9 | 1414.5 | 1414.5 | 11.10 | 250.0 x 250.0 x 166.0 | dV -0.00 %; surf 100.0 % |
| `antenna_bracket_assy` | `antenna_bracket_assy.step` | 2 | 494.2 | 494.2 | 1.32 | 280.0 x 121.5 x 269.4 | dV +0.04 %; surf 100.0 % |
| `gantry_p10_sign_cabinet_assy` | `gantry_p10_sign_cabinet_assy.step` | 4 | 1400.4 | 1400.4 | 0.00 | 360.0 x 200.0 x 60.0 | dV -1.02 %; surf 99.6 % |
| `gantry_antenna_arm_assy` | `gantry_antenna_arm_assy.step` | 6 | 4826.1 | 4825.6 | 2.18 | 350.0 x 188.1 x 398.1 | dV -0.23 %; surf 100.0 %; **MISMATCH** |
| `gantry_camera_arm_assy` | `gantry_camera_arm_assy.step` | 5 | 1213.9 | 1213.9 | 0.73 | 121.5 x 461.3 x 222.2 | dV +0.18 %; surf 100.0 % |
| `gantry_assembly` | `gantry_assembly.step` | 67 | 26927.1 | 26744.9 | 48.74 | 581.0 x 814.3 x 2491.4 | dV -0.51 %; surf 100.0 %; **MISMATCH** |

* `gantry_p10_sign_cabinet_assy`: reference STL includes 512 LED pixels and the full-size front plate overlapping the walls
* `gantry_antenna_arm_assy`: reference STL also contains the M8 pivot bolts and nylon spacers (hardware, not in STEP)
* `gantry_assembly`: reference STL additionally contains anchors, cross bolts, pivot bolts and conduit hardware; STEP has none

## (b) Edge Node

### Parts

| Part | File | Type | Material | Vol cm3 | Mass kg | BBox mm | Source params (values) | Check vs OpenSCAD |
|---|---|---|---|---:|---:|---|---|---|
| `edge_enclosure_base` | `edge_enclosure_base.step` | fabricated | Polycarbonate (bought enclosure) | 1122.30 | n/a | 351.0 x 400.0 x 143.0 | enc_w=300, enc_h=400, enc_d=180, enc_lid_d=40, enc_wall=3.5, enc_r=10, lid_boss_d=14, +16 more | dV +0.00 %; surf 100.0 % |
| `edge_enclosure_lid` | `edge_enclosure_lid.step` | fabricated | Polycarbonate (bought enclosure) | 615.32 | n/a | 300.0 x 400.0 x 40.0 | enc_w=300, enc_h=400, enc_lid_d=40, enc_wall=3.5, enc_r=10, groove_w=4.2, groove_d=5, +2 more | dV +0.04 %; surf 99.9 % |
| `edge_lid_gasket_envelope` | `edge_lid_gasket_envelope.step` | envelope | EPDM/silicone cord (bought) | 13.17 | n/a | 299.1 x 399.1 x 3.6 | gasket_d=4.5, groove_d=5, enc_w=300, enc_h=400, enc_wall=3.5, enc_r=10 | no isolated STL ref |
| `edge_label_plate` | `edge_label_plate.step` | fabricated | not specified in MATERIALS.md | 2.87 | n/a | 120.0 x 30.0 x 0.8 | enc_h=400, enc_lid_d=40 | no isolated STL ref |
| `edge_mount_plate` | `edge_mount_plate.step` | fabricated | Al 5052-H32 | 279.07 | 0.748 | 260.0 x 360.0 x 3.0 | mp_w=260, mp_t=3, bp_boss_dx=230, bp_boss_dy=340, din_y=100, smps_x=-40, smps_y=-120, +6 more | dV -0.00 %; surf 100.0 % |
| `edge_pi_tray` | `edge_pi_tray.step` | fabricated | ASA (FDM) | 20.66 | 0.022 | 100.0 x 75.0 x 12.0 | pitray_t=3, pi_standoff=12 | dV +0.41 %; surf 99.7 %; cad/stl dV +0.41 % |
| `edge_heat_spreader` | `edge_heat_spreader.step` | fabricated | Al 6061-T6 | 39.07 | 0.105 | 118.5 x 70.0 x 10.0 | spr_t=5, spr_l=100, spr_w=70, spr_bar_w=20, spr_bar_t=10 | dV -0.00 %; surf 100.0 % |
| `edge_thermal_pad_envelope` | `edge_thermal_pad_envelope.step` | envelope | thermal pad (bought) | 0.73 | n/a | 22.0 x 22.0 x 1.5 |  | no isolated STL ref |
| `edge_sun_hood` | `edge_sun_hood.step` | fabricated | Al 5052-H32 | 353.00 | 0.946 | 354.0 x 222.0 x 250.0 | enc_w=300, enc_h=400, enc_d=180, hood_gap=25, hood_t=2, hood_front=60 | dV -0.00 %; surf 100.0 % |
| `edge_heat_sink_envelope` | `edge_heat_sink_envelope.step` | envelope | Al 6063-T5 | 432.00 | 1.166 | 41.0 x 200.0 x 150.0 | hs_base_l=200, hs_base_w=150, hs_base_t=6, hs_fin_n=18, hs_fin_t=2, hs_fin_h=35 | no isolated STL ref |
| `edge_sink_gasket_envelope` | `edge_sink_gasket_envelope.step` | envelope | EPDM sheet (bought) | 3.53 | n/a | 1.5 x 176.0 x 126.0 | hs_cut_l=160, hs_cut_w=110 | no isolated STL ref |
| `edge_gland_M16_envelope` | `edge_gland_M16_envelope.step` | envelope | Nylon PA66 (bought) | 5.15 | n/a | 23.1 x 20.0 x 21.2 | gland_m=[25, 20, 20, 20, 16] | dV +0.02 %; surf 100.0 % |
| `edge_gland_M20_envelope` | `edge_gland_M20_envelope.step` | envelope | Nylon PA66 (bought) | 8.66 | n/a | 27.7 x 24.0 x 24.0 | gland_m=[25, 20, 20, 20, 16] | dV +0.03 %; surf 100.0 % |
| `edge_gland_M25_envelope` | `edge_gland_M25_envelope.step` | envelope | Nylon PA66 (bought) | 14.94 | n/a | 33.5 x 29.0 x 27.5 | gland_m=[25, 20, 20, 20, 16] | dV +0.03 %; surf 100.0 % |
| `edge_vent_plug_envelope` | `edge_vent_plug_envelope.step` | envelope | ePTFE vent (bought) | 2.54 | n/a | 18.0 x 18.0 x 10.0 | vent_x=125 | no isolated STL ref |
| `rpi5_envelope` | `rpi5_envelope.step` | envelope | bought | 27.90 | n/a | 85.0 x 56.0 x 17.1 | pi_l=85, pi_w=56, pi_t=1.6, pi_hole_dx=58, pi_hole_dy=49 | dV +0.00 %; surf 100.0 % |
| `ai_hat_envelope` | `ai_hat_envelope.step` | envelope | bought | 7.32 | n/a | 65.0 x 56.5 x 4.6 |  | dV +0.00 %; surf 100.0 % |
| `smps_lrs150_envelope` | `smps_lrs150_envelope.step` | envelope | bought | 458.87 | n/a | 159.1 x 97.0 x 30.4 | smps_l=159, smps_w=97, smps_h=30 | dV +0.00 %; surf 100.0 % |
| `poe_switch_envelope` | `poe_switch_envelope.step` | envelope | bought | 589.45 | n/a | 40.0 x 140.0 x 106.0 | sw_l=140, sw_w=40, sw_h=105 | dV +0.00 %; surf 100.0 % |
| `lane_controller_pcb_envelope` | `lane_controller_pcb_envelope.step` | envelope | custom PCB (bought) | 26.73 | n/a | 100.0 x 80.0 x 13.6 | lc_l=100, lc_w=80, lc_hole_in=4 | dV +0.00 %; surf 100.0 % |
| `edge_din_rail_envelope` | `edge_din_rail_envelope.step` | envelope | steel/Al DIN rail (bought) | 12.00 | n/a | 240.0 x 35.0 x 8.5 | din_len=240 | dV +0.00 %; surf 100.0 % |
| `edge_din_device_1mod_envelope` | `edge_din_device_1mod_envelope.step` | envelope | bought | 99.45 | n/a | 17.0 x 90.0 x 70.0 |  | dV +0.00 %; surf 100.0 % |
| `edge_din_device_2mod_envelope` | `edge_din_device_2mod_envelope.step` | envelope | bought | 201.82 | n/a | 34.5 x 90.0 x 70.0 |  | dV +0.00 %; surf 100.0 % |
| `edge_buck_module_envelope` | `edge_buck_module_envelope.step` | envelope | bought | 32.40 | n/a | 30.0 x 60.0 x 18.0 |  | no isolated STL ref |
| `edge_wire_trunking_envelope` | `edge_wire_trunking_envelope.step` | envelope | PVC trunking (bought) | 120.00 | n/a | 240.0 x 20.0 x 25.0 | mp_w=260 | no isolated STL ref |

### Assemblies

| Assembly | File | Bodies | Vol cm3 (sum) | Vol cm3 (union est.) | Fabricated-part mass kg | BBox mm | Check vs OpenSCAD |
|---|---|---:|---:|---:|---:|---|---|
| `edge_internals_assy` | `edge_internals_assy.step` | 21 | 2714.0 | 2588.6 | 0.88 | 276.5 x 360.0 x 116.5 | dV -0.06 %; surf 100.0 % |
| `edge_node_assy` | `edge_node_assy.step` | 34 | 5304.8 | 5165.7 | 1.82 | 368.0 x 450.5 x 250.0 | dV -0.02 %; surf 100.0 % |

* `edge_internals_assy`: reference STL also contains the Pi hex spacers and the 4 Lane Controller brass standoffs (hardware, not in STEP)
* `edge_node_assy`: reference STL also contains Pi/LC hex standoffs

## (c) Demo boom barrier

### Parts

| Part | File | Type | Material | Vol cm3 | Mass kg | BBox mm | Source params (values) | Check vs OpenSCAD |
|---|---|---|---|---:|---:|---|---|---|
| `barrier_base_plate` | `barrier_base_plate.step` | fabricated | IS2062-E250 (MS) | 878.44 | 6.896 | 360.0 x 310.0 x 8.0 | hs_x=300, hs_y=250, hsg_bp_t=8, hsg_bp_mx=30, anchor_d=10 | dV -0.00 %; surf 100.0 % |
| `barrier_frame_post_20x20` | `barrier_frame_post_20x20.step` | fabricated | Al 6063-T5 | 158.17 | 0.427 | 20.0 x 20.0 x 798.0 | frame_w=20, hs_z=800 | dV -0.11 %; surf 100.0 % |
| `barrier_frame_rail_x_20x20` | `barrier_frame_rail_x_20x20.step` | fabricated | Al 6063-T5 | 51.54 | 0.139 | 20.0 x 20.0 x 260.0 | frame_w=20, hs_x=300 | dV -0.11 %; surf 100.0 % |
| `barrier_frame_rail_y_20x20` | `barrier_frame_rail_y_20x20.step` | fabricated | Al 6063-T5 | 41.62 | 0.112 | 20.0 x 20.0 x 210.0 | frame_w=20, hs_y=250 | dV -0.11 %; surf 100.0 % |
| `barrier_front_panel` | `barrier_front_panel.step` | fabricated | Al 5052-H32 | 478.24 | 1.282 | 300.0 x 2.0 x 800.0 | hs_x=300, hs_z=800, panel_t=2, shaft_z=720, hsg_bp_t=8, shaft_d=20 | dV -0.00 %; surf 100.0 % |
| `barrier_back_panel` | `barrier_back_panel.step` | fabricated | Al 5052-H32 | 480.00 | 1.286 | 300.0 x 2.0 x 800.0 | hs_x=300, hs_z=800, panel_t=2 | no isolated STL ref |
| `barrier_side_panel` | `barrier_side_panel.step` | fabricated | Al 5052-H32 | 400.00 | 1.072 | 2.0 x 250.0 x 800.0 | hs_y=250, hs_z=800, panel_t=2 | no isolated STL ref |
| `barrier_roof` | `barrier_roof.step` | fabricated | Al 5052-H32 | 268.80 | 0.720 | 320.0 x 280.0 x 3.0 | hs_x=300, hs_y=250, roof_t=3 | no isolated STL ref |
| `barrier_motor_plate` | `barrier_motor_plate.step` | fabricated | Al 6061-T6 | 175.42 | 0.474 | 200.0 x 150.0 x 6.0 | mplate_w=200, mplate_h=150, mplate_t=6, gm_shaft_off=20 | dV -0.00 %; surf 100.0 % |
| `barrier_bearing_plate` | `barrier_bearing_plate.step` | fabricated | Al 6061-T6 | 150.43 | 0.406 | 260.0 x 100.0 x 6.0 | hs_x=300, frame_w=20, mplate_t=6, shaft_d=20 | dV -0.00 %; surf 100.0 % |
| `barrier_stub_shaft` | `barrier_stub_shaft.step` | fabricated | EN8 (080M40) steel | 49.64 | 0.390 | 20.0 x 20.0 x 158.0 | shaft_d=20, gm_face_y=15, hub_t=16, hub_gap=35, panel_t=2, hs_y=250 | no isolated STL ref |
| `barrier_hub` | `barrier_hub.step` | fabricated | Al 6061-T6 | 99.81 | 0.269 | 135.0 x 70.0 x 16.0 | hub_d=70, hub_t=16, tongue_l=70, tongue_t=12, tongue_w=60, hinge_r=45, hinge_d=8, +5 more | dV +0.01 %; surf 100.0 % |
| `barrier_limit_flag` | `barrier_limit_flag.step` | fabricated | Al 5052-H32 | 3.30 | 0.009 | 63.0 x 20.0 x 3.0 | flag_r=55, flag_t=3 | dV +0.00 %; surf 100.0 % |
| `barrier_carrier_plate` | `barrier_carrier_plate.step` | fabricated | Al 6061-T6 | 57.15 | 0.154 | 180.0 x 70.0 x 5.0 | carrier_l=160, carrier_w=70, carrier_t=5, hinge_r=45, hinge_d=8, shear_e=35, shear_d=5, +1 more | dV +0.00 %; surf 100.0 % |
| `barrier_shear_pin` | `barrier_shear_pin.step` | fabricated | Al 6061-T6 | 1.49 | 0.004 | 5.0 x 76.0 x 5.0 | shear_d=5, tongue_w=60, carrier_t=5, hinge_r=45, shear_e=35 | no isolated STL ref |
| `barrier_boom_tube` | `barrier_boom_tube.step` | fabricated | Al 6063-T5 | 276.14 | 0.746 | 60.0 x 30.0 x 1065.0 | boom_h=60, boom_b=30, boom_t=1.5, boom_L=1200, hinge_r=45, tip_cap_l=30 | dV +0.00 %; surf 100.0 % |
| `barrier_boom_tip_cap` | `barrier_boom_tip_cap.step` | fabricated | ASA (FDM) | 57.94 | 0.062 | 64.0 x 34.0 x 55.0 | boom_h=60, boom_b=30 | dV -0.79 %; surf 100.0 %; cad/stl dV -0.79 % |
| `barrier_cw_tail_bar` | `barrier_cw_tail_bar.step` | fabricated | IS2062-E250 (MS) | 94.00 | 0.738 | 235.0 x 40.0 x 10.0 | cw_arm=200, cw_plate_x=100, hub_d=70, cw_bar_w=40, cw_bar_t=10 | no isolated STL ref |
| `barrier_cw_plate` | `barrier_cw_plate.step` | fabricated | IS2062-E250 (MS) | 58.20 | 0.457 | 100.0 x 60.0 x 9.7 | cw_plate_x=100, cw_plate_z=60, cw_plate_t=10, cw_n=7 | no isolated STL ref |
| `barrier_photo_post_foot` | `barrier_photo_post_foot.step` | fabricated | IS2062-E250 (MS) | 48.47 | 0.381 | 100.0 x 100.0 x 5.0 | pb_foot=100 | dV -0.00 %; surf 100.0 % |
| `barrier_photo_post_20x20` | `barrier_photo_post_20x20.step` | fabricated | Al 6063-T5 | 89.20 | 0.241 | 20.0 x 20.0 x 450.0 | pb_post_h=450 | dV -0.11 %; surf 100.0 % |
| `barrier_photo_post_cap` | `barrier_photo_post_cap.step` | fabricated | ASA (FDM) | 2.47 | 0.003 | 24.0 x 24.0 x 8.0 |  | dV +0.00 %; surf 100.0 %; cad/stl dV +0.01 % |
| `barrier_limit_sensor_bracket` | `barrier_limit_sensor_bracket.step` | fabricated | Al 5052-H32 | 7.77 | 0.021 | 105.2 x 26.0 x 3.0 | lim_sw_r=62, shaft_d=20 | no isolated STL ref |
| `barrier_flange_bearing_envelope` | `barrier_flange_bearing_envelope.step` | envelope | bought (UCFL204 class) | 83.99 | n/a | 116.0 x 36.0 x 60.0 | brg_flange=60 | dV +0.02 %; surf 100.0 % |
| `barrier_gearmotor_envelope` | `barrier_gearmotor_envelope.step` | envelope | bought | 786.76 | n/a | 200.0 x 75.0 x 105.0 | gm_box_x=90, gm_box_y=75, gm_box_z=70, gm_motor_d=60, gm_motor_l=110, gm_shaft_d=12, gm_shaft_l=30, +1 more | dV +0.02 %; surf 100.0 % |
| `barrier_jaw_coupling_envelope` | `barrier_jaw_coupling_envelope.step` | envelope | bought | 21.21 | n/a | 30.0 x 30.0 x 30.0 | coup_d=30, coup_l=30 | no isolated STL ref |
| `barrier_photo_head_envelope` | `barrier_photo_head_envelope.step` | envelope | bought | 16.84 | n/a | 60.6 x 27.0 x 31.2 |  | dV +0.03 %; surf 100.0 % |
| `barrier_m12_inductive_sensor_envelope` | `barrier_m12_inductive_sensor_envelope.step` | envelope | bought | 5.09 | n/a | 12.0 x 12.0 x 45.0 |  | no isolated STL ref |

### Assemblies

| Assembly | File | Bodies | Vol cm3 (sum) | Vol cm3 (union est.) | Fabricated-part mass kg | BBox mm | Check vs OpenSCAD |
|---|---|---:|---:|---:|---:|---|---|
| `barrier_housing_assy` | `barrier_housing_assy.step` | 18 | 3910.8 | 3838.3 | 15.04 | 360.0 x 310.0 x 823.2 | dV -0.23 %; surf 100.0 % |
| `barrier_drive_train_assy` | `barrier_drive_train_assy.step` | 7 | 1351.4 | 1324.4 | 1.27 | 305.0 x 273.0 x 150.0 | dV +0.09 %; surf 100.0 % |
| `barrier_rotor_assy` | `barrier_rotor_assy.step` | 15 | 1054.4 | 1046.4 | 5.33 | 1460.0 x 84.0 x 109.7 | dV -3.20 %; surf 98.8 %; **MISMATCH** |
| `barrier_limit_sensors_assy` | `barrier_limit_sensors_assy.step` | 3 | 17.9 | 17.9 | 0.02 | 105.2 x 26.0 x 48.0 | dV +0.19 %; surf 100.0 % |
| `barrier_photo_post_assy` | `barrier_photo_post_assy.step` | 4 | 157.0 | 157.0 | 0.62 | 120.6 x 100.0 x 463.0 | dV -0.63 %; surf 99.0 %; **MISMATCH** |
| `barrier_assembly` | `barrier_assembly.step` | 51 | 6648.5 | 6527.7 | 22.92 | 1710.0 x 424.7 x 823.2 | dV -0.85 %; surf 99.8 %; **MISMATCH** |

* `barrier_housing_assy`: reference STL also contains 8 hazard-band decal strips 0.5 mm thick
* `barrier_rotor_assy`: reference STL also contains the M8 hinge bolt, 2 M6 clamp bolts, 2 M8 counterweight studs, red tape bands and a different (solid) inline tip cap
* `barrier_photo_post_assy`: reference photo_post() draws a solid 24x24x6 cap instead of the printed hollow cap
* `barrier_assembly`: reference STL additionally has anchor nuts, hinge/clamp bolts, studs, decals, tape bands, beam line, solid inline caps

## (d) Occupancy node

### Parts

| Part | File | Type | Material | Vol cm3 | Mass kg | BBox mm | Source params (values) | Check vs OpenSCAD |
|---|---|---|---|---:|---:|---|---|---|
| `occ_base` | `occ_base.step` | fabricated | ASA (FDM) | 34.81 | 0.037 | 96.0 x 96.0 x 22.0 | oc_d=96, oc_wall=2.4, oc_base_h=22, oc_floor=3, oc_screw_pitch=60, oc_screw_d=5.5, oc_cable_d=8, +4 more | dV +0.08 %; surf 100.0 %; cad/stl dV +0.07 % |
| `occ_cover` | `occ_cover.step` | fabricated | ASA (FDM) | 42.54 | 0.046 | 96.0 x 96.0 x 38.0 | oc_d=96, oc_wall=2.4, oc_cover_h=26, fit_clear=0.25, lip_h=5, snap_n=3, snap_w=10, +6 more | dV +0.07 %; surf 100.0 %; cad/stl dV -12.49 %; **MISMATCH** |
| `occ_probe_clamp_boss` | `occ_probe_clamp_boss.step` | fabricated | ASA (FDM) | 5.38 | 0.006 | 42.0 x 42.0 x 12.0 | probe_d=34, oc_cover_h=26 | no isolated STL ref |
| `occ_led_seat` | `occ_led_seat.step` | fabricated | ASA (FDM) | 0.72 | 0.001 | 54.0 x 54.0 x 1.5 | ring_od=50, oc_cover_h=26 | no isolated STL ref |
| `occ_diffuser` | `occ_diffuser.step` | fabricated | PETG (natural) | 3.98 | 0.005 | 53.6 x 53.6 x 3.0 | ring_od=50, ring_id=36, diffuser_t=1.2 | dV +0.04 %; surf 100.0 %; cad/stl dV +0.16 % |
| `esp32c3_board_envelope` | `esp32c3_board_envelope.step` | envelope | bought | 2.88 | n/a | 49.0 x 26.0 x 4.8 |  | dV -0.00 %; surf 100.0 % |
| `a02yyuw_ultrasonic_envelope` | `a02yyuw_ultrasonic_envelope.step` | envelope | bought | 51.62 | n/a | 61.0 x 42.0 x 44.5 | a02_probe_d=34, a02_probe_l=26, a02_body_w=42, a02_body_l=36, a02_body_h=18 | dV +0.02 %; surf 100.0 % |
| `ws2812_ring_envelope` | `ws2812_ring_envelope.step` | envelope | bought | 1.75 | n/a | 50.0 x 50.0 x 2.4 | ring_od=50, ring_id=36 | dV +0.03 %; surf 100.0 % |
| `occ_cable_grommet_envelope` | `occ_cable_grommet_envelope.step` | envelope | rubber (bought) | 0.68 | n/a | 12.0 x 12.0 x 6.0 |  | no isolated STL ref |

### Assemblies

| Assembly | File | Bodies | Vol cm3 (sum) | Vol cm3 (union est.) | Fabricated-part mass kg | BBox mm | Check vs OpenSCAD |
|---|---|---:|---:|---:|---:|---|---|
| `occupancy_node_assy` | `occupancy_node_assy.step` | 9 | 144.4 | 141.4 | 0.09 | 96.0 x 96.0 x 54.5 | dV -1.06 %; surf 100.0 %; **MISMATCH** |

* `occupancy_node_assy`: reference STL also contains the 2 M5 countersunk screws

## (e) Lane layout

### Parts

| Part | File | Type | Material | Vol cm3 | Mass kg | BBox mm | Source params (values) | Check vs OpenSCAD |
|---|---|---|---|---:|---:|---|---|---|
| `lane_rig_post_40x40` | `lane_rig_post_40x40.step` | fabricated | Al 6063-T5 | 2163.18 | 5.841 | 40.0 x 40.0 x 2400.0 |  | dV -0.10 %; surf 100.0 % |
| `lane_rig_crossbar_40x40` | `lane_rig_crossbar_40x40.step` | fabricated | Al 6063-T5 | 630.93 | 1.704 | 40.0 x 40.0 x 700.0 |  | dV -0.10 %; surf 100.0 % |

### Assemblies

| Assembly | File | Bodies | Vol cm3 (sum) | Vol cm3 (union est.) | Fabricated-part mass kg | BBox mm | Check vs OpenSCAD |
|---|---|---:|---:|---:|---:|---|---|
| `lane_layout_assy` | `lane_layout_assy.step` | 129 | 36514.1 | 36196.4 | 79.29 | 4380.0 x 2149.3 x 2491.4 | dV -0.58 %; surf 100.0 %; **MISMATCH** |

* `lane_layout_assy`: reference STL = the same three layout() placements run through OpenSCAD (hardware included in reference only). The gantry is MIRRORED (x -> -x) exactly as in the .scad, so handed parts are mirror-image copies.

## Masses: CAD volume x MATERIALS.md density vs MATERIALS.md

CAD mass = STEP volume x density (steel 7850, Al 6063/6061 2700, Al 5052 2680, ASA 1070, PETG 1270 kg/m3; see top of `manifest.py`). A row is flagged **DISAGREE** when the two differ by more than 5 %. The comparison is mechanical - the explanation column states only what can be read from the source files.

### (a) Lane gantry pole

| MATERIALS.md line | MATERIALS kg | CAD kg | Delta % | Flag | Note |
|---|---:|---:|---:|---|---|
| Pole 80x80, L 2400 | 12.96 | 31.694 | +144.6 | **DISAGREE** |  |
| Base plate 250x250x16 | 7.68 | 7.604 | -1.0 | ok |  |
| Socket cheeks 2x93x150 + 2x81x150, 6 mm | 2.43 | 2.424 | -0.2 | ok |  |
| Gussets 4x 74x120x6 | 1.13 | 1.076 | -4.8 | ok |  |
| Antenna arm 40x40, L 350 | 0.53 | 0.852 | +60.7 | **DISAGREE** |  |
| Antenna yoke, 5 mm | 0.44 | 0.671 | +52.5 | **DISAGREE** |  |
| Antenna tilt plate, 5 mm | 0.64 | 0.654 | +2.1 | ok |  |
| Camera arm 40x40 (label says L 250) + adapter plate | 0.58 | 0.729 | +25.7 | **DISAGREE** |  |
| Sign brackets 2x 3 mm | 0.26 | 0.252 | -3.0 | ok |  |
| Edge Node pole brackets 2x 340x50x3 | 0.8 | 0.785 | -1.8 | ok |  |
| Pole cap (ASA) | 0.07 | 0.074 | +6.0 | **DISAGREE** |  |
| Cable boot (ASA) | 0.1 | 0.102 | +2.2 | ok |  |

Sum of the listed MATERIALS.md rows incl. bought/est. rows (Cable channel 40x25 PVC (est.)): **28.120 kg**; MATERIALS.md states **28.4 kg** (consistent). Rows with a CAD mass: MATERIALS 27.620 kg vs CAD 46.918 kg.

### (b) Edge Node

| MATERIALS.md line | MATERIALS kg | CAD kg | Delta % | Flag | Note |
|---|---:|---:|---:|---|---|
| Mounting plate 260x360x3 | 0.75 | 0.748 | -0.3 | ok |  |
| Heat spreader 100x70x5 + bar | 0.14 | 0.105 | -24.7 | **DISAGREE** |  |
| External heat sink 200x150, 18 fins (bought) | 1 | 1.166 | +16.6 | **DISAGREE** |  |
| Pi tray (ASA) | 0.02 | 0.022 | +10.5 | **DISAGREE** |  |
| Sun hood 2 mm (est.) | 0.9 | 0.946 | +5.1 | **DISAGREE** |  |

Sum of the listed MATERIALS.md rows incl. bought/est. rows (Enclosure (PC, est.), Gasket, Sink window gasket, Glands + vent, Electronics (est.)): **8.090 kg**; MATERIALS.md states **9 kg** (**DISAGREE by -10.1 %**). Rows with a CAD mass: MATERIALS 2.810 kg vs CAD 2.988 kg.

### (c) Demo boom barrier

| MATERIALS.md line | MATERIALS kg | CAD kg | Delta % | Flag | Note |
|---|---:|---:|---:|---|---|
| Base plate (label: 360x310x8) | 4.71 | 6.896 | +46.4 | **DISAGREE** |  |
| Frame 20x20 (4 posts + 8 rails) | 2.07 | 2.714 | +31.1 | **DISAGREE** |  |
| Skins 2 mm + roof 3 mm | 5.12 | 5.432 | +6.1 | **DISAGREE** |  |
| Motor plate 200x150x6 | 0.49 | 0.474 | -3.3 | ok |  |
| Bearing plate | 0.3 | 0.406 | +35.4 | **DISAGREE** |  |
| Stub shaft D20 | 0.3 | 0.390 | +29.9 | **DISAGREE** |  |
| Hub D70 + tongue | 0.31 | 0.269 | -13.1 | **DISAGREE** |  |
| Carrier plates 2x 5 mm | 0.3 | 0.309 | +2.9 | ok |  |
| Shear pin D5 | 0.002 | 0.004 | +101.5 | **DISAGREE** |  |
| Boom 60x30x1.5 (label: L 1135) | 0.85 | 0.746 | -12.3 | **DISAGREE** |  |
| Boom tip cap (ASA) | 0.06 | 0.062 | +3.3 | ok |  |
| Counterweight 7x 100x60x10 (+ tail bar) | 2.98 | 3.936 | +32.1 | **DISAGREE** |  |
| Limit flag(s) 3 mm | 0.04 | 0.009 | -77.9 | **DISAGREE** |  |
| Photo-beam posts 2x + 100x100x5 feet | 1.24 | 1.243 | +0.2 | ok |  |

Sum of the listed MATERIALS.md rows incl. bought/est. rows (Gearmotor (est.)): **21.272 kg**; MATERIALS.md states **24 kg** (**DISAGREE by -11.4 %**). Rows with a CAD mass: MATERIALS 18.772 kg vs CAD 22.889 kg.

### (d) Occupancy node

| MATERIALS.md line | MATERIALS kg | CAD kg | Delta % | Flag | Note |
|---|---:|---:|---:|---|---|
| Base (ASA) - 37 g | 0.037 | 0.037 | +0.7 | ok |  |
| Cover (ASA) - 52 g | 0.052 | 0.046 | -12.5 | **DISAGREE** |  |
| Diffuser (PETG) - 5 g | 0.005 | 0.005 | +1.1 | ok |  |

Sum of the listed MATERIALS.md rows incl. bought/est. rows (Electronics (est.)): **0.129 kg**; MATERIALS.md states **0.13 kg** (consistent). Rows with a CAD mass: MATERIALS 0.094 kg vs CAD 0.088 kg.

### Weldment cross-check against the sentence at the top of MATERIALS.md

MATERIALS.md says the CadQuery B-rep weldment volume is 1424.8 cm3 (11.2 kg). The weldment regenerated from the .scad (grout slots and cheek relief notches added, which the first CadQuery version omitted) is **1414.5 cm3 = 11.10 kg**. The 11.24 kg 'analytical sum' in MATERIALS.md is 7.68 + 2.43 + 1.13 and is itself a rounded-area estimate (`calcs.py` section 6), not a CAD number.

## Interferences (overlapping bodies in assemblies)

The OpenSCAD model unions everything, so overlaps are invisible there. In STEP assemblies they are real overlapping solids. Largest overlaps per assembly (pairwise common volume > 1 mm3; mm3):

* `gantry_antenna_arm_assy`: 1 overlapping pairs, total 0.50 cm3. tilt_plate / rfid_reader: 502.7
* `edge_internals_assy`: 6 overlapping pairs, total 125.38 cm3. smps_lrs150 / wire_trunking: 79528; din_device_6 / din_device_7: 11700; din_device_7 / din_device_8: 11700; din_device_8 / poe_switch: 11700; mount_plate_3mm_5052 / din_rail: 6432.3; buck_module / wire_trunking: 4320
* `edge_node_assy`: 11 overlapping pairs, total 139.15 cm3. smps_lrs150 / wire_trunking: 79528; din_device_6 / din_device_7: 11700; din_device_7 / din_device_8: 11700; din_device_8 / poe_switch: 11700; mount_plate_3mm_5052 / din_rail: 6432.3; heat_sink / sun_hood: 5760
* `gantry_assembly`: 20 overlapping pairs, total 182.21 cm3. smps_lrs150 / wire_trunking: 79528; socket_cheek_short_-x / cable_boot: 14245.8; din_device_6 / din_device_7: 11700; din_device_7 / din_device_8: 11700; din_device_8 / poe_switch: 11700; base_plate_16mm_MS / flexible_conduit: 7854
* `barrier_housing_assy`: 16 overlapping pairs, total 72.47 cm3. frame_post_-1-1 / front_panel: 20794.4; frame_post_+1-1 / front_panel: 20794.4; rail_x_z1_-1 / roof: 8238.6; rail_x_z1_-1 / front_panel: 6775.1; rail_x_z0_-1 / front_panel: 6775.1; rail_y_z1_+1 / roof: 2280.1
* `barrier_drive_train_assy`: 5 overlapping pairs, total 27.00 cm3. flange_bearing_rear / stub_shaft: 11309.7; flange_bearing_front / stub_shaft: 11309.7; gearmotor / jaw_coupling: 1608.2; jaw_coupling / stub_shaft: 1570.8; bearing_plate / flange_bearing_rear: 1206.4
* `barrier_rotor_assy`: 1 overlapping pairs, total 8.00 cm3. hub / counterweight_tail_bar: 8000
* `barrier_assembly`: 27 overlapping pairs, total 120.88 cm3. frame_post_-1-1 / front_panel: 20794.4; frame_post_+1-1 / front_panel: 20794.4; flange_bearing_rear / stub_shaft: 11309.7; flange_bearing_front / stub_shaft: 11309.7; rail_x_z1_-1 / roof: 8238.6; hub / counterweight_tail_bar: 8000
* `occupancy_node_assy`: 5 overlapping pairs, total 2.93 cm3. esp32c3 / a02yyuw: 1947.2; ws2812_ring / diffuser: 807.4; base / cable_grommet: 125.7; base / cover_shell: 38.7; base / a02yyuw: 12.4
* `lane_layout_assy`: 54 overlapping pairs, total 317.69 cm3. smps_lrs150 / wire_trunking: 79528; frame_post_+1-1 / front_panel: 20794.4; frame_post_-1-1 / front_panel: 20794.4; socket_cheek_short_-x / cable_boot: 14245.8; din_device_6 / din_device_7: 11700; din_device_7 / din_device_8: 11700

These are properties of the OpenSCAD source (bought-in envelopes drawn solid, DIN devices wider than their pitch, front panel placed inside the frame envelope, roof tilted into the frame, bolted lap joints) and were NOT silently removed from the STEP files.

## Per-file mismatch explanations

* **Reference hardware.** The OpenSCAD reference modules also draw fasteners, anchors, studs, decals and tape bands. STEP files contain fabricated parts and envelopes only, so assembly bounding boxes differ by the hardware overhang (see table at the top). Part-level files all agree within 1 %.
* **Overlaps.** Assembly volume is compared as sum of bodies minus pairwise overlap because OpenSCAD unions. Overlaps come from the .scad (envelopes drawn solid, DIN devices wider than pitch, front panel inside the frame).
* **Pole mass.** CAD pole 31.7 kg vs 12.96 kg in MATERIALS.md: the .scad T-slot profile is far more solid than the vendor 5.4 kg/m. This is a real inconsistency inside our model, not a STEP error.
* **occ_cover.** The .scad cover is three disconnected solids (shell, probe clamp boss, LED seat). Exported as three STEP parts; the shell is checked against the .scad with the other two added (+0.07 %). The checked-in cad/stl/occ_cover.stl contains all three (compared against the shell only, hence -12.5 %).
* **Totals.** MATERIALS.md edge-node and barrier stated totals (9 kg, 24 kg) are about 10 % and 11 % higher than the sum of their own listed rows (see sections above); gantry total is consistent.

## Limitations

* Fasteners, anchors, decals, tape and wiring are not modelled. Bought-in parts are simplified envelopes at assumed class sizes.
* Literals copied from .scad module bodies (not parameters): DIN device list, lane rig dimensions (2400, 700, 6800, 600, 2380), spreader bar length formula, 40 mm slot inset.
* Sign bracket is flat (no bends); tilt plate has sharp bends; sun hood is unbent; T-slot is a generic profile, not a vendor section.
* The occupancy cover keeps the .scad flaws (floating boss and seat); base keyhole counterbore is an enclosed void in the .scad.
* Densities for PC and EPDM are not in MATERIALS.md, so no mass is computed for them.

## History

The four STEP files that existed first (base_weldment, antenna_yoke, antenna_tilt_plate, antenna_bracket_assy) were regenerated. The first versions differed from the .scad (yoke cheek outline, arc slot direction, missing grout slots and cheek notches); the current files follow the .scad and carry the weldment at 1414.5 cm3 instead of 1424.8 cm3.
