kgchord/ParkFlow/cad/fea/results/mesh_stats.csv

tag | nodes | elements | min_SICN | mean_SICN | n_elem_SICN_lt_0.1 | solver_s
A_diag_t12_eq_h11 | 41639 | 21314 | 0.003 | 0.751 | 2 | 242
A_diag_t16_eq_h11 | 42753 | 22013 | 0.050 | 0.739 | 4 | 321
A_diag_t16_eq_h16 | 27882 | 13792 | 0.069 | 0.683 | 6 | 118
A_diag_t16_eq_h8 | 71375 | 39127 | 0.010 | 0.795 | 1 | 713
A_face_t16_eq_h11 | 42753 | 22013 | 0.050 | 0.739 | 4 | 351
A_face_t16_eq_h16 | 27882 | 13792 | 0.069 | 0.683 | 6 | 79
A_face_t16_eq_h8 | 71375 | 39127 | 0.010 | 0.795 | 1 | 1280
A_face_t16_solid_h11 | 42753 | 22013 | 0.050 | 0.739 | 4 | 197
B_arm_h4 | 208617 | 110471 | 0.020 | 0.775 | 7 | 65
B_arm_h6 | 83784 | 41729 | 0.014 | 0.781 | 43 | 13
B_arm_h6_freq | 83784 | 41729 | 0.014 | 0.781 | 43 | 50
B_arm_h8 | 51335 | 25209 | 0.014 | 0.776 | 37 | 7
B_contact_h5 | 129206 | 65581 | 0.008 | 0.778 | 47 | 903
B_contact_h6 | 91611 | 45551 | 0.017 | 0.789 | 28 | 505
B_contact_h8 | 56830 | 27816 | 0.014 | 0.776 | 37 | 232
B_washer_h4 | 208617 | 110471 | 0.020 | 0.775 | 7 | 54
B_washer_h6 | 83784 | 41729 | 0.014 | 0.781 | 43 | 13
B_washer_h8 | 51335 | 25209 | 0.014 | 0.776 | 37 | 7
C_boom_horiz_s12 | 3766 | 1246 | shell minSJ 1.000 |  |  | 2
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
