kgchord/ParkFlow/electronics/kicad/lane_controller.pdf

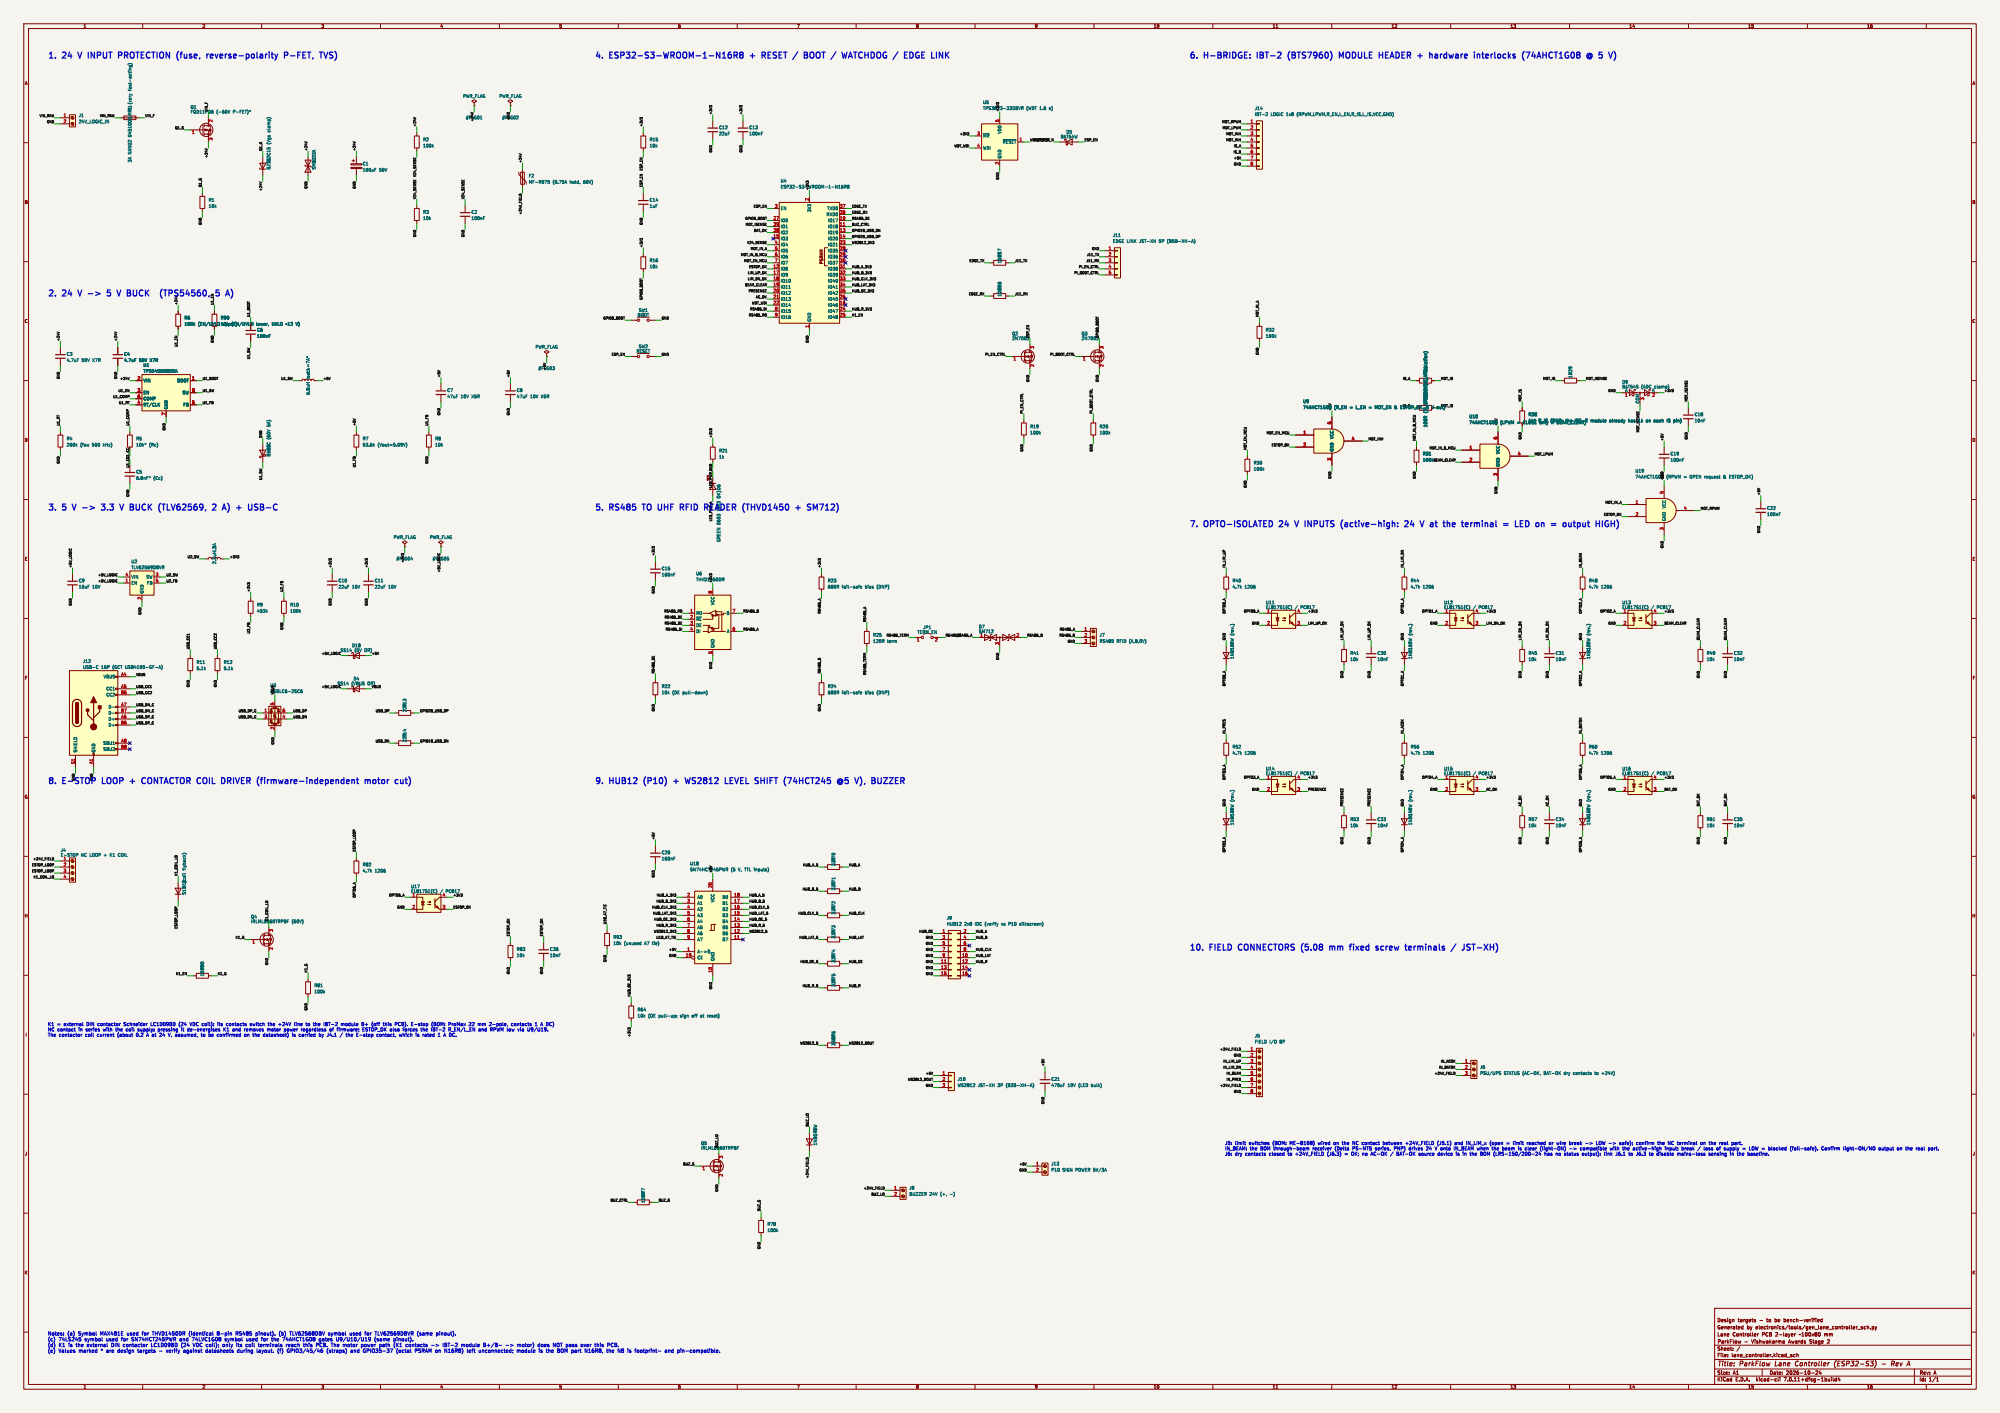
[picture p163: page 1]

10k (EN/UVLO lower, UVLO ~13 V) C6

74AHCT1G08 (LPWM = CLOSE only if BEAM_CLEAR) 1

1k* R_IS (DNP: the IBT-2 module already has 1k on each IS pin)

5. RS485 TO UHF RFID READER (THVD1450 + SM712)

J9HUB12 2x8 IDC (verify vs P10 silkscreen)

10. FIELD CONNECTORS (5.08 mm fixed screw terminals / JST-XH)

File: lane_controller.kicad_sch Sheet: / ParkFlow - Vishwakarma Awards Stage 2
