kgchord/ParkFlow/electronics/kicad/lane_controller.kicad_pcb

## KiCad design electronics/kicad/lane_controller.kicad_pcb (2026-10-25)

Schematic: lane_controller.kicad_sch, ParkFlow Lane Controller (ESP32-S3) - Rev A

Parts:
C1: 100uF 50V; CP_Elec_10x10.5
C2, C6, C13, C15, C19, C20, C22: 100nF; C_0603_1608Metric
C3, C4: 4.7uF 50V X7R; C_1210_3225Metric
C5: 6.8nF* (Cc); C_0603_1608Metric
C7, C8: 47uF 10V X5R; C_1210_3225Metric
C9: 10uF 10V; C_0805_2012Metric
C10, C11: 22uF 10V; C_0805_2012Metric
C12: 22uF; C_0805_2012Metric
C14: 1uF; C_0603_1608Metric
C18, C30, C31, C32, C33, C34, C35, C36: 10nF; C_0603_1608Metric
C21: 470uF 10V (LED bulk); CP_Elec_8x10
D1: BZT52C15 (Vgs clamp); D_SOD-123
D2: SMBJ33A; D_SMB
D3: B560C (60V 5A); D_SMC
D4: SS14 (VBUS OR); D_SMA
D5: BAT54W; D_SOD-323
D6: GREEN 0603 (3V3 OK); LED_0603_1608Metric
D7: SM712; SOT-23
D9: BAT54S (ADC clamp); SOT-23
D10, D11, D12, D13, D14, D15: 1N4148W (rev.); D_SOD-123
D16: S1M (coil flyback); D_SMA
D17: 1N4148W; D_SOD-123
D18: SS14 (5V OR); D_SMA
F1: 3A NANO2 0451003.MRL (very fast-acting); Fuse_Littelfuse-NANO2-451_453
F2: MF-R075 (0.75A hold, 60V); Fuse_Bourns_MF-RG500
J1: 24V_LOGIC_IN; TerminalBlock_Phoenix_MKDS-3-2-5.08_1x02_P5.08mm_Horizontal
J4: E-STOP NC LOOP + K1 COIL; TerminalBlock_Phoenix_MKDS-3-4-5.08_1x04_P5.08mm_Horizontal
J5: FIELD I/O 8P; TerminalBlock_Phoenix_MKDS-3-8-5.08_1x08_P5.08mm_Horizontal
J6: PSU/UPS STATUS (AC-OK, BAT-OK dry contacts to +24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; TerminalBlock_Phoenix_MKDS-3-3-5.08_1x03_P5.08mm_Horizontal
J7: RS485 RFID (A,B,0V); TerminalBlock_Phoenix_MKDS-3-3-5.08_1x03_P5.08mm_Horizontal
J8: BUZZER 24V (+, -); TerminalBlock_Phoenix_MKDS-3-2-5.08_1x02_P5.08mm_Horizontal
J9: HUB12 2x8 IDC (verify vs P10 silkscreen); IDC-Header_2x08_P2.54mm_Vertical
J10: WS2812 JST-XH 3P (B3B-XH-A); JST_XH_B3B-XH-A_1x03_P2.50mm_Vertical
J11: EDGE LINK JST-XH 5P (B5B-XH-A); JST_XH_B5B-XH-A_1x05_P2.50mm_Vertical
J12: USB-C 16P (GCT USB4105-GF-A); USB_C_Receptacle_GCT_USB4105-xx-A_16P_TopMnt_Horizontal
J13: P10 SIGN POWER 5V/3A; TerminalBlock_Phoenix_MKDS-3-2-5.08_1x02_P5.08mm_Horizontal
J14: IBT-2 LOGIC 1x8 (RPWM,LPWM,R_EN,L_EN,R_IS,L_IS,VC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; PinHeader_1x08_P2.54mm_Vertical
JP1: TERM EN; PinHeader_1x02_P2.54mm_Vertical
L1: 6.8uH Isat>=7A*; L_12x12mm_H8mm
L2: 2.2uH 3A; L_Taiyo-Yuden_NR-40xx
Q1: FQD11P06 (-60V P-FET)*; TO-252-2
Q2, Q3: 2N7002; SOT-23
Q4: IRLML0060TRPBF (60V); SOT-23
Q5: IRLML0060TRPBF; SOT-23
R1, R3, R8, R15, R16, R41, R45, R49, R53, R57, R61, R83: 10k; R_0603_1608Metric
R2, R10, R19, R20, R30, R31, R32, R78, R81: 100k; R_0603_1608Metric
R4: 200k (fsw 500 kHz); R_0603_1608Metric
R5: 10k* (Rc); R_0603_1608Metric
R6: 100k (EN/UVLO upper); R_0603_1608Metric
R7: 53.6k (Vout=5.09V); R_0603_1608Metric
R9: 453k; R_0603_1608Metric
R11, R12: 5.1k; R_0603_1608Metric
R13, R14: 22R; R_0603_1608Metric
R17, R18, R77, R80: 100R; R_0603_1608Metric
R21, R29: 1k; R_0603_1608Metric
R22: 10k (DE pull-down); R_0603_1608Metric
R23, R24: 680R fail-safe bias (DNP); R_0603_1608Metric
R25: 120R term; R_0603_1608Metric
R28: 1k* R_IS (DNP: the IBT-2 module already has 1k on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; R_0603_1608Metric
R40, R44, R48, R52, R56, R60, R82: 4.7k 1206; R_1206_3216Metric
R64: 10k (OE pull-up: sign off at reset); R_0603_1608Metric
R70, R71, R72, R73, R74, R75: 33R; R_0603_1608Metric
R76: 330R; R_0603_1608Metric
R90: 10k (EN/UVLO lower, UVLO ~13 V); R_0603_1608Metric
R91: 100R (IS_A isolation); R_0603_1608Metric
R92: 100R (IS_B isolation); R_0603_1608Metric
R93: 10k (unused A7 tie); R_0603_1608Metric
SW1: BOOT; SW_SPST_TL3342
SW2: RESET; SW_SPST_TL3342
U1: TPS54560BDDA; TI_SO-PowerPAD-8_ThermalVias
U2: TLV62569DBVR; SOT-23-5
U3: USBLC6-2SC6; SOT-23-6
U4: ESP32-S3-WROOM-1-N16R8; ESP32-S3-WROOM-1
U5: TPS3823-33DBVR (WDT 1.6 s); SOT-23-5
U6: THVD1450DR; SOIC-8_3.9x4.9mm_P1.27mm
U9: 74AHCT1G08 (R_EN = L_EN = MOT_EN & ESTOP_OK, 5 V 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; SOT-23-5
U10: 74AHCT1G08 (LPWM = CLOSE only if BEAM_CLEAR); SOT-23-5
U11, U12, U13, U14, U15, U16, U17: EL817S1(C) / PC817; SMDIP-4_W9.53mm
U18: SN74HCT245PWR (5 V, TTL inputs); TSSOP-20_4.4x6.5mm_P0.65mm
U19: 74AHCT1G08 (RPWM = OPEN request & ESTOP_OK); SOT-23-5

Connections:
/+3V3: C10.1, C11.1, C12.1, C13.1, C15.1, D9.2 (K), L2.2, R9.1, R15.1, R16.1, R21.1, R23.1, R64.2, U4.2 (3V3), U5.3 (~MR), U5.5 (VDD), U6.8 (VCC), U11.4, U12.4, U13.4, U14.4, U15.4, U16.4, U17.4
/+5V: C7.1, C8.1, C19.1, C20.1, C21.1, C22.1, D18.2 (A), J10.1, J13.1, J14.7, L1.2, R7.1, U9.5 (VCC), U10.5 (VCC), U18.1 (A->B), U18.20 (VCC), U19.5 (VCC)
/+5V_LOGIC: C9.1, D4.1 (K), D18.1 (K), U2.1 (EN), U2.4 (VIN)
/+24V: C1.1, C3.1, C4.1, D1.1 (K), D2.2 (A2), F2.1, Q1.3 (S), R2.1, R6.1, U1.2 (VIN)
/+24V_FIELD: D17.1 (K), F2.2, J4.1, J5.1, J5.7, J6.3, J8.1
/AC_OK: C34.1, R57.1, U4.21 (IO13), U15.3
/BAT_OK: C35.1, R61.1, U4.38 (IO2), U16.3
/BEAM_CLEAR: C32.1, R49.1, U4.19 (IO11), U10.2, U13.3
/BUZ_CTRL: R77.1, U4.11 (IO18)
/BUZ_G: Q5.1 (G), R77.2, R78.1
/BUZ_LO: D17.2 (A), J8.2, Q5.3 (D)
/EDGE_RX: R18.1, U4.36 (RXD0)
/EDGE_TX: R17.1, U4.37 (TXD0)
/ESP_EN: C14.1, D5.2 (A), Q2.3 (D), R15.2, SW2.1, U4.3 (EN)
/ESTOP_LOOP: D16.1 (K), J4.2, J4.3, R82.1
/ESTOP_OK: C36.1, R83.1, U4.12 (IO8), U9.2, U17.3, U19.2
/GND: C1.2, C2.2, C3.2, C4.2, C5.2, C7.2, C8.2, C9.2, C10.2, C11.2, C12.2, C13.2, C14.2, C15.2, C18.2, C19.2, C20.2, C21.2, C22.2, C30.2, C31.2, C32.2, C33.2, C34.2, C35.2, C36.2, D2.1 (A1), D3.2 (A), D6.1 (K), D7.3 (common), D9.1 (A), D10.2 (A), D11.2 (A), D12.2 (A), D13.2 (A), D14.2 (A), D15.2 (A), J1.2, J5.2, J5.8, J7.3, J9.3, J9.5, J9.7, J9.9, J9.11, J9.13, J9.15, J10.3, J11.1, J12.A1 (GND), J12.A12 (GND), J12.B1 (GND), J12.B12 (GND), J12.S1 (SHIELD), J13.2, J14.8, Q2.2 (S), Q3.2 (S), Q4.2 (S), Q5.2 (S), R1.2, R3.2, R4.2, R8.2, R10.2, R11.2, R12.2, R19.2, R20.2, R22.2, R24.2, R28.2, R30.2, R31.2, R32.2, R41.2, R45.2, R49.2, R53.2, R57.2, R61.2, R78.2, R81.2, R83.2, R90.2, R93.2, SW1.2, SW2.2, U1.7 (GND), U1.9 (GND), U2.2 (GND), U3.2 (GND), U4.1 (GND), U4.40 (GND), U4.41 (GND), U5.2 (GND), U6.5 (GND), U9.3 (GND), U10.3 (GND), U11.2, U12.2, U13.2, U14.2, U15.2, U16.2, U17.2, U18.10 (GND), U18.19 (CE), U19.3 (GND)
/GPIO0_BOOT: Q3.3 (D), R16.2, SW1.1, U4.27 (IO0)
/GPIO19_USB_DN: R14.2, U4.13 (IO19)
/GPIO20_USB_DP: R13.2, U4.14 (IO20)
/HUB_A: J9.2, R70.2
/HUB_A_3V3: U4.31 (IO38), U18.2 (A0)
/HUB_A_5: R70.1, U18.18 (B0)
/HUB_B: J9.4, R71.2
/HUB_B_3V3: U4.32 (IO39), U18.3 (A1)
/HUB_B_5: R71.1, U18.17 (B1)
/HUB_CLK: J9.8, R72.2
/HUB_CLK_3V3: U4.33 (IO40), U18.4 (A2)
/HUB_CLK_5: R72.1, U18.16 (B2)
/HUB_LAT: J9.10, R73.2
/HUB_LAT_3V3: U4.34 (IO41), U18.5 (A3)
/HUB_LAT_5: R73.1, U18.15 (B3)
/HUB_OE: J9.1, R74.2
/HUB_OE_3V3: R64.1, U4.35 (IO42), U18.6 (A4)
/HUB_OE_5: R74.1, U18.14 (B4)
/HUB_R: J9.12, R75.2
/HUB_R_3V3: U4.24 (IO47), U18.7 (A5)
/HUB_R_5: R75.1, U18.13 (B5)
/IN_ACOK: J6.1, R56.1
/IN_BATOK: J6.2, R60.1
/IN_BEAM: J5.5, R48.1
/IN_LIM_DN: J5.4, R44.1
/IN_LIM_UP: J5.3, R40.1
/IN_PRES: J5.6, R52.1
/IS_A: J14.5, R91.1
/IS_B: J14.6, R92.1
/J11_RX: J11.3, R18.2
/J11_TX: J11.2, R17.2
/K1_COIL_LO: D16.2 (A), J4.4, Q4.3 (D)
/K1_EN: R80.1, U4.25 (IO48)
/K1_G: Q4.1 (G), R80.2, R81.1
/LED_PWR_A: D6.2 (A), R21.2
/LIM_DN_OK: C31.1, R45.1, U4.18 (IO10), U12.3
/LIM_UP_OK: C30.1, R41.1, U4.17 (IO9), U11.3
/MOT_EN_MCU: R30.1, U4.7 (IO7), U9.1
/MOT_INH: J14.3, J14.4, U9.4
/MOT_IN_A: R32.1, U4.5 (IO5), U19.1
/MOT_IN_B_MCU: R31.1, U4.6 (IO6), U10.1
/MOT_IS: R28.1, R29.1, R91.2, R92.2
/MOT_ISENSE: C18.1, D9.3 (COM), R29.2, U4.39 (IO1)
/MOT_LPWM: J14.2, U10.4
/MOT_RPWM: J14.1, U19.4
/OPTO0_A: D10.1 (K), R40.2, U11.1
/OPTO1_A: D11.1 (K), R44.2, U12.1
/OPTO2_A: D12.1 (K), R48.2, U13.1
/OPTO3_A: D13.1 (K), R52.2, U14.1
/OPTO4_A: D14.1 (K), R56.2, U15.1
/OPTO5_A: D15.1 (K), R60.2, U16.1
/OPTO6_A: R82.2, U17.1
/PI_BOOT_CTRL: J11.5, Q3.1 (G), R20.1
/PI_EN_CTRL: J11.4, Q2.1 (G), R19.1
/PRESENCE: C33.1, R53.1, U4.20 (IO12), U14.3
/Q1_G: D1.2 (A), Q1.1 (G), R1.1
/RS485_A: D7.1 (A1), J7.1, R23.2, R25.1, U6.6 (A)
/RS485_B: D7.2 (A2), J7.2, JP1.2 (B), R24.1, U6.7 (B)
/RS485_DE: R22.1, U4.10 (IO17), U6.2 (~RE), U6.3 (DE)
/RS485_DI: U4.8 (IO15), U6.4 (DI)
/RS485_RO: U4.9 (IO16), U6.1 (RO)
/RS485_TERM: JP1.1 (A), R25.2
/U1_BOOT: C6.1, U1.1 (BOOT)
/U1_CC: C5.1, R5.2
/U1_COMP: R5.1, U1.6 (COMP)
/U1_EN: R6.2, R90.1, U1.3 (EN)
/U1_FB: R7.2, R8.1, U1.5 (FB)
/U1_RT: R4.1, U1.4 (RT/CLK)
/U1_SW: C6.2, D3.1 (K), L1.1, U1.8 (SW)
/U2_FB: R9.2, R10.1, U2.5 (FB)
/U2_SW: L2.1, U2.3 (SW)
/U18_A7_TIE: R93.1, U18.9 (A7)
/USB_CC1: J12.A5 (CC1), R11.1
/USB_CC2: J12.B5 (CC2), R12.1
/USB_DN: R14.1, U3.4 (I/O2)
/USB_DN_C: J12.A7 (D-), J12.B7 (D-), U3.3 (I/O2)
/USB_DP: R13.1, U3.6 (I/O1)
/USB_DP_C: J12.A6 (D+), J12.B6 (D+), U3.1 (I/O1)
/V24_SENSE: C2.1, R2.2, R3.1, U4.4 (IO4)
/VBUS: D4.2 (A), J12.A4 (VBUS), J12.A9 (VBUS), J12.B4 (VBUS), J12.B9 (VBUS), U3.5 (VBUS)
/VIN_F: F1.2, Q1.2 (D)
/VIN_RAW: F1.1, J1.1
/WDT_RST_N: D5.1 (K), U5.1 (~RESET)
/WDT_WDI: U4.22 (IO14), U5.4 (WDI)
/WS2812_3V3: U4.23 (IO21), U18.8 (A6)
/WS2812_5: R76.1, U18.12 (B6)
/WS2812_DOUT: J10.2, R76.2

Notes on the sheet:
1. 24 V INPUT PROTECTION (fuse, reverse-polarity P-FET, TVS)
2. 24 V -> 5 V BUCK (TPS54560, 5 A)
3. 5 V -> 3.3 V BUCK (TLV62569, 2 A) + USB-C
4. ESP32-S3-WROOM-1-N16R8 + RESET / BOOT / WATCHDOG / EDGE LINK
5. RS485 TO UHF RFID READER (THVD1450 + SM712)
6. H-BRIDGE: IBT-2 (BTS7960) MODULE HEADER + hardware interlocks (74AHCT1G08 @ 5 V)
7. OPTO-ISOLATED 24 V INPUTS (active-high: 24 V at the terminal = LED on = output HIGH)
8. E-STOP LOOP + CONTACTOR COIL DRIVER (firmware-independent motor cut)
9. HUB12 (P10) + WS2812 LEVEL SHIFT (74HCT245 @5 V), BUZZER
10. FIELD CONNECTORS (5.08 mm fixed screw terminals / JST-XH)
Notes: (a) Symbol MAX481E used for THVD1450DR (identical 8-pin RS485 pinout). (b) TLV62568DBV symbol used for TLV62569DBVR (same pinout). (c) 74LS245 symbol used for SN74HCT245PWR and 74LVC1G08 symbol used for the 74AHCT1G08 gates U9/U10/U19 (same pinout). (d) K1 is the external DIN contactor LC1D0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
K1 = external DIN contactor Schneider LC1D09BD (24 VDC coil); its contacts switch the +24V line to the IBT-2 module B+ (off this PCB). E-stop (BOM: ProMax 22 mm 2-pole, contacts 1 A DC) NC contact in series with the coil supply: pressing it de-energises K1 and removes motor power regardless of firm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
J5: limit switches (BOM: ME-8108) wired on the NC contact between +24V_FIELD (J5.1) and IN_LIM_x (open = limit reached or wire break -> LOW -> safe); confirm the NC terminal on the real part. IN_BEAM: the BOM through-beam receiver (Delta PS-MT5 series, PNP) drives 24 V onto IN_BEAM when the beam is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

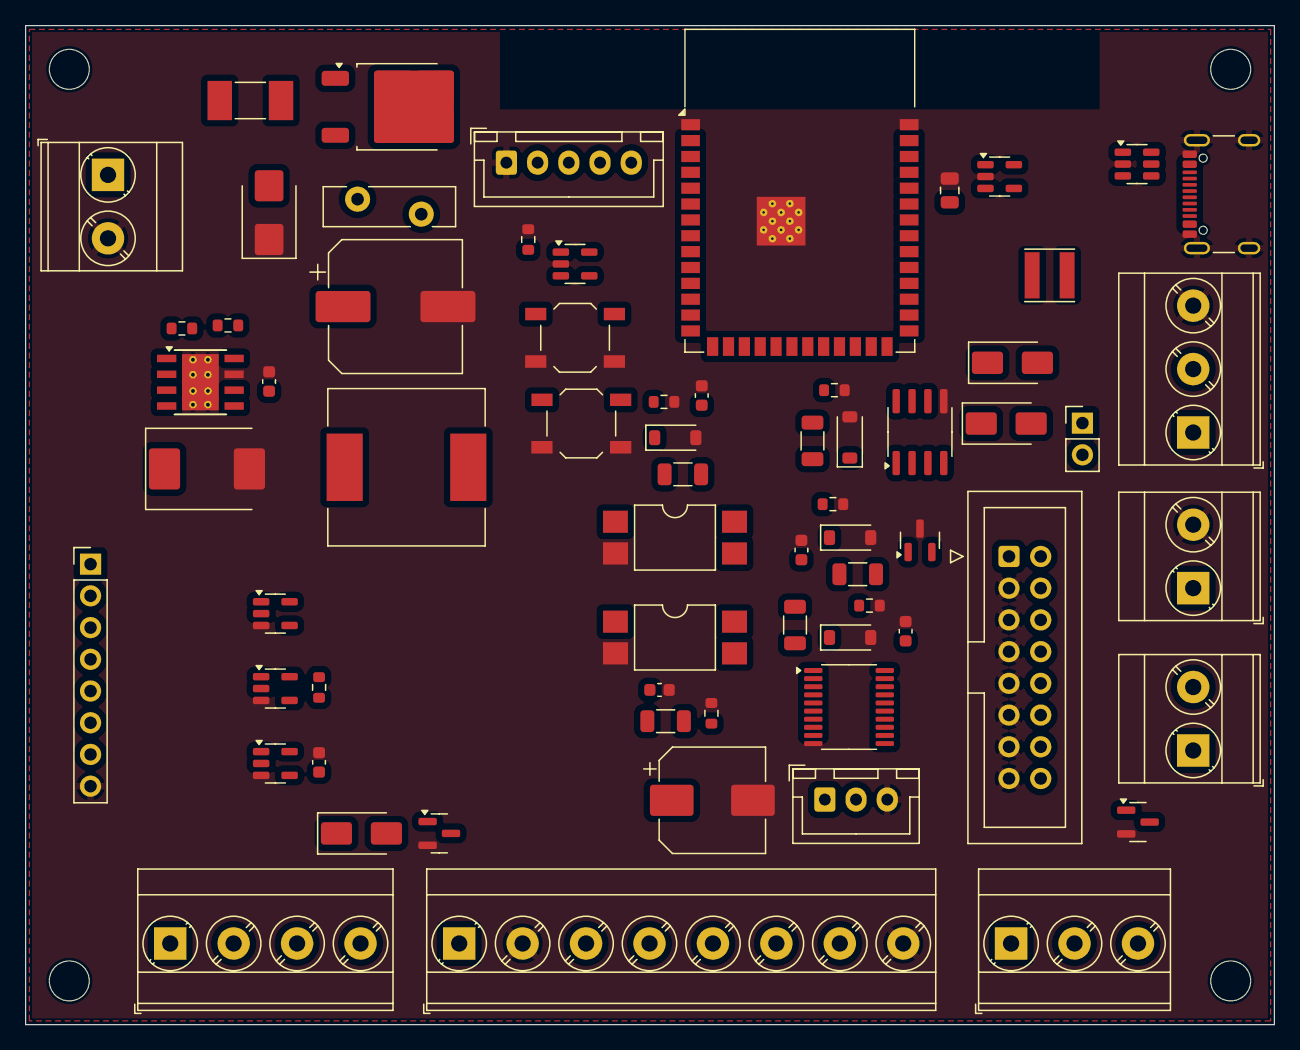
[picture p164: board lane_controller.kicad_pcb from above]

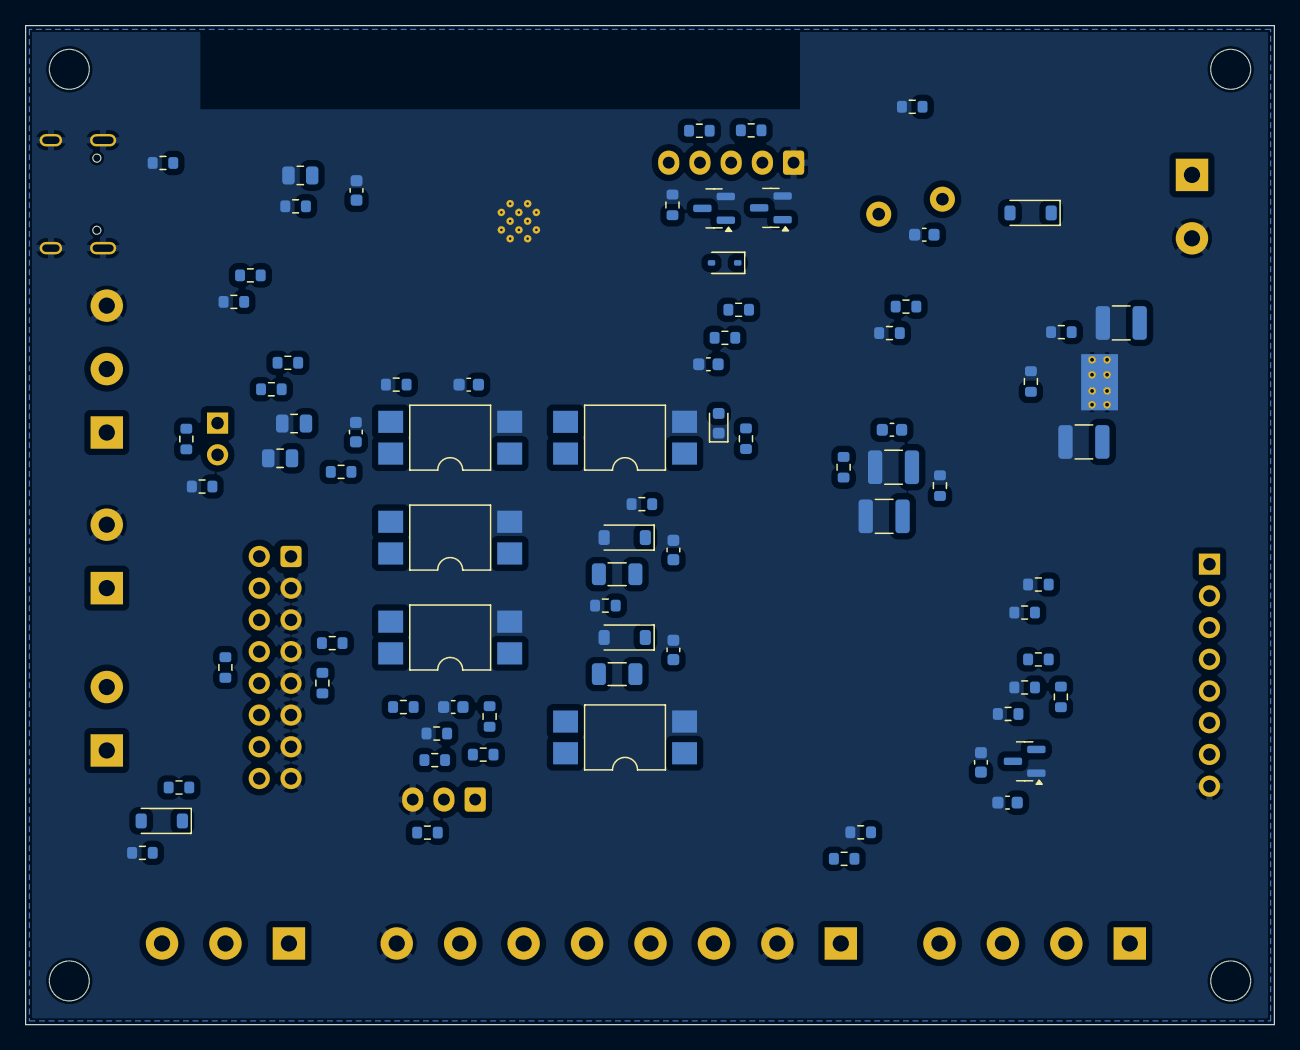
[picture p165: board lane_controller.kicad_pcb from below]

Board: 2 copper layers, 100.0 x 80.0 mm, 149 parts (78 on the bottom side), 104 nets, no tracks yet.

Other parts of the board:
H1, H2, H3, H4: M3; MountingHole_3.2mm_M3
