kgchord/ParkFlow/(commit log)

2026-10-25 Add README, gitignore and Stage 1 concept document
2026-10-25 cad: parametric OpenSCAD models, renders, DXF and STL parts, materials and hand calculations
    [antenna_tilt_flat.dxf, antenna_yoke_flat.dxf, barrier_assembly.scad, barrier_base_plate.dxf, barrier_bearing_plate.dxf, barrier_front_panel.dxf, barrier_motor_plate.dxf, barrier_params.scad]
2026-10-25 cad: STEP interchange files with manifest, FreeCAD rebuild guide and status
    [a02yyuw_ultrasonic_envelope.step, ai_hat_envelope.step, antenna_bracket_assy.step, antenna_tilt_plate.step, antenna_yoke.step, barrier_assembly.step, barrier_back_panel.step, barrier_base_plate.step]
2026-10-25 cad: CalculiX/gmsh FEA decks, logs, convergence study and figures
    [antenna_bracket_assy.step, antenna_tilt_plate.step, antenna_yoke.step, barrier_boom_tube.step, barrier_carrier_plate.step, barrier_hub.step, barrier_rotor_assy.step, barrier_shear_pin.step]
2026-10-25 electronics: system design spec, pin map, KiCad schematic and placement-only PCB, ERC/DRC reports, diagrams
    [lane_controller.kicad_pcb, lane_controller.kicad_sch]
2026-10-25 bom: priced bill of materials with vendor sources and notes
    [ParkFlow_BOM.xlsx]
